lagzgabrielmuller-dot/planta-secadora-guano/informe/figuras/P10_C_crespo.jpg

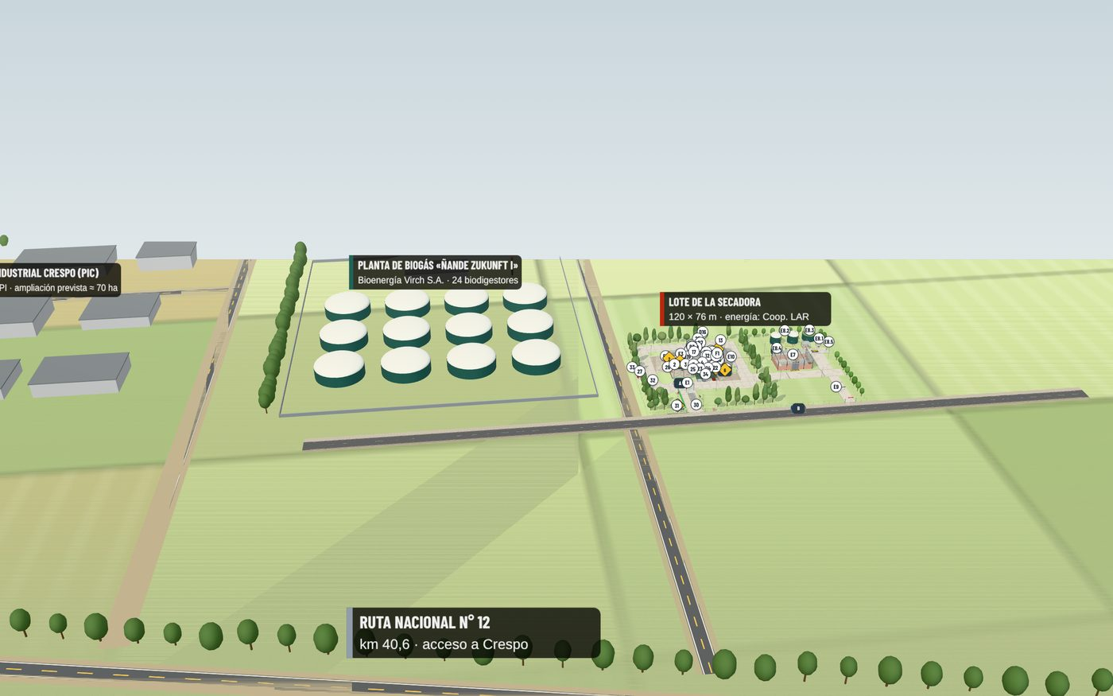
informe/figuras/P10_C_crespo.jpg
