lagzgabrielmuller-dot/planta-secadora-guano/informe/figuras/montaje_paso_09.jpg

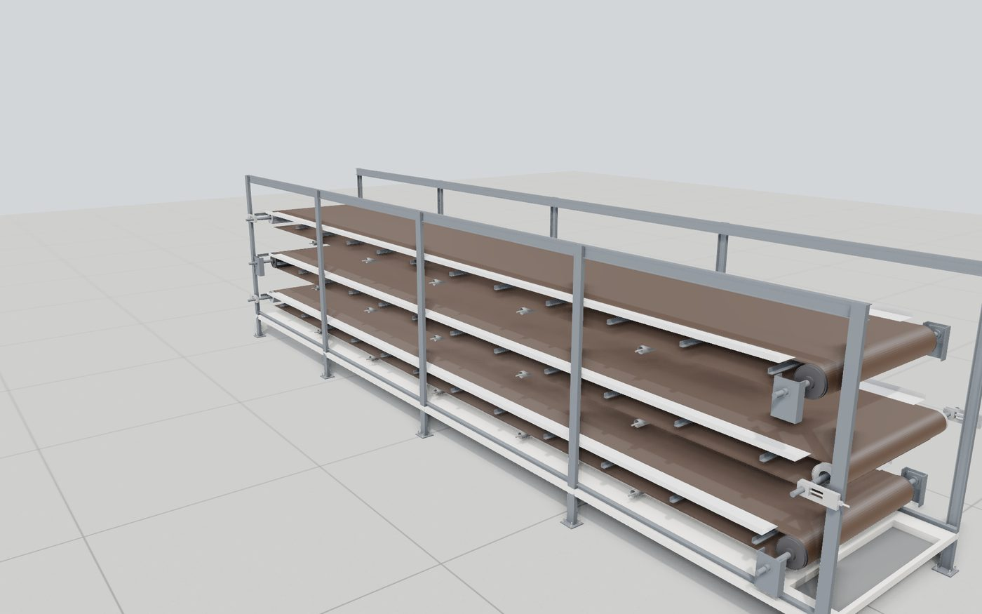
informe/figuras/montaje_paso_09.jpg
