lagzgabrielmuller-dot/planta-secadora-guano/fuente/video/README.md

# Video de presentación de la secadora de guano

Video de 3:51 sincronizado con la música: vuelo sobre el mapa satelital desde Paraná hasta el lote en Crespo,
la planta que se arma sola (piso, estructura, el secador que se arma en el aire y baja a su lugar, equipos,
paredes, techo, ampliaciones y vehículos), despiece del secador SC-4, recorrido del proceso en 8 pasos,
seguridad, ampliación del Sector Este, cifras de ingeniería, atardecer, noche y créditos.

Todo se genera con estos programas; la escena es una página three.js que se dibuja cuadro por cuadro en
Chrome sin ventana (el tiempo no corre solo: cada cuadro llama a `window.__cuadro(t)`).

## Pasos (desde `revD_final/fuente/`)

```
# 1. Datos (una vez; se guardan en video/datos/, que no se sube al repositorio)
node capturar_geometria.js ../visor.html video/_tmp/geo.json      # piezas del visor con sus colores
python video/preparar_planta.py video/_tmp/geo.json               # -> datos/planta.bin, planta_col.bin, planta.json
python video/mapa.py                                              # imágenes satelitales en 5 niveles + OpenStreetMap
python video/ritmo.py video/_musica.mp3                           # pulsos y compases -> datos/ritmo.json
node video/trafico.js                                             # recorridos de camiones y pala del visor -> datos/trafico.json

# 2. Escena
node video/escena/build.mjs                                       # -> video/escena.html (copia también el GLB del secador)
node video/muestras.js /tmp/muestras 30 60 100 150                # capturas sueltas para revisar encuadres

# 3. Cuadros y video
node video/capturar.js ../video/_cuadros/previa 0 "" 10 960 540 82        # vista previa (≈ 20 min)
python video/montar.py ../video/_cuadros/previa 10 ../video/previa.mp4 --crf 26
# final 1080p60: dos procesos intercalados (cuadros k, k+4, k+8...), primero los pares y después los impares
node video/capturar.js ../video/_cuadros/final 0 "" 60 1920 1080 92 4 & node video/capturar.js ../video/_cuadros/final 0.033 "" 60 1920 1080 92 4
node video/capturar.js ../video/_cuadros/final 0.016 "" 60 1920 1080 92 4 & node video/capturar.js ../video/_cuadros/final 0.0499 "" 60 1920 1080 92 4
# GitHub acepta archivos de hasta 100 MB: 1080p60 a 3000 kbit/s en dos pasadas (≈ 93 MB)
python video/montar.py ../video/_cuadros/final 60 ../video/Secadora_guano_presentacion_1080p60.mp4 --kbps 3000 --pasadas 2
python video/montar.py ../video/_cuadros/final 60 ../video/Secadora_guano_presentacion_720p.mp4 --cada 2 --ancho 1280 --kbps 1600
# versión liviana para la portada (archivos de hasta 15 MB)
python video/montar.py ../video/_cuadros/final 60 ../video/Secadora_guano_presentacion_web.mp4 --cada 2 --ancho 960 --kbps 380 --pasadas 2 --sin-audio
# las versiones del repositorio público van con --sin-audio: la música no es libre de derechos
```

`capturar.js` numera los cuadros por su tiempo y saltea los que ya existen: se puede cortar y retomar, o
correr varias tandas en paralelo con distintos tramos (`desde` y `hasta` en segundos) o intercaladas con `cada_n`.
Sin placa de video (SwiftShader, 4 núcleos) el 1080p60 lleva unas 5 a 6 horas: la parte del mapa sale a ≈ 0,5 s por
cuadro y la planta a ≈ 2,5 s. `montar.py --cada 2` arma una versión a 30 fps con los mismos cuadros.

**Con la placa de video de la PC** (RTX): `set VIDEO_GPU=1` antes de `node capturar.js` usa ANGLE con Direct3D
en lugar de SwiftShader (dibujo por procesador) y el render final baja de horas a minutos.

## Rehacer solo algunos tramos (corrección de un texto)

Si cambia un texto del guion (por ejemplo, los créditos o una cifra), no hace falta volver a dibujar los 13.880
cuadros. Se toma el video original de máxima calidad y se extraen sus cuadros (`ffmpeg -i alta.mp4 -q:v 2
f_%06d.jpg`). Después se dibujan de nuevo solo los cuadros de los tramos cambiados, con `capturar.js <carpeta>
<desde> <hasta> 60 1920 1080 92`, usando el mismo visor, el mismo GLB del secador, el mismo mapa y el mismo ritmo que
el original. Cada tramo tiene que cubrir todo el intervalo `[t0, t1]` del texto en `guion.js`: `ventana()` hace el
fundido de salida antes de `t1`, así que el texto se ve hasta `t1` (los créditos van de `B(76)` a `B(80, 2)`, cuadros
12.586 a 13.328; el cuadro `n` es el instante `n/60` y se guarda como `f_{n+1}.jpg`). Por último se reemplazan esos
cuadros y se monta con `montar.py`. Antes de reemplazar, conviene comparar
un cuadro nuevo con el original en el mismo instante: el 11/11/2026 dieron 36,8 dB de PSNR, que es solo la diferencia
de compresión. Así se corrigieron, el 11/11/2026, el apellido Hofstetter en los créditos, la masa del secador
(9.538 kg), la potencia instalada (117,0 kW) y la nave (33 × 18 m).

## Archivos

| Archivo | Qué hace |
|---|---|
| `escena/motor.js` | Renderizador, cielo y luces (día, atardecer, noche), mapa en niveles, planta por bloques, secador detallado, carteles con línea guía (sin superponerse), trazos del mapa, cámara por claves |
| `escena/guion.js` | El guion: tiempos por compás `B(n, pulso)`, cámara, armado de la obra, armado y despiece del secador, vehículos, textos y cifras |
| `trafico.js` | Graba del visor los recorridos de los camiones y la pala (posición y giro cada 0,1 s): el video los reproduce tal cual, así el camión entra de culata por el portón P1 y la pala va de la pila a la tolva sin atravesar equipos |
| `escena/plantilla.html` | Capa de textos (títulos, placas, carteles, cifras, créditos) en 1920 × 1080 |
| `mapa.py` | Teselas de Esri World Imagery y datos de OpenStreetMap (RN 12, Parque Industrial, calles) |
| `preparar_planta.py` | Divide la planta en bloques por pieza y color (y la nave en piso, estructura, paredes y techo) |
| `ritmo.py` | Pulsos (87,4 por minuto), compases y energía por compás de la música |

## Datos y cuidados

- **Ubicación del lote: orientativa** (plano 14): campo al Noreste de la RN 12, frente al Parque Industrial,
  junto a la continuación de la calle Democracia. La planta de biogás vecina está proyectada y su lugar no está
  definido. El video lo aclara en pantalla.
- Distancias calculadas desde el centro del lote: 204 m a la RN 12, 2,6 km al centro de Crespo y 36,6 km en línea
  recta a Paraná.
- Cifras en pantalla tomadas de los cálculos (`calculos/resultados.json`) y del portal: 8 t/día al 72 % → 2,6 t/día
  al 15 %, generador de 880 kW (314 kg/h de cáscara), potencia instalada 66,9 + 50,1 kW, eje motriz n = 1,59,
  40 anclajes M16. No se muestran datos pendientes de confirmar (inversión, potencia a contratar).
- Créditos de imágenes en pantalla: Esri, Maxar, Earthstar Geographics y colaboradores de OpenStreetMap.
- **Música:** «Addiction» (LONOWN y Asenssia, versión slowed), la eligió el grupo. No es libre de derechos: sirve
  para proyectarlo en la escuela; si se sube a YouTube u otra red puede quedar silenciado o reclamado. No se guarda
  en el repositorio.
