lagzgabrielmuller-dot/planta-secadora-guano/docs/ARQUITECTURA.md

# Arquitectura del proyecto

El repositorio no es una aplicación con servidor. Es una **entrega técnica generada por programas**: todo lo que se ve
(planos, informe, memoria, presupuesto, modelos 3D, visores, portada y video) sale de programas en `fuente/`. Los
datos se escriben **una sola vez**, en los cálculos.

## Flujo de datos

```mermaid
flowchart LR
    subgraph Calculos["fuente/calculos"]
        CM["calculos_memoria.py<br/>TG2, iluminación, ventilación,<br/>biogás, fuego"] --> RJ[("resultados.json")]
        FA["fatiga.py<br/>Shigley-Budynas"] --> RJ
        PR["presupuesto.py"] --> PJ[("presupuesto.json")]
        RJ --> PR
    end
    subgraph Modelo["fuente/secadora"]
        MS["modelo_secador.py<br/>CadQuery"] --> GLB[("STEP · GLB · piezas.json")]
    end
    GLB --> FA
    SIM["simulacion_termica/<br/>modelo físico del secado"] -. "Rev. F: punto de trabajo,<br/>capacidad, cáscara" .-> CM
    SIM -.-> PR
    RJ --> PL["planos/P01…P24.py"] --> PLA[("DXF · PDF · PNG")]
    GLB --> SC["planos_sc.py"] --> SCA[("SC-01…SC-06")]
    RJ --> MEM["memoria_docx.py"] --> MEMA[("Memoria .docx/.pdf")]
    RJ --> INF["informe_final.py<br/>+ texto_revC.md"] --> INFA[("Informe y manual<br/>.docx/.pdf")]
    PJ --> INF
    GLB --> VS["secadora/visor"] --> VSA[("Visor_Secador_SC4.html")]
    BV["visor/build_visor.py<br/>base_revC.html + revD_modulo.js"] --> VP[("visor.html")]
    RJ --> POR["portal/portada.py"] --> IDX[("index.html")]
    PJ --> POR
    GLB --> POR
```

## Componentes

| Componente | Tecnología | Entrada | Salida |
|---|---|---|---|
| Cálculos | Python, solo la biblioteca estándar | constantes con su fuente, dentro del código | `resultados.json`, `presupuesto.json`, planilla Excel (openpyxl) |
| Láminas P01-P24 | ezdxf → DXF; render a PDF A3 y PNG con PyMuPDF | `resultados.json`, `datos/layout_planta.json` | `planos/dxf`, `planos/pdf`, `planos/*.png` |
| Secador SC-4 | CadQuery (OpenCASCADE, sólidos exactos) | medidas como parámetros con nombre | STEP, GLB, `piezas.json` (68 piezas con masa y despiece) |
| Láminas SC-01 a SC-06 | ezdxf, con proyecciones con líneas ocultas (OCP) | modelo CadQuery | DXF, PDF, PNG |
| Informe, memoria y manual | python-docx; el PDF se imprime con Chrome desde un HTML equivalente | `texto_revC.md` y los JSON | `.docx` y `.pdf` |
| Visor de la planta | three.js r163 compilado (Rev. C) + módulo `revD_modulo.js` inyectado | geometría paramétrica | `visor.html`, un solo archivo que anda sin internet |
| Visor del secador | three.js r170 (ESM) empaquetado con esbuild | GLB y `pasos_montaje.json` | `secadora/Visor_Secador_SC4.html` |
| Estudio térmico | Python + numba (núcleo compilado), matplotlib; simulador en JavaScript | datos del informe y ensayos publicados | `resultados/*.json`, `figuras/*.png`, `simulador.html` |
| Portada | Python, plantilla HTML con claves `{{…}}` | los JSON, los tamaños de los archivos, los PNG de las láminas | `index.html`, `entrega.html` (redirección), miniaturas y ZIP de los DXF |
| Video | three.js cuadro por cuadro con Chrome sin ventana, ffmpeg | geometría del visor, mapa satelital, guion | MP4 (la versión pública va sin música) |

## Decisiones de diseño

- **Una sola fuente de verdad por dato.** Un número se cambia en el programa de cálculo y se regenera
  (`fuente/regenerar.py`). Las pruebas (`tests/`) fallan si algún documento quedó con un valor viejo.
- **Archivos autónomos.** Los visores y el simulador son un solo HTML que anda sin internet: es una entrega escolar
  que se tiene que poder abrir con doble clic en la compu de la escuela.
- **Sitio estático.** La publicación no necesita servidor ni base de datos ni variables de entorno: GitHub Pages
  sirve los mismos archivos del repositorio por HTTPS.
- **Rev. C intacta dentro del visor.** `base_revC.html` es el visor entregado en la Rev. C (código compilado). Los
  cambios posteriores se inyectan con `build_visor.py`, por reemplazos que fallan si el original cambia.

## Límites conocidos

- `base_revC.html` está compilado (minificado) y no hay fuente legible. Para cambiarlo se agregan reemplazos
  controlados en `build_visor.py`, o geometría nueva en `revD_modulo.js`.
- Los PDF de las láminas no tienen capa de texto: ezdxf dibuja el texto como trazos. El texto buscable está en los DXF.
- El render del video necesita datos que no se guardan en el repositorio: el mapa satelital (unos 100 MB de
  teselas) y la música, que no es libre de derechos. Los rehacen `fuente/video/mapa.py` y `ritmo.py`.
