lagzgabrielmuller-dot/planta-secadora-guano/fuente/informe/img_revC/revC_01.png

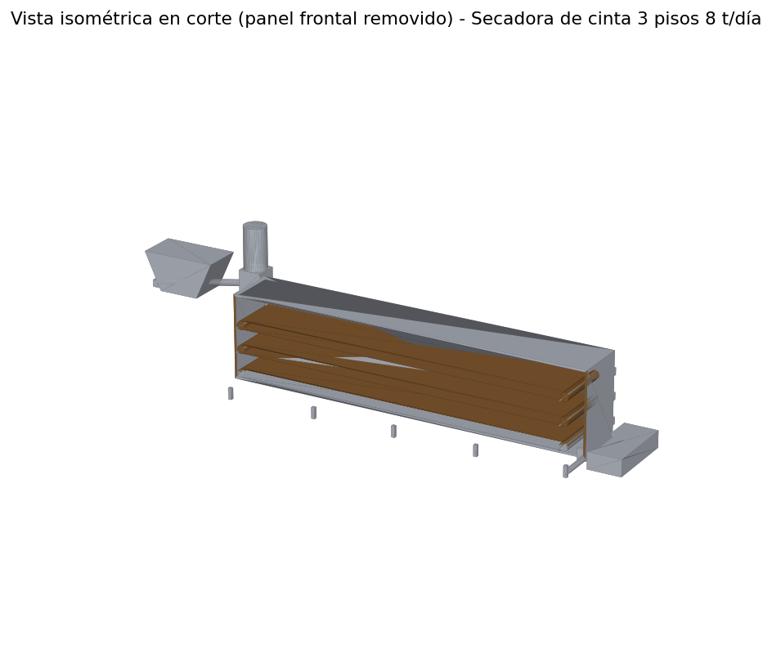
fuente/informe/img_revC/revC_01.png
