lagzgabrielmuller-dot/planta-secadora-guano/fuente/informe/img_revC/revC_05.png

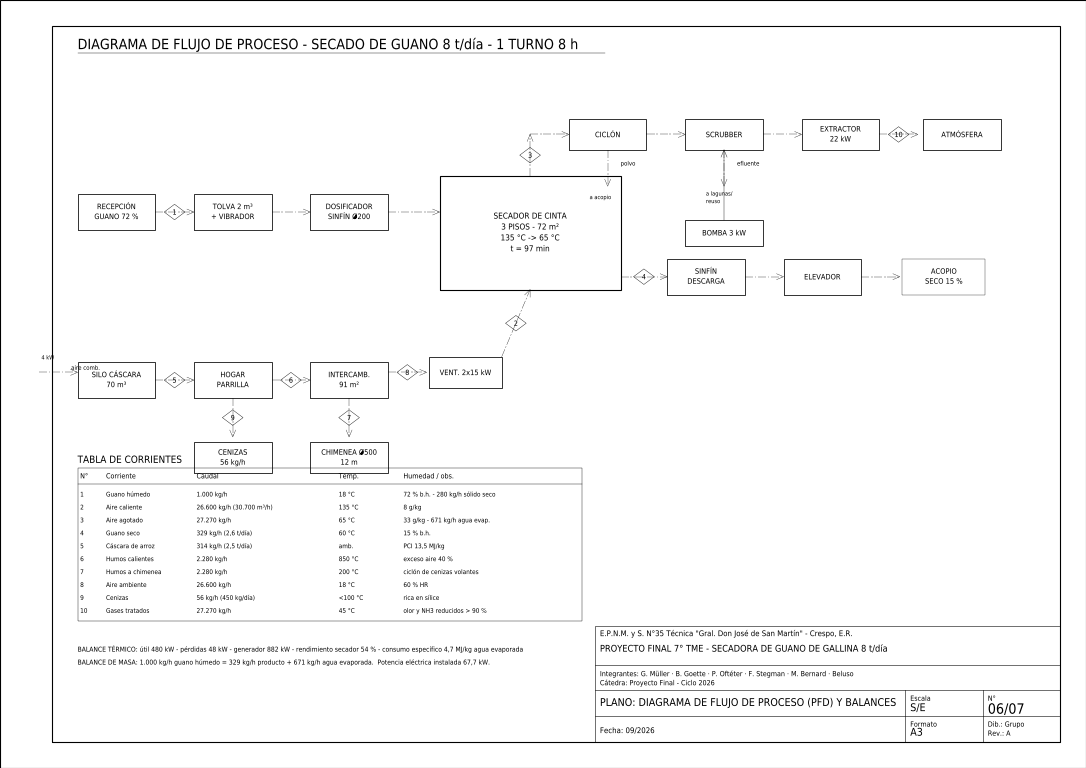
fuente/informe/img_revC/revC_05.png
