lagzgabrielmuller-dot/planta-secadora-guano/fuente/informe/img_revC/revC_06.png

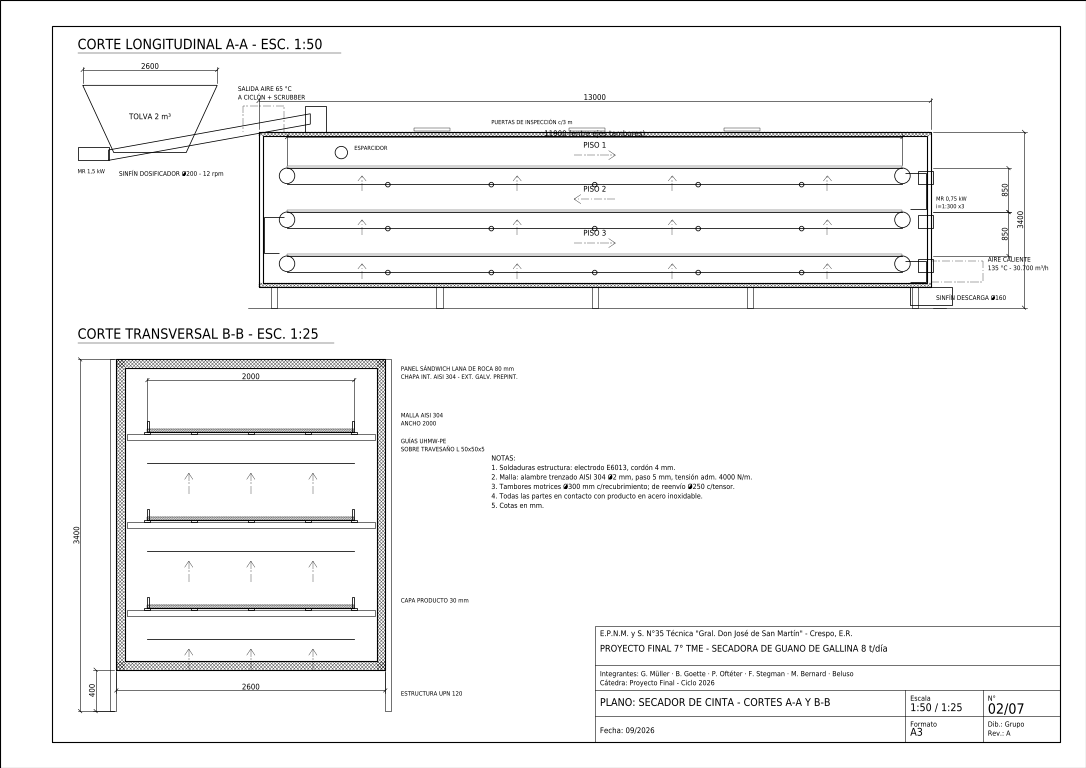
fuente/informe/img_revC/revC_06.png
