lagzgabrielmuller-dot/planta-secadora-guano/fuente/informe/img_revC/revC_08.png

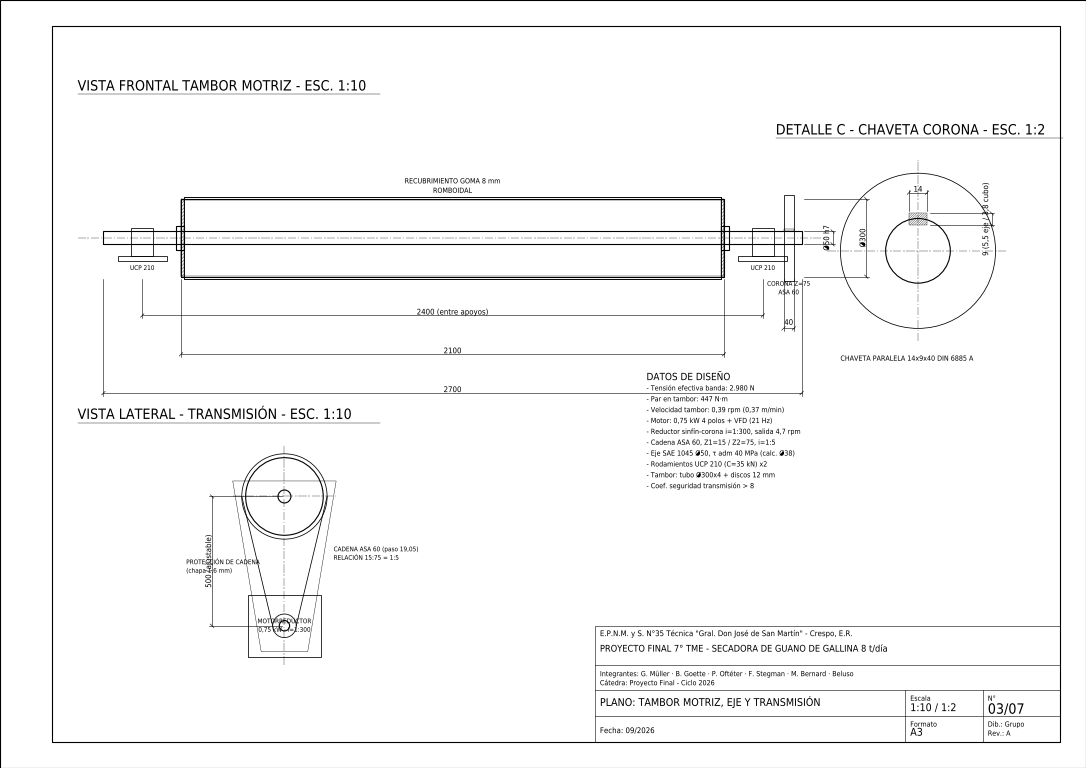
fuente/informe/img_revC/revC_08.png
