lagzgabrielmuller-dot/planta-secadora-guano/fuente/informe/img_revC/revC_10.png

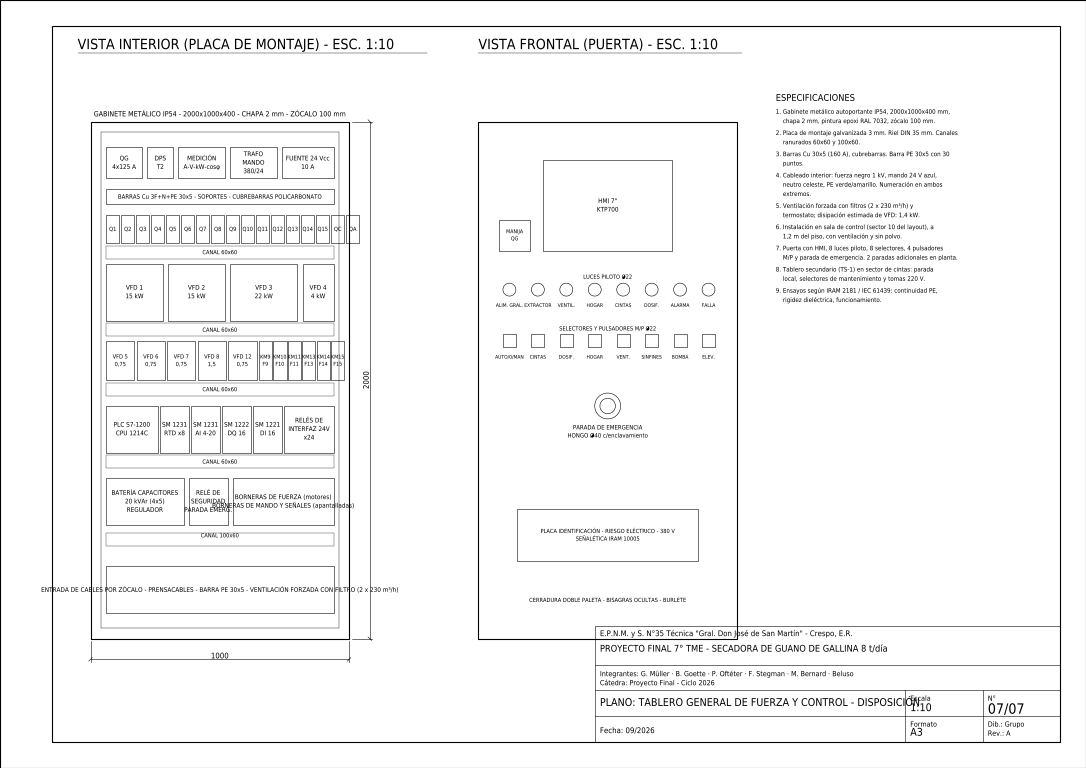
fuente/informe/img_revC/revC_10.png
