lagzgabrielmuller-dot/planta-secadora-guano/fuente/informe/img_revC/revC_11.png

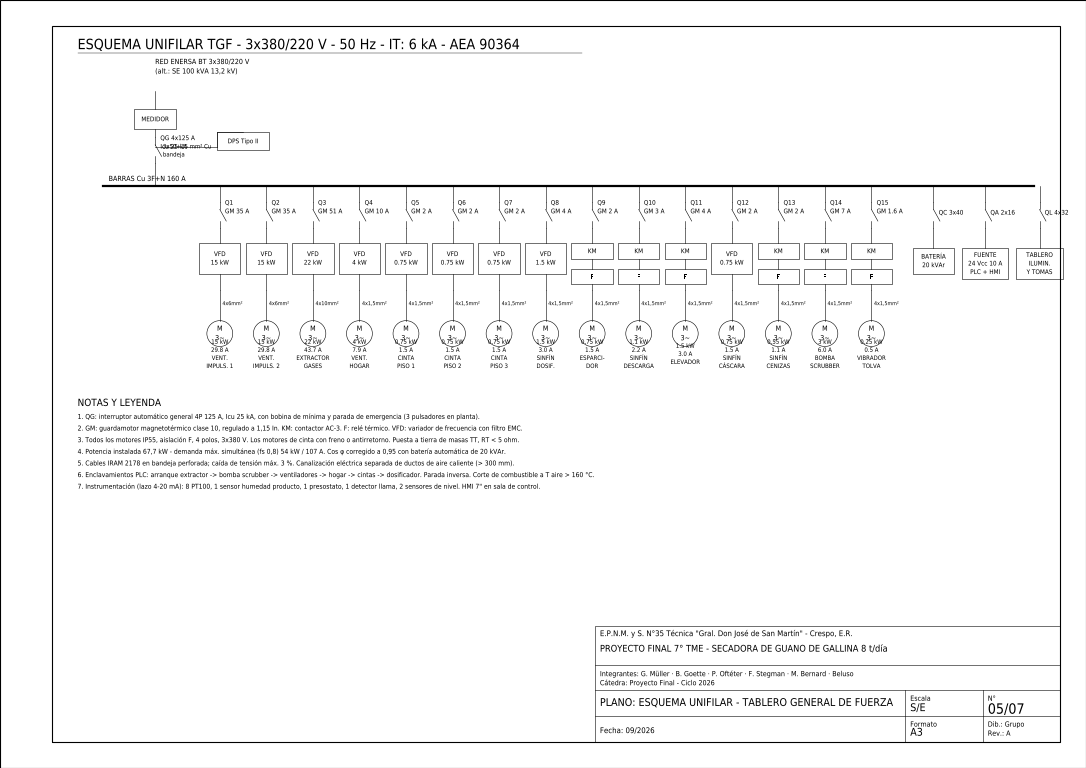
fuente/informe/img_revC/revC_11.png
