lagzgabrielmuller-dot/planta-secadora-guano/fuente/informe/img_revC/revC_12.png

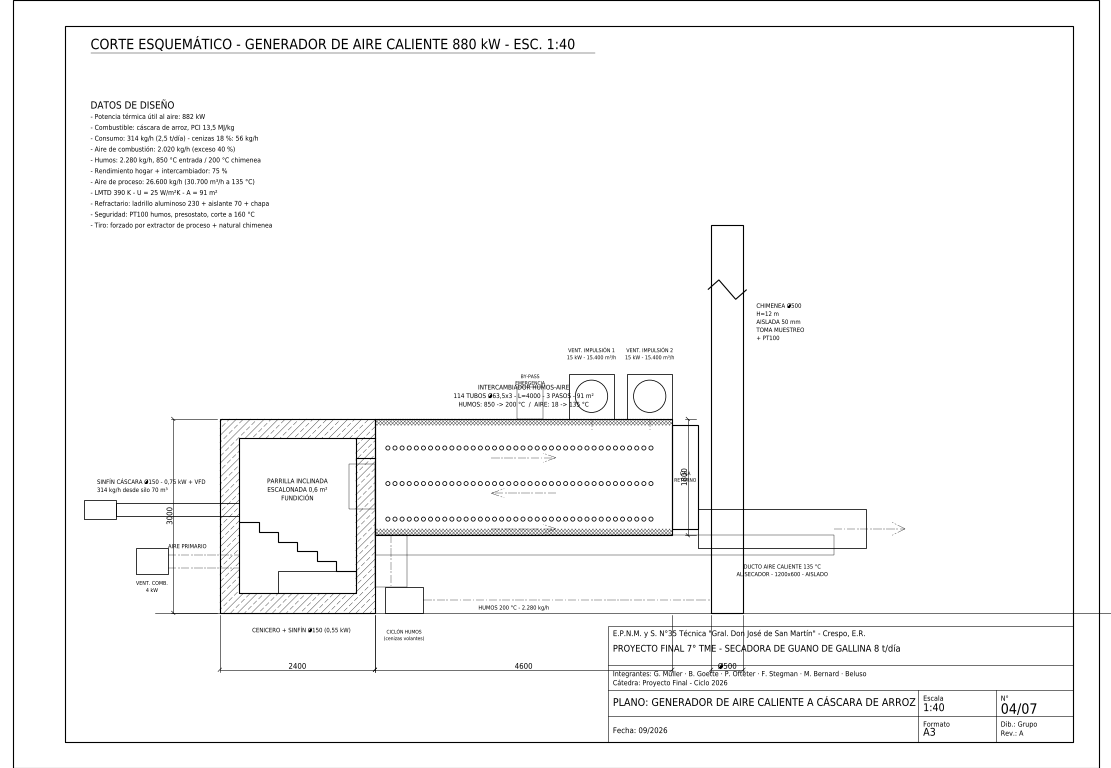
fuente/informe/img_revC/revC_12.png
