lagzgabrielmuller-dot/planta-secadora-guano/fuente/informe/img_revC/revC_13.png

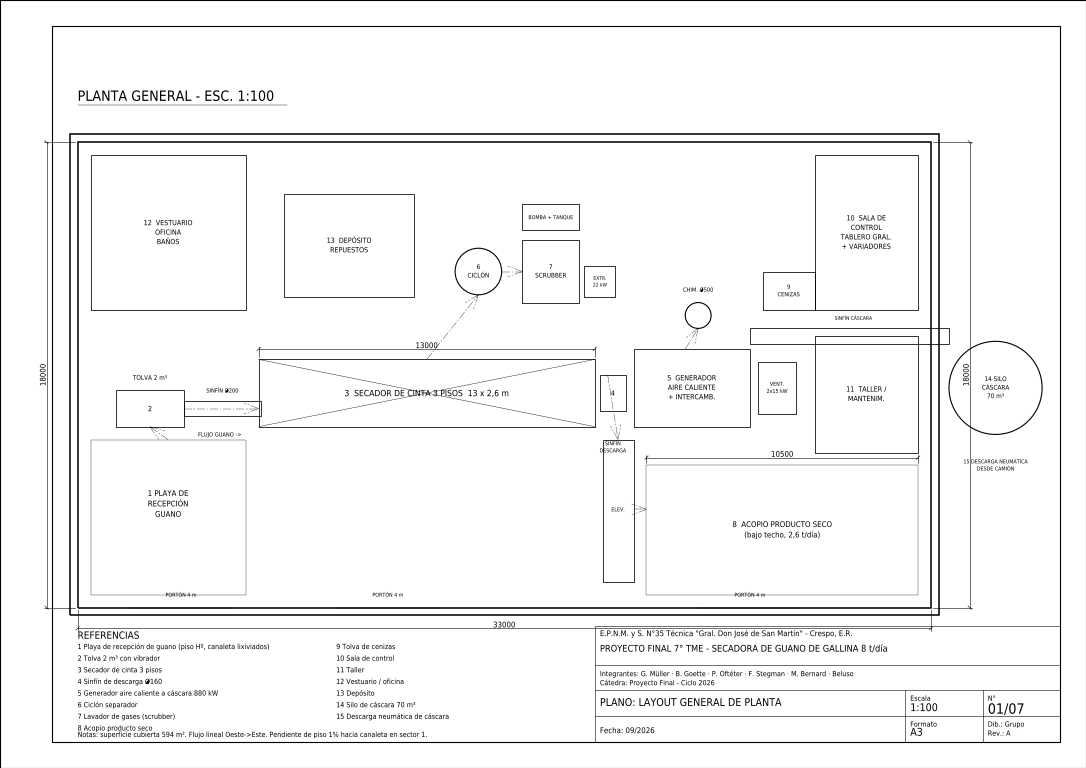
fuente/informe/img_revC/revC_13.png
