lagzgabrielmuller-dot/planta-secadora-guano/fuente/informe/img_revC/revC_14.png

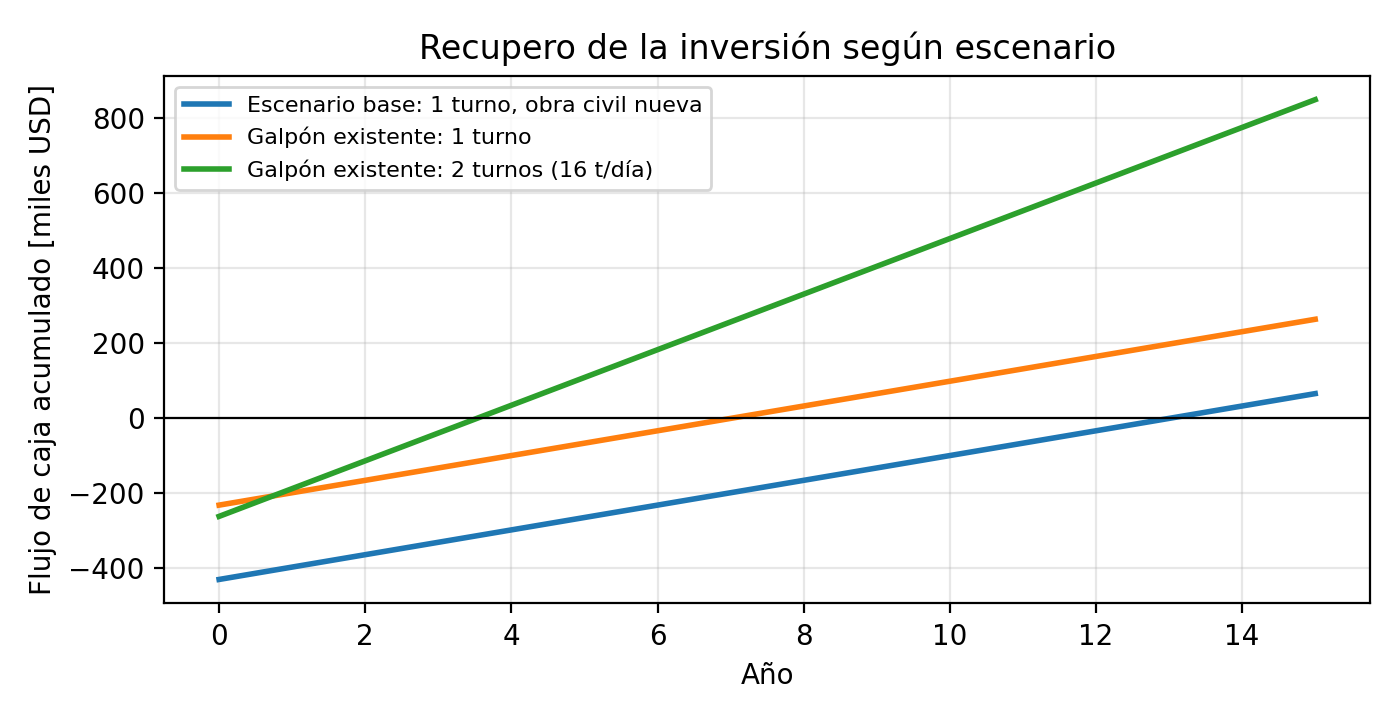
fuente/informe/img_revC/revC_14.png
