lagzgabrielmuller-dot/planta-secadora-guano/fuente/informe/img_revC/revC_15.png

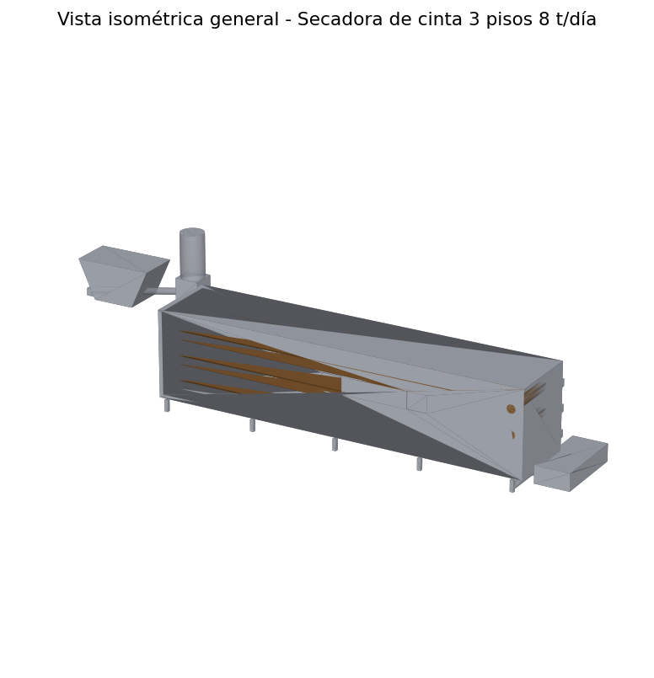
fuente/informe/img_revC/revC_15.png
