lagzgabrielmuller-dot/planta-secadora-guano/fuente/planos/img/P10_A_general_RevD.png

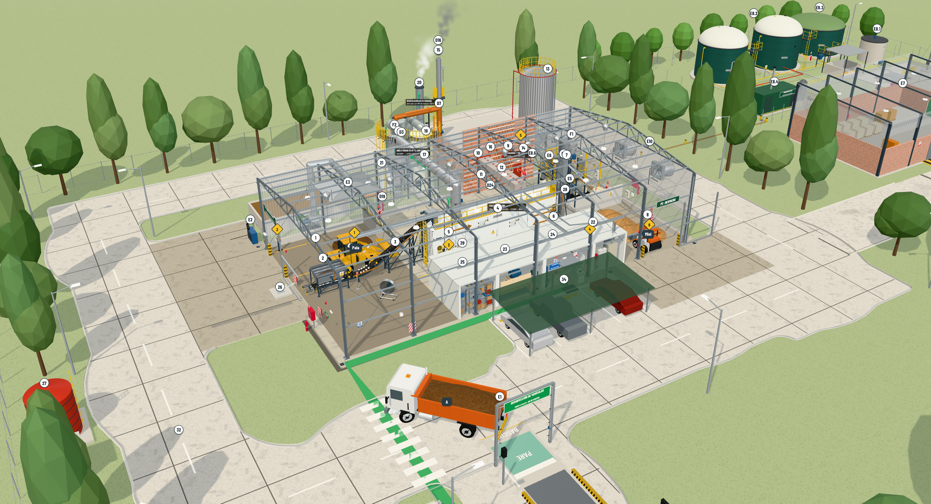
fuente/planos/img/P10_A_general_RevD.png
