lagzgabrielmuller-dot/planta-secadora-guano/fuente/planos/img/P10_B_despiece_RevD.png

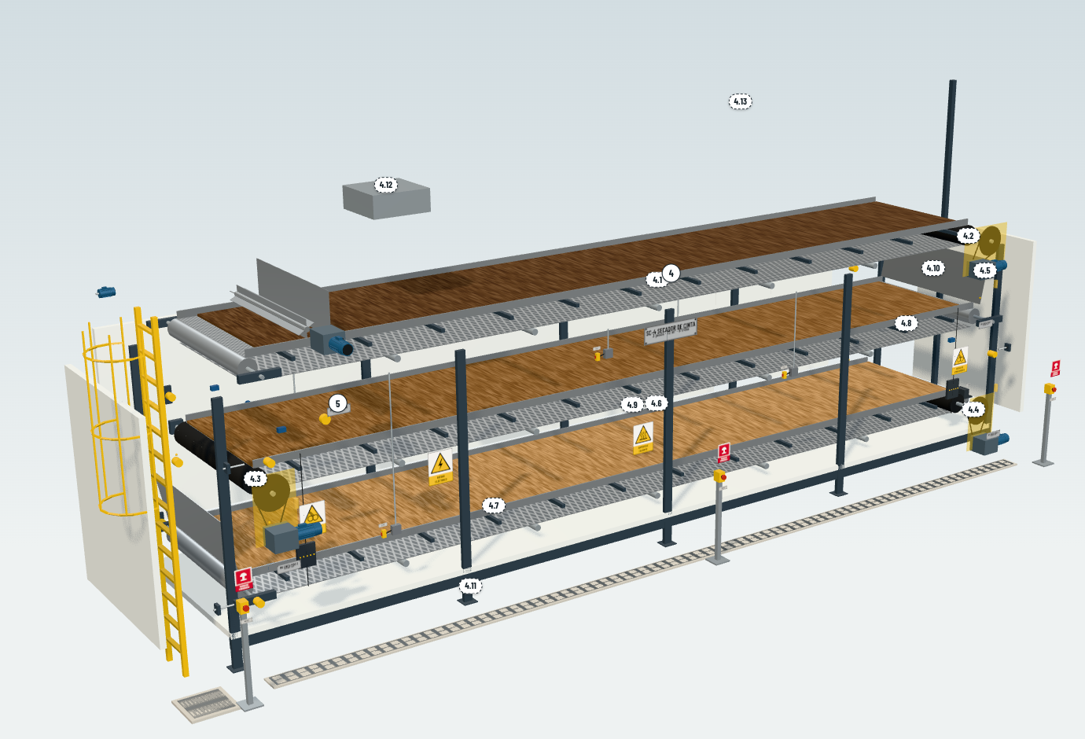
fuente/planos/img/P10_B_despiece_RevD.png
