lagzgabrielmuller-dot/planta-secadora-guano/modelo_3d/renders/P10_A_general.png

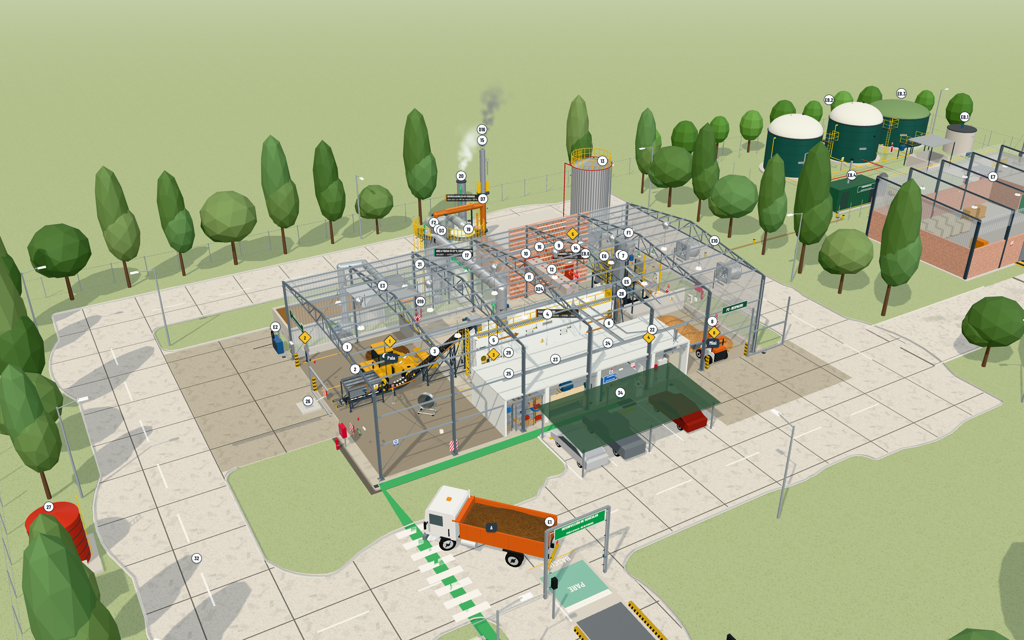
modelo_3d/renders/P10_A_general.png
