lagzgabrielmuller-dot/planta-secadora-guano/modelo_3d/renders/P10_B_despiece.png

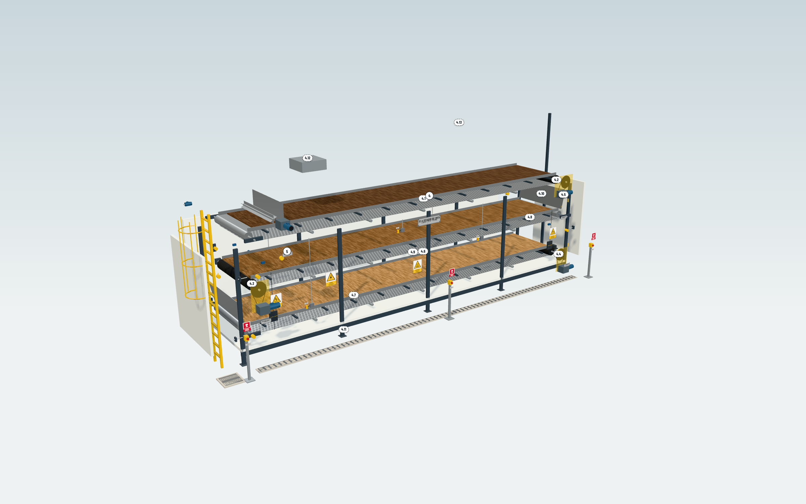
modelo_3d/renders/P10_B_despiece.png
