lagzgabrielmuller-dot/planta-secadora-guano/portal/img/planos/SC-05.jpg

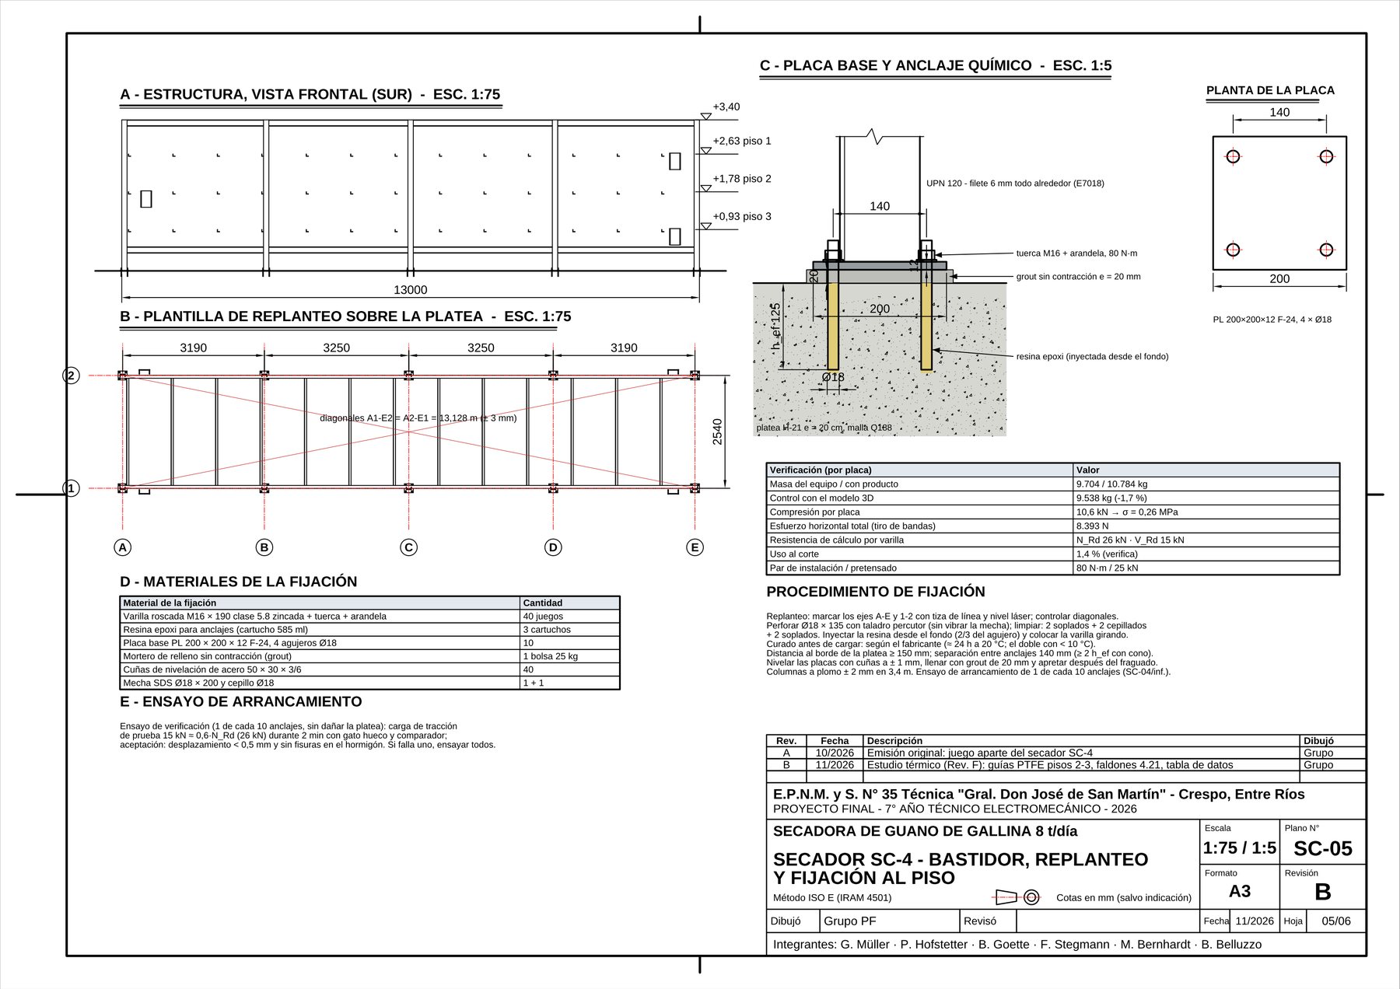
portal/img/planos/SC-05.jpg
