lagzgabrielmuller-dot/planta-secadora-guano/portal/img/planos/SC-06.jpg

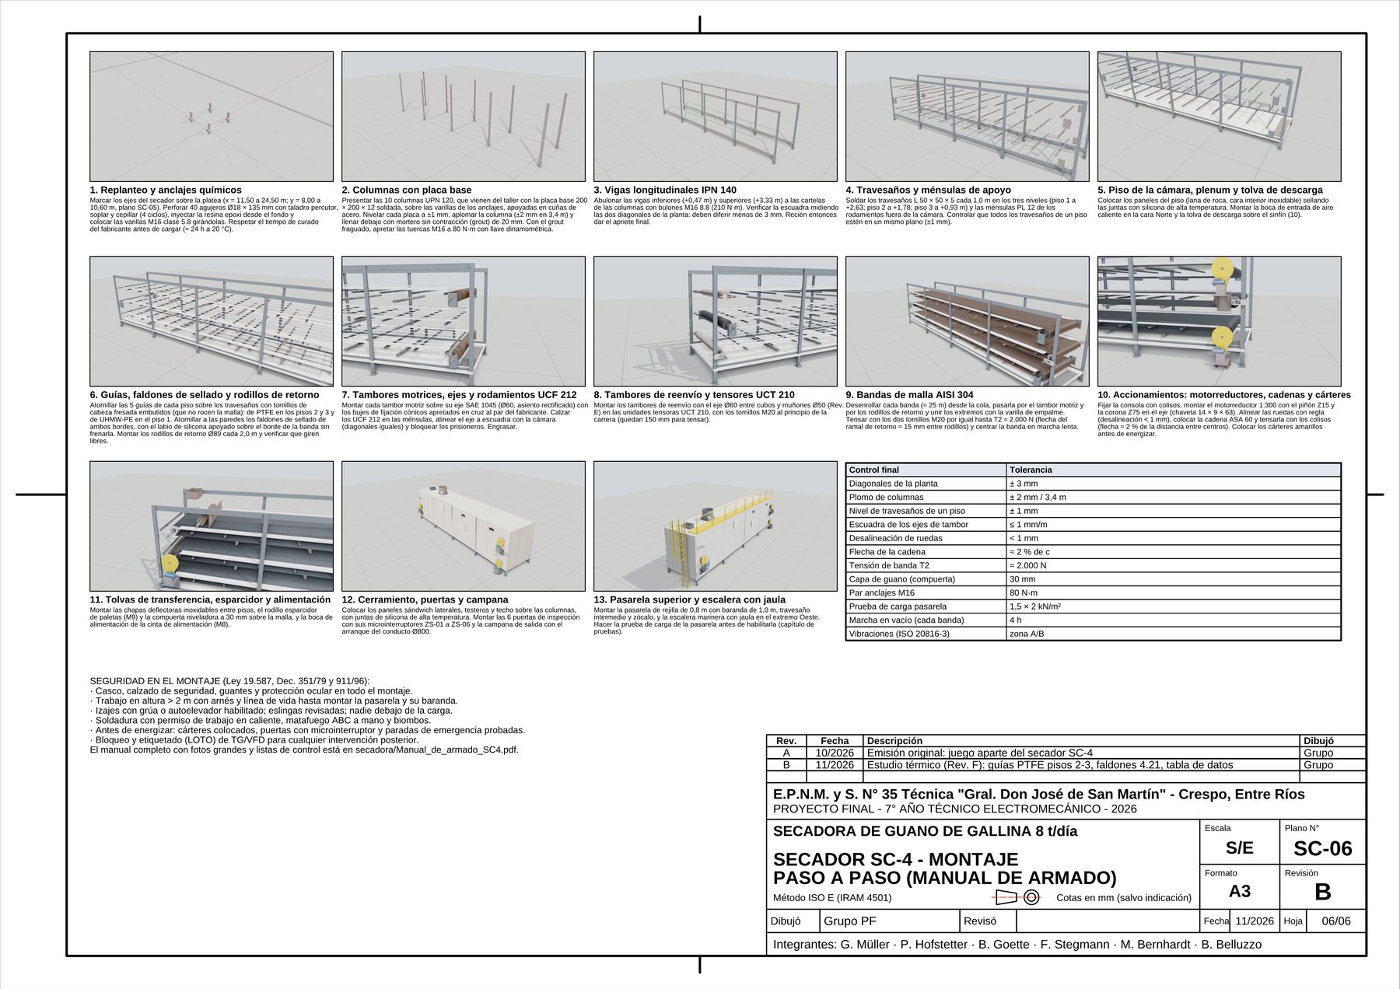
portal/img/planos/SC-06.jpg
