lagzgabrielmuller-dot/planta-secadora-guano/portal/img/portada_planta.jpg

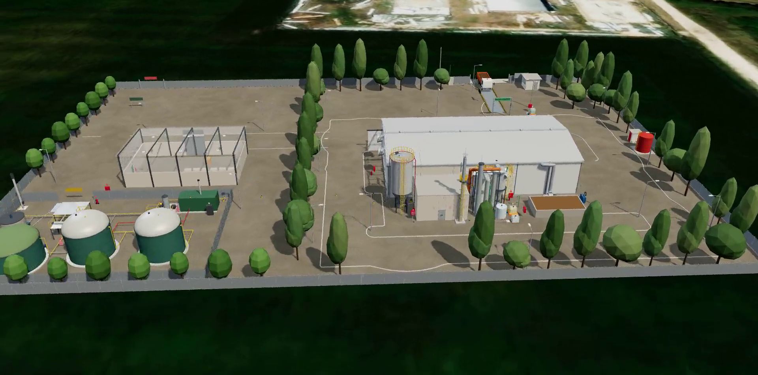
portal/img/portada_planta.jpg
