lagzgabrielmuller-dot/planta-secadora-guano/portal/img/portada_secador.jpg

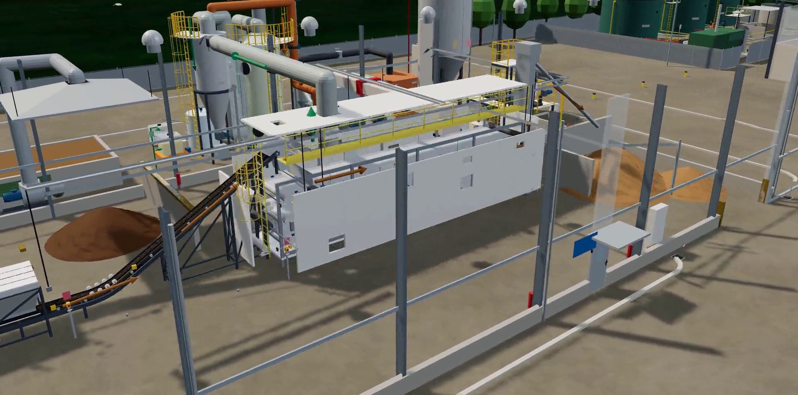
portal/img/portada_secador.jpg
