lagzgabrielmuller-dot/planta-secadora-guano/portal/img/video_aire.jpg

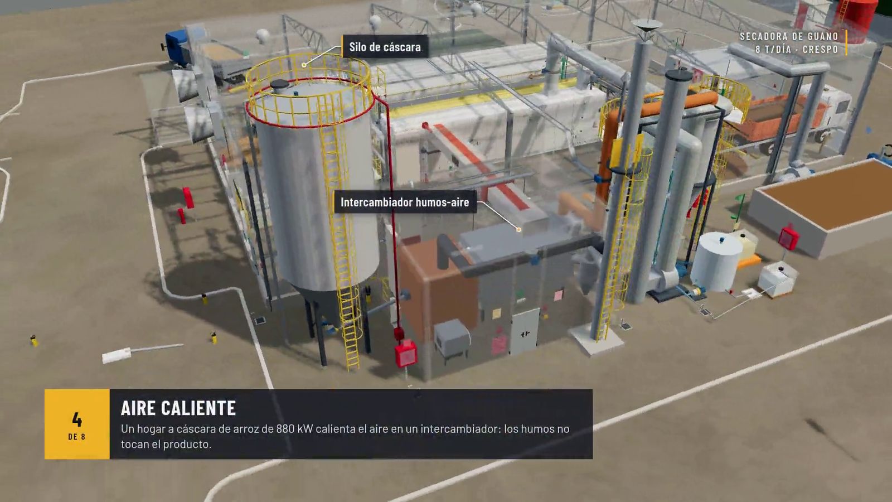
portal/img/video_aire.jpg
