lagzgabrielmuller-dot/planta-secadora-guano/portal/img/video_alimentacion.jpg

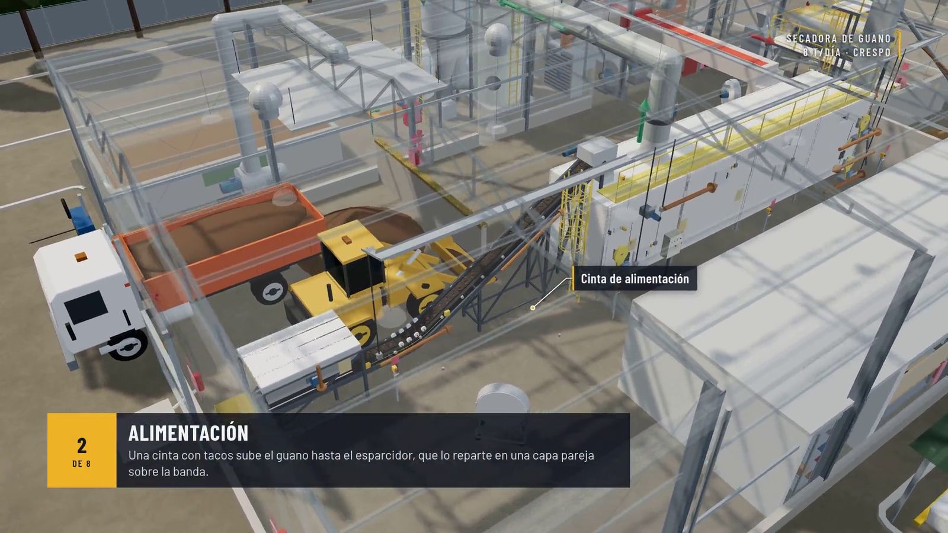
portal/img/video_alimentacion.jpg
