lagzgabrielmuller-dot/planta-secadora-guano/portal/img/video_control.jpg

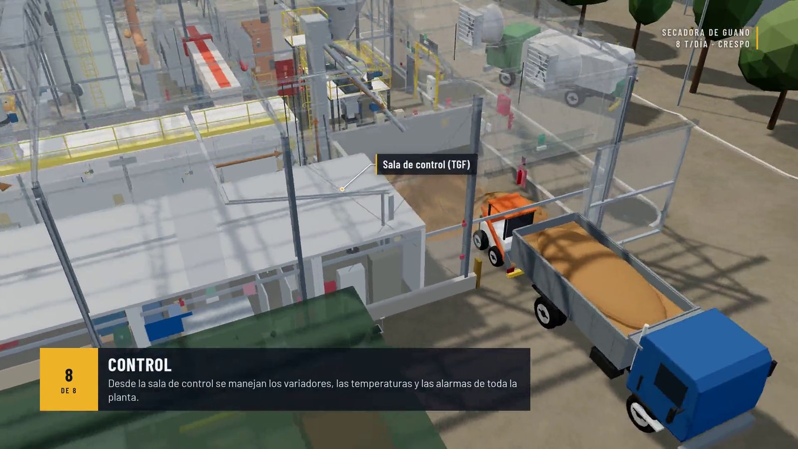
portal/img/video_control.jpg
