lagzgabrielmuller-dot/planta-secadora-guano/portal/img/video_descarga.jpg

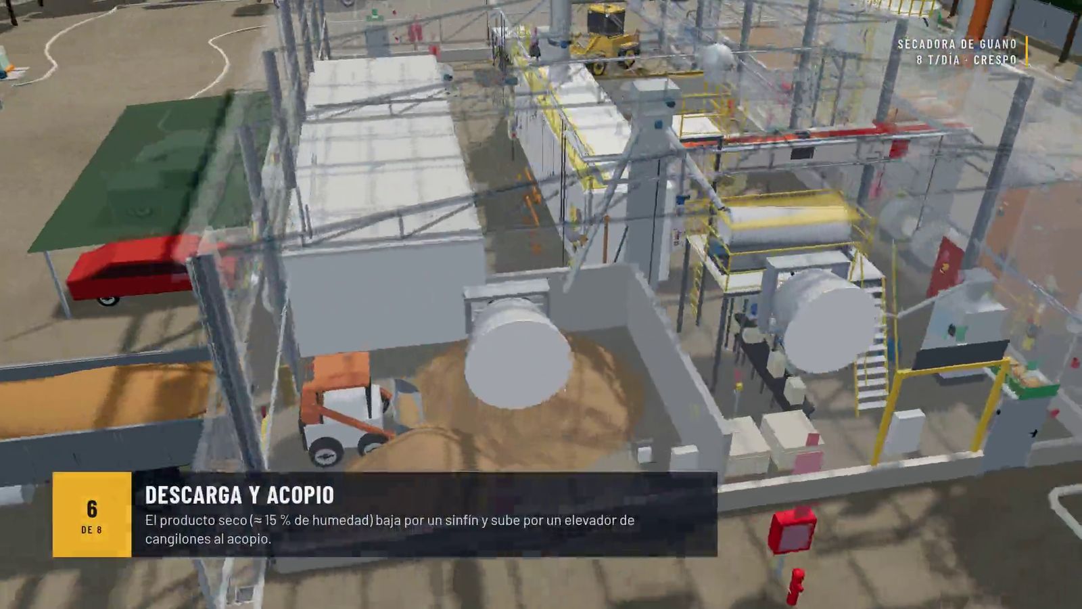
portal/img/video_descarga.jpg
