lagzgabrielmuller-dot/planta-secadora-guano/portal/img/video_embolsado.jpg

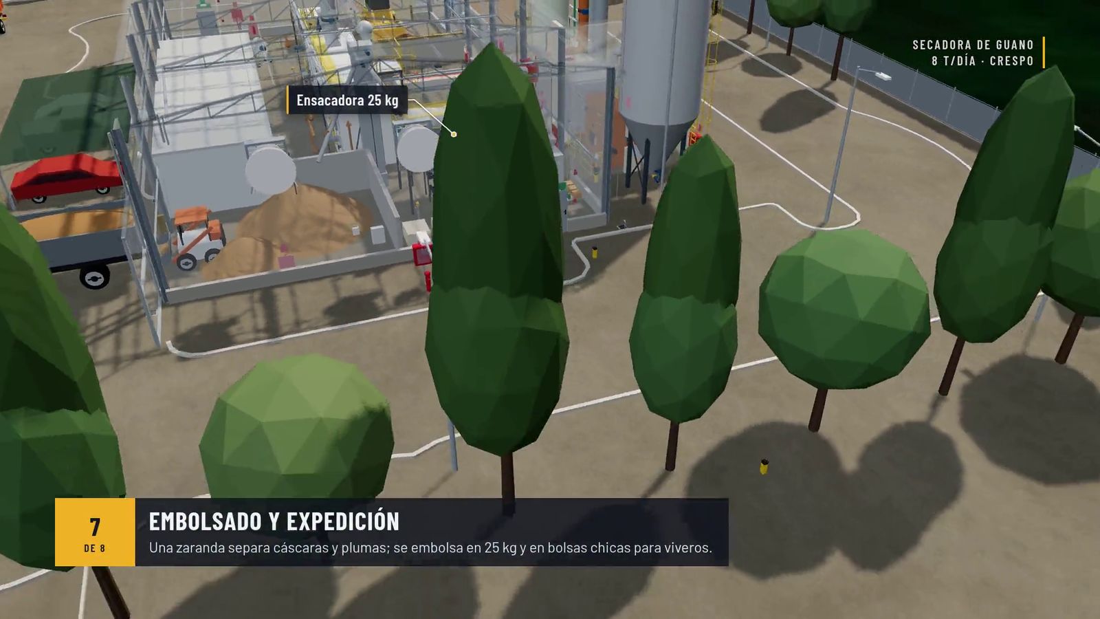
portal/img/video_embolsado.jpg
