lagzgabrielmuller-dot/planta-secadora-guano/portal/img/video_gases.jpg

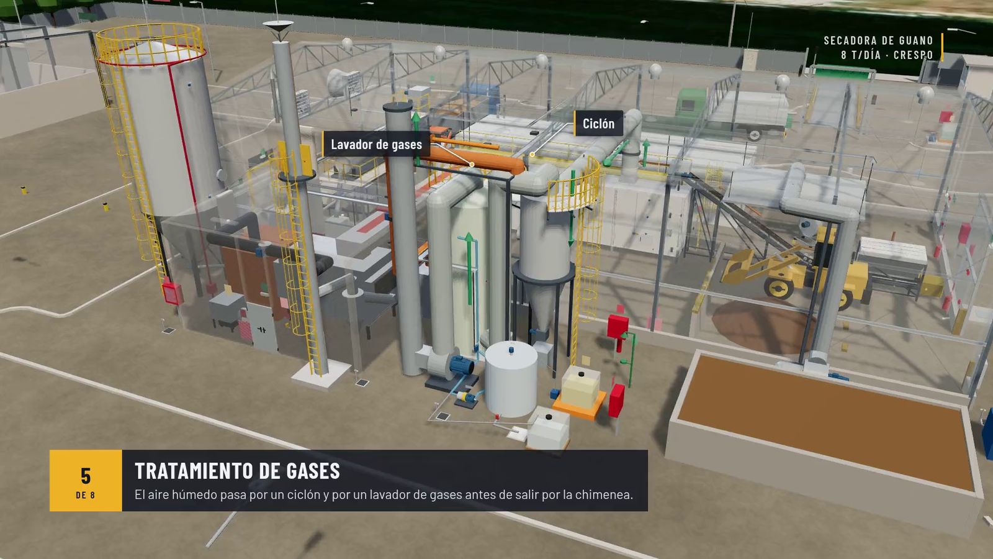
portal/img/video_gases.jpg
