lagzgabrielmuller-dot/planta-secadora-guano/portal/img/video_portada.jpg

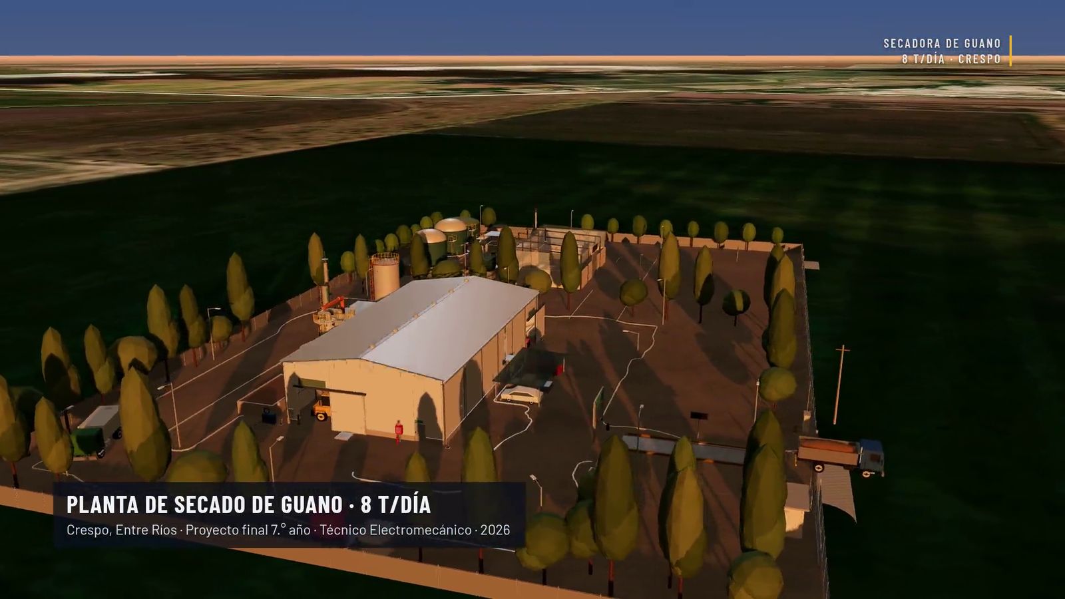
portal/img/video_portada.jpg
