lagzgabrielmuller-dot/planta-secadora-guano/portal/img/video_recepcion.jpg

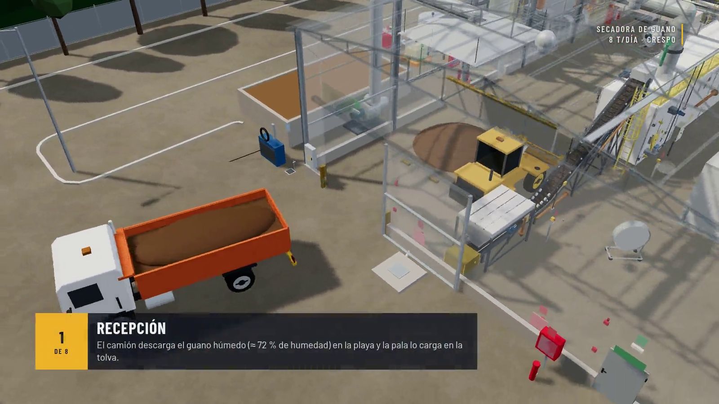
portal/img/video_recepcion.jpg
