lagzgabrielmuller-dot/planta-secadora-guano/portal/img/video_sector_este.jpg

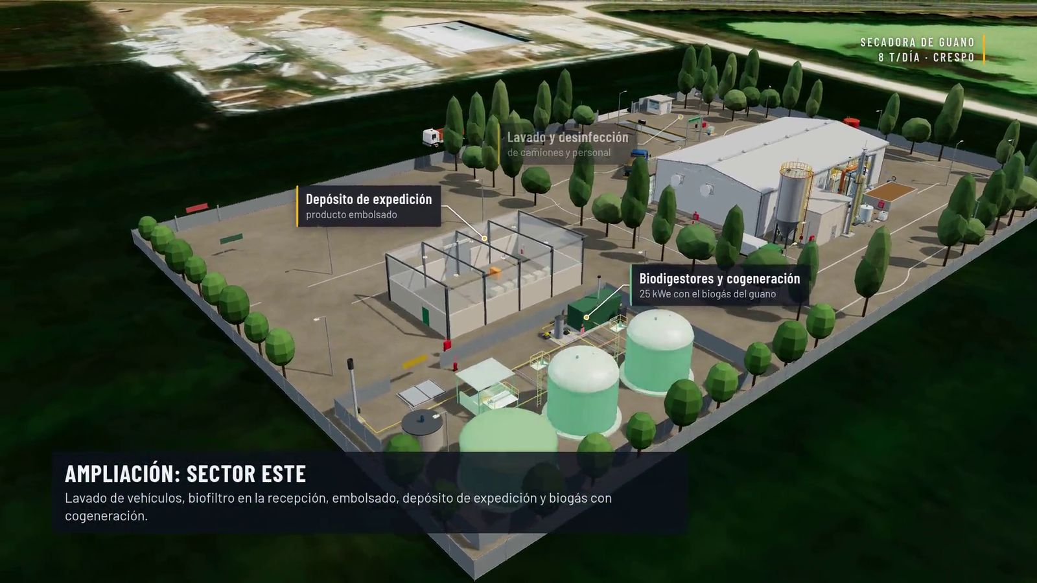
portal/img/video_sector_este.jpg
