lagzgabrielmuller-dot/planta-secadora-guano/portal/img/video_seguridad.jpg

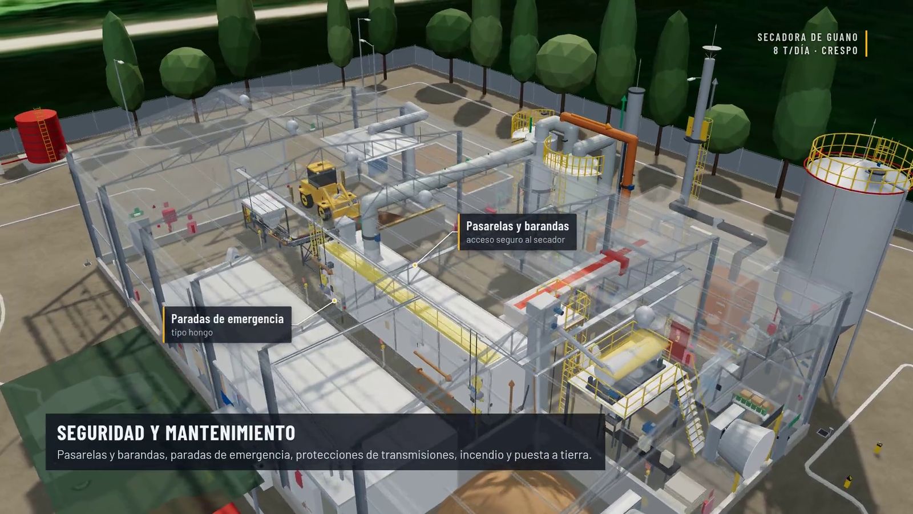
portal/img/video_seguridad.jpg
