lagzgabrielmuller-dot/planta-secadora-guano/portal/img/vista_aire.jpg

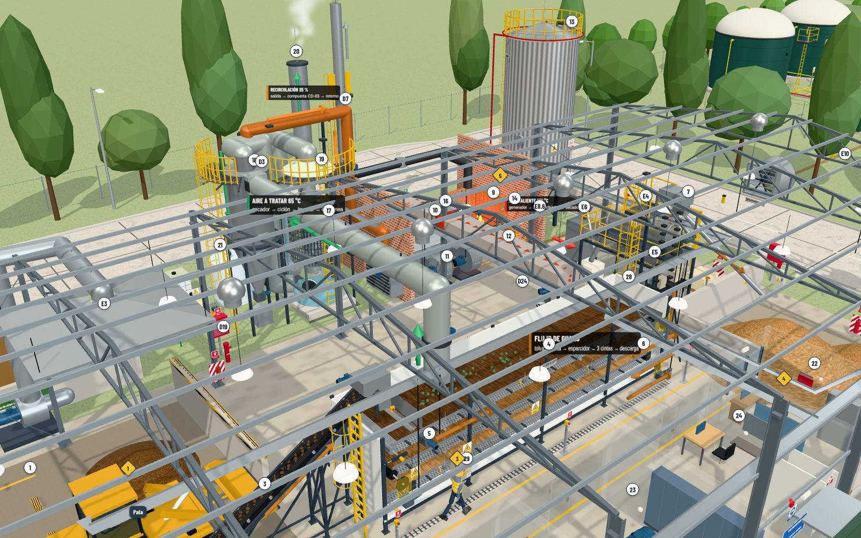
portal/img/vista_aire.jpg
