lagzgabrielmuller-dot/planta-secadora-guano/portal/img/vista_alimentacion.jpg

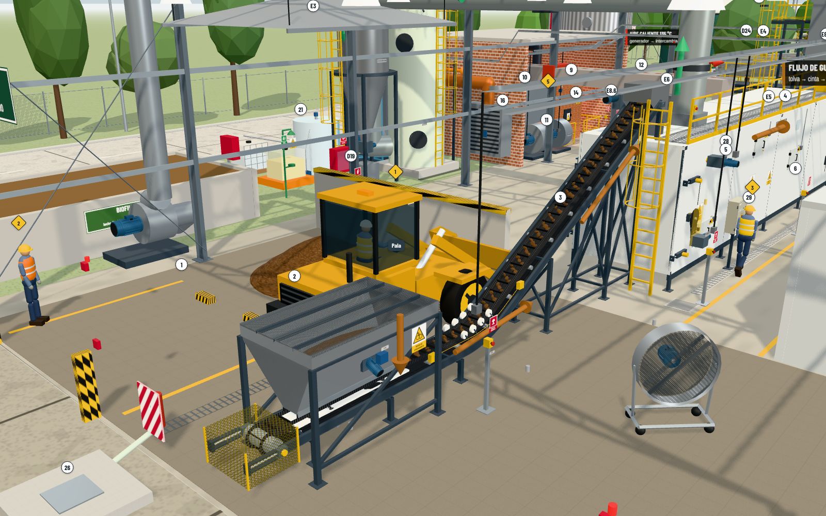
portal/img/vista_alimentacion.jpg
