lagzgabrielmuller-dot/planta-secadora-guano/portal/img/vista_biogas.jpg

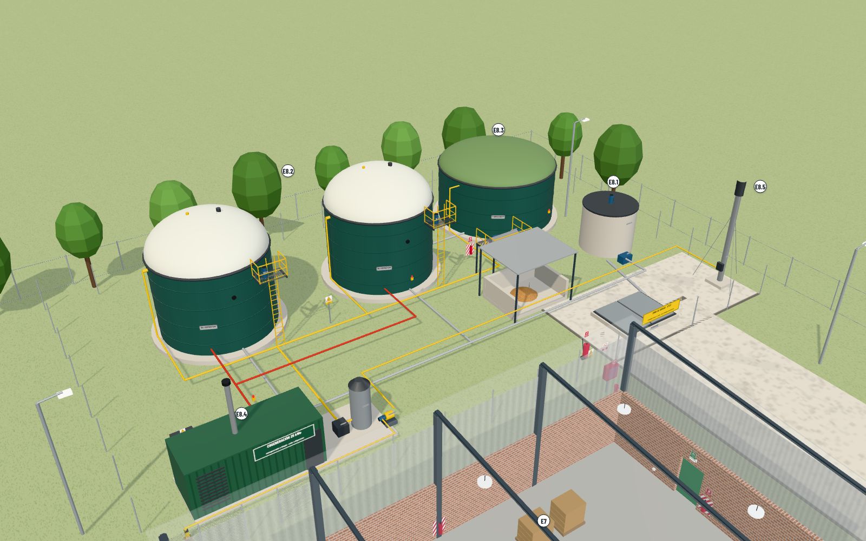
portal/img/vista_biogas.jpg
