lagzgabrielmuller-dot/planta-secadora-guano/portal/img/vista_envasado.jpg

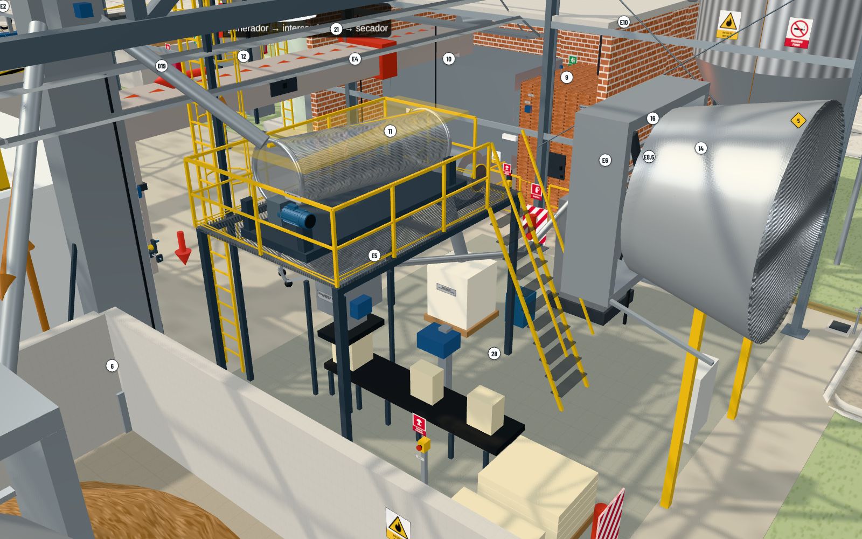
portal/img/vista_envasado.jpg
