lagzgabrielmuller-dot/planta-secadora-guano/portal/img/vista_incendio.jpg

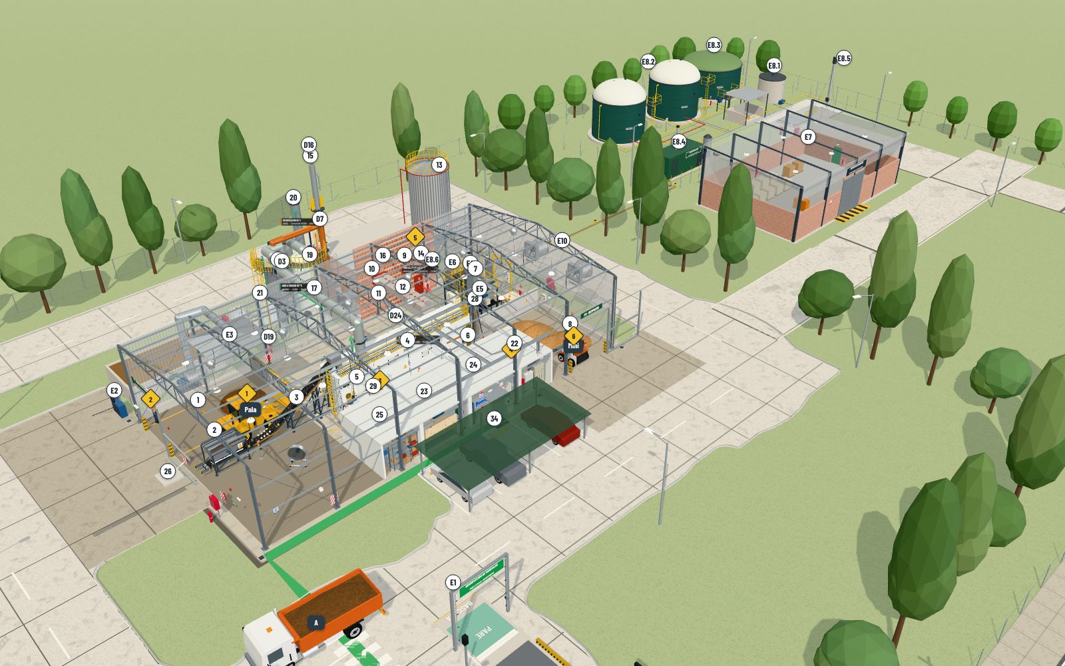
portal/img/vista_incendio.jpg
