lagzgabrielmuller-dot/planta-secadora-guano/portal/img/vista_interior.jpg

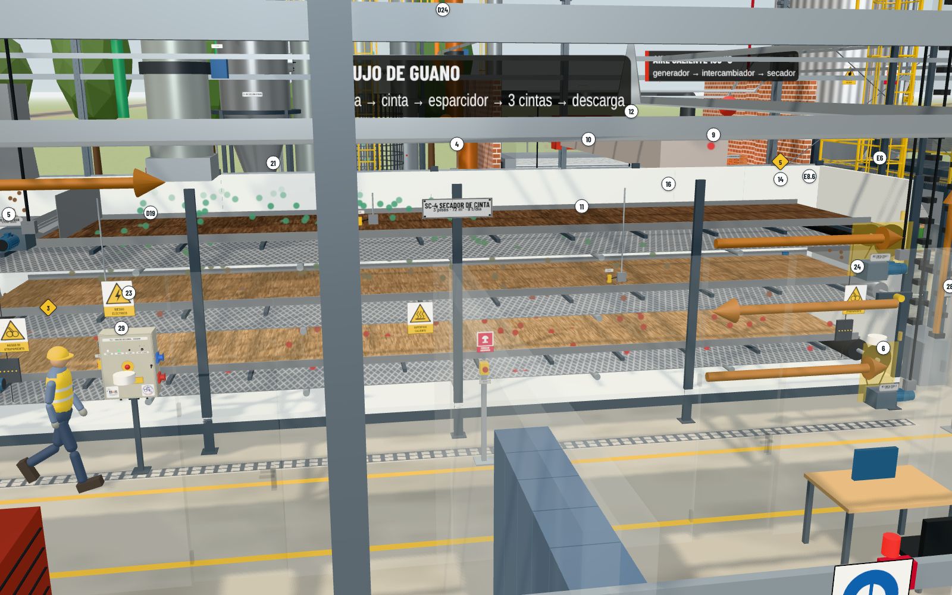
portal/img/vista_interior.jpg
