lagzgabrielmuller-dot/planta-secadora-guano/portal/img/vista_mantenimiento.jpg

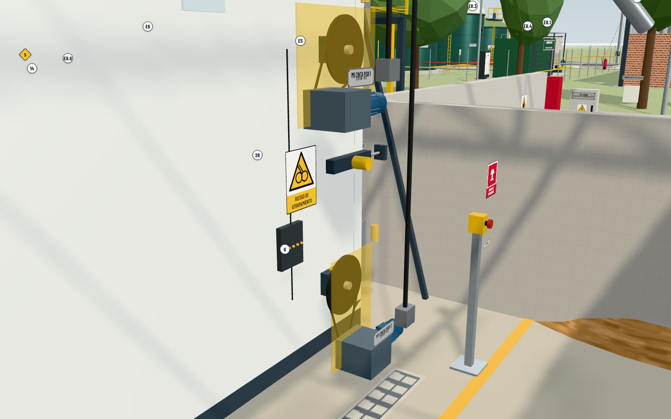
portal/img/vista_mantenimiento.jpg
