lagzgabrielmuller-dot/planta-secadora-guano/portal/img/vista_ubicacion.jpg

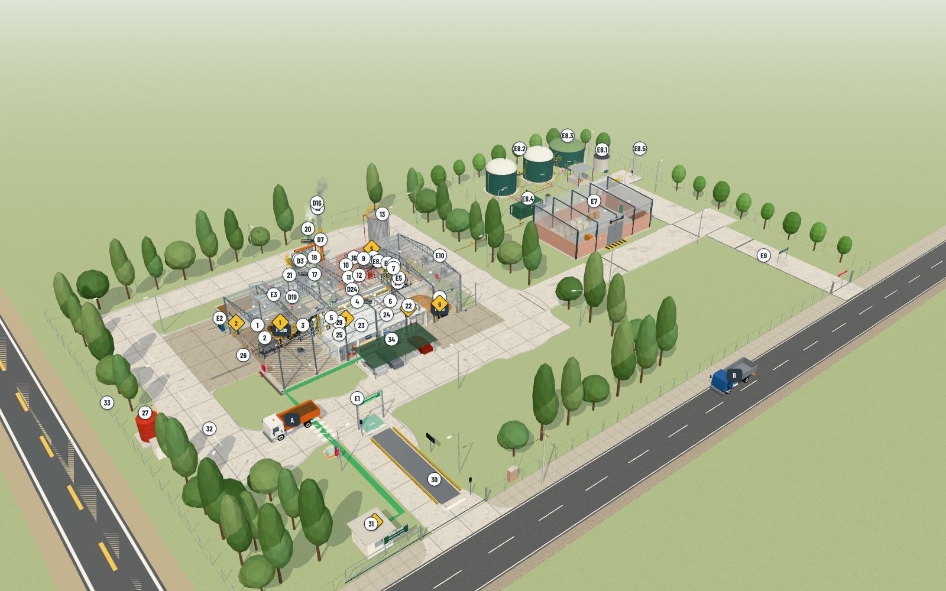
portal/img/vista_ubicacion.jpg
