lagzgabrielmuller-dot/planta-secadora-guano/secadora/planos/dxf/img/paso_01.png

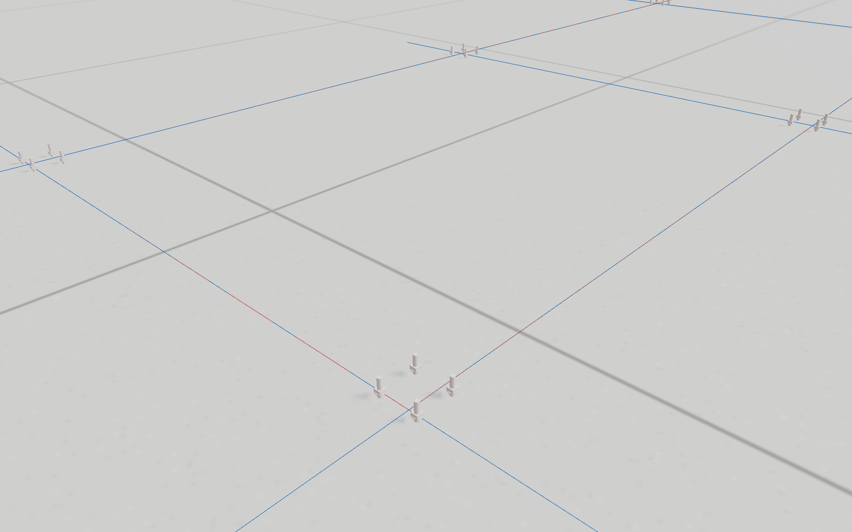
secadora/planos/dxf/img/paso_01.png
