lagzgabrielmuller-dot/planta-secadora-guano/secadora/planos/dxf/img/paso_02.png

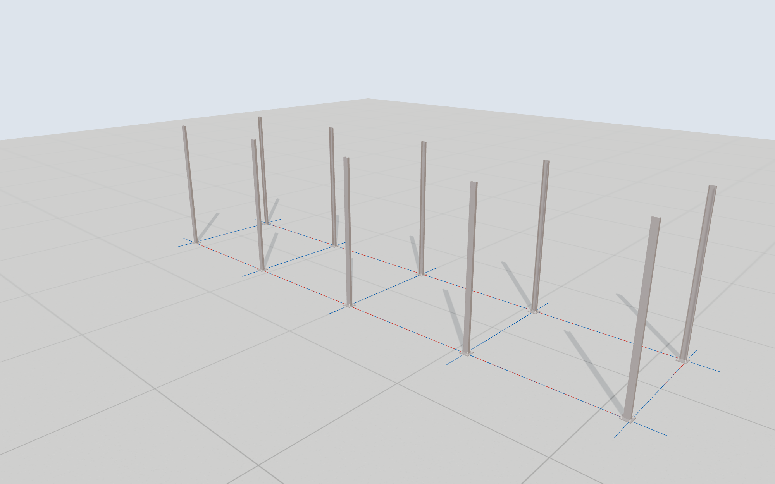
secadora/planos/dxf/img/paso_02.png
