lagzgabrielmuller-dot/planta-secadora-guano/secadora/planos/dxf/img/paso_05.png

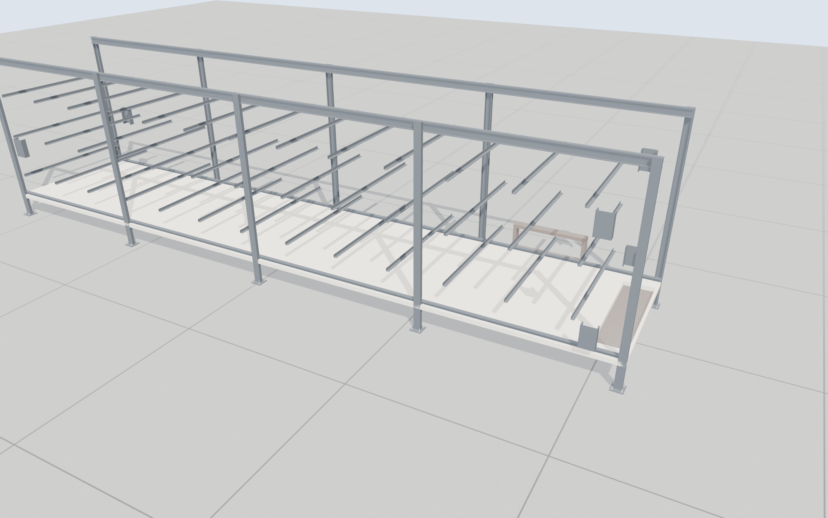
secadora/planos/dxf/img/paso_05.png
