lagzgabrielmuller-dot/planta-secadora-guano/secadora/planos/dxf/img/paso_06.png

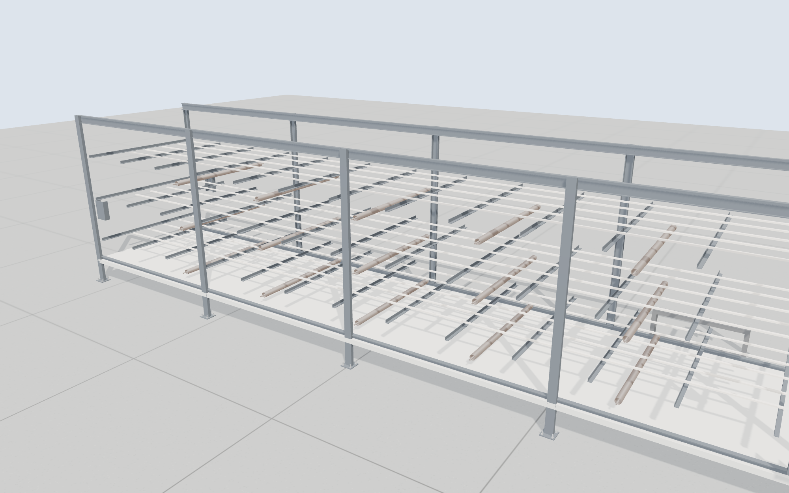
secadora/planos/dxf/img/paso_06.png
