lagzgabrielmuller-dot/planta-secadora-guano/secadora/planos/dxf/img/paso_10.png

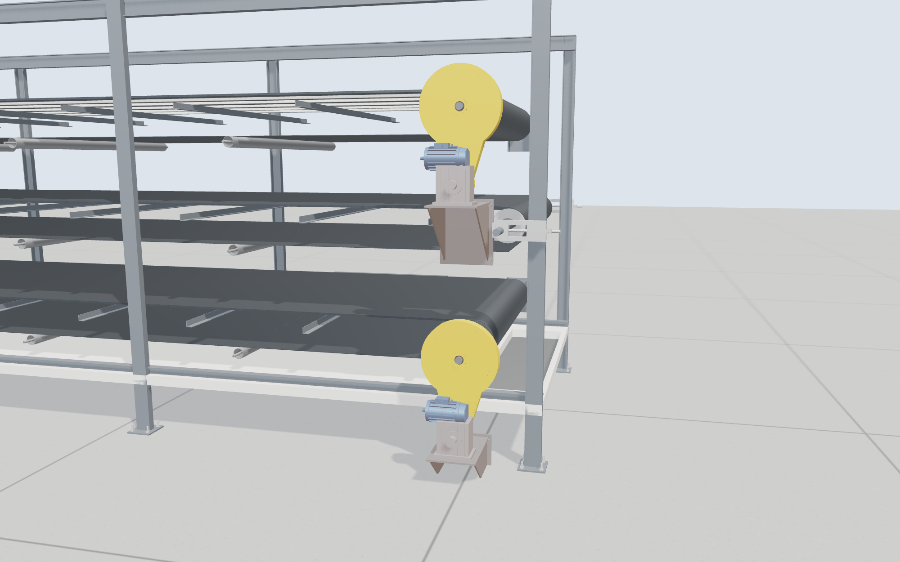
secadora/planos/dxf/img/paso_10.png
