lagzgabrielmuller-dot/planta-secadora-guano/secadora/planos/dxf/img/paso_11.png

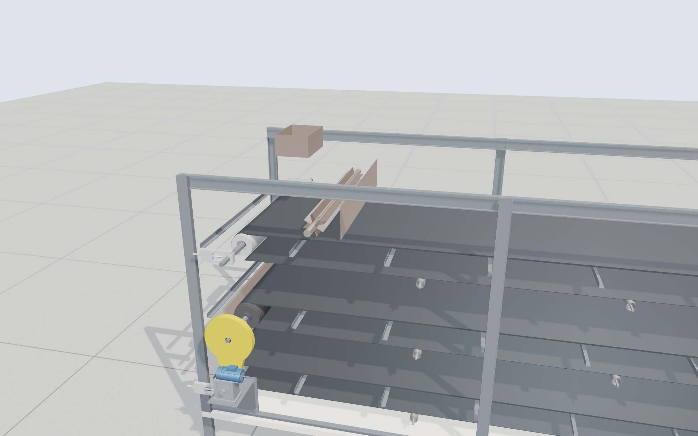
secadora/planos/dxf/img/paso_11.png
