lagzgabrielmuller-dot/planta-secadora-guano/secadora/planos/dxf/img/SC06_paso_07.png

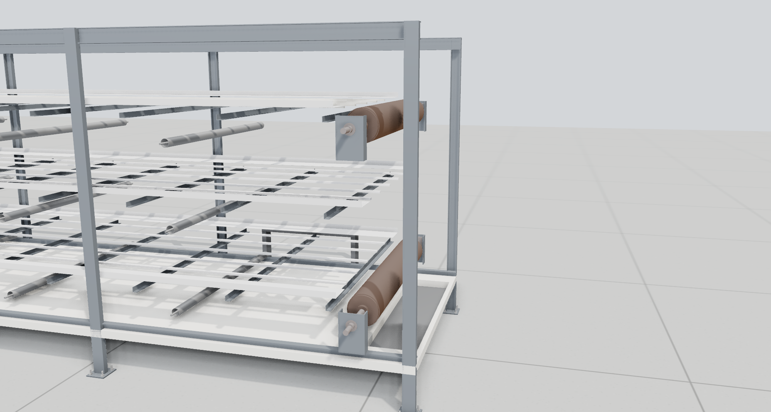
secadora/planos/dxf/img/SC06_paso_07.png
