lagzgabrielmuller-dot/planta-secadora-guano/secadora/planos/dxf/img/SC06_paso_08.png

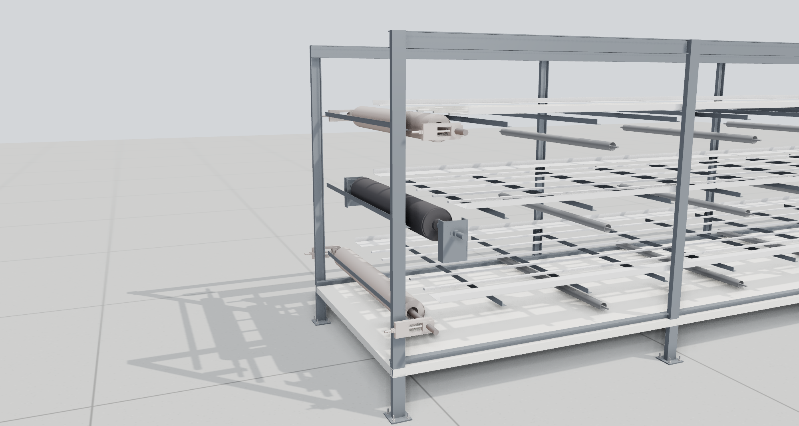
secadora/planos/dxf/img/SC06_paso_08.png
