lagzgabrielmuller-dot/planta-secadora-guano/secadora/planos/dxf/img/SC06_paso_11.png

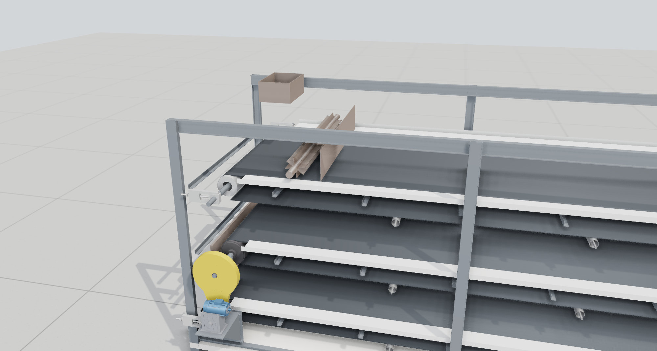
secadora/planos/dxf/img/SC06_paso_11.png
