lagzgabrielmuller-dot/planta-secadora-guano/secadora/planos/SC-05.png

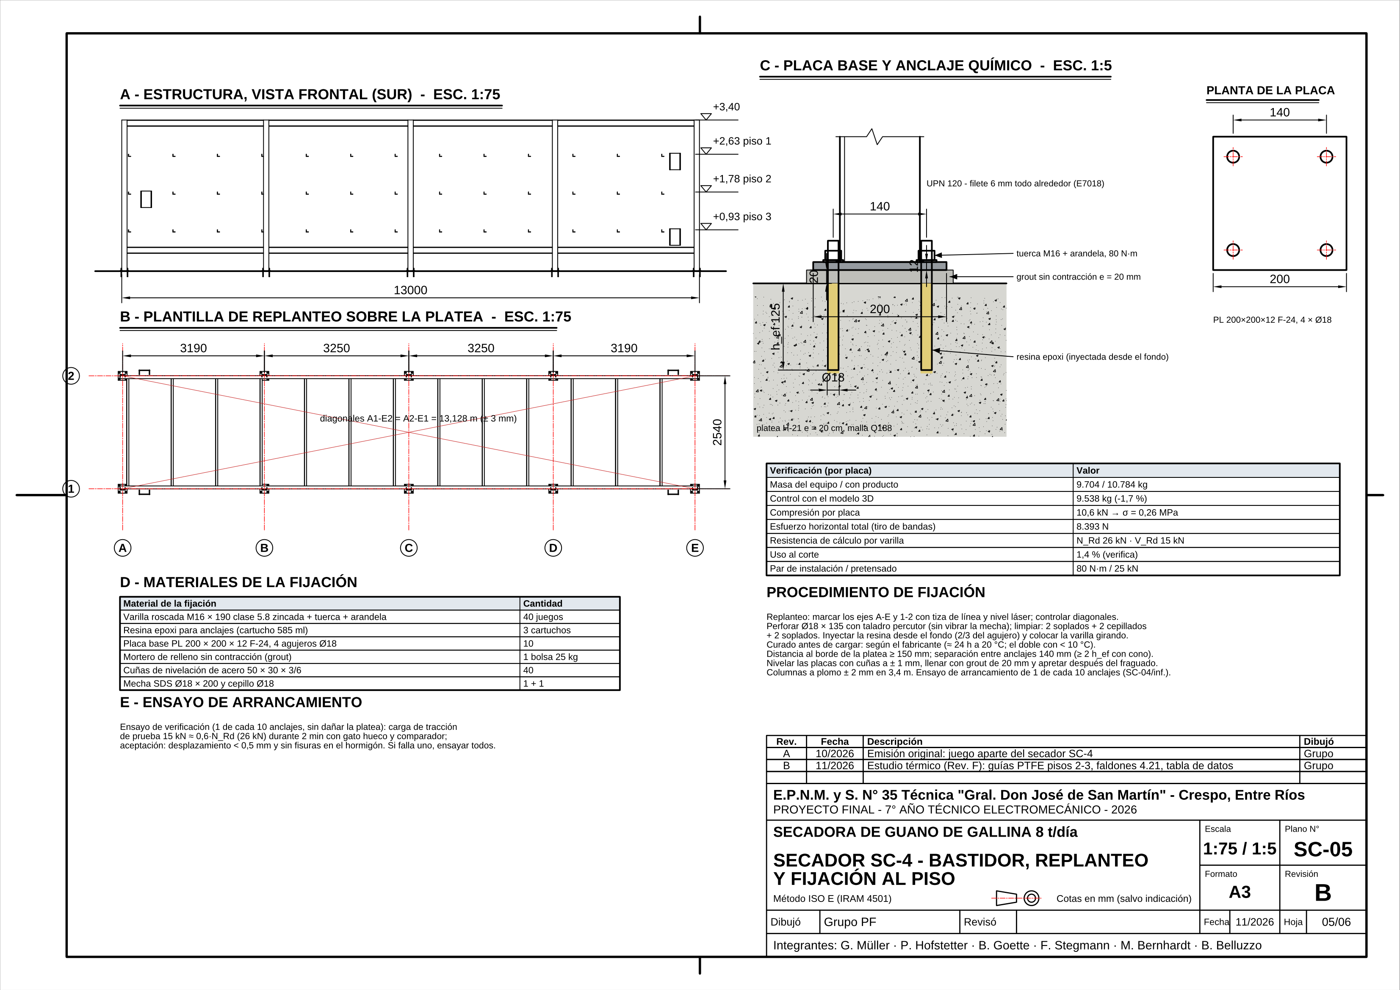
secadora/planos/SC-05.png
