lagzgabrielmuller-dot/planta-secadora-guano/secadora/renders/SC_oeste.png

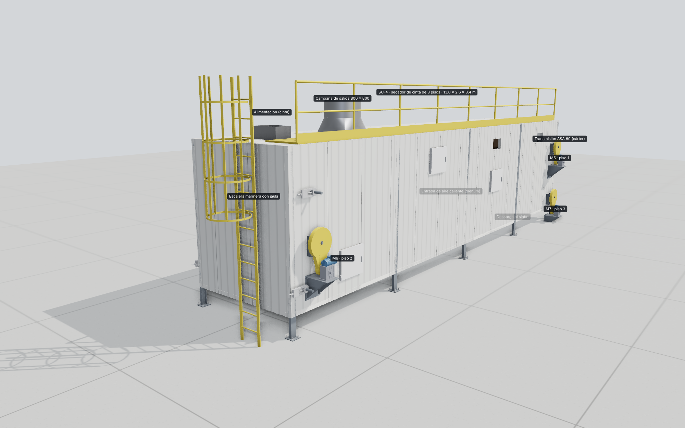
secadora/renders/SC_oeste.png
