lagzgabrielmuller-dot/planta-secadora-guano/simulacion_termica/figuras/02_capas_del_lecho.png

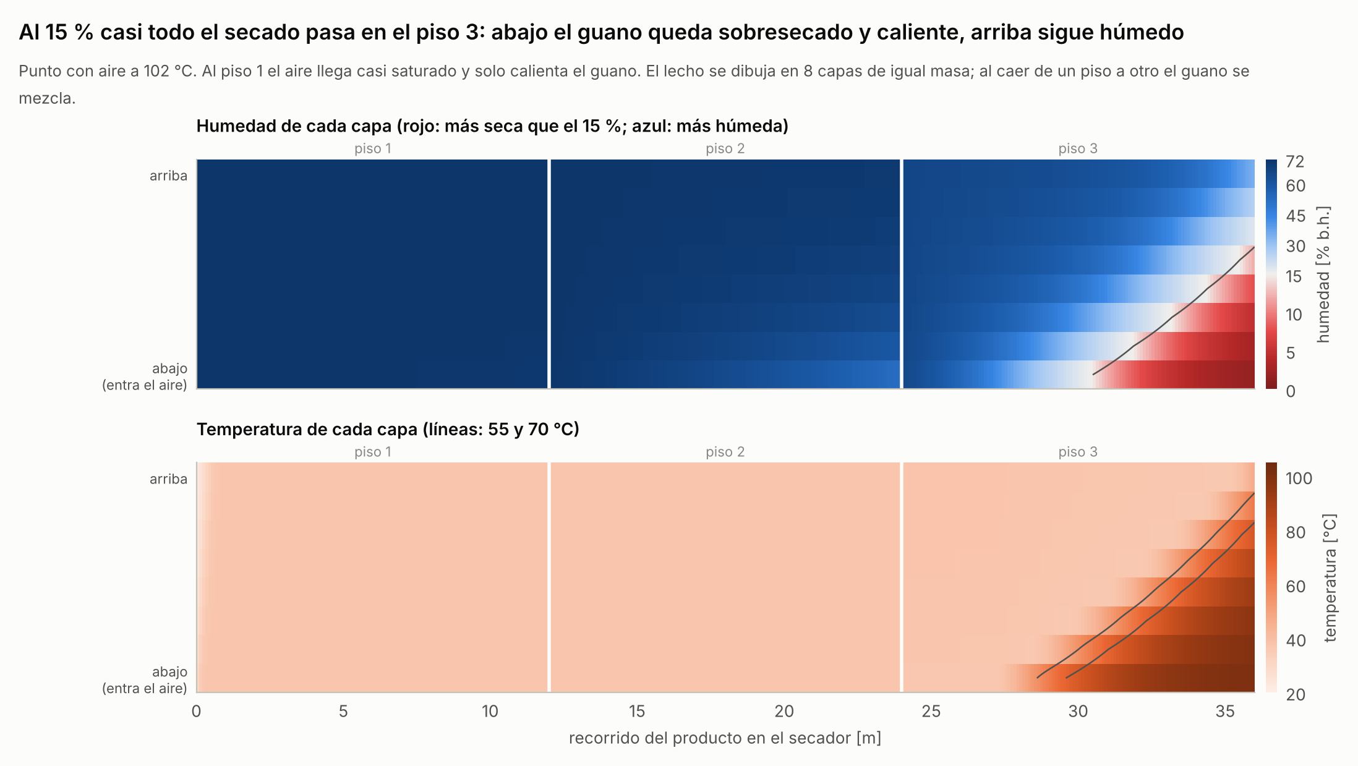
simulacion_termica/figuras/02_capas_del_lecho.png
