lagzgabrielmuller-dot/planta-secadora-guano/simulacion_termica/figuras/03_ventana_de_operacion.png

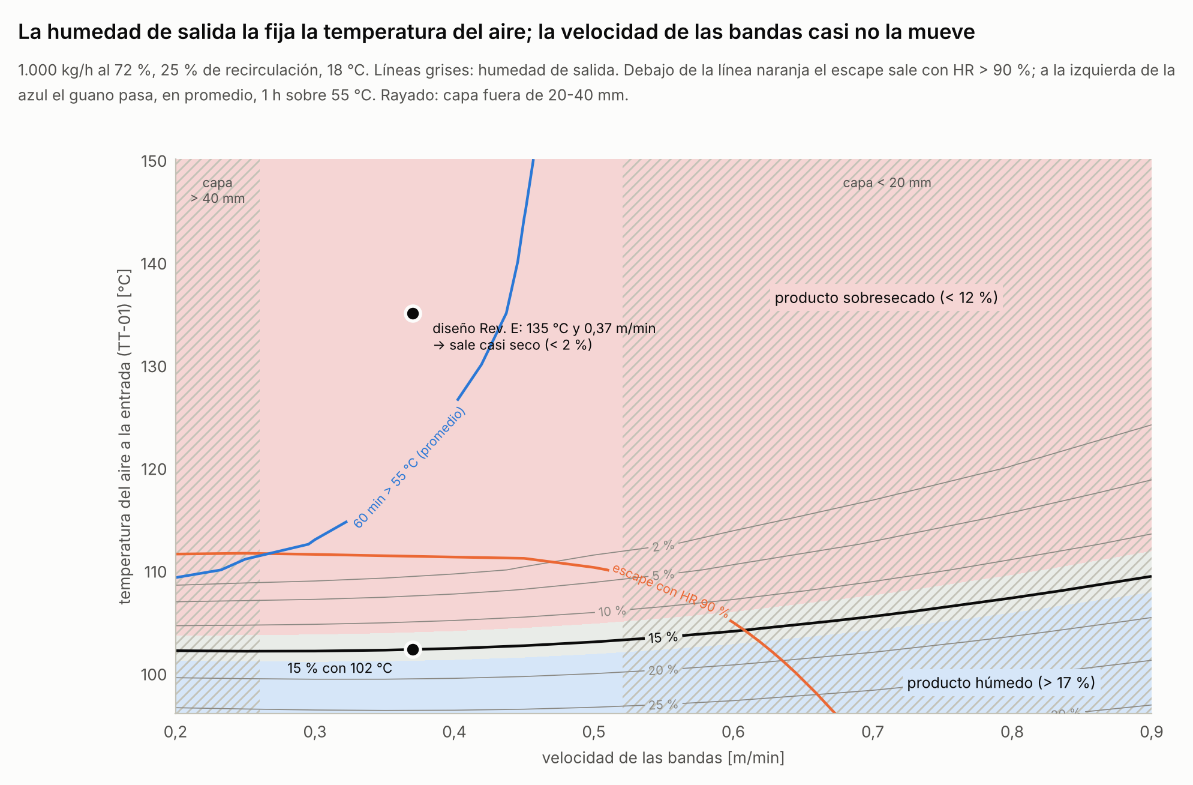
simulacion_termica/figuras/03_ventana_de_operacion.png
