lagzgabrielmuller-dot/planta-secadora-guano/simulacion_termica/figuras/04_que_controla_la_humedad.png

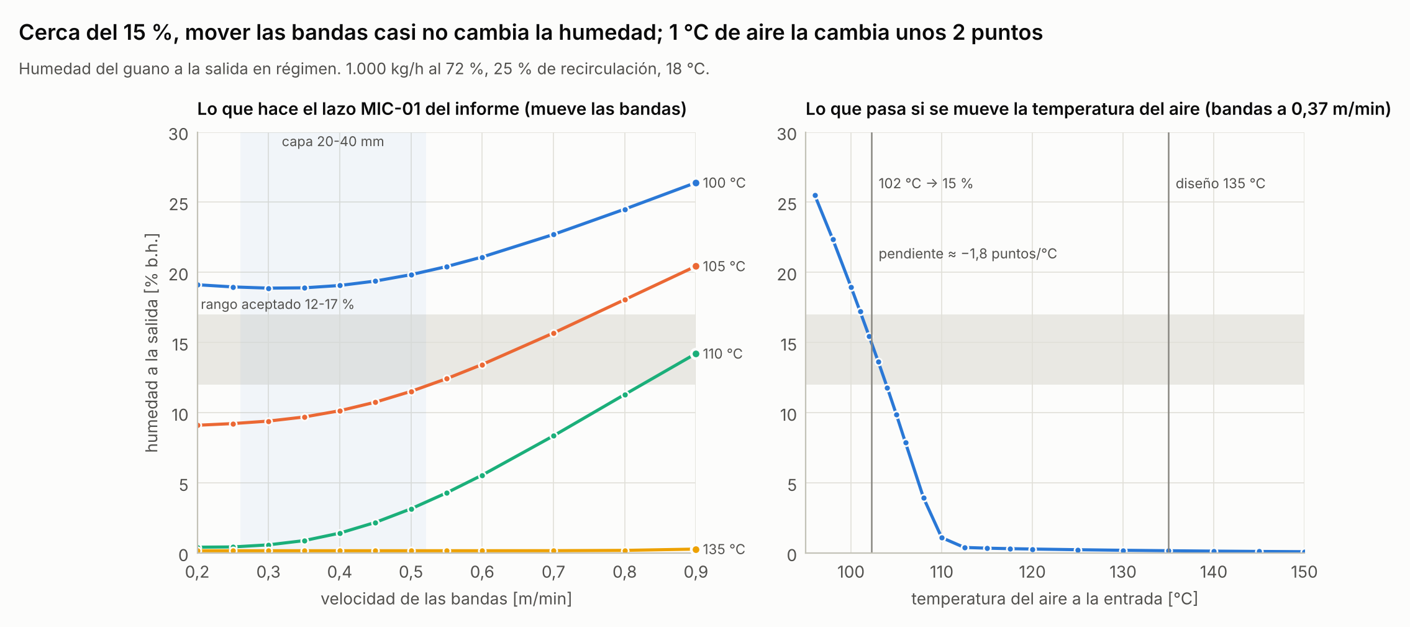
simulacion_termica/figuras/04_que_controla_la_humedad.png
