lagzgabrielmuller-dot/planta-secadora-guano/simulacion_termica/figuras/05_temperatura_necesaria.png

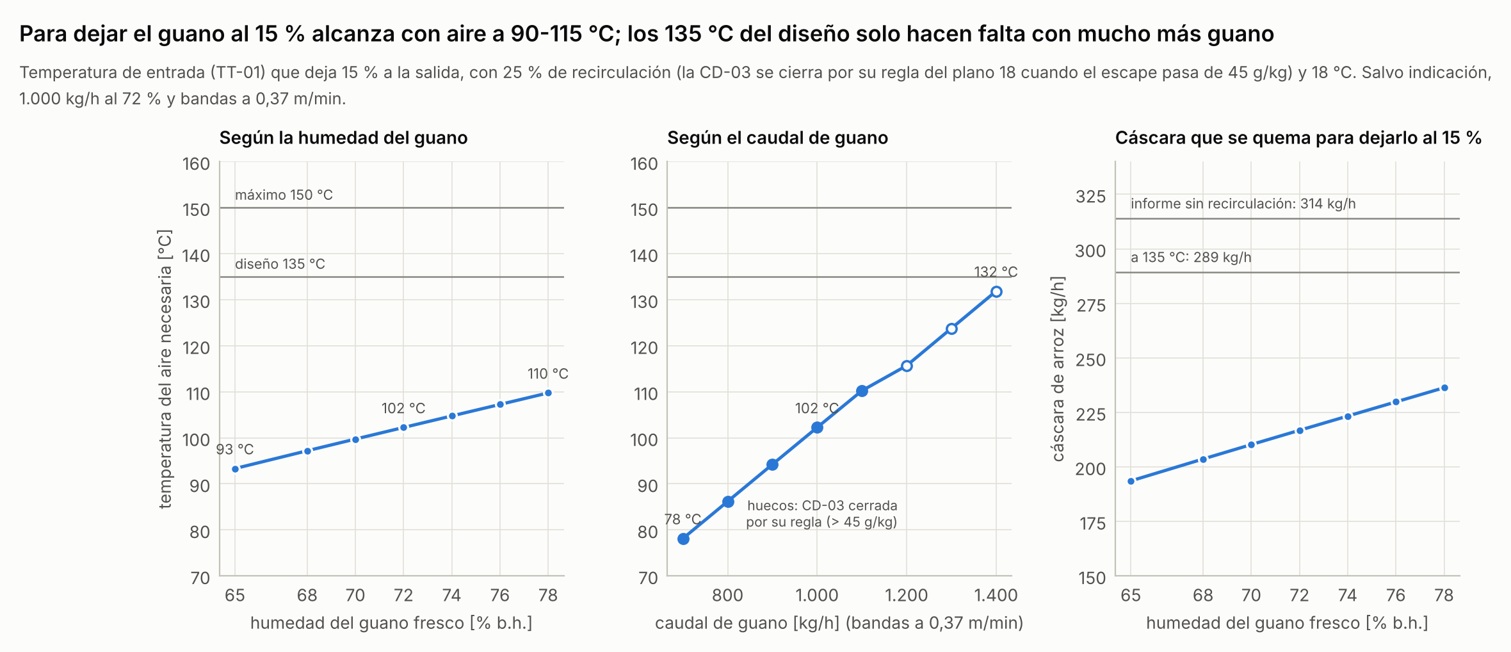
simulacion_termica/figuras/05_temperatura_necesaria.png
