lagzgabrielmuller-dot/planta-secadora-guano/simulacion_termica/figuras/06_capacidad.png

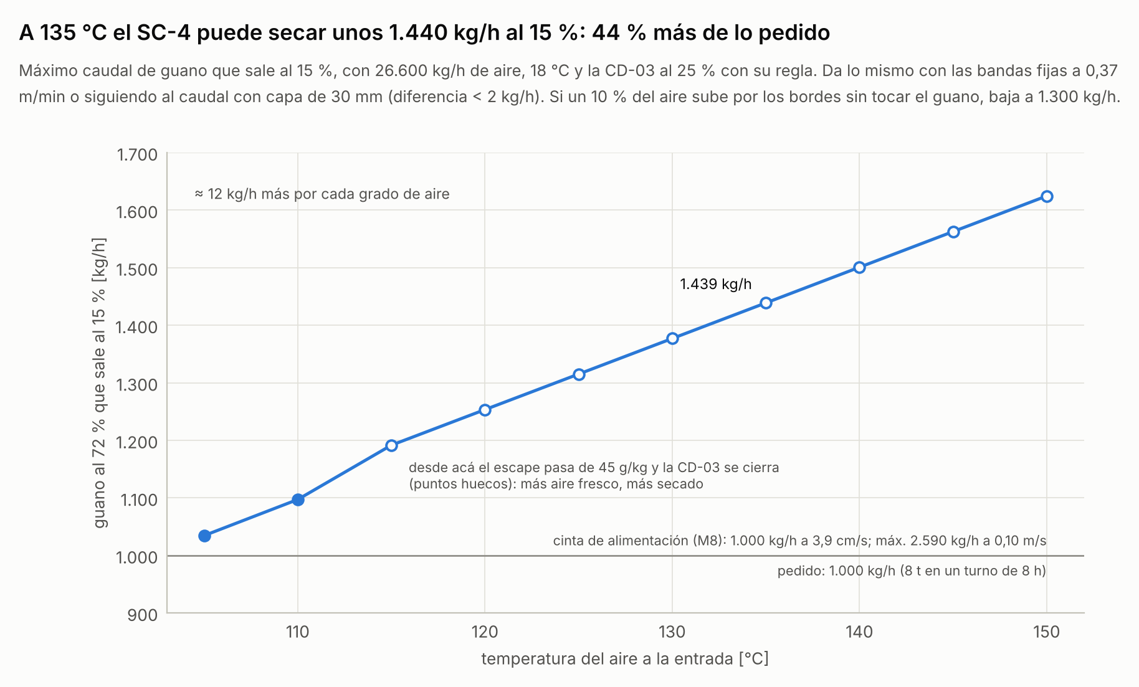
simulacion_termica/figuras/06_capacidad.png
