lagzgabrielmuller-dot/planta-secadora-guano/simulacion_termica/figuras/07_recirculacion.png

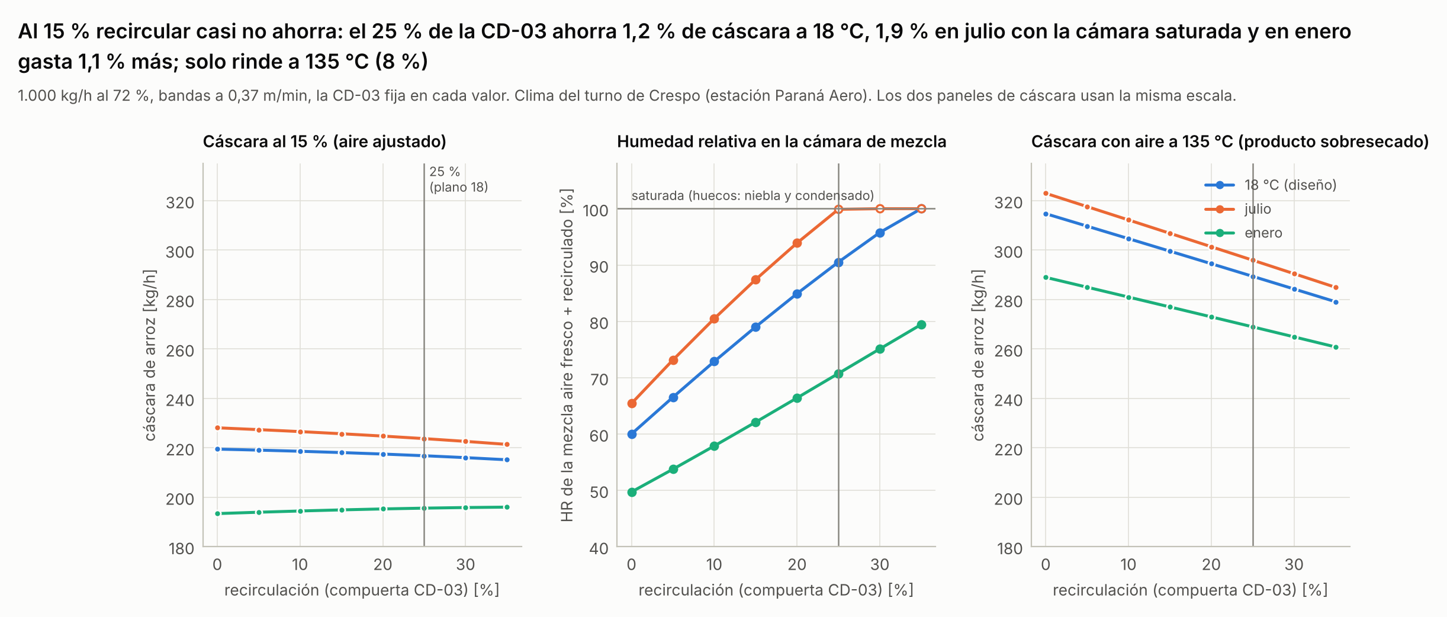
simulacion_termica/figuras/07_recirculacion.png
