lagzgabrielmuller-dot/planta-secadora-guano/simulacion_termica/figuras/08_sensibilidad.png

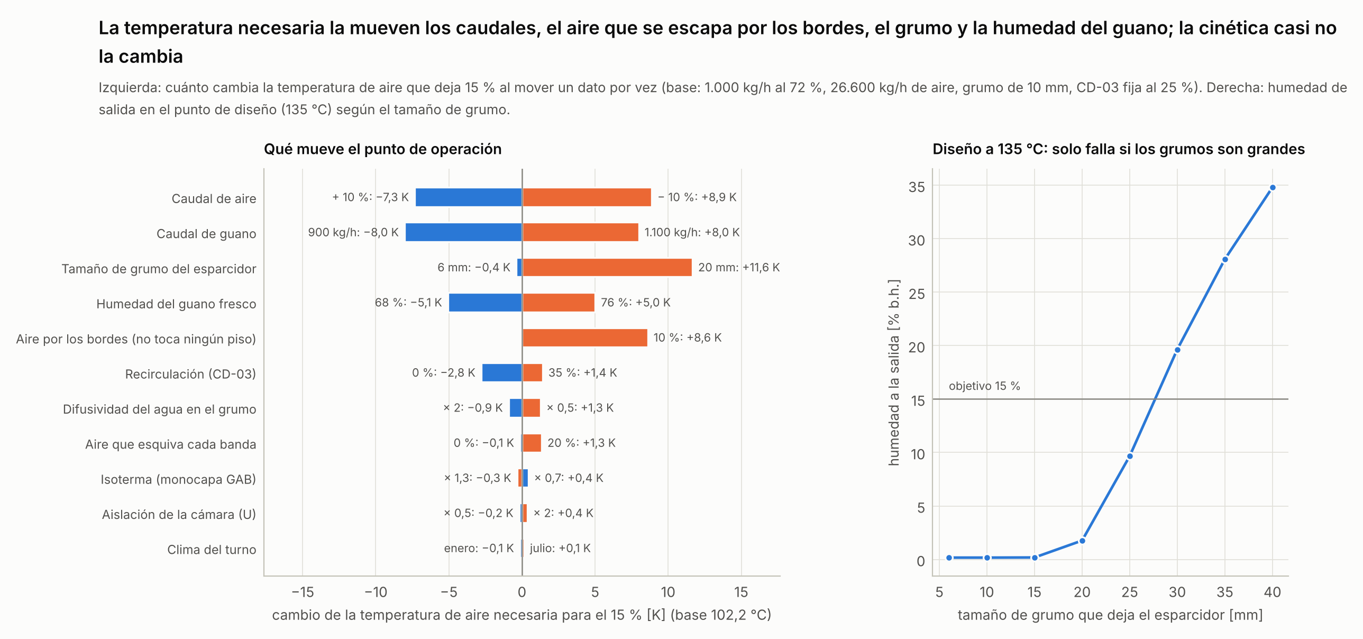
simulacion_termica/figuras/08_sensibilidad.png
