lagzgabrielmuller-dot/planta-secadora-guano/simulacion_termica/figuras/09_clima_anual.png

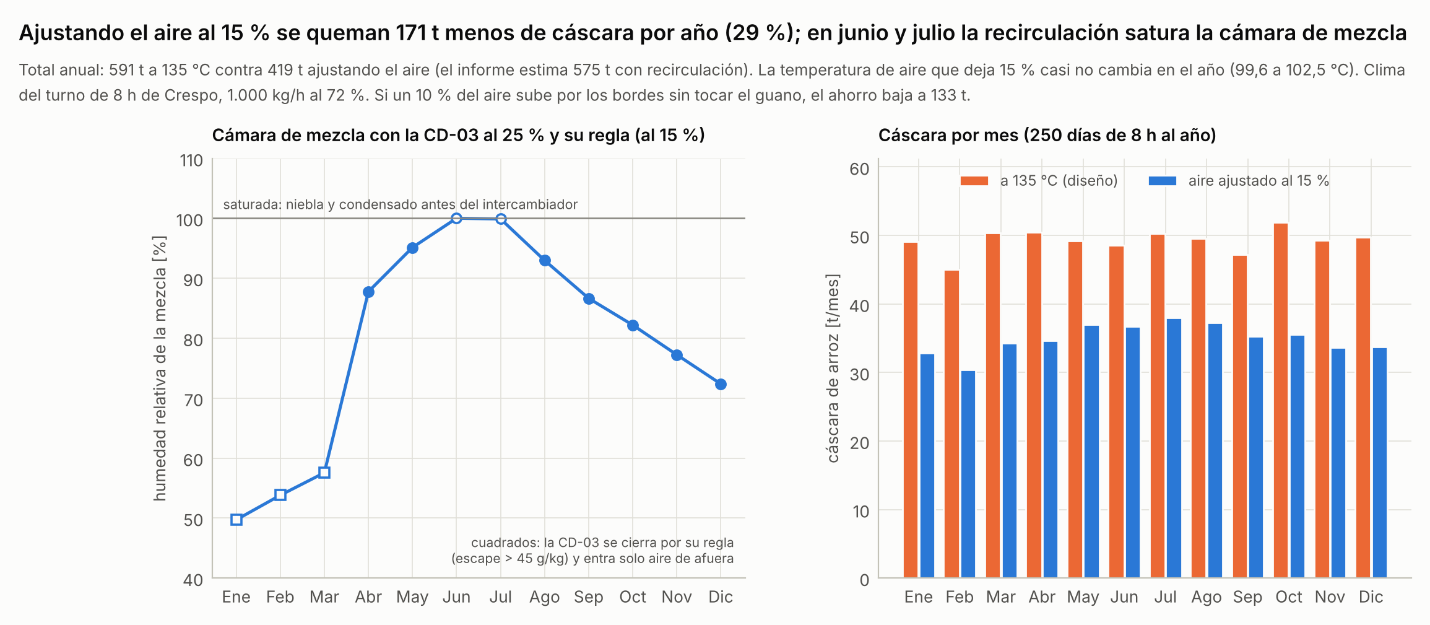
simulacion_termica/figuras/09_clima_anual.png
