lagzgabrielmuller-dot/planta-secadora-guano/simulacion_termica/figuras/10_guias_uhmw.png

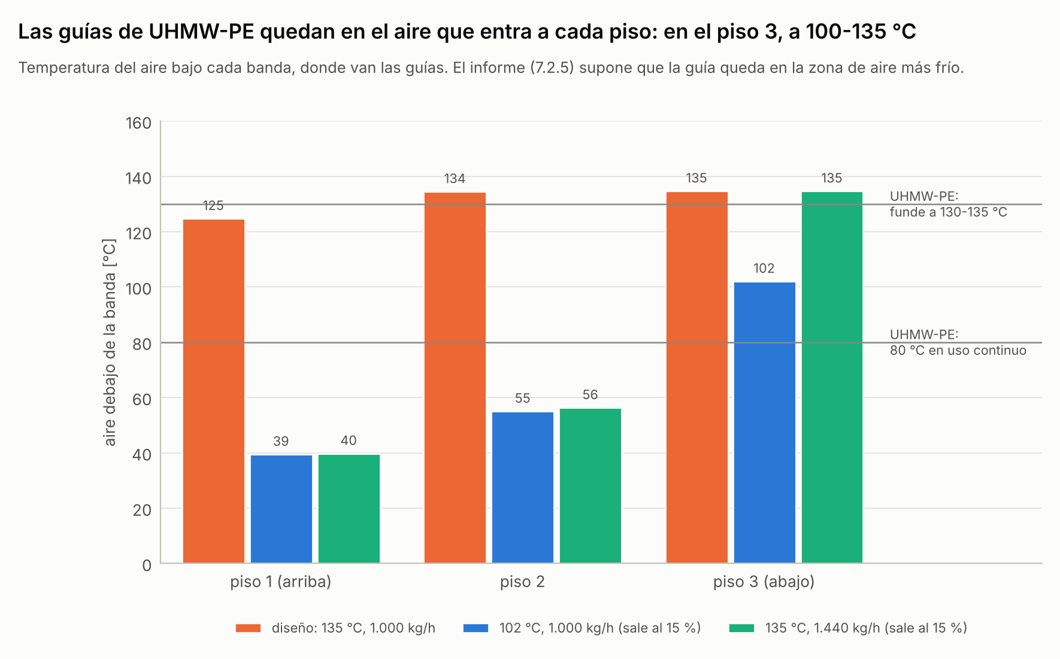
simulacion_termica/figuras/10_guias_uhmw.png
