lagzgabrielmuller-dot/planta-secadora-guano/simulacion_termica/figuras/11_higiene.png

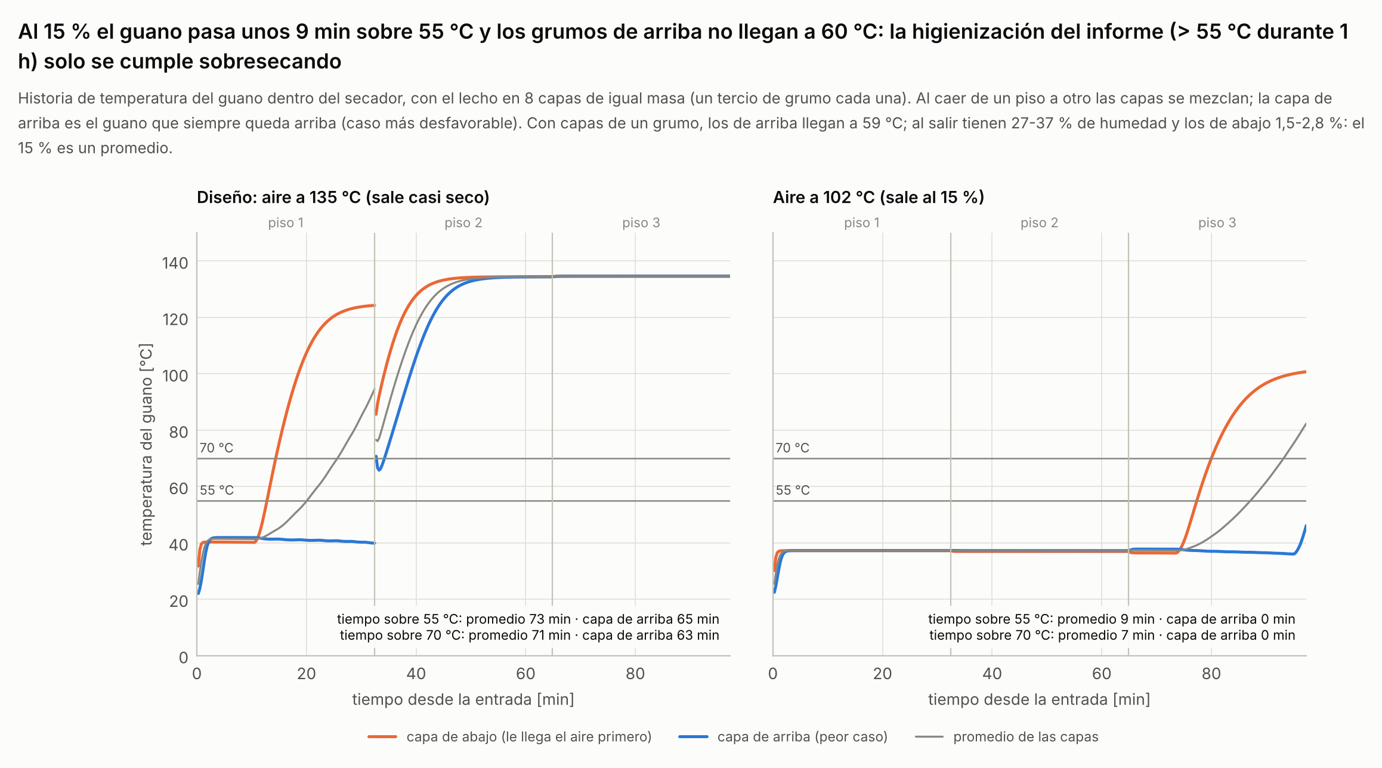
simulacion_termica/figuras/11_higiene.png
