lagzgabrielmuller-dot/planta-secadora-guano/simulacion_termica/figuras/13_validacion_cinetica.png

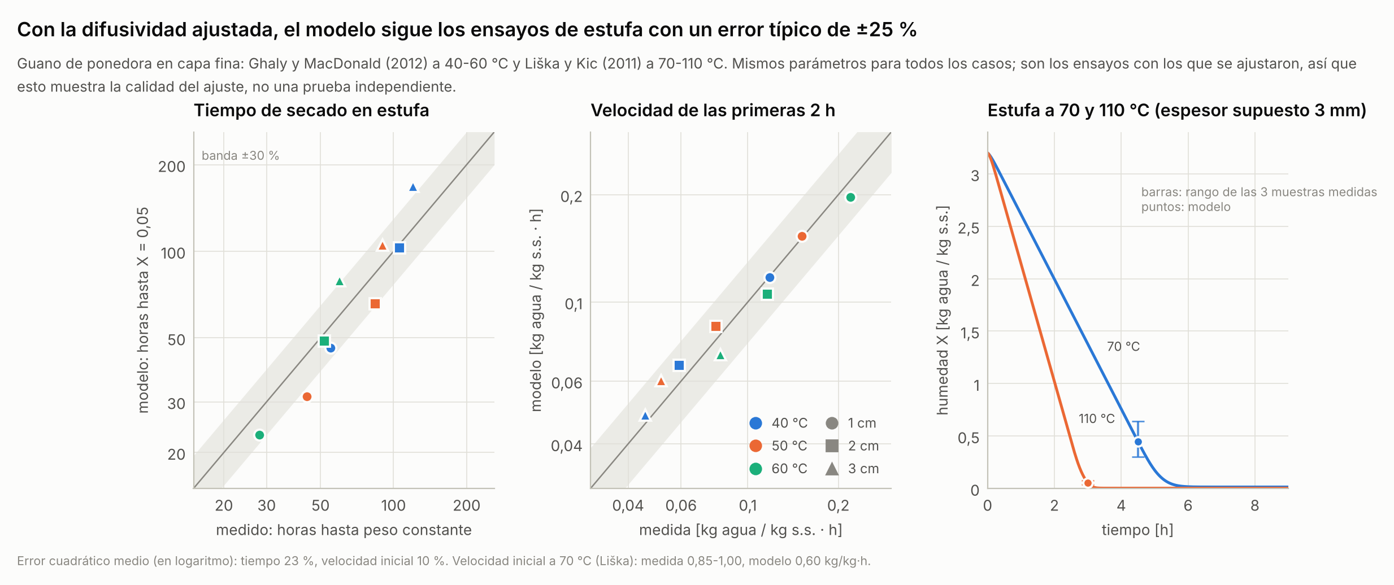
simulacion_termica/figuras/13_validacion_cinetica.png
