lagzgabrielmuller-dot/planta-secadora-guano/planos/dxf/P11.dxf

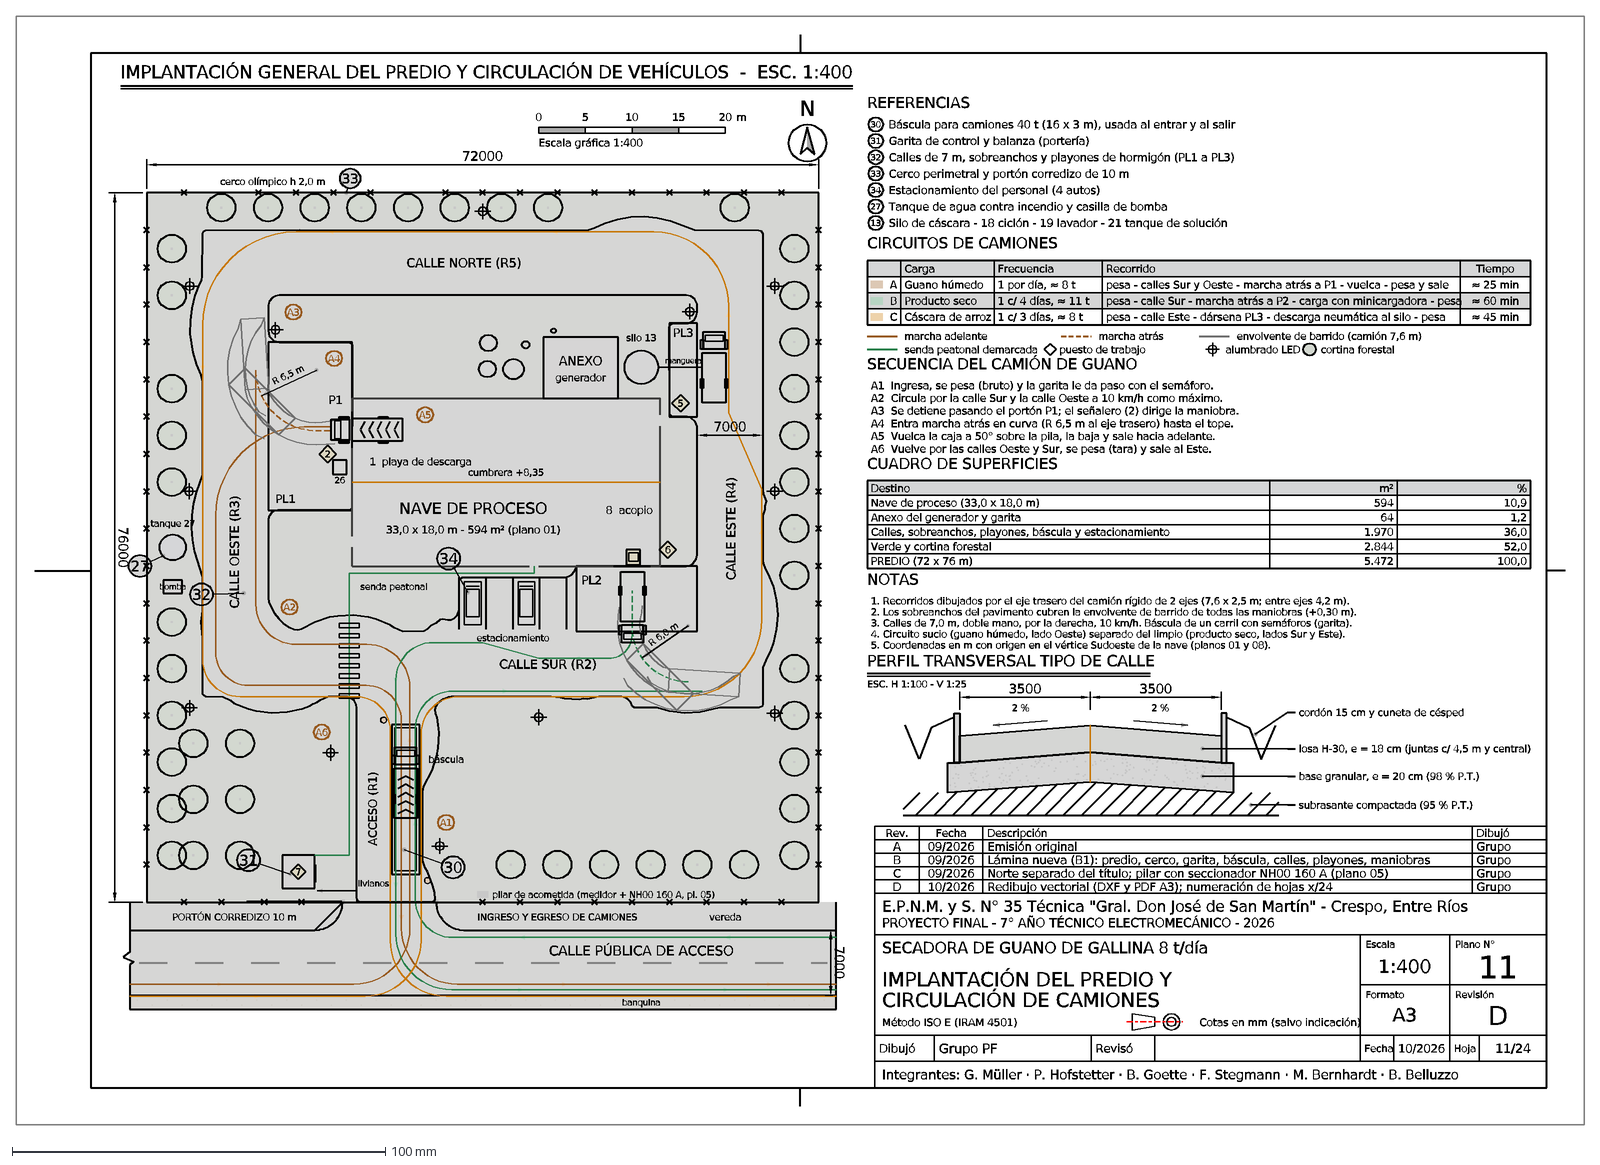
[picture p132: CAD file, 2026-11-11]
planos/dxf/P11.dxf
Integrantes: G. Müller · P. Hofstetter · B. Goette · F. Stegmann · M. Bernhardt · B. Belluzzo
Dibujó
Grupo PF
Revisó
Fecha
10/2026
Hoja
11/24
SECADORA DE GUANO DE GALLINA 8 t/día
IMPLANTACIÓN DEL PREDIO Y
CIRCULACIÓN DE CAMIONES
Método ISO E (IRAM 4501)
Cotas en mm (salvo indicación)
Escala
1:400
Formato
A3
Plano N°
11
Revisión
D
E.P.N.M. y S. N° 35 Técnica "Gral. Don José de San Martín" - Crespo, Entre Ríos
PROYECTO FINAL - 7° AÑO TÉCNICO ELECTROMECÁNICO - 2026
Redibujo vectorial (DXF y PDF A3); numeración de hojas x/24
Grupo
C
09/2026
Norte separado del título; pilar con seccionador NH00 160 A (plano 05)
B
Lámina nueva (B1): predio, cerco, garita, báscula, calles, playones, maniobras
A
Emisión original
Rev.
Descripción
IMPLANTACIÓN GENERAL DEL PREDIO Y CIRCULACIÓN DE VEHÍCULOS - ESC. 1:400
cumbrera +8,35
NAVE DE PROCESO
33,0 x 18,0 m - 594 m² (plano 01)
1 playa de descarga
8 acopio
ANEXO
generador
silo 13
manguera
PL1
P1
PL2
PL3
26
tanque 27
bomba
pilar de acometida (medidor + NH00 160 A, pl. 05)
senda peatonal
estacionamiento
livianos
R 6,5 m
R 6,0 m
cerco olímpico h 2,0 m
CALLE NORTE (R5)
CALLE SUR (R2)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
