lagzgabrielmuller-dot/planta-secadora-guano/secadora/modelo_3d/Secador_SC4.step

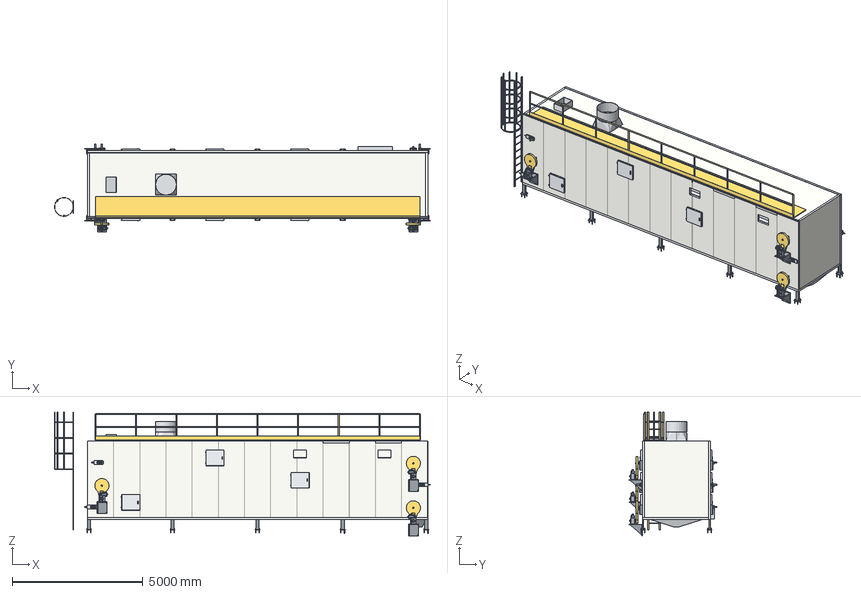
[picture p133: CAD file, 2026-11-11]
secadora/modelo_3d/Secador_SC4.step
14365.0 x 3355.0 x 4728.0 mm
P000
P001
P002
P003
P004
P005
P006
P007
P008
P009
P010
P011
P012
P013
P014
P015
P016
P017
P018
P019
P020
P021
P022
P023
P024
P025
P026
P027
P028
P029
P030
P031
P032
P033
P034
P035
P036
P037
P038
P039
P040
P041
P042
P043
P044
P045
P046
P047
P048
P049
P050
P051
P052
P053
P054
P055
P056
P057
P058
P059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
