lagzgabrielmuller-dot/planta-secadora-guano/planos/dxf/P08.dxf

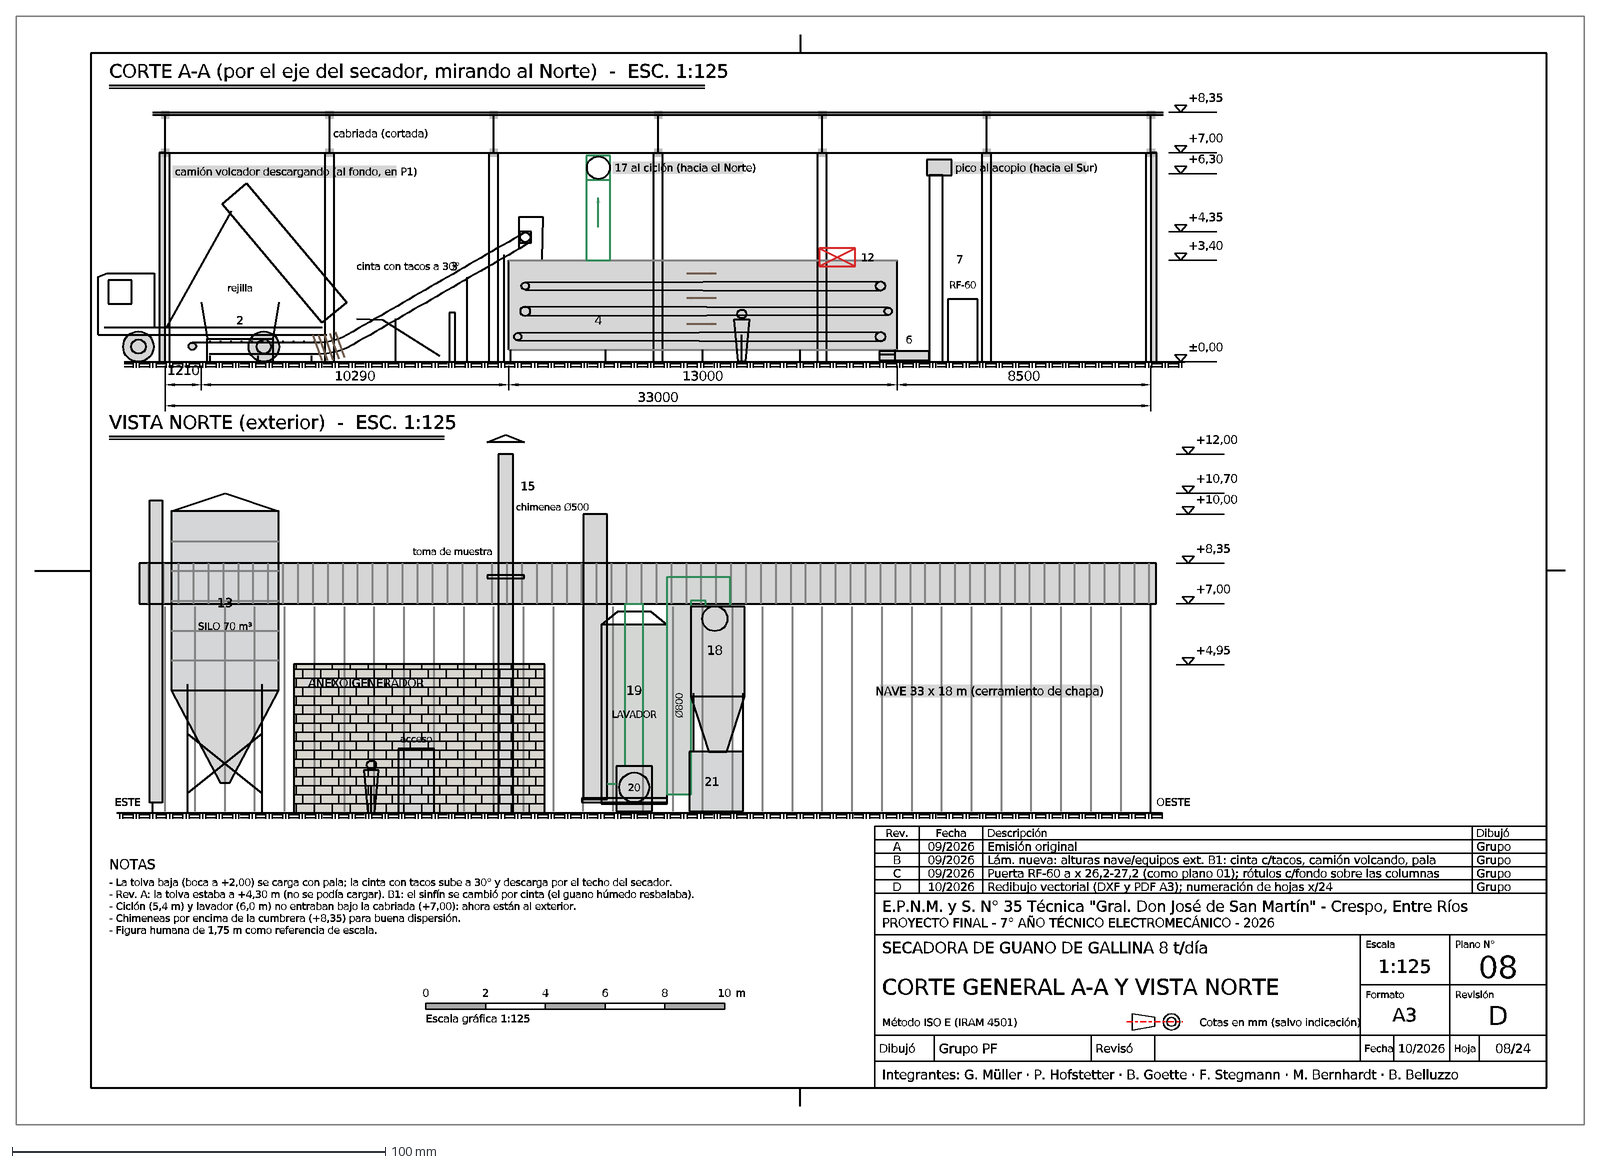
[picture p134: CAD file, 2026-11-11]
planos/dxf/P08.dxf
Integrantes: G. Müller · P. Hofstetter · B. Goette · F. Stegmann · M. Bernhardt · B. Belluzzo
Dibujó
Grupo PF
Revisó
Fecha
10/2026
Hoja
08/24
SECADORA DE GUANO DE GALLINA 8 t/día
CORTE GENERAL A-A Y VISTA NORTE
Método ISO E (IRAM 4501)
Cotas en mm (salvo indicación)
Escala
1:125
Formato
A3
Plano N°
08
Revisión
D
E.P.N.M. y S. N° 35 Técnica "Gral. Don José de San Martín" - Crespo, Entre Ríos
PROYECTO FINAL - 7° AÑO TÉCNICO ELECTROMECÁNICO - 2026
Redibujo vectorial (DXF y PDF A3); numeración de hojas x/24
Grupo
C
09/2026
Puerta RF-60 a x 26,2-27,2 (como plano 01); rótulos c/fondo sobre las columnas
B
Lám. nueva: alturas nave/equipos ext. B1: cinta c/tacos, camión volcando, pala
A
Emisión original
Rev.
Descripción
CORTE A-A (por el eje del secador, mirando al Norte) - ESC. 1:125
cabriada (cortada)
camión volcador descargando (al fondo, en P1)
rejilla
2
cinta con tacos a 30°
3
4
6
pico al acopio (hacia el Sur)
7
RF-60
17 al ciclón (hacia el Norte)
12
+8,35
+7,00
+6,30
+4,35
+3,40
±0,00
1210
10290
13000
8500
33000
VISTA NORTE (exterior) - ESC. 1:125
NAVE 33 x 18 m (cerramiento de chapa)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
