lagzgabrielmuller-dot/planta-secadora-guano/secadora/planos/dxf/SC-03.dxf

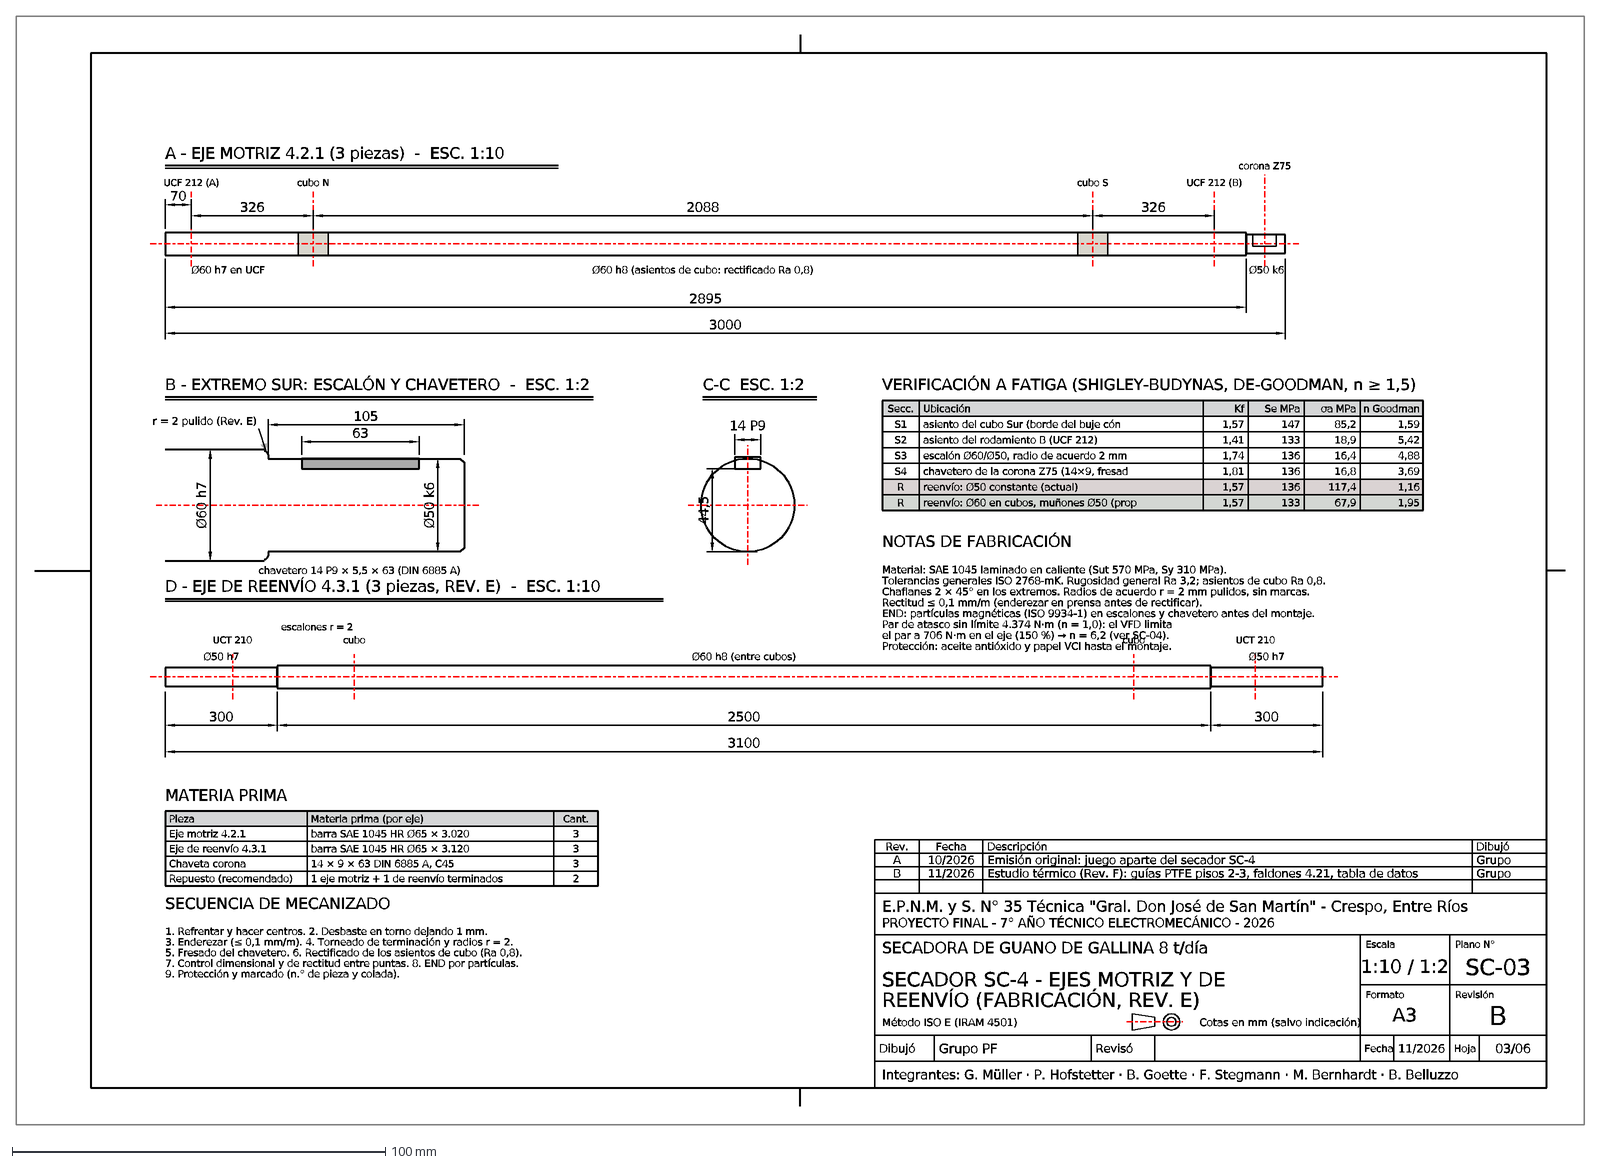
[picture p135: CAD file, 2026-11-11]
secadora/planos/dxf/SC-03.dxf
Integrantes: G. Müller · P. Hofstetter · B. Goette · F. Stegmann · M. Bernhardt · B. Belluzzo
Dibujó
Grupo PF
Revisó
Fecha
11/2026
Hoja
03/06
SECADORA DE GUANO DE GALLINA 8 t/día
SECADOR SC-4 - EJES MOTRIZ Y DE
REENVÍO (FABRICACIÓN, REV. E)
Método ISO E (IRAM 4501)
Cotas en mm (salvo indicación)
Escala
1:10 / 1:2
Formato
A3
Plano N°
SC-03
Revisión
B
E.P.N.M. y S. N° 35 Técnica "Gral. Don José de San Martín" - Crespo, Entre Ríos
PROYECTO FINAL - 7° AÑO TÉCNICO ELECTROMECÁNICO - 2026
Estudio térmico (Rev. F): guías PTFE pisos 2-3, faldones 4.21, tabla de datos
Grupo
A
10/2026
Emisión original: juego aparte del secador SC-4
Rev.
Descripción
A - EJE MOTRIZ 4.2.1 (3 piezas) - ESC. 1:10
UCF 212 (A)
cubo N
cubo S
UCF 212 (B)
corona Z75
3000
2895
70
326
2088
Ø60 h8 (asientos de cubo: rectificado Ra 0,8)
Ø60 h7 en UCF
Ø50 k6
B - EXTREMO SUR: ESCALÓN Y CHAVETERO - ESC. 1:2
105
63
Ø60 h7
r = 2 pulido (Rev. E)
chavetero 14 P9 × 5,5 × 63 (DIN 6885 A)
C-C ESC. 1:2
14 P9
44,5
D - EJE DE REENVÍO 4.3.1 (3 piezas, REV. E) - ESC. 1:10
UCT 210
cubo
3100
300
2500
Ø50 h7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
