lagzgabrielmuller-dot/planta-secadora-guano/planos/dxf/P16.dxf

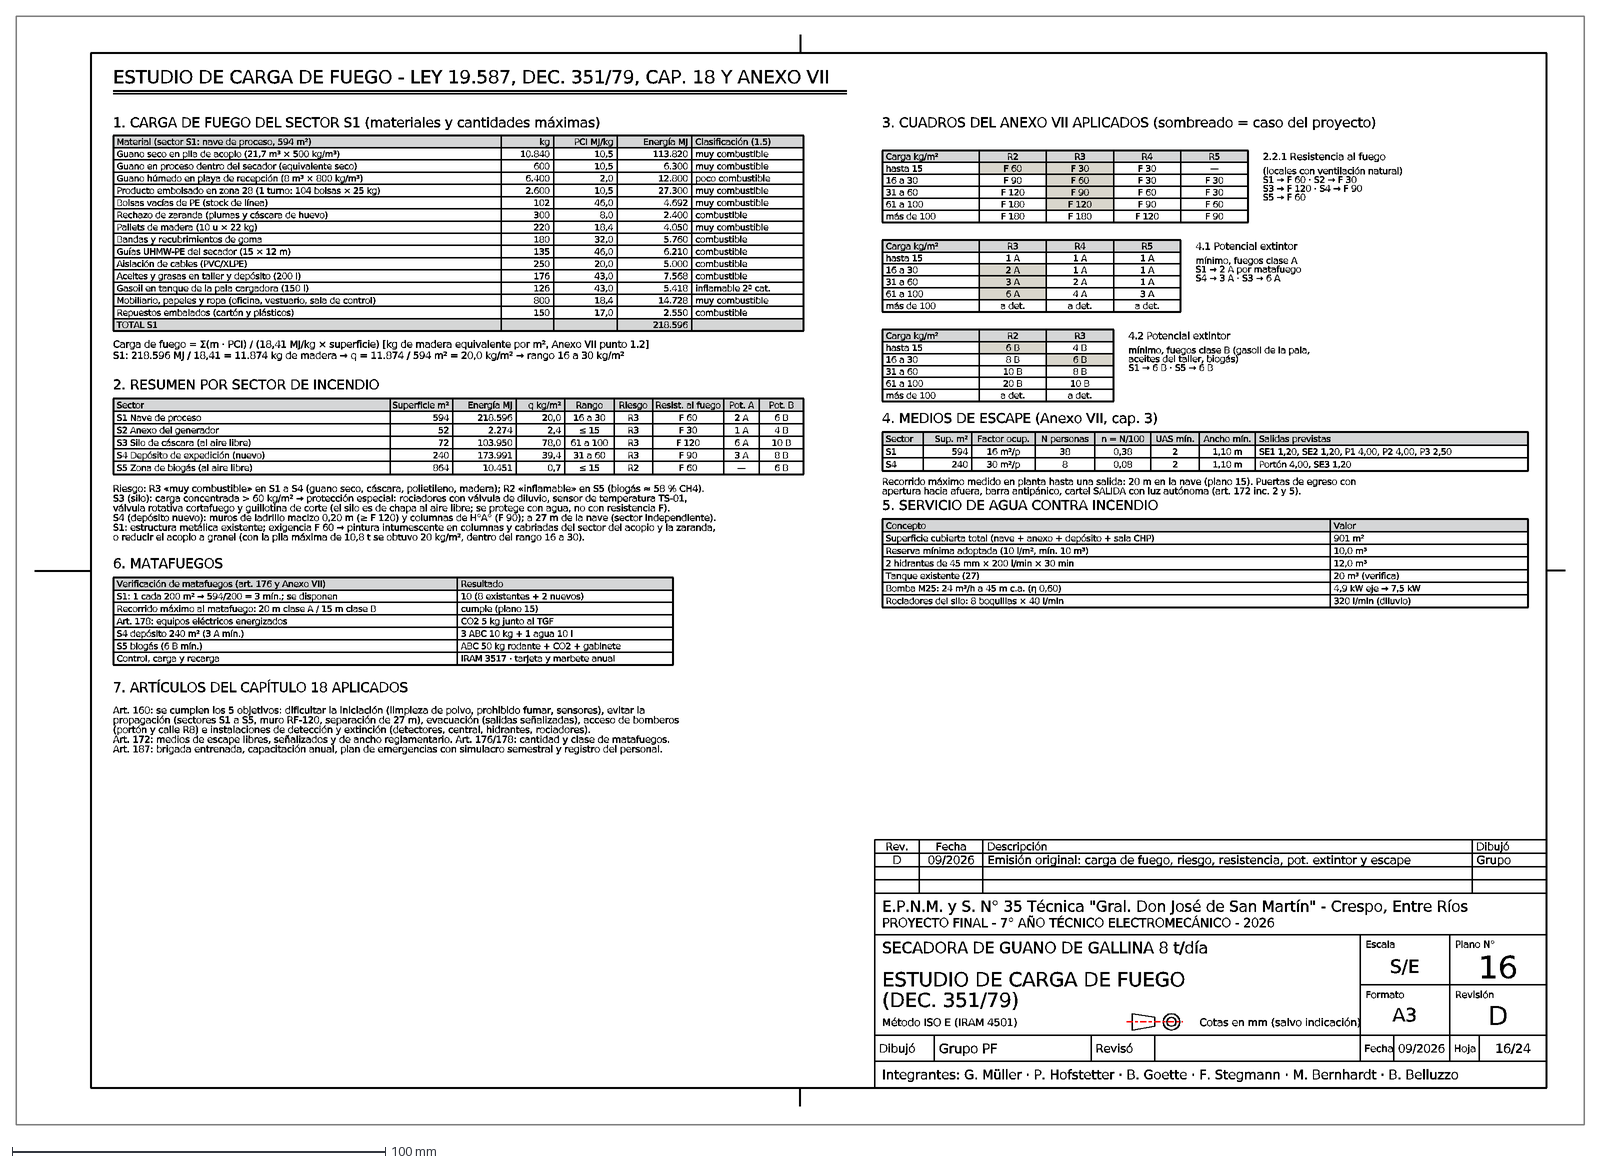
[picture p136: CAD file, 2026-11-11]
planos/dxf/P16.dxf
Integrantes: G. Müller · P. Hofstetter · B. Goette · F. Stegmann · M. Bernhardt · B. Belluzzo
Dibujó
Grupo PF
Revisó
Fecha
09/2026
Hoja
16/24
SECADORA DE GUANO DE GALLINA 8 t/día
ESTUDIO DE CARGA DE FUEGO
(DEC. 351/79)
Método ISO E (IRAM 4501)
Cotas en mm (salvo indicación)
Escala
S/E
Formato
A3
Plano N°
16
Revisión
D
E.P.N.M. y S. N° 35 Técnica "Gral. Don José de San Martín" - Crespo, Entre Ríos
PROYECTO FINAL - 7° AÑO TÉCNICO ELECTROMECÁNICO - 2026
Emisión original: carga de fuego, riesgo, resistencia, pot. extintor y escape
Grupo
Rev.
Descripción
ESTUDIO DE CARGA DE FUEGO - LEY 19.587, DEC. 351/79, CAP. 18 Y ANEXO VII
1. CARGA DE FUEGO DEL SECTOR S1 (materiales y cantidades máximas)
Material (sector S1: nave de proceso, 594 m²)
kg
PCI MJ/kg
Energía MJ
Clasificación (1.5)
Guano seco en pila de acopio (21,7 m³ × 500 kg/m³)
10.840
10,5
113.820
muy combustible
Guano en proceso dentro del secador (equivalente seco)
600
6.300
Guano húmedo en playa de recepción (8 m³ × 800 kg/m³)
6.400
2,0
12.800
poco combustible
Producto embolsado en zona 28 (1 turno: 104 bolsas × 25 kg)
2.600
27.300
Bolsas vacías de PE (stock de línea)
102
46,0
4.692
Rechazo de zaranda (plumas y cáscara de huevo)
300
8,0
2.400
combustible
Pallets de madera (10 u × 22 kg)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
