lagzgabrielmuller-dot/planta-secadora-guano/secadora/planos/dxf/SC-05.dxf

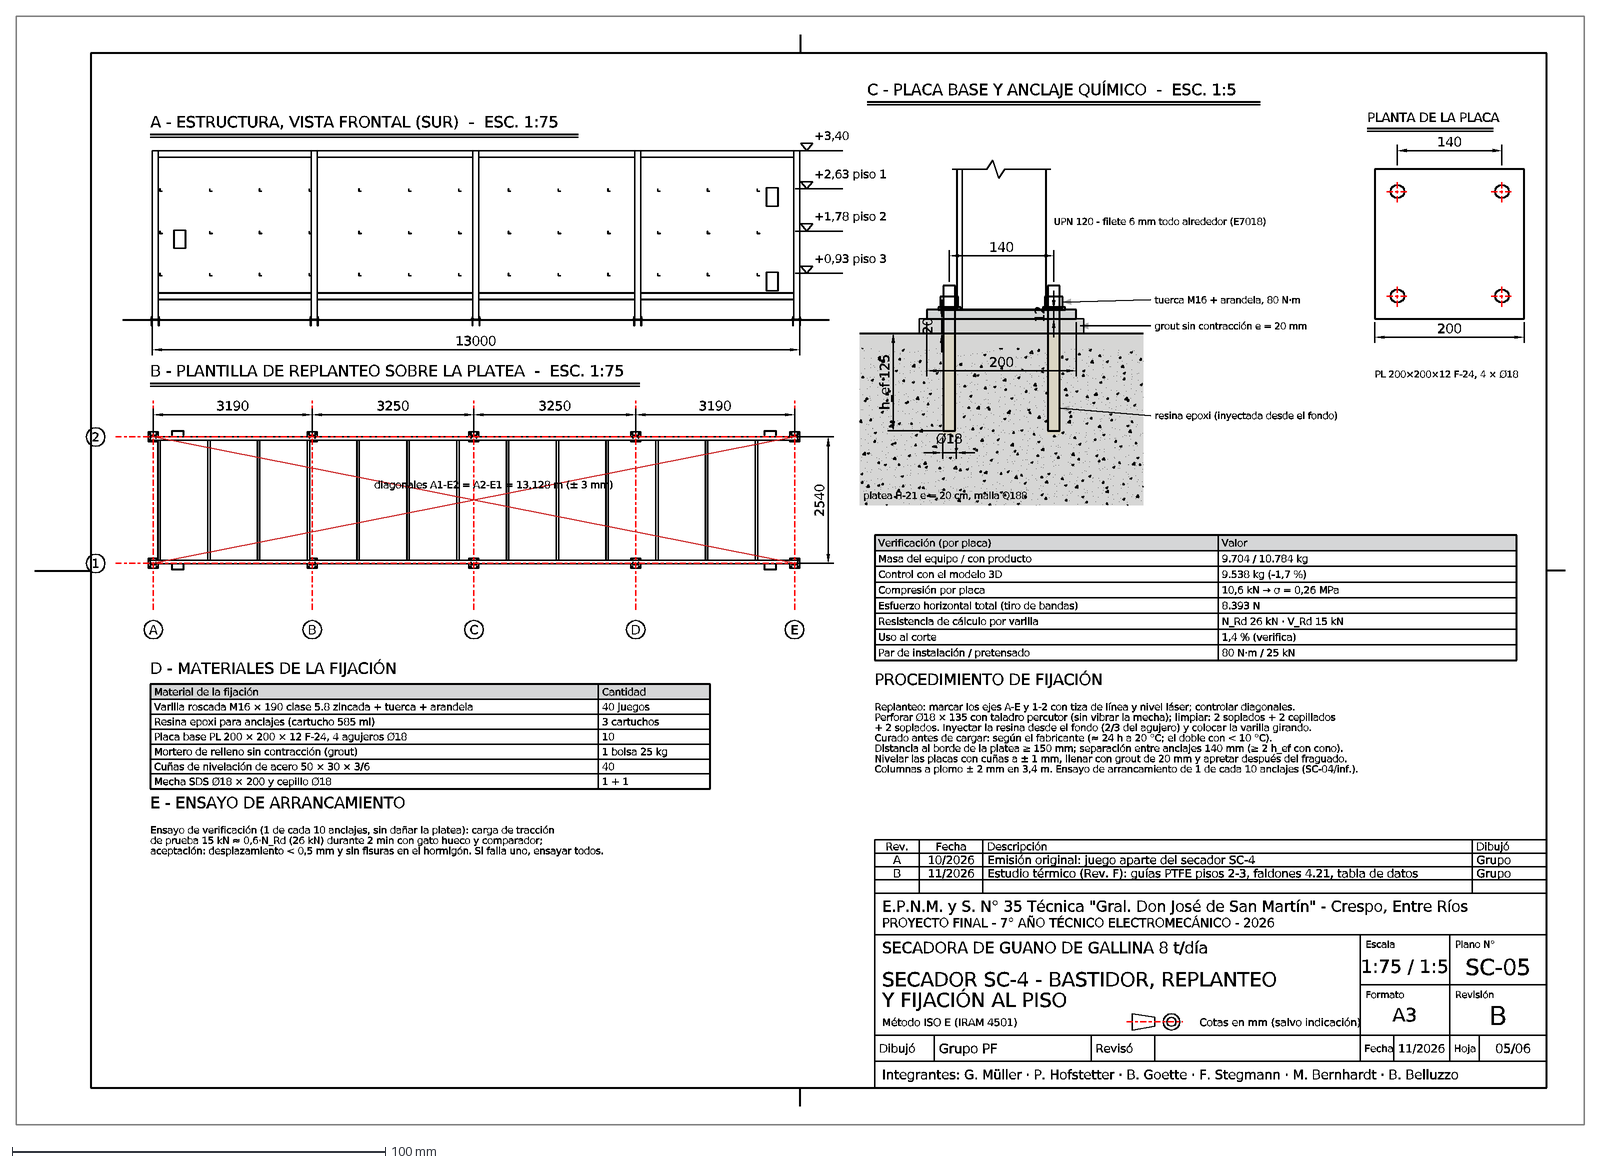
[picture p137: CAD file, 2026-11-11]
secadora/planos/dxf/SC-05.dxf
Integrantes: G. Müller · P. Hofstetter · B. Goette · F. Stegmann · M. Bernhardt · B. Belluzzo
Dibujó
Grupo PF
Revisó
Fecha
11/2026
Hoja
05/06
SECADORA DE GUANO DE GALLINA 8 t/día
SECADOR SC-4 - BASTIDOR, REPLANTEO
Y FIJACIÓN AL PISO
Método ISO E (IRAM 4501)
Cotas en mm (salvo indicación)
Escala
1:75 / 1:5
Formato
A3
Plano N°
SC-05
Revisión
B
E.P.N.M. y S. N° 35 Técnica "Gral. Don José de San Martín" - Crespo, Entre Ríos
PROYECTO FINAL - 7° AÑO TÉCNICO ELECTROMECÁNICO - 2026
Estudio térmico (Rev. F): guías PTFE pisos 2-3, faldones 4.21, tabla de datos
Grupo
A
10/2026
Emisión original: juego aparte del secador SC-4
Rev.
Descripción
A - ESTRUCTURA, VISTA FRONTAL (SUR) - ESC. 1:75
+2,63 piso 1
+1,78 piso 2
+0,93 piso 3
+3,40
13000
B - PLANTILLA DE REPLANTEO SOBRE LA PLATEA - ESC. 1:75
C
D
E
1
2
diagonales A1-E2 = A2-E1 = 13,128 m (± 3 mm)
3190
3250
2540
C - PLACA BASE Y ANCLAJE QUÍMICO - ESC. 1:5
platea H-21 e = 20 cm, malla Q188
UPN 120 - filete 6 mm todo alrededor (E7018)
h_ef 125
Ø18
140
200
20
12
resina epoxi (inyectada desde el fondo)
grout sin contracción e = 20 mm
tuerca M16 + arandela, 80 N·m
PLANTA DE LA PLACA
PL 200×200×12 F-24, 4 × Ø18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
