lagzgabrielmuller-dot/planta-secadora-guano/planos/dxf/P09.dxf

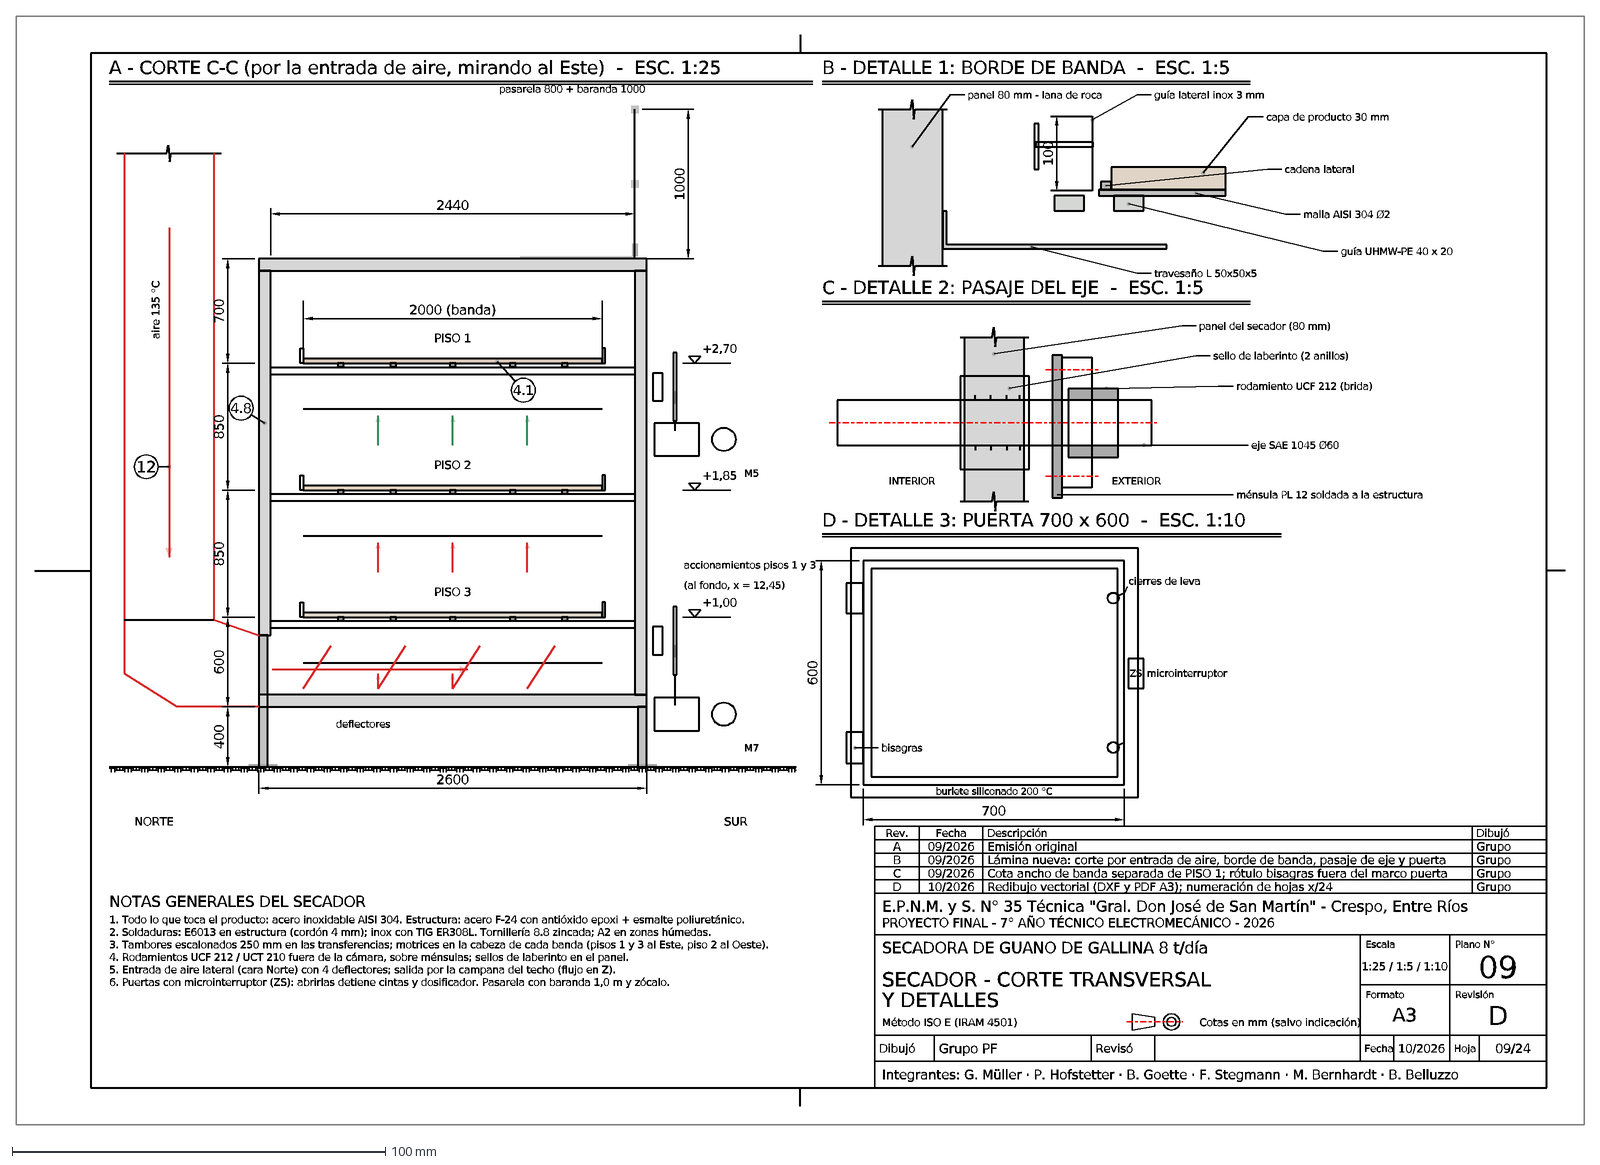
[picture p138: CAD file, 2026-11-11]
planos/dxf/P09.dxf
Integrantes: G. Müller · P. Hofstetter · B. Goette · F. Stegmann · M. Bernhardt · B. Belluzzo
Dibujó
Grupo PF
Revisó
Fecha
10/2026
Hoja
09/24
SECADORA DE GUANO DE GALLINA 8 t/día
SECADOR - CORTE TRANSVERSAL
Y DETALLES
Método ISO E (IRAM 4501)
Cotas en mm (salvo indicación)
Escala
1:25 / 1:5 / 1:10
Formato
A3
Plano N°
09
Revisión
D
E.P.N.M. y S. N° 35 Técnica "Gral. Don José de San Martín" - Crespo, Entre Ríos
PROYECTO FINAL - 7° AÑO TÉCNICO ELECTROMECÁNICO - 2026
Redibujo vectorial (DXF y PDF A3); numeración de hojas x/24
Grupo
C
09/2026
Cota ancho de banda separada de PISO 1; rótulo bisagras fuera del marco puerta
B
Lámina nueva: corte por entrada de aire, borde de banda, pasaje de eje y puerta
A
Emisión original
Rev.
Descripción
A - CORTE C-C (por la entrada de aire, mirando al Este) - ESC. 1:25
PISO 1
PISO 2
PISO 3
2000 (banda)
aire 135 °C
12
deflectores
1000
pasarela 800 + baranda 1000
M5
M7
+2,70
+1,85
+1,00
accionamientos pisos 1 y 3
(al fondo, x = 12,45)
2440
400
600
850
700
2600
4.8
4.1
NORTE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
