lagzgabrielmuller-dot/planta-secadora-guano/secadora/planos/dxf/SC-04.dxf

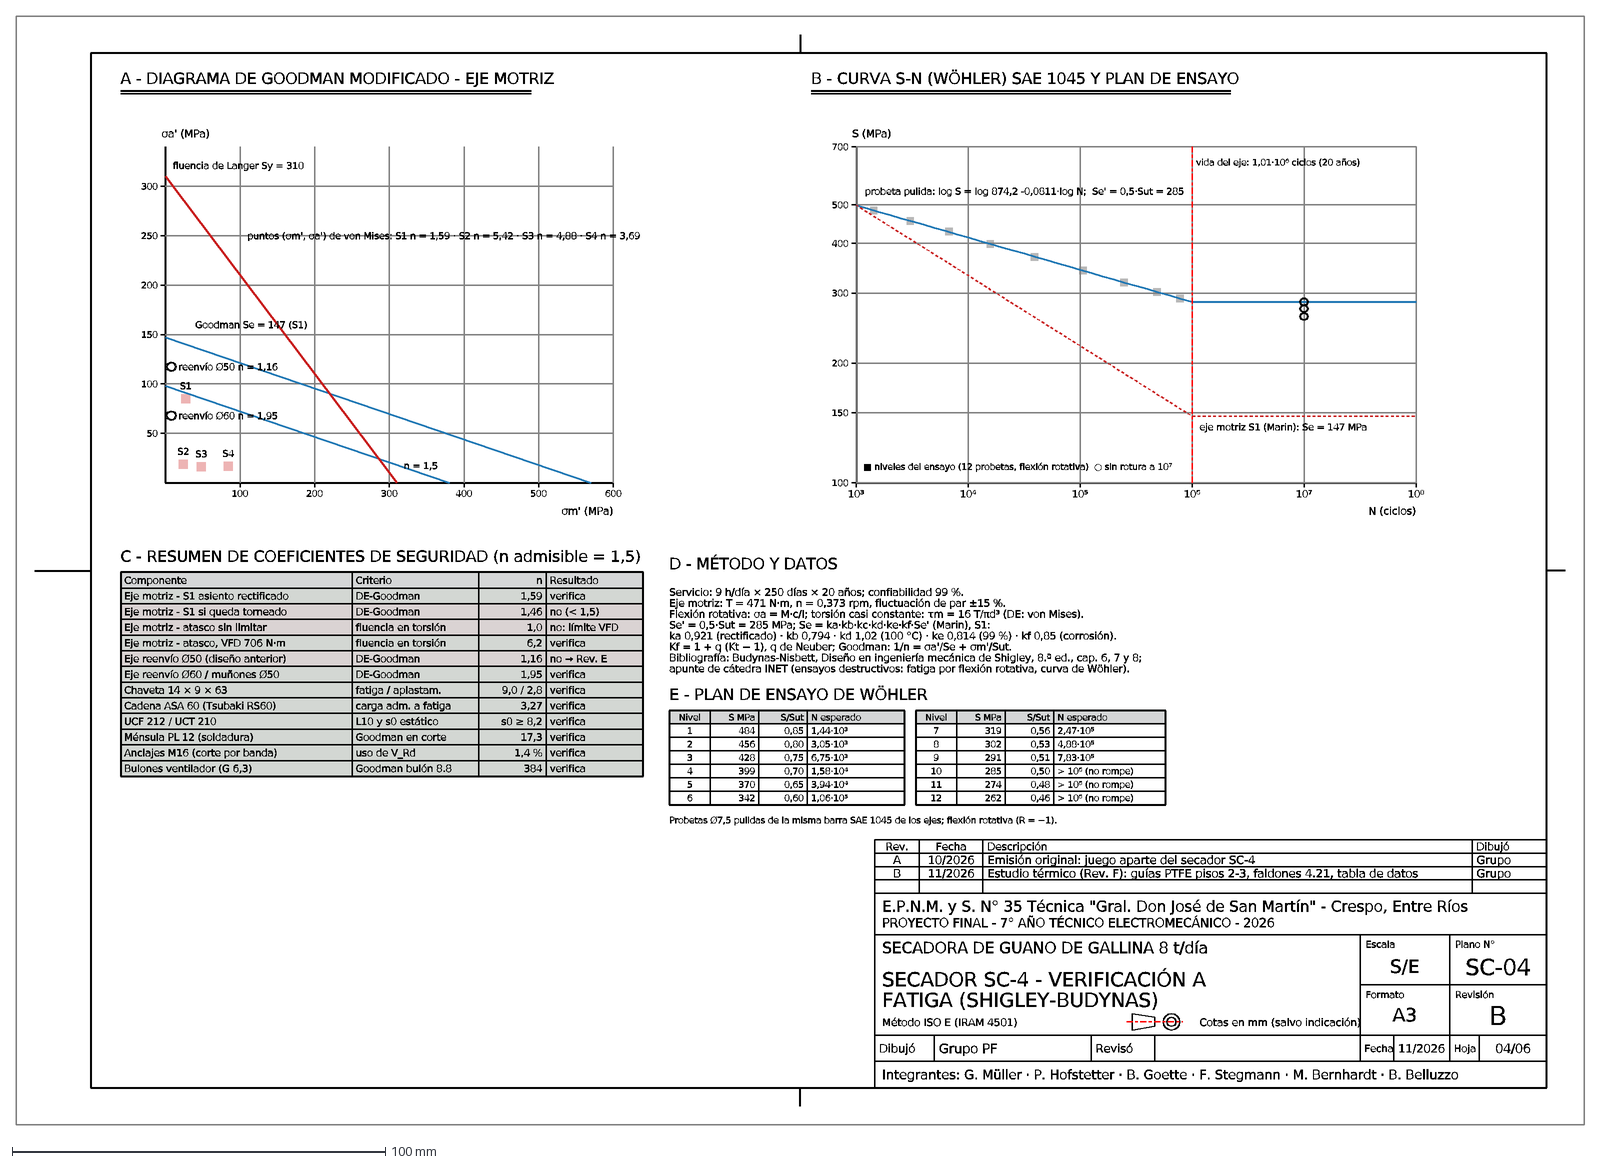
[picture p139: CAD file, 2026-11-11]
secadora/planos/dxf/SC-04.dxf
Integrantes: G. Müller · P. Hofstetter · B. Goette · F. Stegmann · M. Bernhardt · B. Belluzzo
Dibujó
Grupo PF
Revisó
Fecha
11/2026
Hoja
04/06
SECADORA DE GUANO DE GALLINA 8 t/día
SECADOR SC-4 - VERIFICACIÓN A
FATIGA (SHIGLEY-BUDYNAS)
Método ISO E (IRAM 4501)
Cotas en mm (salvo indicación)
Escala
S/E
Formato
A3
Plano N°
SC-04
Revisión
B
E.P.N.M. y S. N° 35 Técnica "Gral. Don José de San Martín" - Crespo, Entre Ríos
PROYECTO FINAL - 7° AÑO TÉCNICO ELECTROMECÁNICO - 2026
Estudio térmico (Rev. F): guías PTFE pisos 2-3, faldones 4.21, tabla de datos
Grupo
A
10/2026
Emisión original: juego aparte del secador SC-4
Rev.
Descripción
A - DIAGRAMA DE GOODMAN MODIFICADO - EJE MOTRIZ
σm' (MPa)
σa' (MPa)
100
200
300
400
500
600
50
150
250
Goodman Se = 147 (S1)
n = 1,5
fluencia de Langer Sy = 310
S1
S2
S3
S4
puntos (σm', σa') de von Mises: S1 n = 1,59 · S2 n = 5,42 · S3 n = 4,88 · S4 n = 3,69
reenvío Ø50 n = 1,16
reenvío Ø60 n = 1,95
B - CURVA S-N (WÖHLER) SAE 1045 Y PLAN DE ENSAYO
N (ciclos)
S (MPa)
10³
10⁴
10⁵
10⁶
10⁷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
