lagzgabrielmuller-dot/planta-secadora-guano/planos/dxf/P01.dxf

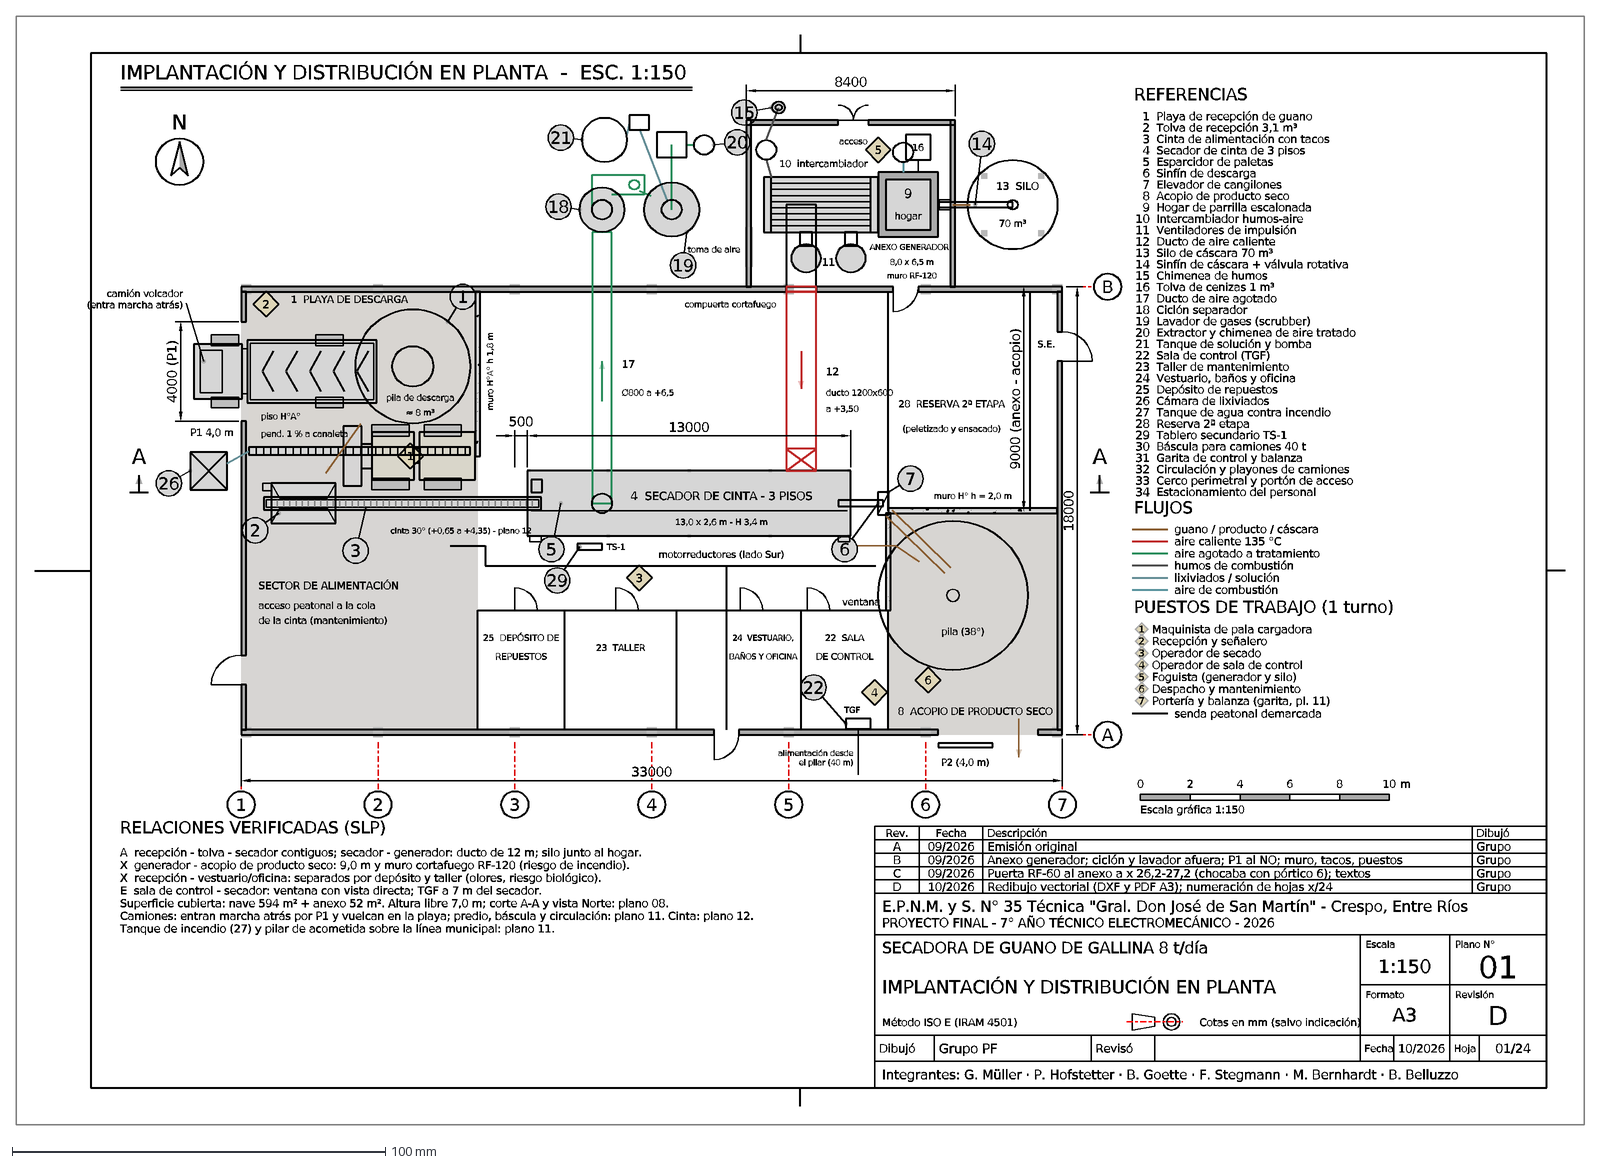
[picture p140: CAD file, 2026-11-11]
planos/dxf/P01.dxf
Integrantes: G. Müller · P. Hofstetter · B. Goette · F. Stegmann · M. Bernhardt · B. Belluzzo
Dibujó
Grupo PF
Revisó
Fecha
10/2026
Hoja
01/24
SECADORA DE GUANO DE GALLINA 8 t/día
IMPLANTACIÓN Y DISTRIBUCIÓN EN PLANTA
Método ISO E (IRAM 4501)
Cotas en mm (salvo indicación)
Escala
1:150
Formato
A3
Plano N°
01
Revisión
D
E.P.N.M. y S. N° 35 Técnica "Gral. Don José de San Martín" - Crespo, Entre Ríos
PROYECTO FINAL - 7° AÑO TÉCNICO ELECTROMECÁNICO - 2026
Redibujo vectorial (DXF y PDF A3); numeración de hojas x/24
Grupo
C
09/2026
Puerta RF-60 al anexo a x 26,2-27,2 (chocaba con pórtico 6); textos
B
Anexo generador; ciclón y lavador afuera; P1 al NO; muro, tacos, puestos
A
Emisión original
Rev.
Descripción
IMPLANTACIÓN Y DISTRIBUCIÓN EN PLANTA - ESC. 1:150
N
1
2
3
4
5
6
7
P2 (4,0 m)
ventana
25 DEPÓSITO DE
REPUESTOS
23 TALLER
24 VESTUARIO,
BAÑOS Y OFICINA
22 SALA
DE CONTROL
S.E.
muro H° h = 2,0 m
28 RESERVA 2ª ETAPA
(peletizado y ensacado)
pila (38°)
8 ACOPIO DE PRODUCTO SECO
muro H°A° h 1,8 m
pila de descarga
≈ 8 m³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
