lagzgabrielmuller-dot/planta-secadora-guano/secadora/planos/dxf/SC-02.dxf

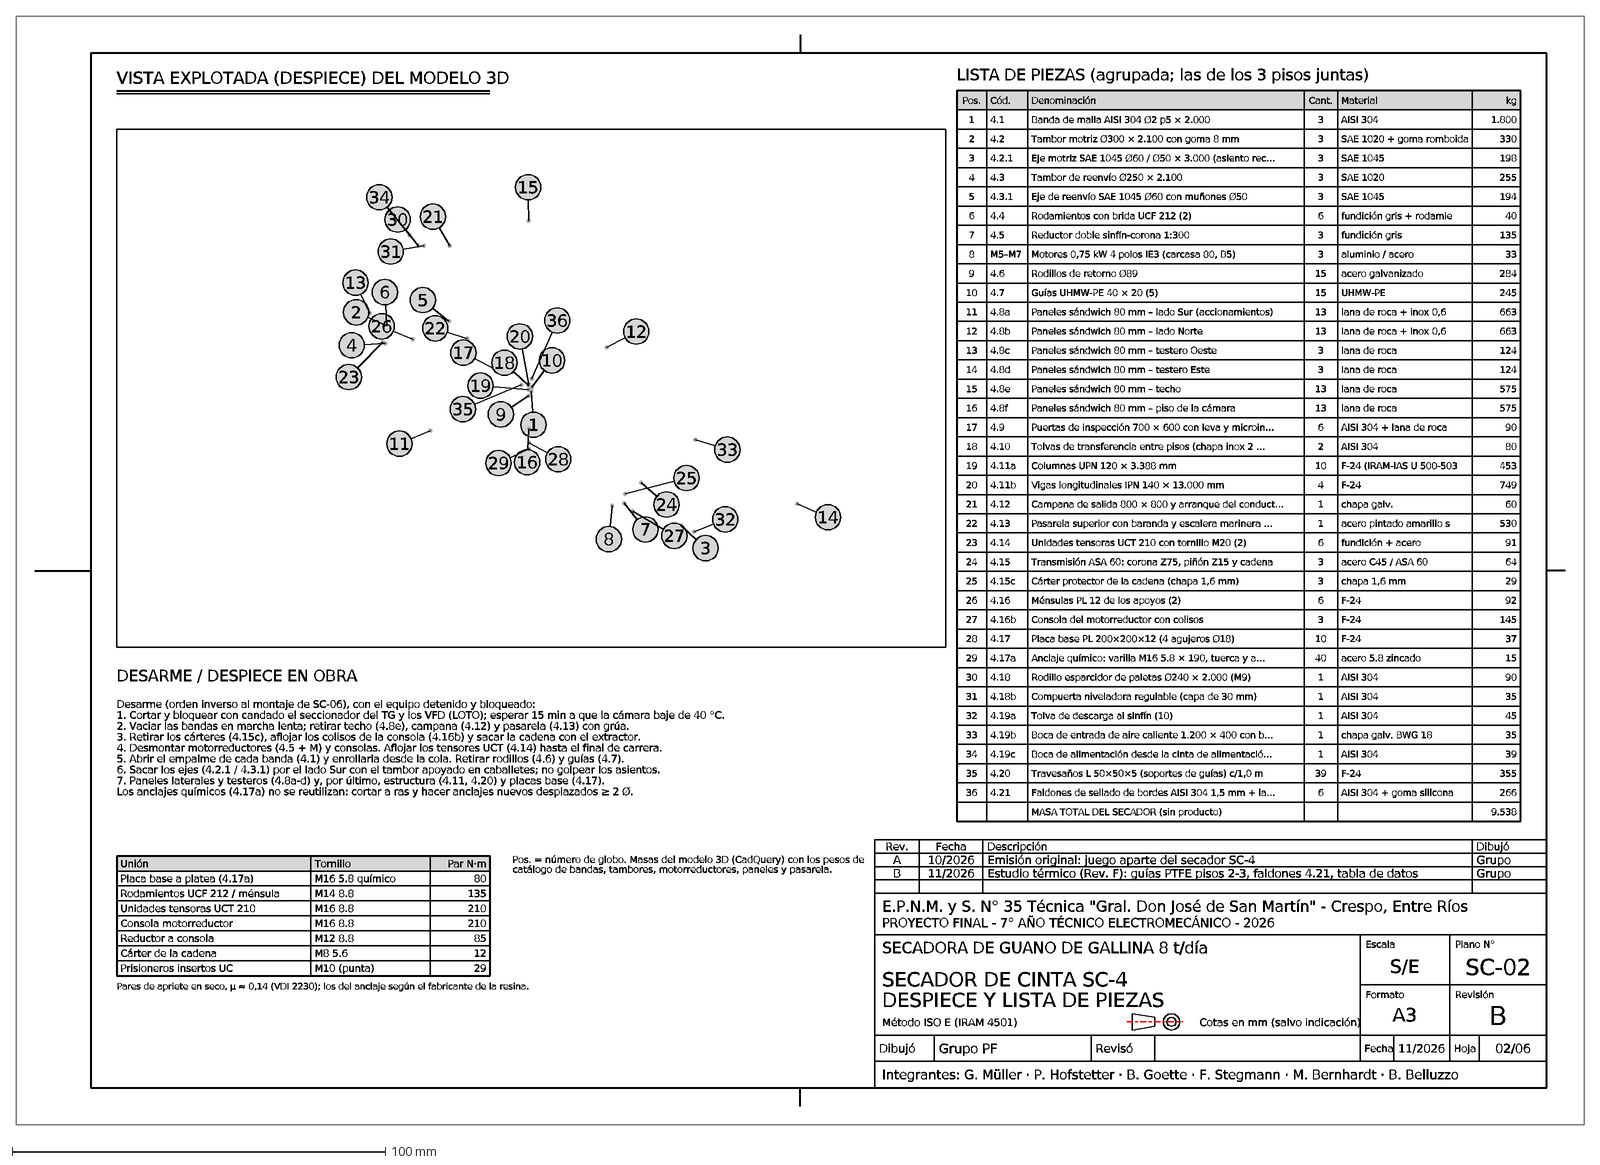
[picture p141: CAD file, 2026-11-11]
secadora/planos/dxf/SC-02.dxf
Integrantes: G. Müller · P. Hofstetter · B. Goette · F. Stegmann · M. Bernhardt · B. Belluzzo
Dibujó
Grupo PF
Revisó
Fecha
11/2026
Hoja
02/06
SECADORA DE GUANO DE GALLINA 8 t/día
SECADOR DE CINTA SC-4
DESPIECE Y LISTA DE PIEZAS
Método ISO E (IRAM 4501)
Cotas en mm (salvo indicación)
Escala
S/E
Formato
A3
Plano N°
SC-02
Revisión
B
E.P.N.M. y S. N° 35 Técnica "Gral. Don José de San Martín" - Crespo, Entre Ríos
PROYECTO FINAL - 7° AÑO TÉCNICO ELECTROMECÁNICO - 2026
Estudio térmico (Rev. F): guías PTFE pisos 2-3, faldones 4.21, tabla de datos
Grupo
A
10/2026
Emisión original: juego aparte del secador SC-4
Rev.
Descripción
VISTA EXPLOTADA (DESPIECE) DEL MODELO 3D
1
2
3
4
5
6
7
8
9
10
11
12
13
14
15
16
17
18
19
20
21
22
23
24
25
26
27
28
29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
