lagzgabrielmuller-dot/planta-secadora-guano/planos/dxf/P02.dxf

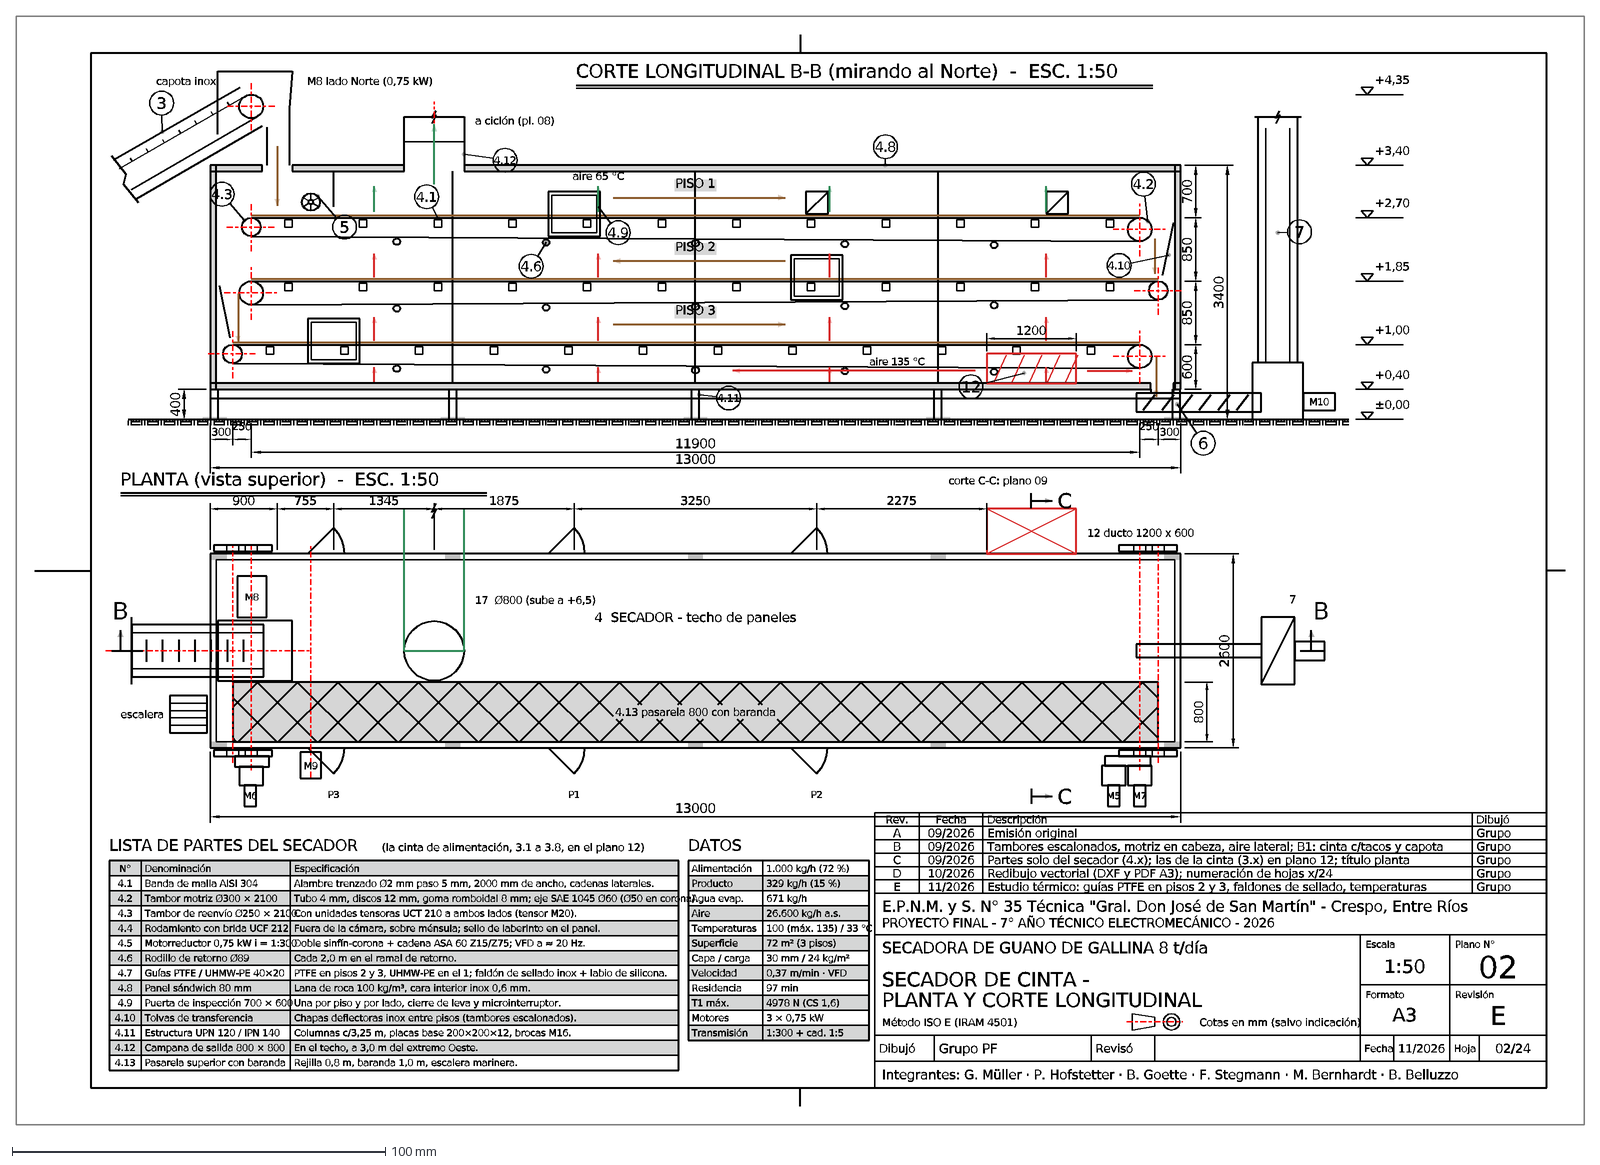
[picture p142: CAD file, 2026-11-11]
planos/dxf/P02.dxf
Integrantes: G. Müller · P. Hofstetter · B. Goette · F. Stegmann · M. Bernhardt · B. Belluzzo
Dibujó
Grupo PF
Revisó
Fecha
11/2026
Hoja
02/24
SECADORA DE GUANO DE GALLINA 8 t/día
SECADOR DE CINTA -
PLANTA Y CORTE LONGITUDINAL
Método ISO E (IRAM 4501)
Cotas en mm (salvo indicación)
Escala
1:50
Formato
A3
Plano N°
02
Revisión
E
E.P.N.M. y S. N° 35 Técnica "Gral. Don José de San Martín" - Crespo, Entre Ríos
PROYECTO FINAL - 7° AÑO TÉCNICO ELECTROMECÁNICO - 2026
Estudio térmico: guías PTFE en pisos 2 y 3, faldones de sellado, temperaturas
Grupo
D
10/2026
Redibujo vectorial (DXF y PDF A3); numeración de hojas x/24
C
09/2026
Partes solo del secador (4.x); las de la cinta (3.x) en plano 12; título planta
B
Tambores escalonados, motriz en cabeza, aire lateral; B1: cinta c/tacos y capota
A
Emisión original
Rev.
Descripción
CORTE LONGITUDINAL B-B (mirando al Norte) - ESC. 1:50
a ciclón (pl. 08)
4.12
capota inox
M8 lado Norte (0,75 kW)
3
aire 135 °C
aire 65 °C
1200
PISO 1
PISO 2
PISO 3
M10
600
850
700
3400
400
300
250
11900
13000
+4,35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
