lagzgabrielmuller-dot/planta-secadora-guano/secadora/planos/dxf/SC-01.dxf

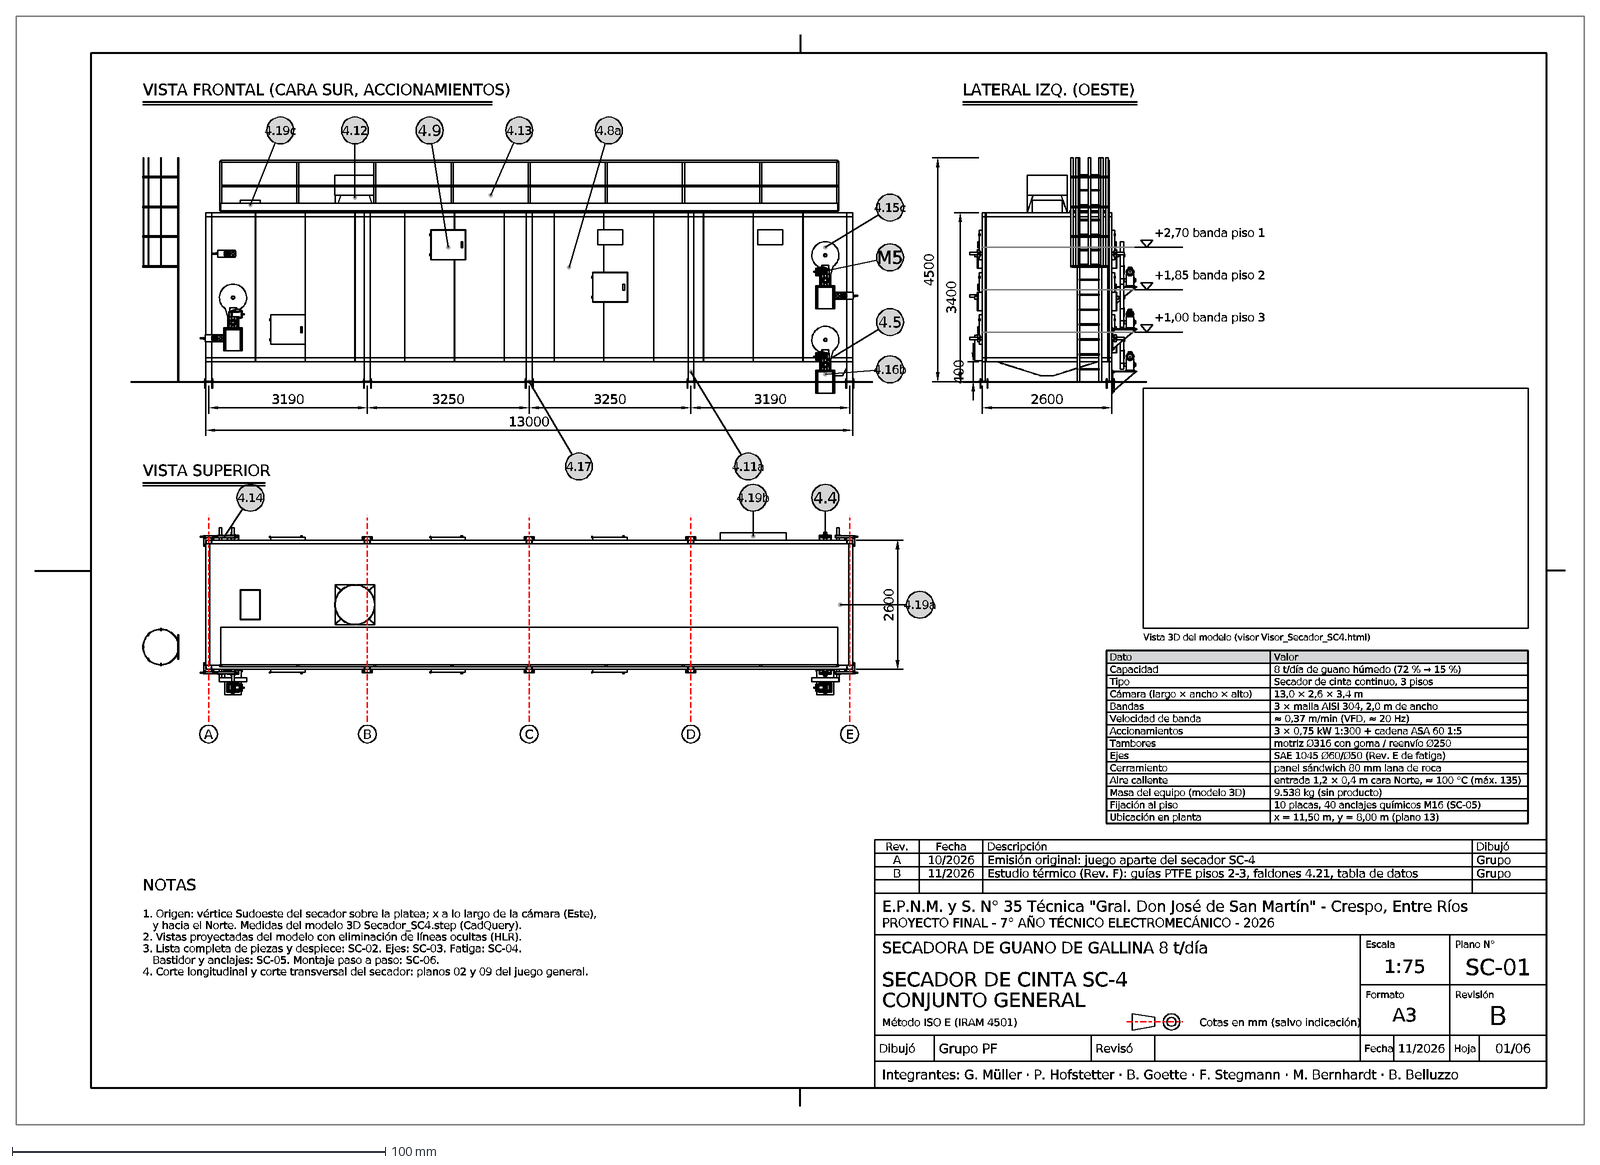
[picture p143: CAD file, 2026-11-11]
secadora/planos/dxf/SC-01.dxf
Integrantes: G. Müller · P. Hofstetter · B. Goette · F. Stegmann · M. Bernhardt · B. Belluzzo
Dibujó
Grupo PF
Revisó
Fecha
11/2026
Hoja
01/06
SECADORA DE GUANO DE GALLINA 8 t/día
SECADOR DE CINTA SC-4
CONJUNTO GENERAL
Método ISO E (IRAM 4501)
Cotas en mm (salvo indicación)
Escala
1:75
Formato
A3
Plano N°
SC-01
Revisión
B
E.P.N.M. y S. N° 35 Técnica "Gral. Don José de San Martín" - Crespo, Entre Ríos
PROYECTO FINAL - 7° AÑO TÉCNICO ELECTROMECÁNICO - 2026
Estudio térmico (Rev. F): guías PTFE pisos 2-3, faldones 4.21, tabla de datos
Grupo
A
10/2026
Emisión original: juego aparte del secador SC-4
Rev.
Descripción
VISTA FRONTAL (CARA SUR, ACCIONAMIENTOS)
VISTA SUPERIOR
LATERAL IZQ. (OESTE)
C
D
E
13000
3190
3250
2600
3400
4500
400
+2,70 banda piso 1
+1,85 banda piso 2
+1,00 banda piso 3
4.13
4.12
4.19c
4.8a
4.9
4.15c
M5
4.5
4.16b
4.11a
4.17
4.19b
4.14
4.4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
