lagzgabrielmuller-dot/planta-secadora-guano/planos/dxf/P03.dxf

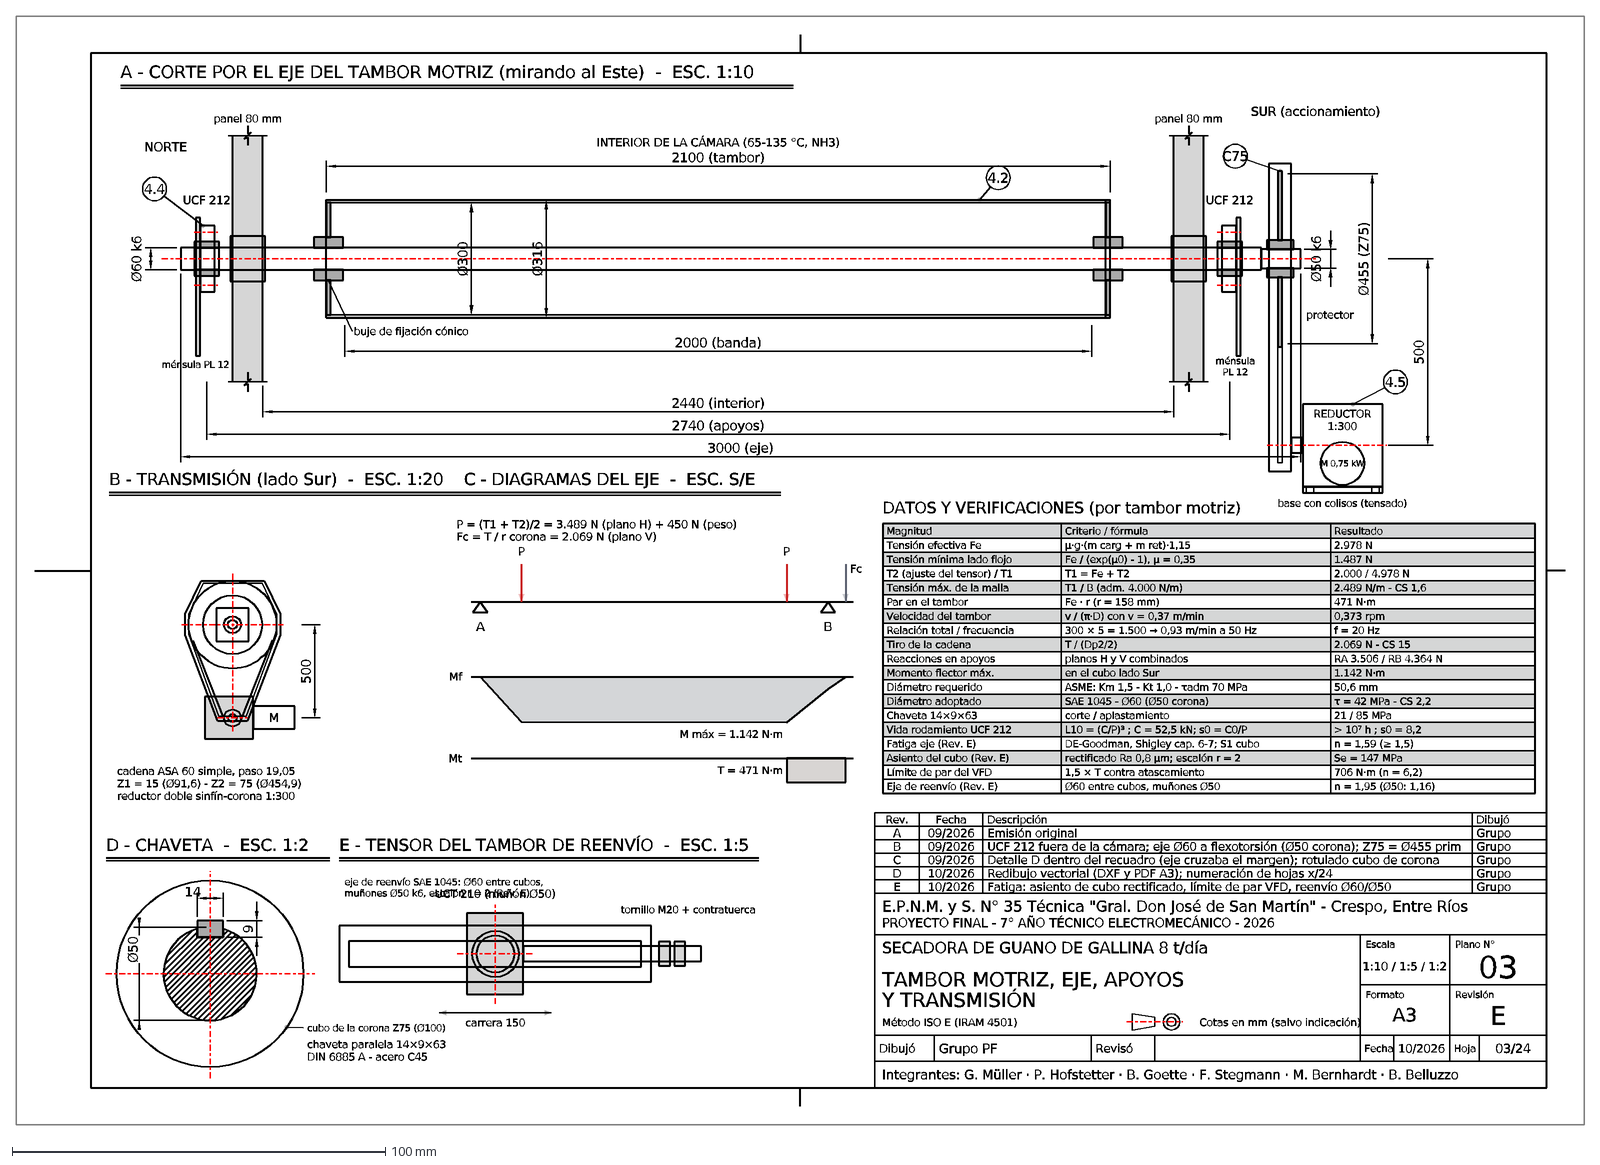
[picture p144: CAD file, 2026-11-11]
planos/dxf/P03.dxf
Integrantes: G. Müller · P. Hofstetter · B. Goette · F. Stegmann · M. Bernhardt · B. Belluzzo
Dibujó
Grupo PF
Revisó
Fecha
10/2026
Hoja
03/24
SECADORA DE GUANO DE GALLINA 8 t/día
TAMBOR MOTRIZ, EJE, APOYOS
Y TRANSMISIÓN
Método ISO E (IRAM 4501)
Cotas en mm (salvo indicación)
Escala
1:10 / 1:5 / 1:2
Formato
A3
Plano N°
03
Revisión
E
E.P.N.M. y S. N° 35 Técnica "Gral. Don José de San Martín" - Crespo, Entre Ríos
PROYECTO FINAL - 7° AÑO TÉCNICO ELECTROMECÁNICO - 2026
Fatiga: asiento de cubo rectificado, límite de par VFD, reenvío Ø60/Ø50
Grupo
D
Redibujo vectorial (DXF y PDF A3); numeración de hojas x/24
C
09/2026
Detalle D dentro del recuadro (eje cruzaba el margen); rotulado cubo de corona
B
UCF 212 fuera de la cámara; eje Ø60 a flexotorsión (Ø50 corona); Z75 = Ø455 prim
A
Emisión original
Rev.
Descripción
A - CORTE POR EL EJE DEL TAMBOR MOTRIZ (mirando al Este) - ESC. 1:10
panel 80 mm
UCF 212
protector
REDUCTOR 1:300
M 0,75 kW
base con colisos (tensado)
NORTE
SUR (accionamiento)
INTERIOR DE LA CÁMARA (65-135 °C, NH3)
ménsula PL 12
buje de fijación cónico
4.4
4.2
C75
4.5
Ø60 k6
Ø50 k6
Ø300
Ø316
Ø455 (Z75)
500
2100 (tambor)
2000 (banda)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
