lagzgabrielmuller-dot/planta-secadora-guano/planos/dxf/P20.dxf

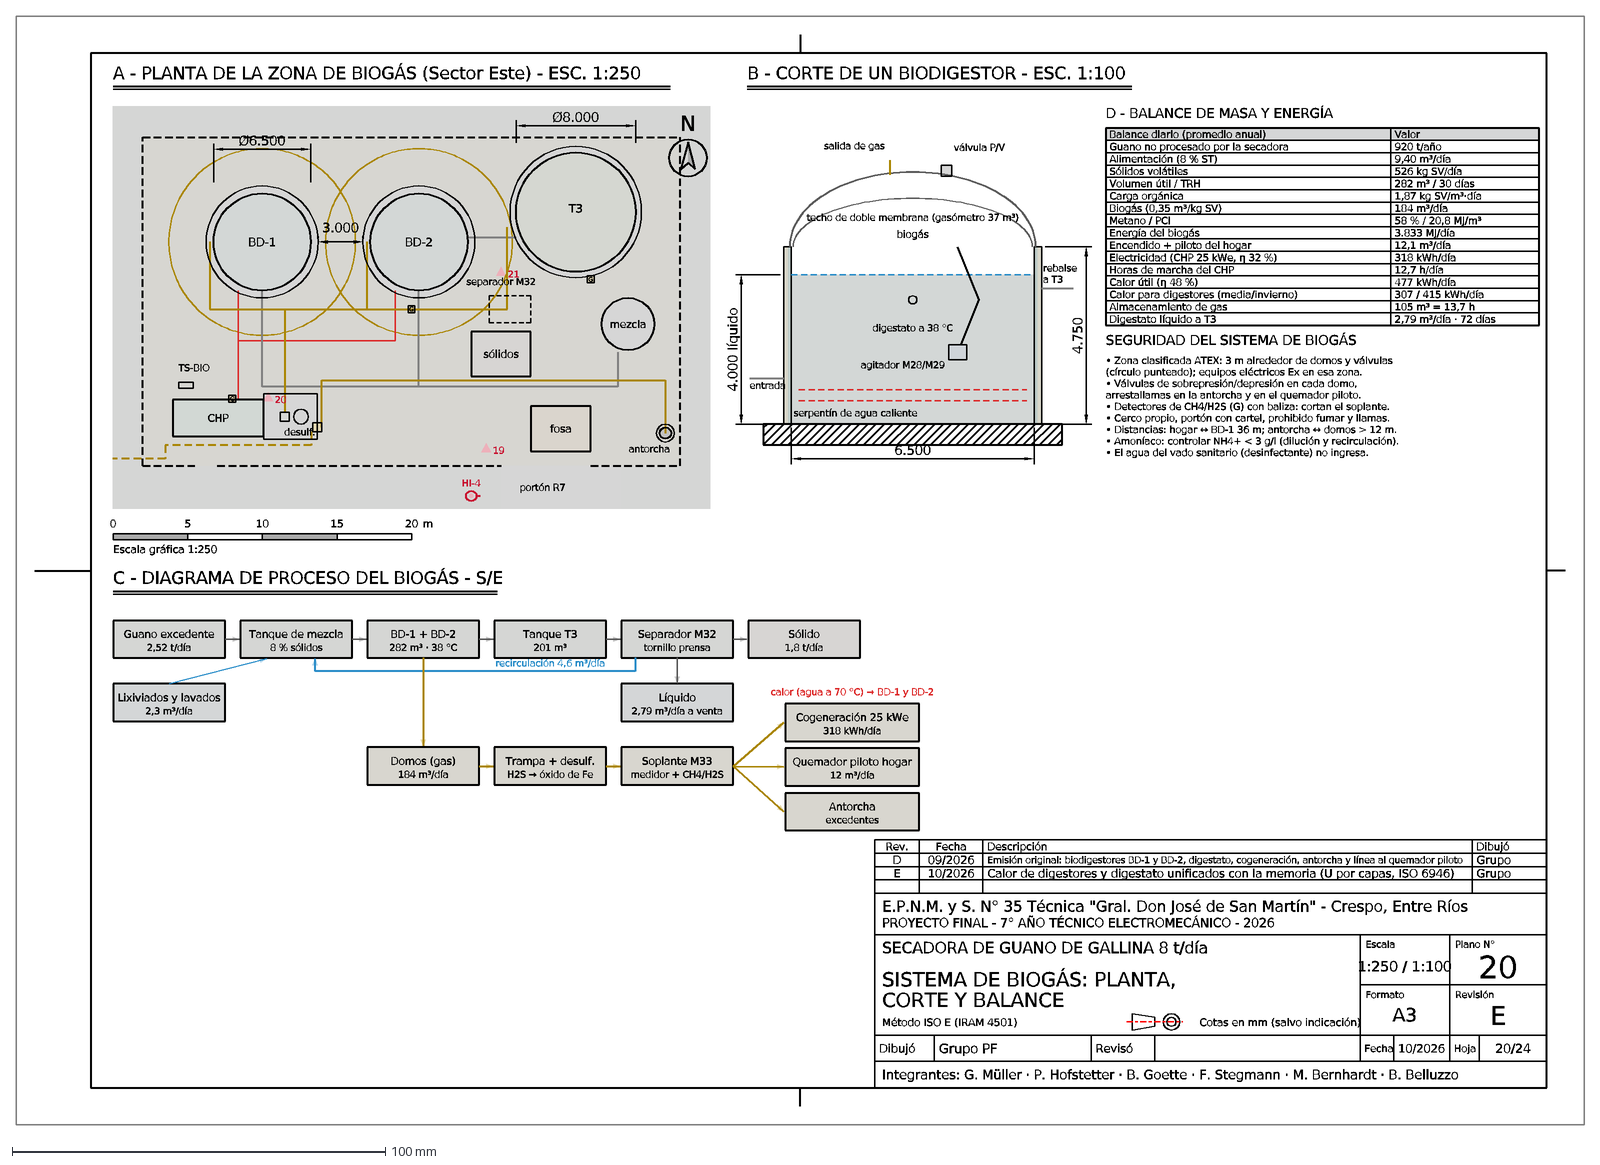
[picture p145: CAD file, 2026-11-11]
planos/dxf/P20.dxf
Integrantes: G. Müller · P. Hofstetter · B. Goette · F. Stegmann · M. Bernhardt · B. Belluzzo
Dibujó
Grupo PF
Revisó
Fecha
10/2026
Hoja
20/24
SECADORA DE GUANO DE GALLINA 8 t/día
SISTEMA DE BIOGÁS: PLANTA,
CORTE Y BALANCE
Método ISO E (IRAM 4501)
Cotas en mm (salvo indicación)
Escala
1:250 / 1:100
Formato
A3
Plano N°
20
Revisión
E
E.P.N.M. y S. N° 35 Técnica "Gral. Don José de San Martín" - Crespo, Entre Ríos
PROYECTO FINAL - 7° AÑO TÉCNICO ELECTROMECÁNICO - 2026
Calor de digestores y digestato unificados con la memoria (U por capas, ISO 6946)
Grupo
D
09/2026
Emisión original: biodigestores BD-1 y BD-2, digestato, cogeneración, antorcha y línea al quemador piloto
Rev.
Descripción
A - PLANTA DE LA ZONA DE BIOGÁS (Sector Este) - ESC. 1:250
portón R7
BD-1
BD-2
T3
mezcla
sólidos
fosa
separador M32
desulf.
CHP
TS-BIO
antorcha
G
19
21
HI-4
Ø6.500
3.000
Ø8.000
N
0
5
10
15
m
Escala gráfica 1:250
B - CORTE DE UN BIODIGESTOR - ESC. 1:100
serpentín de agua caliente
agitador M28/M29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
