lagzgabrielmuller-dot/planta-secadora-guano/planos/dxf/P24.dxf

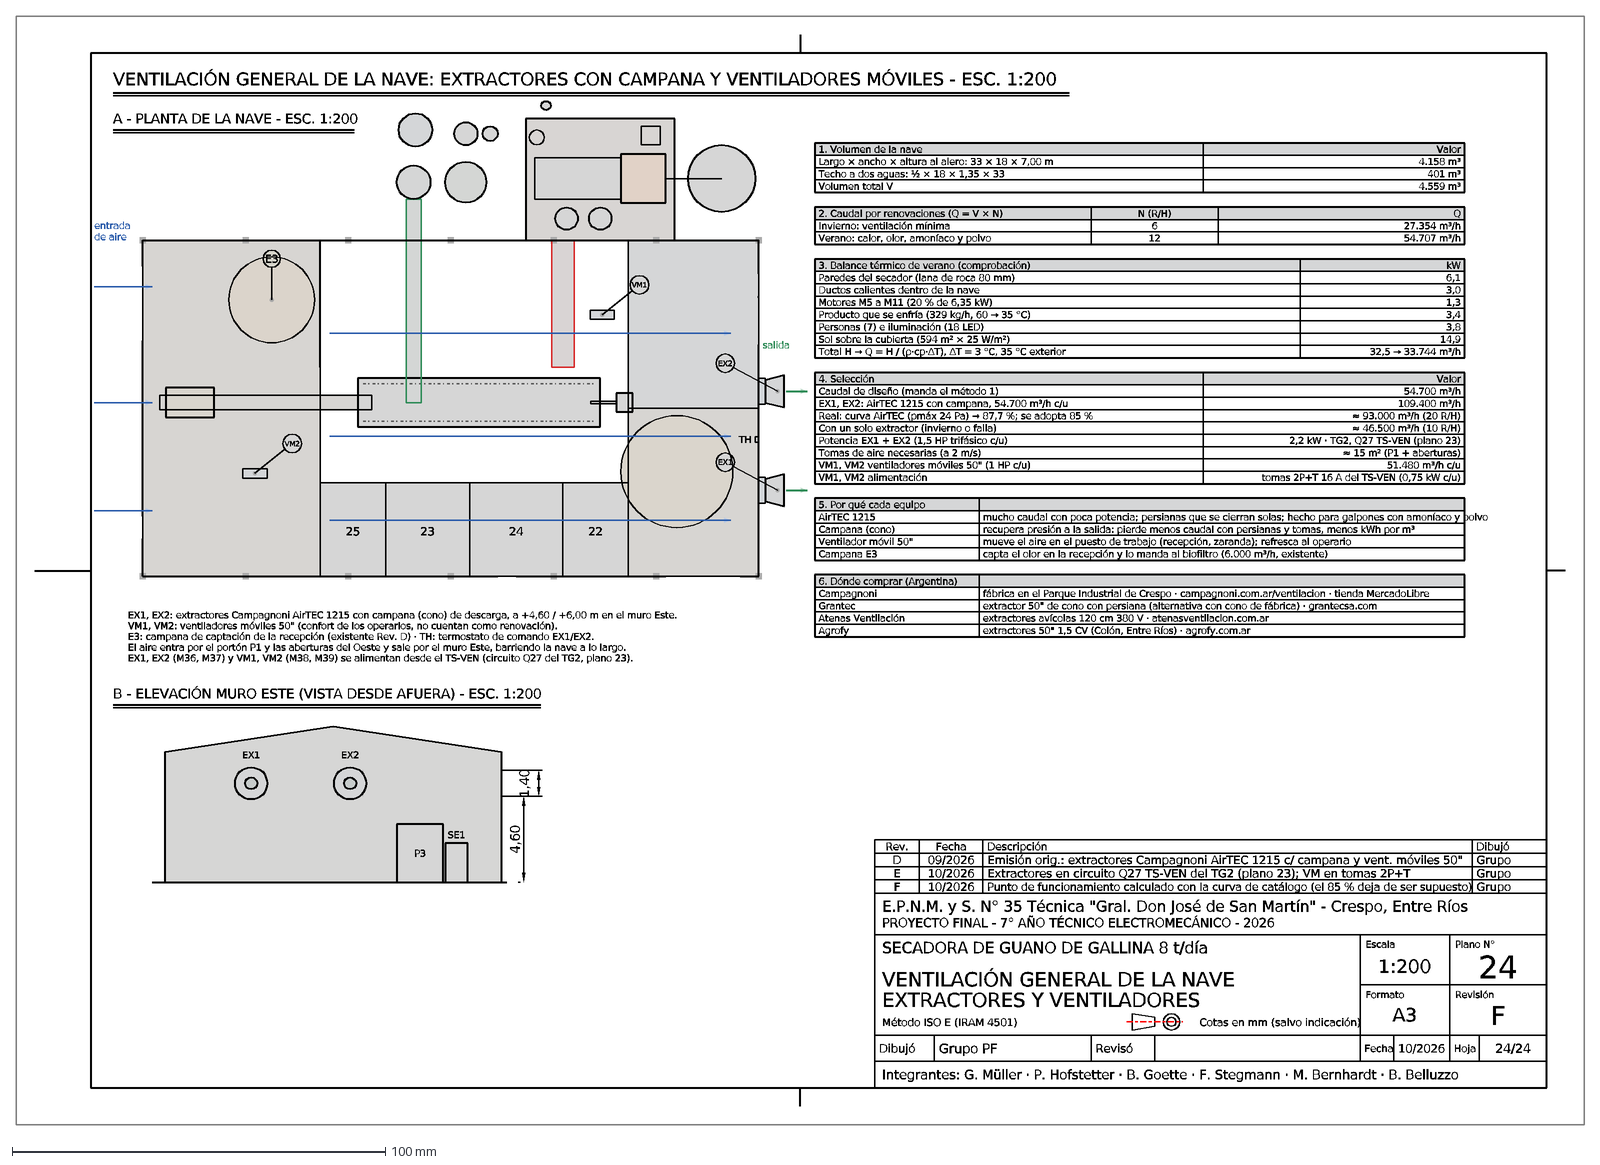
[picture p146: CAD file, 2026-11-11]
planos/dxf/P24.dxf
Integrantes: G. Müller · P. Hofstetter · B. Goette · F. Stegmann · M. Bernhardt · B. Belluzzo
Dibujó
Grupo PF
Revisó
Fecha
10/2026
Hoja
24/24
SECADORA DE GUANO DE GALLINA 8 t/día
VENTILACIÓN GENERAL DE LA NAVE
EXTRACTORES Y VENTILADORES
Método ISO E (IRAM 4501)
Cotas en mm (salvo indicación)
Escala
1:200
Formato
A3
Plano N°
24
Revisión
F
E.P.N.M. y S. N° 35 Técnica "Gral. Don José de San Martín" - Crespo, Entre Ríos
PROYECTO FINAL - 7° AÑO TÉCNICO ELECTROMECÁNICO - 2026
Punto de funcionamiento calculado con la curva de catálogo (el 85 % deja de ser supuesto)
Grupo
E
Extractores en circuito Q27 TS-VEN del TG2 (plano 23); VM en tomas 2P+T
D
09/2026
Emisión orig.: extractores Campagnoni AirTEC 1215 c/ campana y vent. móviles 50"
Rev.
Descripción
VENTILACIÓN GENERAL DE LA NAVE: EXTRACTORES CON CAMPANA Y VENTILADORES MÓVILES - ESC. 1:200
A - PLANTA DE LA NAVE - ESC. 1:200
25
23
22
TH
EX1
EX2
salida
VM1
VM2
E3
entrada de aire
EX1, EX2: extractores Campagnoni AirTEC 1215 con campana (cono) de descarga, a +4,60 / +6,00 m en el muro Este.
VM1, VM2: ventiladores móviles 50" (confort de los operarios, no cuentan como renovación).
E3: campana de captación de la recepción (existente Rev. D) · TH: termostato de comando EX1/EX2.
El aire entra por el portón P1 y las aberturas del Oeste y sale por el muro Este, barriendo la nave a lo largo.
EX1, EX2 (M36, M37) y VM1, VM2 (M38, M39) se alimentan desde el TS-VEN (circuito Q27 del TG2, plano 23).
B - ELEVACIÓN MURO ESTE (VISTA DESDE AFUERA) - ESC. 1:200
P3
SE1
4,60
1,40
1. Volumen de la nave
Valor
Largo × ancho × altura al alero: 33 × 18 × 7,00 m
4.158 m³
Techo a dos aguas: ½ × 18 × 1,35 × 33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
