lagzgabrielmuller-dot/planta-secadora-guano/planos/dxf/P14.dxf

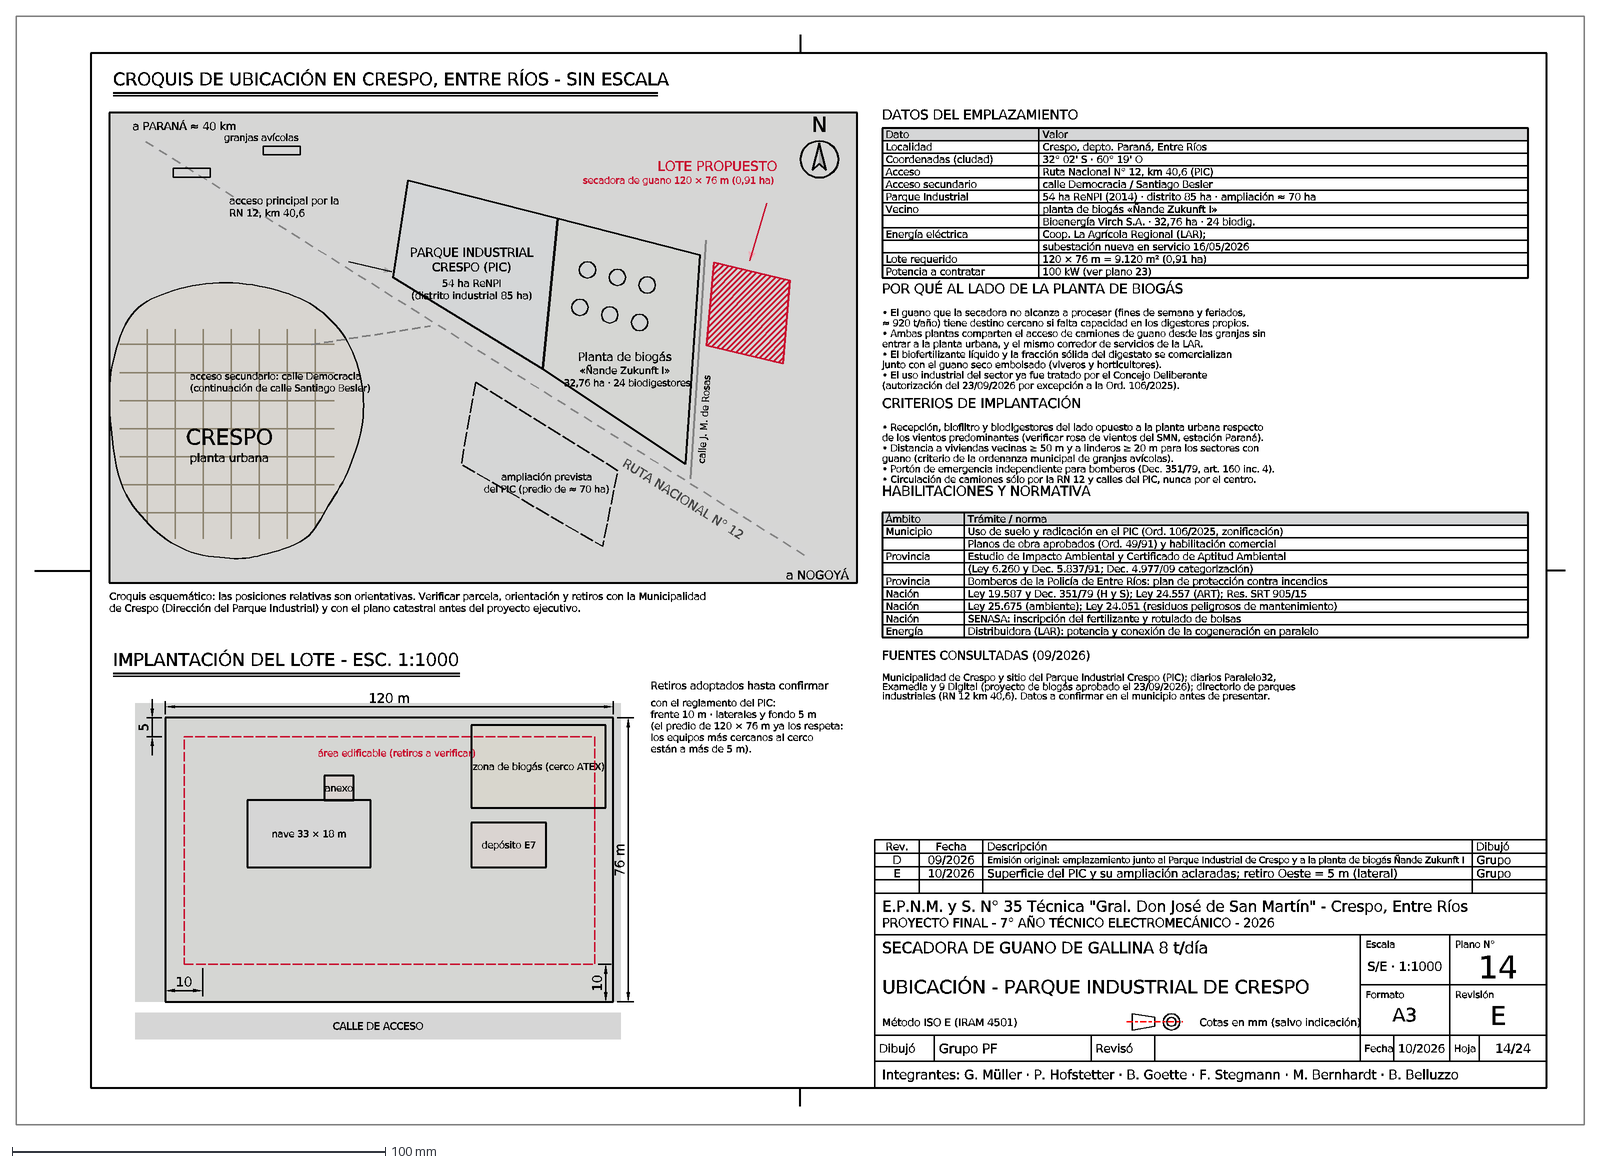
[picture p147: CAD file, 2026-11-11]
planos/dxf/P14.dxf
Integrantes: G. Müller · P. Hofstetter · B. Goette · F. Stegmann · M. Bernhardt · B. Belluzzo
Dibujó
Grupo PF
Revisó
Fecha
10/2026
Hoja
14/24
SECADORA DE GUANO DE GALLINA 8 t/día
UBICACIÓN - PARQUE INDUSTRIAL DE CRESPO
Método ISO E (IRAM 4501)
Cotas en mm (salvo indicación)
Escala
S/E · 1:1000
Formato
A3
Plano N°
14
Revisión
E
E.P.N.M. y S. N° 35 Técnica "Gral. Don José de San Martín" - Crespo, Entre Ríos
PROYECTO FINAL - 7° AÑO TÉCNICO ELECTROMECÁNICO - 2026
Superficie del PIC y su ampliación aclaradas; retiro Oeste = 5 m (lateral)
Grupo
D
09/2026
Emisión original: emplazamiento junto al Parque Industrial de Crespo y a la planta de biogás Ñande Zukunft I
Rev.
Descripción
CROQUIS DE UBICACIÓN EN CRESPO, ENTRE RÍOS - SIN ESCALA
CRESPO
planta urbana
ampliación prevista
del PIC (predio de ≈ 70 ha)
PARQUE INDUSTRIAL
CRESPO (PIC)
54 ha ReNPI
(distrito industrial 85 ha)
Planta de biogás
«Ñande Zukunft I»
32,76 ha · 24 biodigestores
RUTA NACIONAL N° 12
a PARANÁ ≈ 40 km
a NOGOYÁ
granjas avícolas
acceso principal por la
RN 12, km 40,6
acceso secundario: calle Democracia
(continuación de calle Santiago Besler)
calle J. M. de Rosas
LOTE PROPUESTO
secadora de guano 120 × 76 m (0,91 ha)
N
Croquis esquemático: las posiciones relativas son orientativas. Verificar parcela, orientación y retiros con la Municipalidad de Crespo (Dirección del Parque In
IMPLANTACIÓN DEL LOTE - ESC. 1:1000
CALLE DE ACCESO
área edificable (retiros a verificar)
nave 33 × 18 m
anexo
depósito E7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
