lagzgabrielmuller-dot/planta-secadora-guano/planos/dxf/P04.dxf

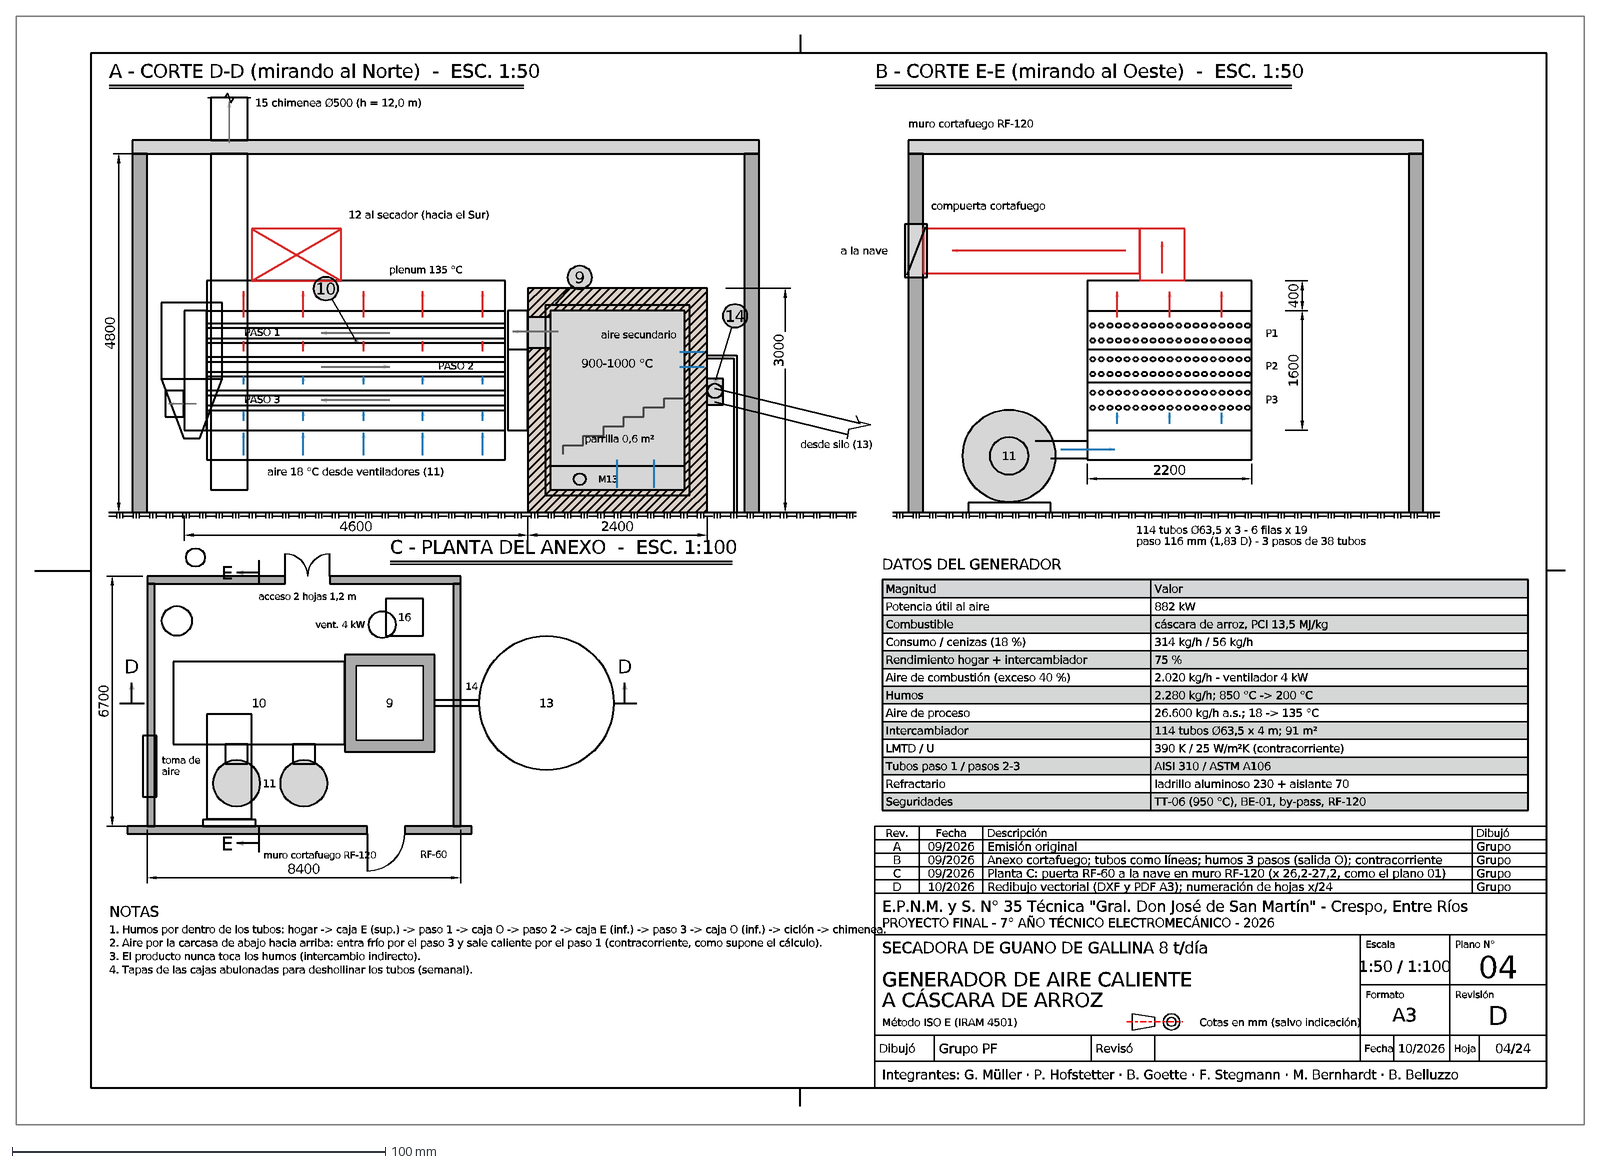
[picture p148: CAD file, 2026-11-11]
planos/dxf/P04.dxf
Integrantes: G. Müller · P. Hofstetter · B. Goette · F. Stegmann · M. Bernhardt · B. Belluzzo
Dibujó
Grupo PF
Revisó
Fecha
10/2026
Hoja
04/24
SECADORA DE GUANO DE GALLINA 8 t/día
GENERADOR DE AIRE CALIENTE
A CÁSCARA DE ARROZ
Método ISO E (IRAM 4501)
Cotas en mm (salvo indicación)
Escala
1:50 / 1:100
Formato
A3
Plano N°
04
Revisión
D
E.P.N.M. y S. N° 35 Técnica "Gral. Don José de San Martín" - Crespo, Entre Ríos
PROYECTO FINAL - 7° AÑO TÉCNICO ELECTROMECÁNICO - 2026
Redibujo vectorial (DXF y PDF A3); numeración de hojas x/24
Grupo
C
09/2026
Planta C: puerta RF-60 a la nave en muro RF-120 (x 26,2-27,2, como el plano 01)
B
Anexo cortafuego; tubos como líneas; humos 3 pasos (salida O); contracorriente
A
Emisión original
Rev.
Descripción
A - CORTE D-D (mirando al Norte) - ESC. 1:50
15 chimenea Ø500 (h = 12,0 m)
PASO 1
PASO 2
PASO 3
aire 18 °C desde ventiladores (11)
plenum 135 °C
12 al secador (hacia el Sur)
10
M13
parrilla 0,6 m²
900-1000 °C
aire secundario
9
desde silo (13)
14
4800
4600
2400
3000
B - CORTE E-E (mirando al Oeste) - ESC. 1:50
muro cortafuego RF-120
P1
P2
P3
400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
