lagzgabrielmuller-dot/planta-secadora-guano/planos/dxf/P12.dxf

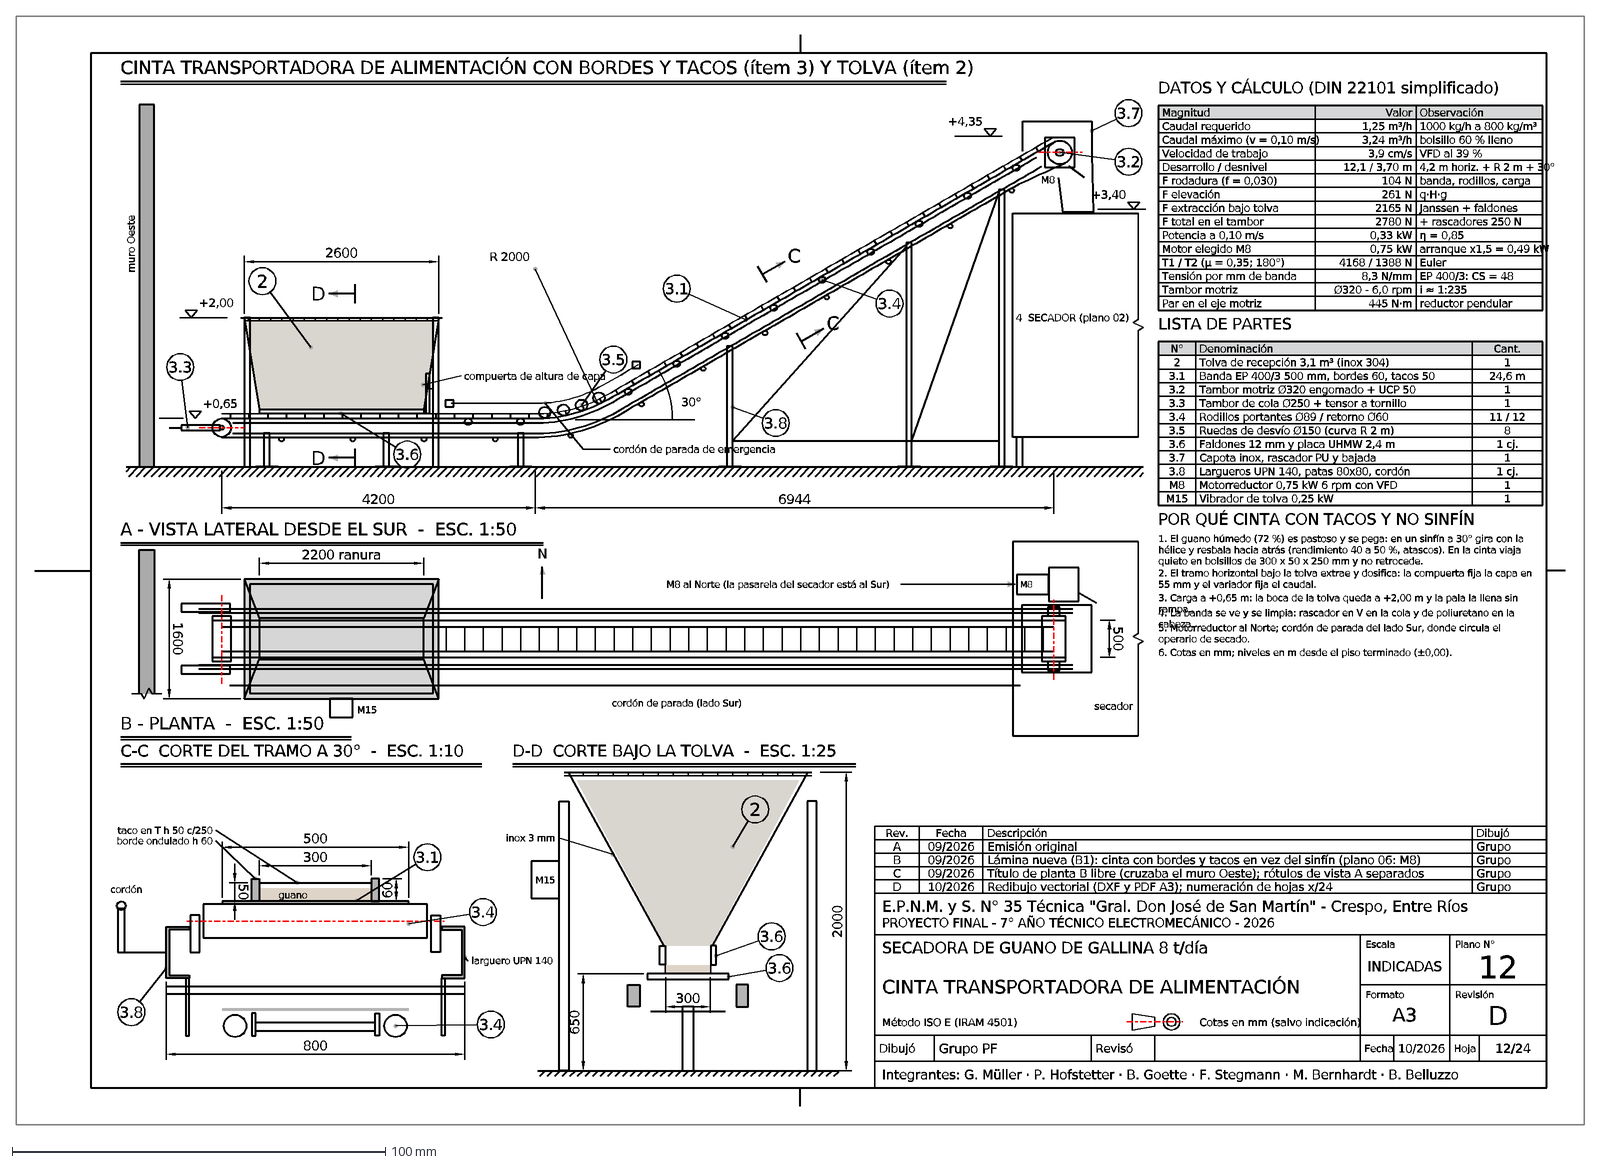
[picture p149: CAD file, 2026-11-11]
planos/dxf/P12.dxf
Integrantes: G. Müller · P. Hofstetter · B. Goette · F. Stegmann · M. Bernhardt · B. Belluzzo
Dibujó
Grupo PF
Revisó
Fecha
10/2026
Hoja
12/24
SECADORA DE GUANO DE GALLINA 8 t/día
CINTA TRANSPORTADORA DE ALIMENTACIÓN
Método ISO E (IRAM 4501)
Cotas en mm (salvo indicación)
Escala
INDICADAS
Formato
A3
Plano N°
12
Revisión
D
E.P.N.M. y S. N° 35 Técnica "Gral. Don José de San Martín" - Crespo, Entre Ríos
PROYECTO FINAL - 7° AÑO TÉCNICO ELECTROMECÁNICO - 2026
Redibujo vectorial (DXF y PDF A3); numeración de hojas x/24
Grupo
C
09/2026
Título de planta B libre (cruzaba el muro Oeste); rótulos de vista A separados
B
Lámina nueva (B1): cinta con bordes y tacos en vez del sinfín (plano 06: M8)
A
Emisión original
Rev.
Descripción
CINTA TRANSPORTADORA DE ALIMENTACIÓN CON BORDES Y TACOS (ítem 3) Y TOLVA (ítem 2)
muro Oeste
M8
4 SECADOR (plano 02)
+0,65
+2,00
+4,35
+3,40
R 2000
30°
4200
6944
2600
compuerta de altura de capa
cordón de parada de emergencia
2
3.3
3.5
3.6
3.1
3.4
3.8
3.7
3.2
A - VISTA LATERAL DESDE EL SUR - ESC. 1:50
M8 al Norte (la pasarela del secador está al Sur)
M15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
