lagzgabrielmuller-dot/planta-secadora-guano/planos/dxf/P22.dxf

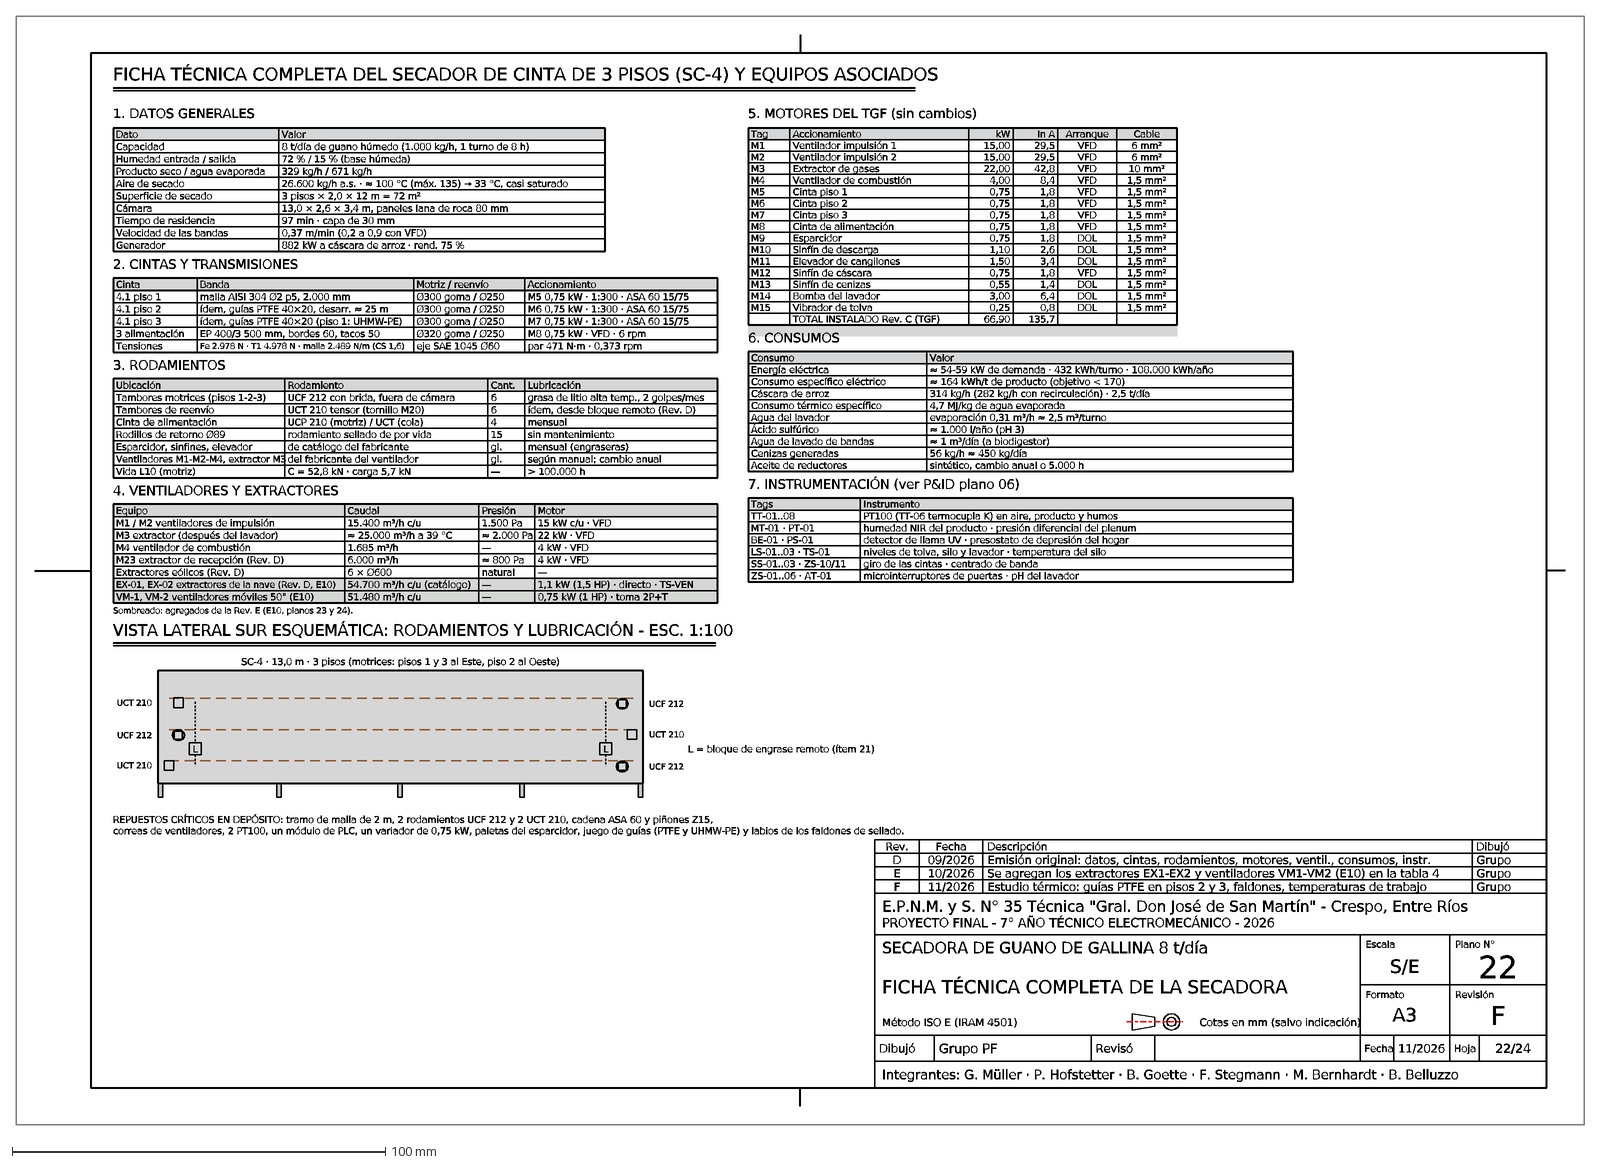
[picture p150: CAD file, 2026-11-11]
planos/dxf/P22.dxf
Integrantes: G. Müller · P. Hofstetter · B. Goette · F. Stegmann · M. Bernhardt · B. Belluzzo
Dibujó
Grupo PF
Revisó
Fecha
11/2026
Hoja
22/24
SECADORA DE GUANO DE GALLINA 8 t/día
FICHA TÉCNICA COMPLETA DE LA SECADORA
Método ISO E (IRAM 4501)
Cotas en mm (salvo indicación)
Escala
S/E
Formato
A3
Plano N°
22
Revisión
F
E.P.N.M. y S. N° 35 Técnica "Gral. Don José de San Martín" - Crespo, Entre Ríos
PROYECTO FINAL - 7° AÑO TÉCNICO ELECTROMECÁNICO - 2026
Estudio térmico: guías PTFE en pisos 2 y 3, faldones, temperaturas de trabajo
Grupo
E
10/2026
Se agregan los extractores EX1-EX2 y ventiladores VM1-VM2 (E10) en la tabla 4
D
09/2026
Emisión original: datos, cintas, rodamientos, motores, ventil., consumos, instr.
Rev.
Descripción
FICHA TÉCNICA COMPLETA DEL SECADOR DE CINTA DE 3 PISOS (SC-4) Y EQUIPOS ASOCIADOS
1. DATOS GENERALES
Dato
Valor
Capacidad
8 t/día de guano húmedo (1.000 kg/h, 1 turno de 8 h)
Humedad entrada / salida
72 % / 15 % (base húmeda)
Producto seco / agua evaporada
329 kg/h / 671 kg/h
Aire de secado
26.600 kg/h a.s. · ≈ 100 °C (máx. 135) → 33 °C, casi saturado
Superficie de secado
3 pisos × 2,0 × 12 m = 72 m²
Cámara
13,0 × 2,6 × 3,4 m, paneles lana de roca 80 mm
Tiempo de residencia
97 min · capa de 30 mm
Velocidad de las bandas
0,37 m/min (0,2 a 0,9 con VFD)
Generador
882 kW a cáscara de arroz · rend. 75 %
2. CINTAS Y TRANSMISIONES
Cinta
Banda
Motriz / reenvío
Accionamiento
4.1 piso 1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
