lagzgabrielmuller-dot/planta-secadora-guano/planos/dxf/P13.dxf

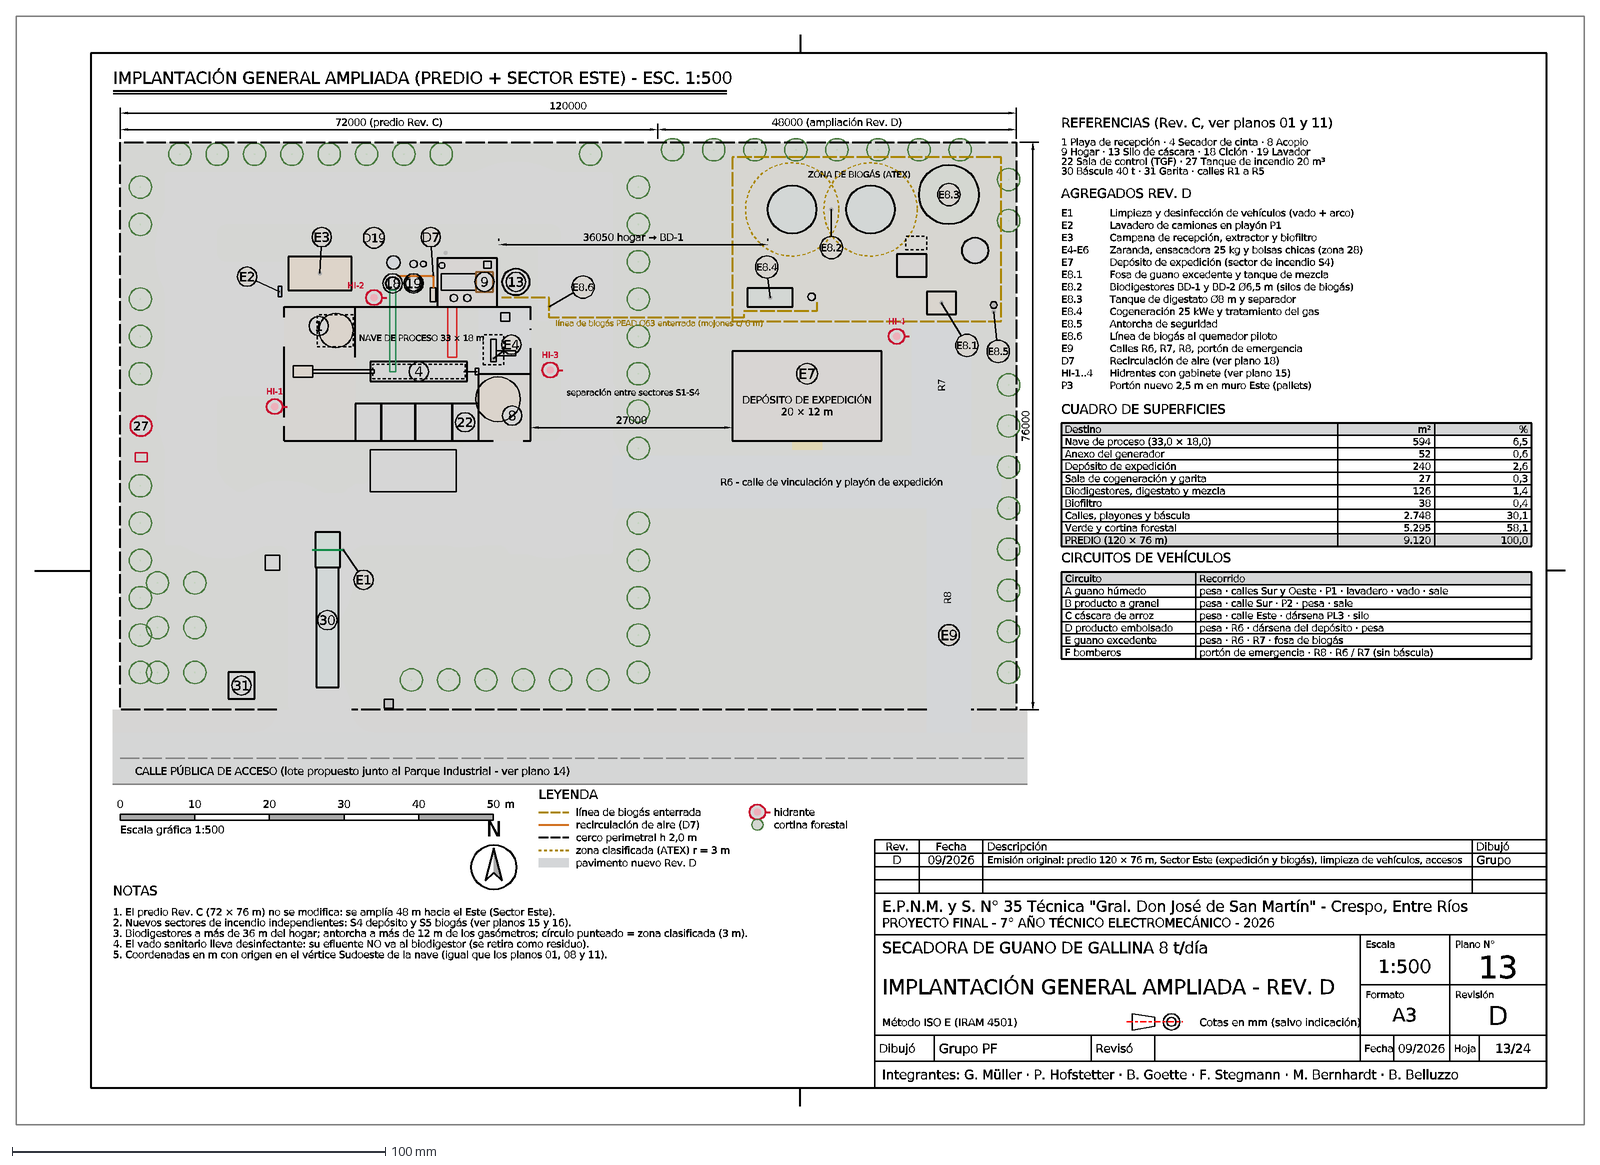
[picture p151: CAD file, 2026-11-11]
planos/dxf/P13.dxf
Integrantes: G. Müller · P. Hofstetter · B. Goette · F. Stegmann · M. Bernhardt · B. Belluzzo
Dibujó
Grupo PF
Revisó
Fecha
09/2026
Hoja
13/24
SECADORA DE GUANO DE GALLINA 8 t/día
IMPLANTACIÓN GENERAL AMPLIADA - REV. D
Método ISO E (IRAM 4501)
Cotas en mm (salvo indicación)
Escala
1:500
Formato
A3
Plano N°
13
Revisión
D
E.P.N.M. y S. N° 35 Técnica "Gral. Don José de San Martín" - Crespo, Entre Ríos
PROYECTO FINAL - 7° AÑO TÉCNICO ELECTROMECÁNICO - 2026
Emisión original: predio 120 × 76 m, Sector Este (expedición y biogás), limpieza de vehículos, accesos
Grupo
Rev.
Descripción
IMPLANTACIÓN GENERAL AMPLIADA (PREDIO + SECTOR ESTE) - ESC. 1:500
CALLE PÚBLICA DE ACCESO (lote propuesto junto al Parque Industrial - ver plano 14)
ZONA DE BIOGÁS (ATEX)
línea de biogás PEAD Ø63 enterrada (mojones c/ 6 m)
DEPÓSITO DE EXPEDICIÓN 20 × 12 m
NAVE DE PROCESO 33 × 18 m
R6 - calle de vinculación y playón de expedición
R7
R8
separación entre sectores S1-S4
HI-1
HI-2
HI-3
HI-4
1
4
8
9
18
19
22
27
30
31
E1
E2
E3
E4
D19
D7
E7
E8.1
E8.2
E8.3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
