lagzgabrielmuller-dot/planta-secadora-guano/planos/dxf/P10.dxf

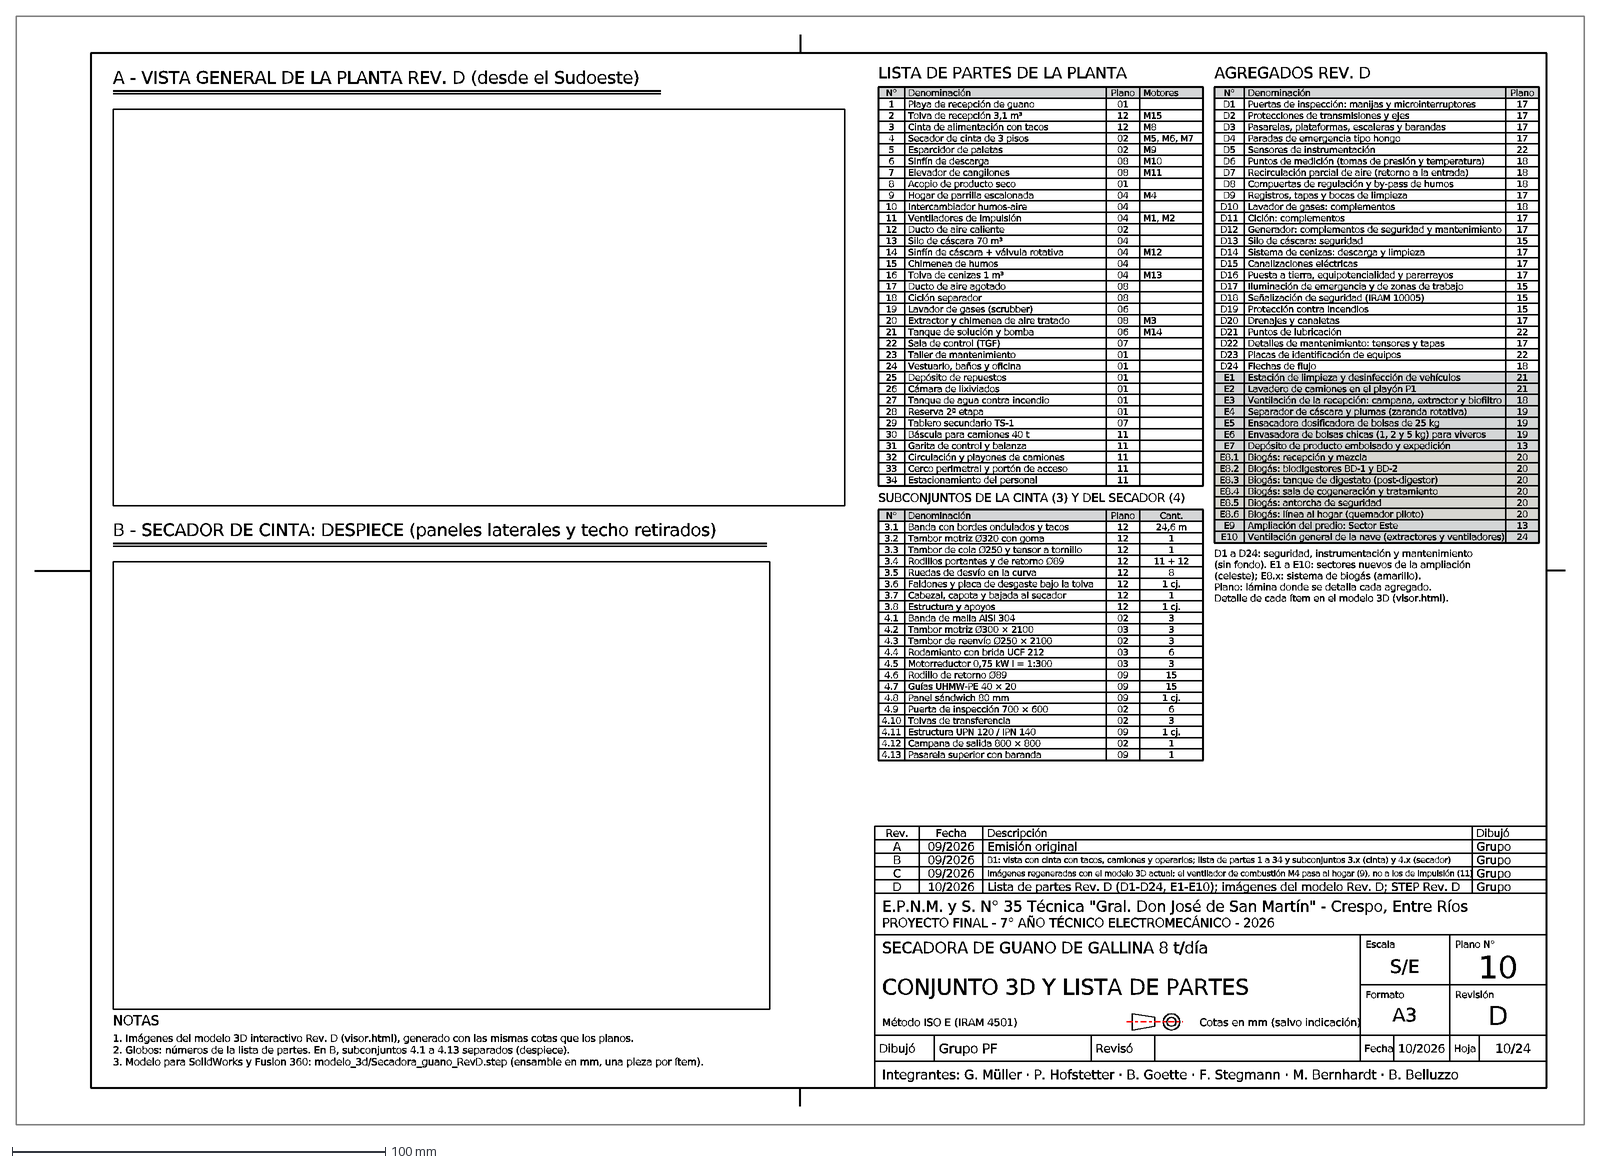
[picture p152: CAD file, 2026-11-11]
planos/dxf/P10.dxf
Integrantes: G. Müller · P. Hofstetter · B. Goette · F. Stegmann · M. Bernhardt · B. Belluzzo
Dibujó
Grupo PF
Revisó
Fecha
10/2026
Hoja
10/24
SECADORA DE GUANO DE GALLINA 8 t/día
CONJUNTO 3D Y LISTA DE PARTES
Método ISO E (IRAM 4501)
Cotas en mm (salvo indicación)
Escala
S/E
Formato
A3
Plano N°
10
Revisión
D
E.P.N.M. y S. N° 35 Técnica "Gral. Don José de San Martín" - Crespo, Entre Ríos
PROYECTO FINAL - 7° AÑO TÉCNICO ELECTROMECÁNICO - 2026
Lista de partes Rev. D (D1-D24, E1-E10); imágenes del modelo Rev. D; STEP Rev. D
Grupo
C
09/2026
Imágenes regeneradas con el modelo 3D actual; el ventilador de combustión M4 pasa al hogar (9), no a los de impulsión (11)
B
B1: vista con cinta con tacos, camiones y operarios; lista de partes 1 a 34 y subconjuntos 3.x (cinta) y 4.x (secador)
A
Emisión original
Rev.
Descripción
A - VISTA GENERAL DE LA PLANTA REV. D (desde el Sudoeste)
B - SECADOR DE CINTA: DESPIECE (paneles laterales y techo retirados)
NOTAS
1. Imágenes del modelo 3D interactivo Rev. D (visor.html), generado con las mismas cotas que los planos. 2. Globos: números de la lista de partes. En B, subconj
LISTA DE PARTES DE LA PLANTA
N°
Denominación
Plano
Motores
1
Playa de recepción de guano
01
2
Tolva de recepción 3,1 m³
12
M15
3
Cinta de alimentación con tacos
M8
4
Secador de cinta de 3 pisos
02
M5, M6, M7
5
Esparcidor de paletas
M9
6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
