lagzgabrielmuller-dot/planta-secadora-guano/planos/dxf/P18.dxf

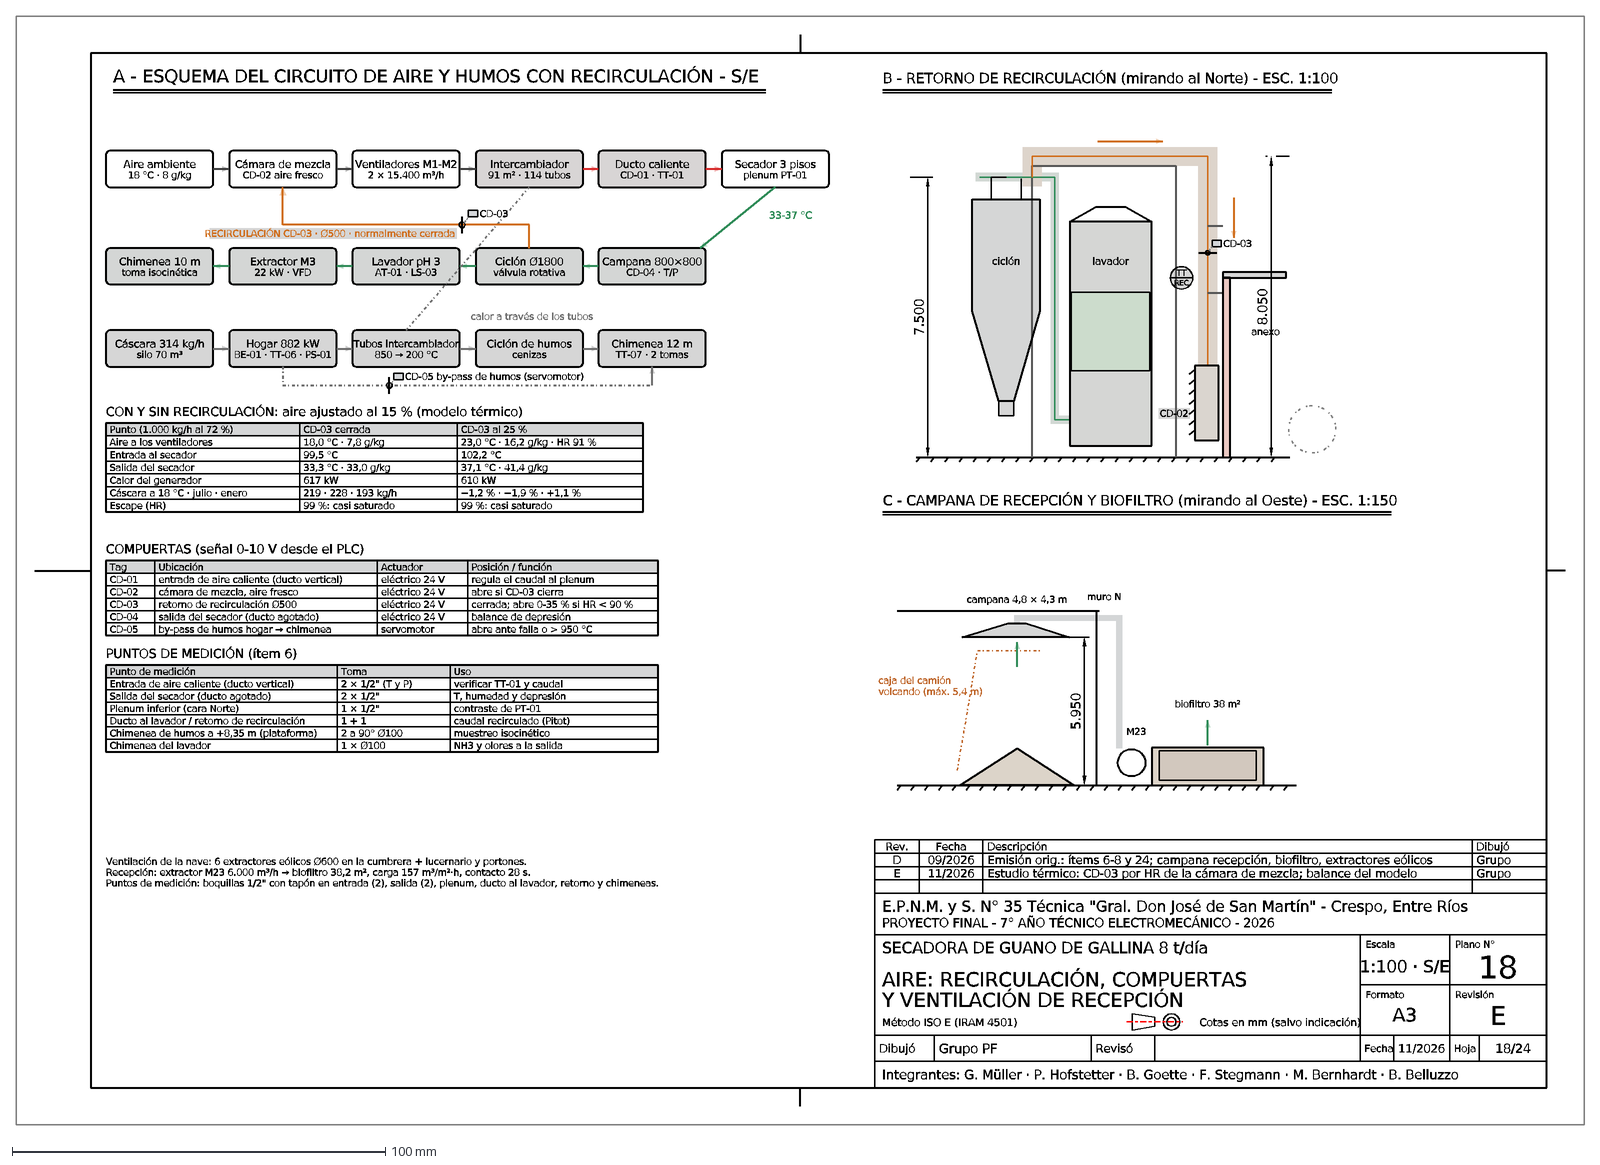
[picture p153: CAD file, 2026-11-11]
planos/dxf/P18.dxf
Integrantes: G. Müller · P. Hofstetter · B. Goette · F. Stegmann · M. Bernhardt · B. Belluzzo
Dibujó
Grupo PF
Revisó
Fecha
11/2026
Hoja
18/24
SECADORA DE GUANO DE GALLINA 8 t/día
AIRE: RECIRCULACIÓN, COMPUERTAS
Y VENTILACIÓN DE RECEPCIÓN
Método ISO E (IRAM 4501)
Cotas en mm (salvo indicación)
Escala
1:100 · S/E
Formato
A3
Plano N°
18
Revisión
E
E.P.N.M. y S. N° 35 Técnica "Gral. Don José de San Martín" - Crespo, Entre Ríos
PROYECTO FINAL - 7° AÑO TÉCNICO ELECTROMECÁNICO - 2026
Estudio térmico: CD-03 por HR de la cámara de mezcla; balance del modelo
Grupo
D
09/2026
Emisión orig.: ítems 6-8 y 24; campana recepción, biofiltro, extractores eólicos
Rev.
Descripción
A - ESQUEMA DEL CIRCUITO DE AIRE Y HUMOS CON RECIRCULACIÓN - S/E
Aire ambiente
18 °C · 8 g/kg
Cámara de mezcla
CD-02 aire fresco
Ventiladores M1-M2
2 × 15.400 m³/h
Intercambiador
91 m² · 114 tubos
Ducto caliente
CD-01 · TT-01
Secador 3 pisos
plenum PT-01
Chimenea 10 m
toma isocinética
Extractor M3
22 kW · VFD
Lavador pH 3
AT-01 · LS-03
Ciclón Ø1800
válvula rotativa
Campana 800×800
CD-04 · T/P
Cáscara 314 kg/h
silo 70 m³
Hogar 882 kW
BE-01 · TT-06 · PS-01
Tubos intercambiador
850 → 200 °C
Ciclón de humos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
