lagzgabrielmuller-dot/planta-secadora-guano/planos/dxf/P06.dxf

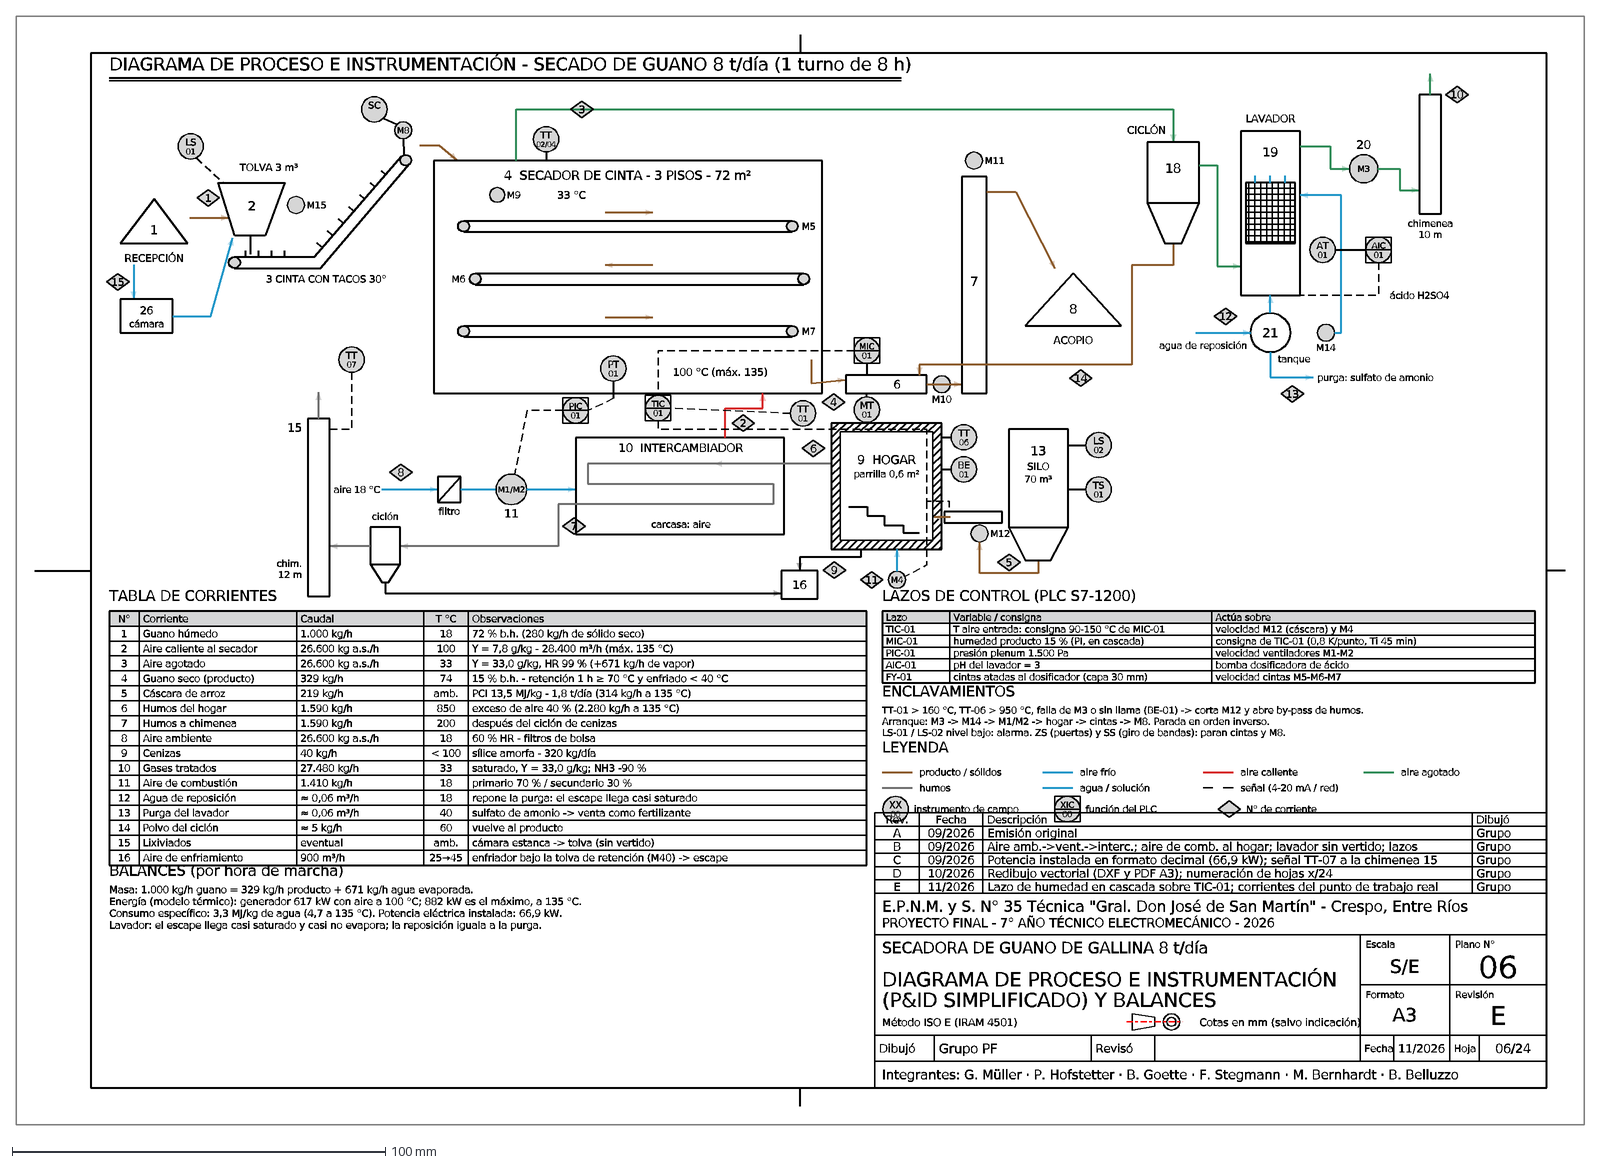
[picture p154: CAD file, 2026-11-11]
planos/dxf/P06.dxf
Integrantes: G. Müller · P. Hofstetter · B. Goette · F. Stegmann · M. Bernhardt · B. Belluzzo
Dibujó
Grupo PF
Revisó
Fecha
11/2026
Hoja
06/24
SECADORA DE GUANO DE GALLINA 8 t/día
DIAGRAMA DE PROCESO E INSTRUMENTACIÓN
(P&ID SIMPLIFICADO) Y BALANCES
Método ISO E (IRAM 4501)
Cotas en mm (salvo indicación)
Escala
S/E
Formato
A3
Plano N°
06
Revisión
E
E.P.N.M. y S. N° 35 Técnica "Gral. Don José de San Martín" - Crespo, Entre Ríos
PROYECTO FINAL - 7° AÑO TÉCNICO ELECTROMECÁNICO - 2026
Lazo de humedad en cascada sobre TIC-01; corrientes del punto de trabajo real
Grupo
D
10/2026
Redibujo vectorial (DXF y PDF A3); numeración de hojas x/24
C
09/2026
Potencia instalada en formato decimal (66,9 kW); señal TT-07 a la chimenea 15
B
Aire amb.->vent.->interc.; aire de comb. al hogar; lavador sin vertido; lazos
A
Emisión original
Rev.
Descripción
DIAGRAMA DE PROCESO E INSTRUMENTACIÓN - SECADO DE GUANO 8 t/día (1 turno de 8 h)
1
RECEPCIÓN
15
26
cámara
2
TOLVA 3 m³
LS
01
M15
3 CINTA CON TACOS 30°
M8
SC
4 SECADOR DE CINTA - 3 PISOS - 72 m²
M9
33 °C
M5
M6
M7
100 °C (máx. 135)
TT
02/04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
