lagzgabrielmuller-dot/planta-secadora-guano/planos/dxf/P21.dxf

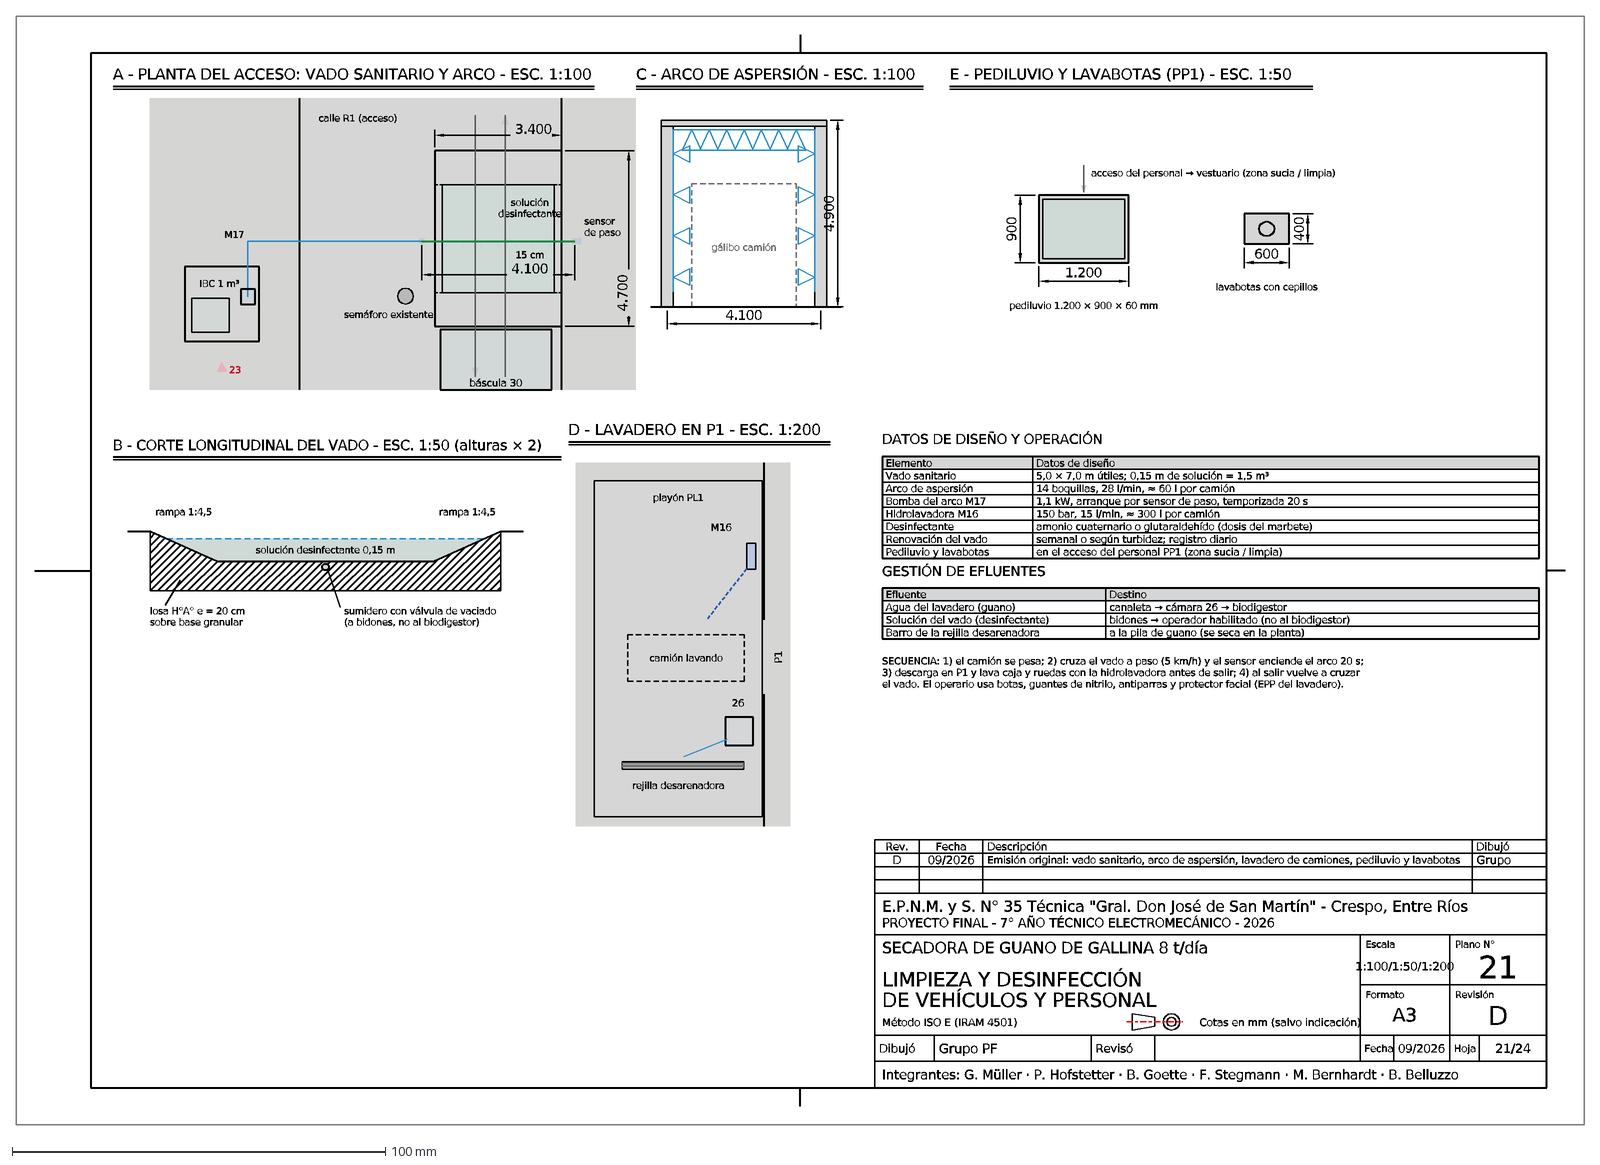
[picture p155: CAD file, 2026-11-11]
planos/dxf/P21.dxf
Integrantes: G. Müller · P. Hofstetter · B. Goette · F. Stegmann · M. Bernhardt · B. Belluzzo
Dibujó
Grupo PF
Revisó
Fecha
09/2026
Hoja
21/24
SECADORA DE GUANO DE GALLINA 8 t/día
LIMPIEZA Y DESINFECCIÓN
DE VEHÍCULOS Y PERSONAL
Método ISO E (IRAM 4501)
Cotas en mm (salvo indicación)
Escala
1:100/1:50/1:200
Formato
A3
Plano N°
21
Revisión
D
E.P.N.M. y S. N° 35 Técnica "Gral. Don José de San Martín" - Crespo, Entre Ríos
PROYECTO FINAL - 7° AÑO TÉCNICO ELECTROMECÁNICO - 2026
Emisión original: vado sanitario, arco de aspersión, lavadero de camiones, pediluvio y lavabotas
Grupo
Rev.
Descripción
A - PLANTA DEL ACCESO: VADO SANITARIO Y ARCO - ESC. 1:100
calle R1 (acceso)
báscula 30
solución desinfectante
IBC 1 m³
M17
sensor de paso
15 cm
semáforo existente
23
3.400
4.700
4.100
B - CORTE LONGITUDINAL DEL VADO - ESC. 1:50 (alturas × 2)
solución desinfectante 0,15 m
rampa 1:4,5
sumidero con válvula de vaciado (a bidones, no al biodigestor)
losa H°A° e = 20 cm sobre base granular
C - ARCO DE ASPERSIÓN - ESC. 1:100
gálibo camión
4.900
D - LAVADERO EN P1 - ESC. 1:200
playón PL1
P1
M16
camión lavando
26
rejilla desarenadora
E - PEDILUVIO Y LAVABOTAS (PP1) - ESC. 1:50
acceso del personal → vestuario (zona sucia / limpia)
1.200
900
pediluvio 1.200 × 900 × 60 mm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
