lagzgabrielmuller-dot/planta-secadora-guano/planos/dxf/P19.dxf

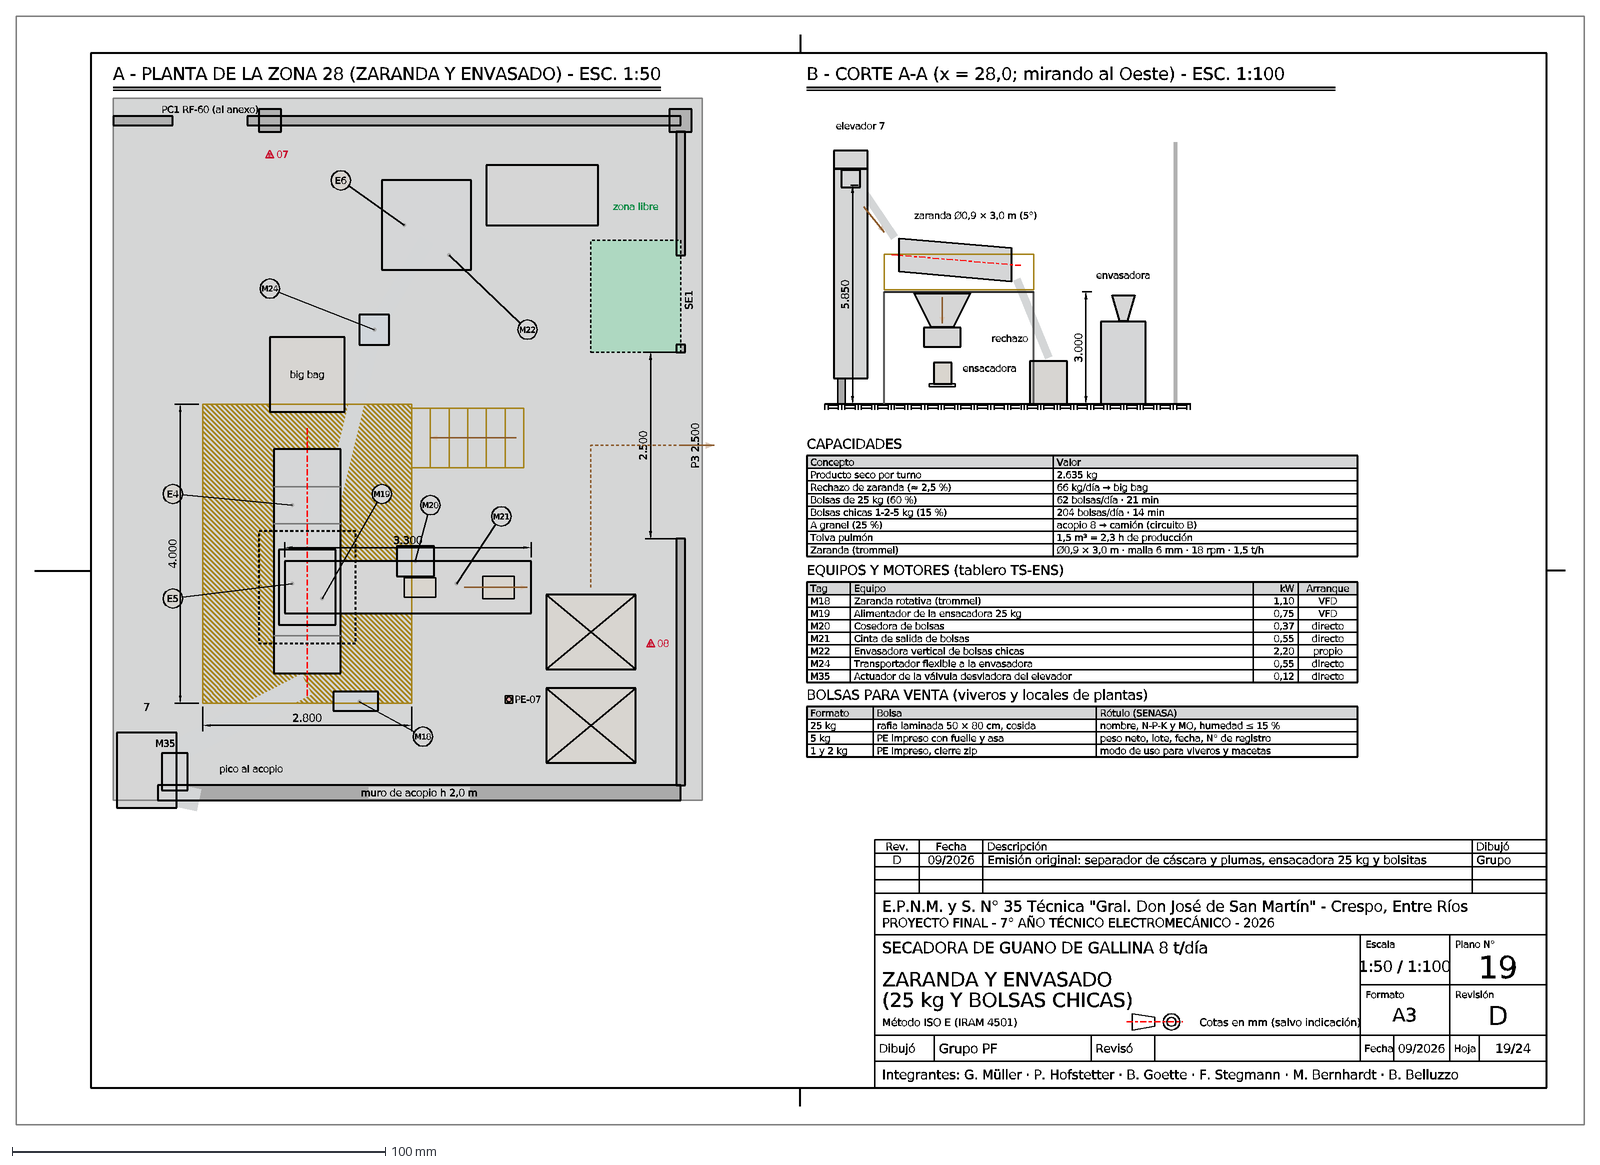
[picture p156: CAD file, 2026-11-11]
planos/dxf/P19.dxf
Integrantes: G. Müller · P. Hofstetter · B. Goette · F. Stegmann · M. Bernhardt · B. Belluzzo
Dibujó
Grupo PF
Revisó
Fecha
09/2026
Hoja
19/24
SECADORA DE GUANO DE GALLINA 8 t/día
ZARANDA Y ENVASADO
(25 kg Y BOLSAS CHICAS)
Método ISO E (IRAM 4501)
Cotas en mm (salvo indicación)
Escala
1:50 / 1:100
Formato
A3
Plano N°
19
Revisión
D
E.P.N.M. y S. N° 35 Técnica "Gral. Don José de San Martín" - Crespo, Entre Ríos
PROYECTO FINAL - 7° AÑO TÉCNICO ELECTROMECÁNICO - 2026
Emisión original: separador de cáscara y plumas, ensacadora 25 kg y bolsitas
Grupo
Rev.
Descripción
A - PLANTA DE LA ZONA 28 (ZARANDA Y ENVASADO) - ESC. 1:50
muro de acopio h 2,0 m
PC1 RF-60 (al anexo)
SE1
zona libre
2.500
P3 2.500
4.000
2.800
big bag
3.300
7
M35
pico al acopio
E
07
08
PE-07
E6
M22
M24
E4
E5
M19
M20
M21
M18
B - CORTE A-A (x = 28,0; mirando al Oeste) - ESC. 1:100
elevador 7
5.850
zaranda Ø0,9 × 3,0 m (5°)
ensacadora
rechazo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
