lagzgabrielmuller-dot/planta-secadora-guano/planos/dxf/P17.dxf

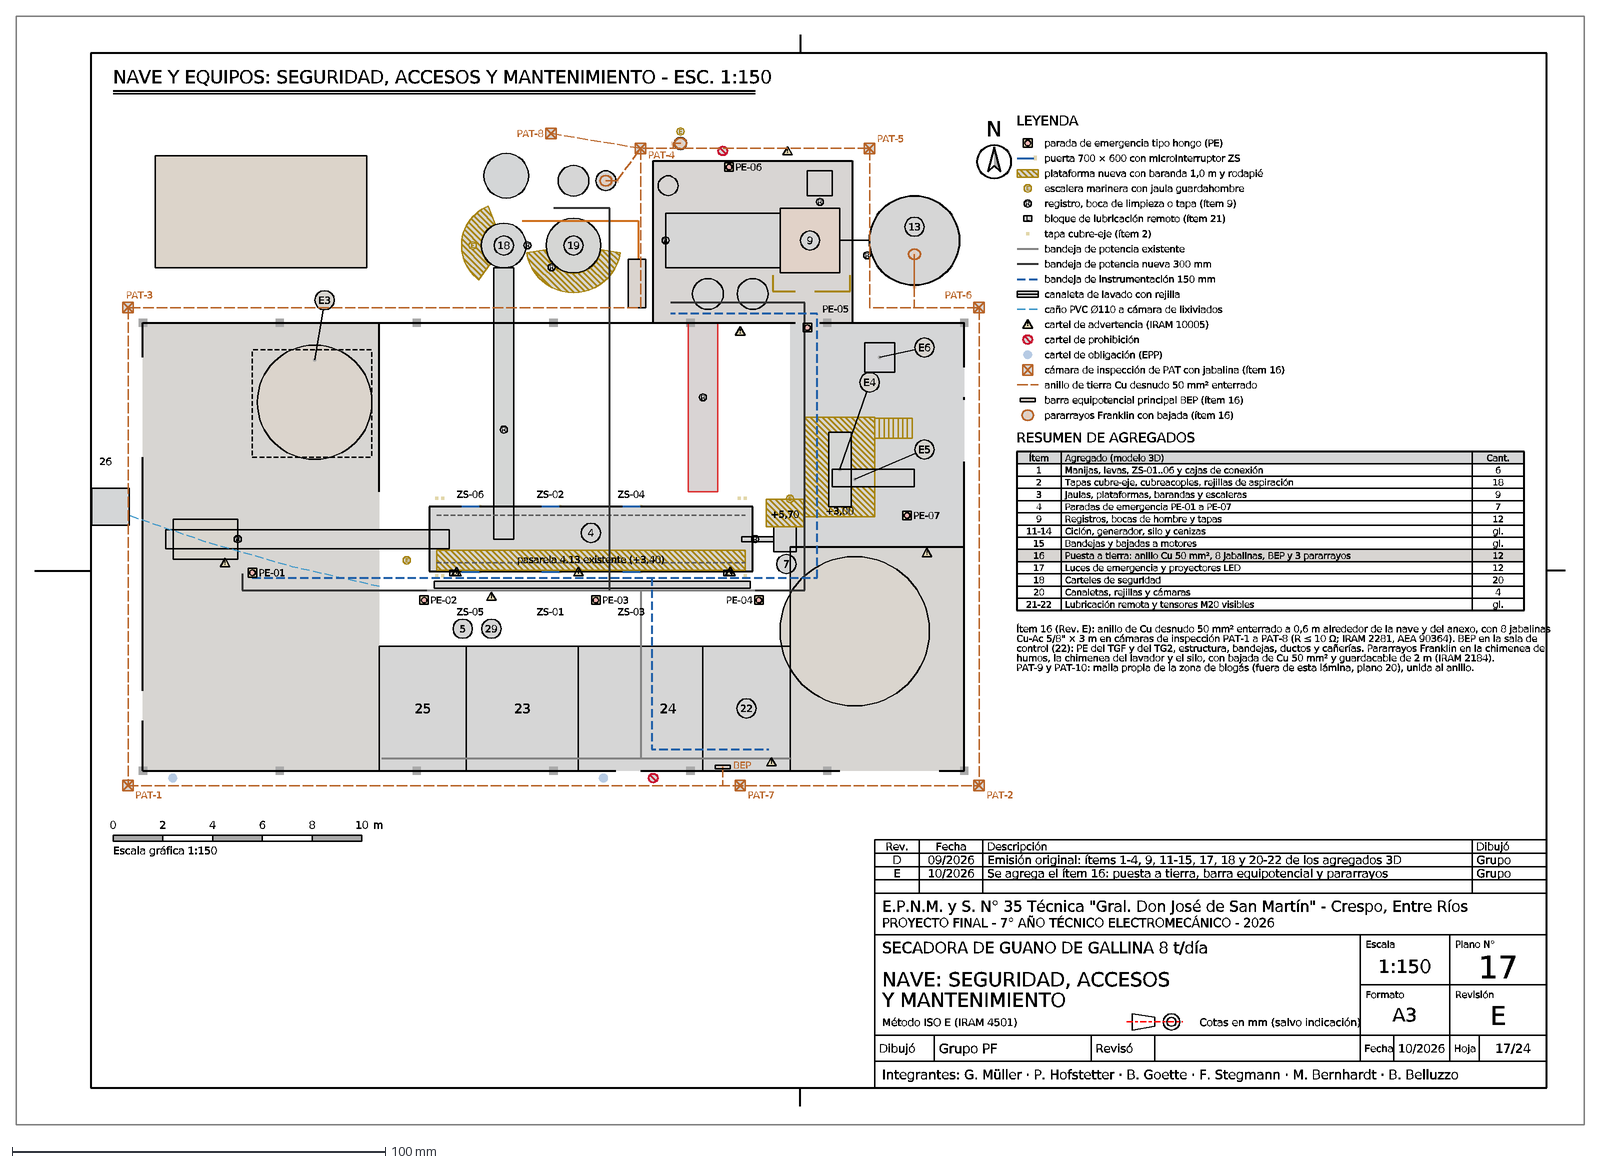
[picture p157: CAD file, 2026-11-11]
planos/dxf/P17.dxf
Integrantes: G. Müller · P. Hofstetter · B. Goette · F. Stegmann · M. Bernhardt · B. Belluzzo
Dibujó
Grupo PF
Revisó
Fecha
10/2026
Hoja
17/24
SECADORA DE GUANO DE GALLINA 8 t/día
NAVE: SEGURIDAD, ACCESOS
Y MANTENIMIENTO
Método ISO E (IRAM 4501)
Cotas en mm (salvo indicación)
Escala
1:150
Formato
A3
Plano N°
17
Revisión
E
E.P.N.M. y S. N° 35 Técnica "Gral. Don José de San Martín" - Crespo, Entre Ríos
PROYECTO FINAL - 7° AÑO TÉCNICO ELECTROMECÁNICO - 2026
Se agrega el ítem 16: puesta a tierra, barra equipotencial y pararrayos
Grupo
D
09/2026
Emisión original: ítems 1-4, 9, 11-15, 17, 18 y 20-22 de los agregados 3D
Rev.
Descripción
NAVE Y EQUIPOS: SEGURIDAD, ACCESOS Y MANTENIMIENTO - ESC. 1:150
26
ZS-01
ZS-02
ZS-03
ZS-04
ZS-05
ZS-06
L
+5,70
+3,00
pasarela 4.13 existente (+3,40)
R
PE-01
PE-02
PE-03
PE-07
PE-06
PE-04
PE-05
!
4
5
29
7
22
9
13
18
19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
