lagzgabrielmuller-dot/planta-secadora-guano/planos/dxf/P05.dxf

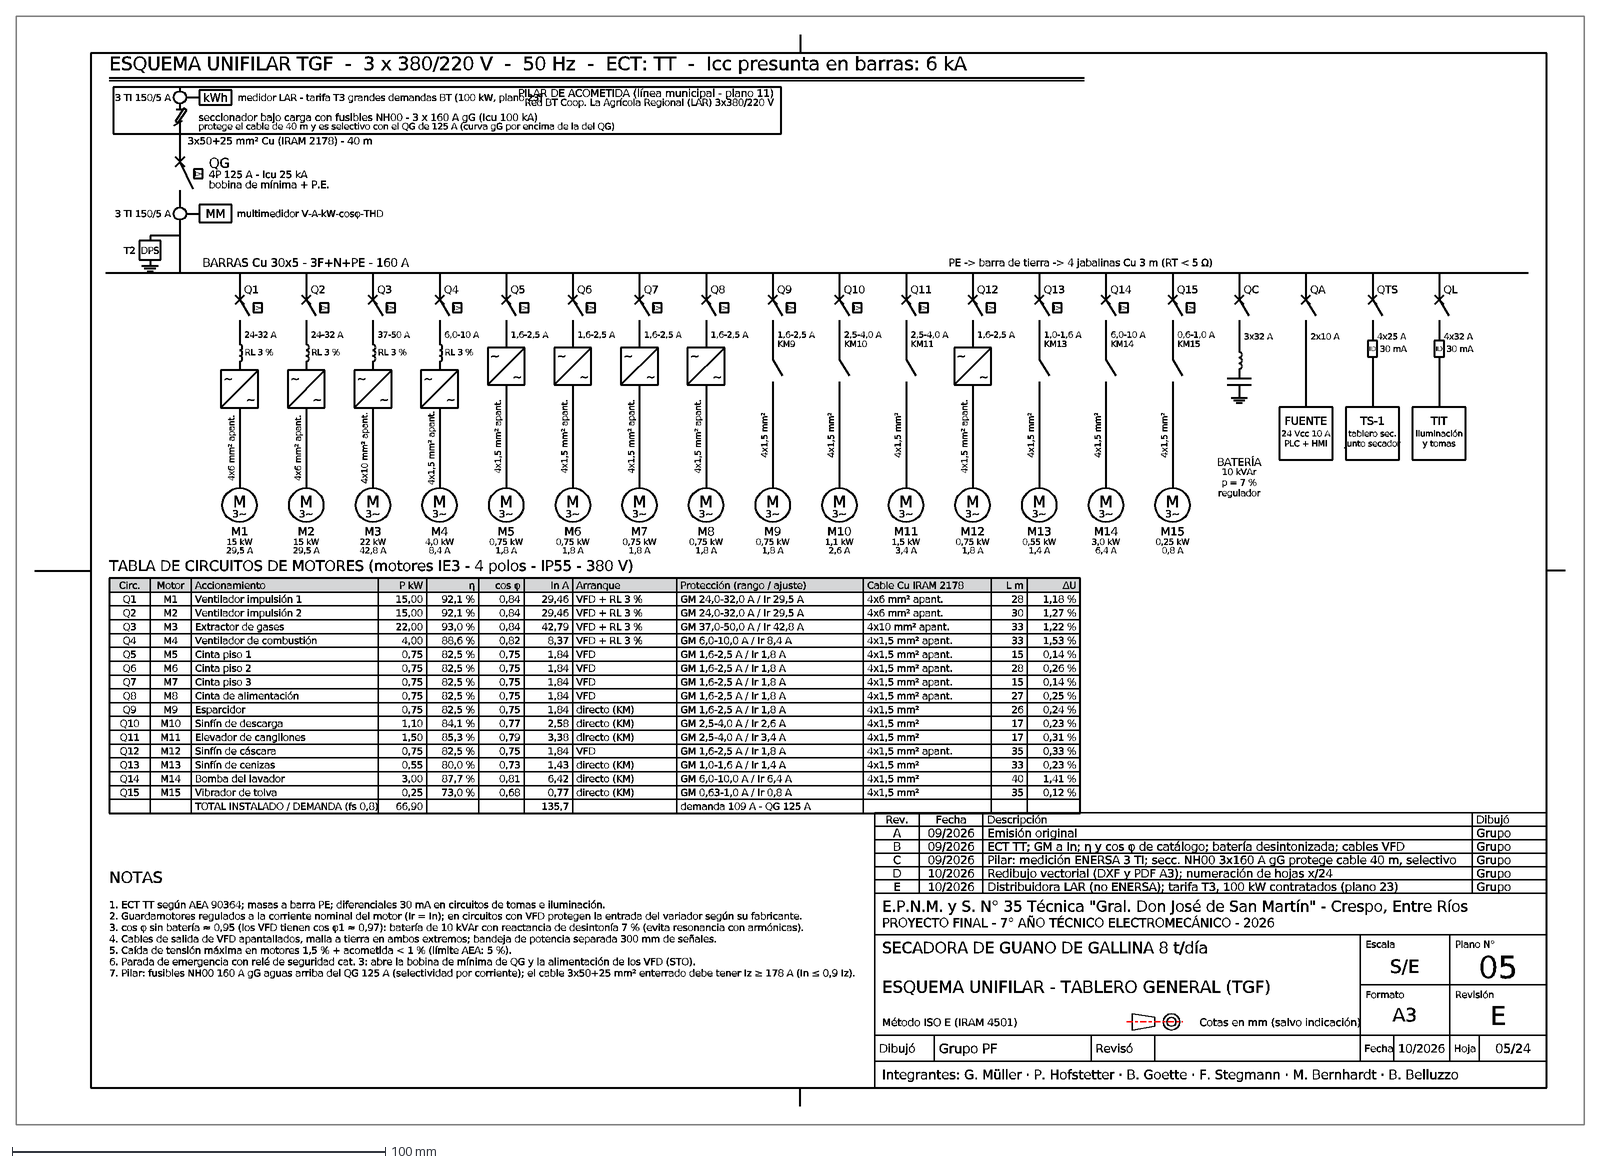
[picture p158: CAD file, 2026-11-11]
planos/dxf/P05.dxf
Integrantes: G. Müller · P. Hofstetter · B. Goette · F. Stegmann · M. Bernhardt · B. Belluzzo
Dibujó
Grupo PF
Revisó
Fecha
10/2026
Hoja
05/24
SECADORA DE GUANO DE GALLINA 8 t/día
ESQUEMA UNIFILAR - TABLERO GENERAL (TGF)
Método ISO E (IRAM 4501)
Cotas en mm (salvo indicación)
Escala
S/E
Formato
A3
Plano N°
05
Revisión
E
E.P.N.M. y S. N° 35 Técnica "Gral. Don José de San Martín" - Crespo, Entre Ríos
PROYECTO FINAL - 7° AÑO TÉCNICO ELECTROMECÁNICO - 2026
Distribuidora LAR (no ENERSA); tarifa T3, 100 kW contratados (plano 23)
Grupo
D
Redibujo vectorial (DXF y PDF A3); numeración de hojas x/24
C
09/2026
Pilar: medición ENERSA 3 TI; secc. NH00 3x160 A gG protege cable 40 m, selectivo
B
ECT TT; GM a In; η y cos φ de catálogo; batería desintonizada; cables VFD
A
Emisión original
Rev.
Descripción
ESQUEMA UNIFILAR TGF - 3 x 380/220 V - 50 Hz - ECT: TT - Icc presunta en barras: 6 kA
PILAR DE ACOMETIDA (línea municipal - plano 11)
Red BT Coop. La Agrícola Regional (LAR) 3x380/220 V
3 TI 150/5 A
kWh
medidor LAR - tarifa T3 grandes demandas BT (100 kW, plano 23)
seccionador bajo carga con fusibles NH00 - 3 x 160 A gG (Icu 100 kA)
protege el cable de 40 m y es selectivo con el QG de 125 A (curva gG por encima de la del QG)
3x50+25 mm² Cu (IRAM 2178) - 40 m
I>
QG
4P 125 A - Icu 25 kA
bobina de mínima + P.E.
MM
multimedidor V-A-kW-cosφ-THD
DPS
T2
BARRAS Cu 30x5 - 3F+N+PE - 160 A
PE -> barra de tierra -> 4 jabalinas Cu 3 m (RT < 5 Ω)
Q1
24-32 A
RL 3 %
~
4x6 mm² apant.
M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
