lagzgabrielmuller-dot/planta-secadora-guano/planos/dxf/P23.dxf

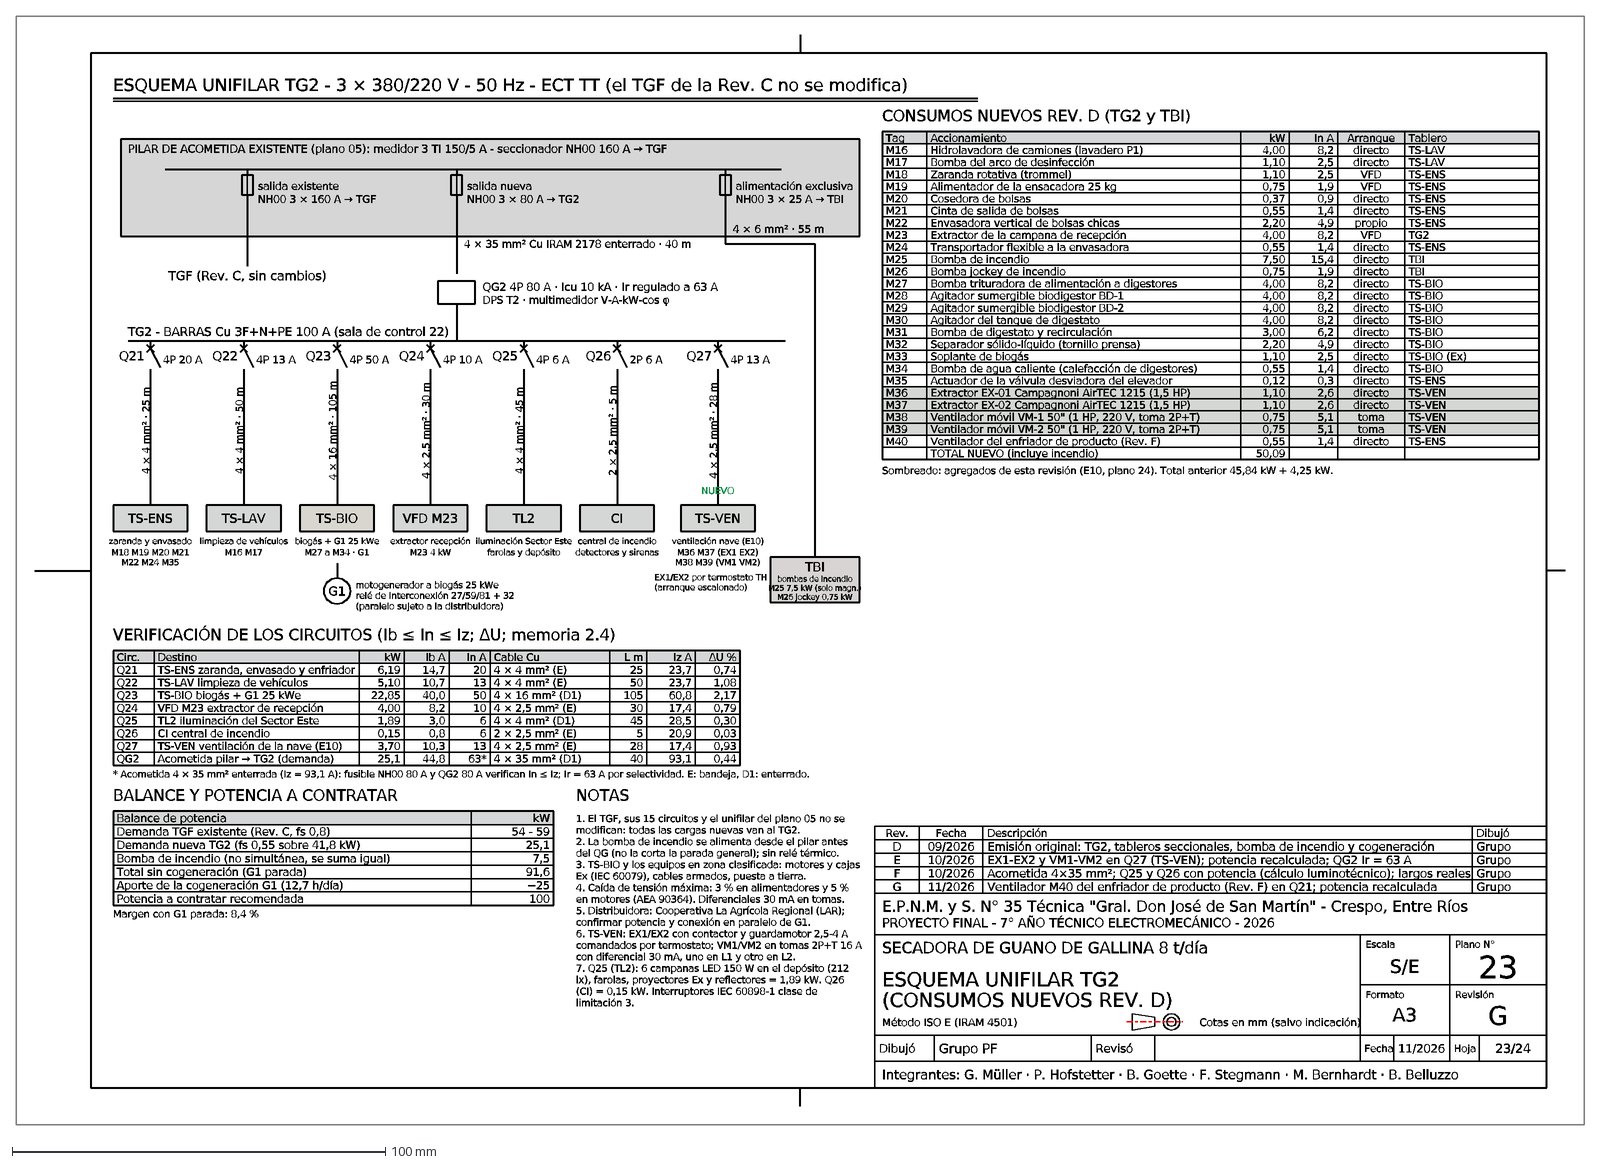
[picture p159: CAD file, 2026-11-11]
planos/dxf/P23.dxf
Integrantes: G. Müller · P. Hofstetter · B. Goette · F. Stegmann · M. Bernhardt · B. Belluzzo
Dibujó
Grupo PF
Revisó
Fecha
11/2026
Hoja
23/24
SECADORA DE GUANO DE GALLINA 8 t/día
ESQUEMA UNIFILAR TG2
(CONSUMOS NUEVOS REV. D)
Método ISO E (IRAM 4501)
Cotas en mm (salvo indicación)
Escala
S/E
Formato
A3
Plano N°
23
Revisión
G
E.P.N.M. y S. N° 35 Técnica "Gral. Don José de San Martín" - Crespo, Entre Ríos
PROYECTO FINAL - 7° AÑO TÉCNICO ELECTROMECÁNICO - 2026
Ventilador M40 del enfriador de producto (Rev. F) en Q21; potencia recalculada
Grupo
F
10/2026
Acometida 4×35 mm²; Q25 y Q26 con potencia (cálculo luminotécnico); largos reales
E
EX1-EX2 y VM1-VM2 en Q27 (TS-VEN); potencia recalculada; QG2 Ir = 63 A
D
09/2026
Emisión original: TG2, tableros seccionales, bomba de incendio y cogeneración
Rev.
Descripción
ESQUEMA UNIFILAR TG2 - 3 × 380/220 V - 50 Hz - ECT TT (el TGF de la Rev. C no se modifica)
PILAR DE ACOMETIDA EXISTENTE (plano 05): medidor 3 TI 150/5 A - seccionador NH00 160 A → TGF
salida existente
NH00 3 × 160 A → TGF
salida nueva
NH00 3 × 80 A → TG2
alimentación exclusiva
NH00 3 × 25 A → TBI
TGF (Rev. C, sin cambios)
4 × 35 mm² Cu IRAM 2178 enterrado · 40 m
QG2 4P 80 A · Icu 10 kA · Ir regulado a 63 A
DPS T2 · multimedidor V-A-kW-cos φ
4 × 6 mm² · 55 m
TG2 - BARRAS Cu 3F+N+PE 100 A (sala de control 22)
Q21
4P 20 A
4 × 4 mm² · 25 m
TS-ENS
zaranda y envasado
M18 M19 M20 M21 M22 M24 M35
Q22
4P 13 A
4 × 4 mm² · 50 m
TS-LAV
limpieza de vehículos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
