lagzgabrielmuller-dot/planta-secadora-guano/(list of files, cad)

Other CAD files:
secadora/planos/dxf/SC-06.dxf
planos/dxf/P07.dxf
planos/dxf/P15.dxf
