lagzgabrielmuller-dot/planta-secadora-guano/planos/pdf/P01.pdf

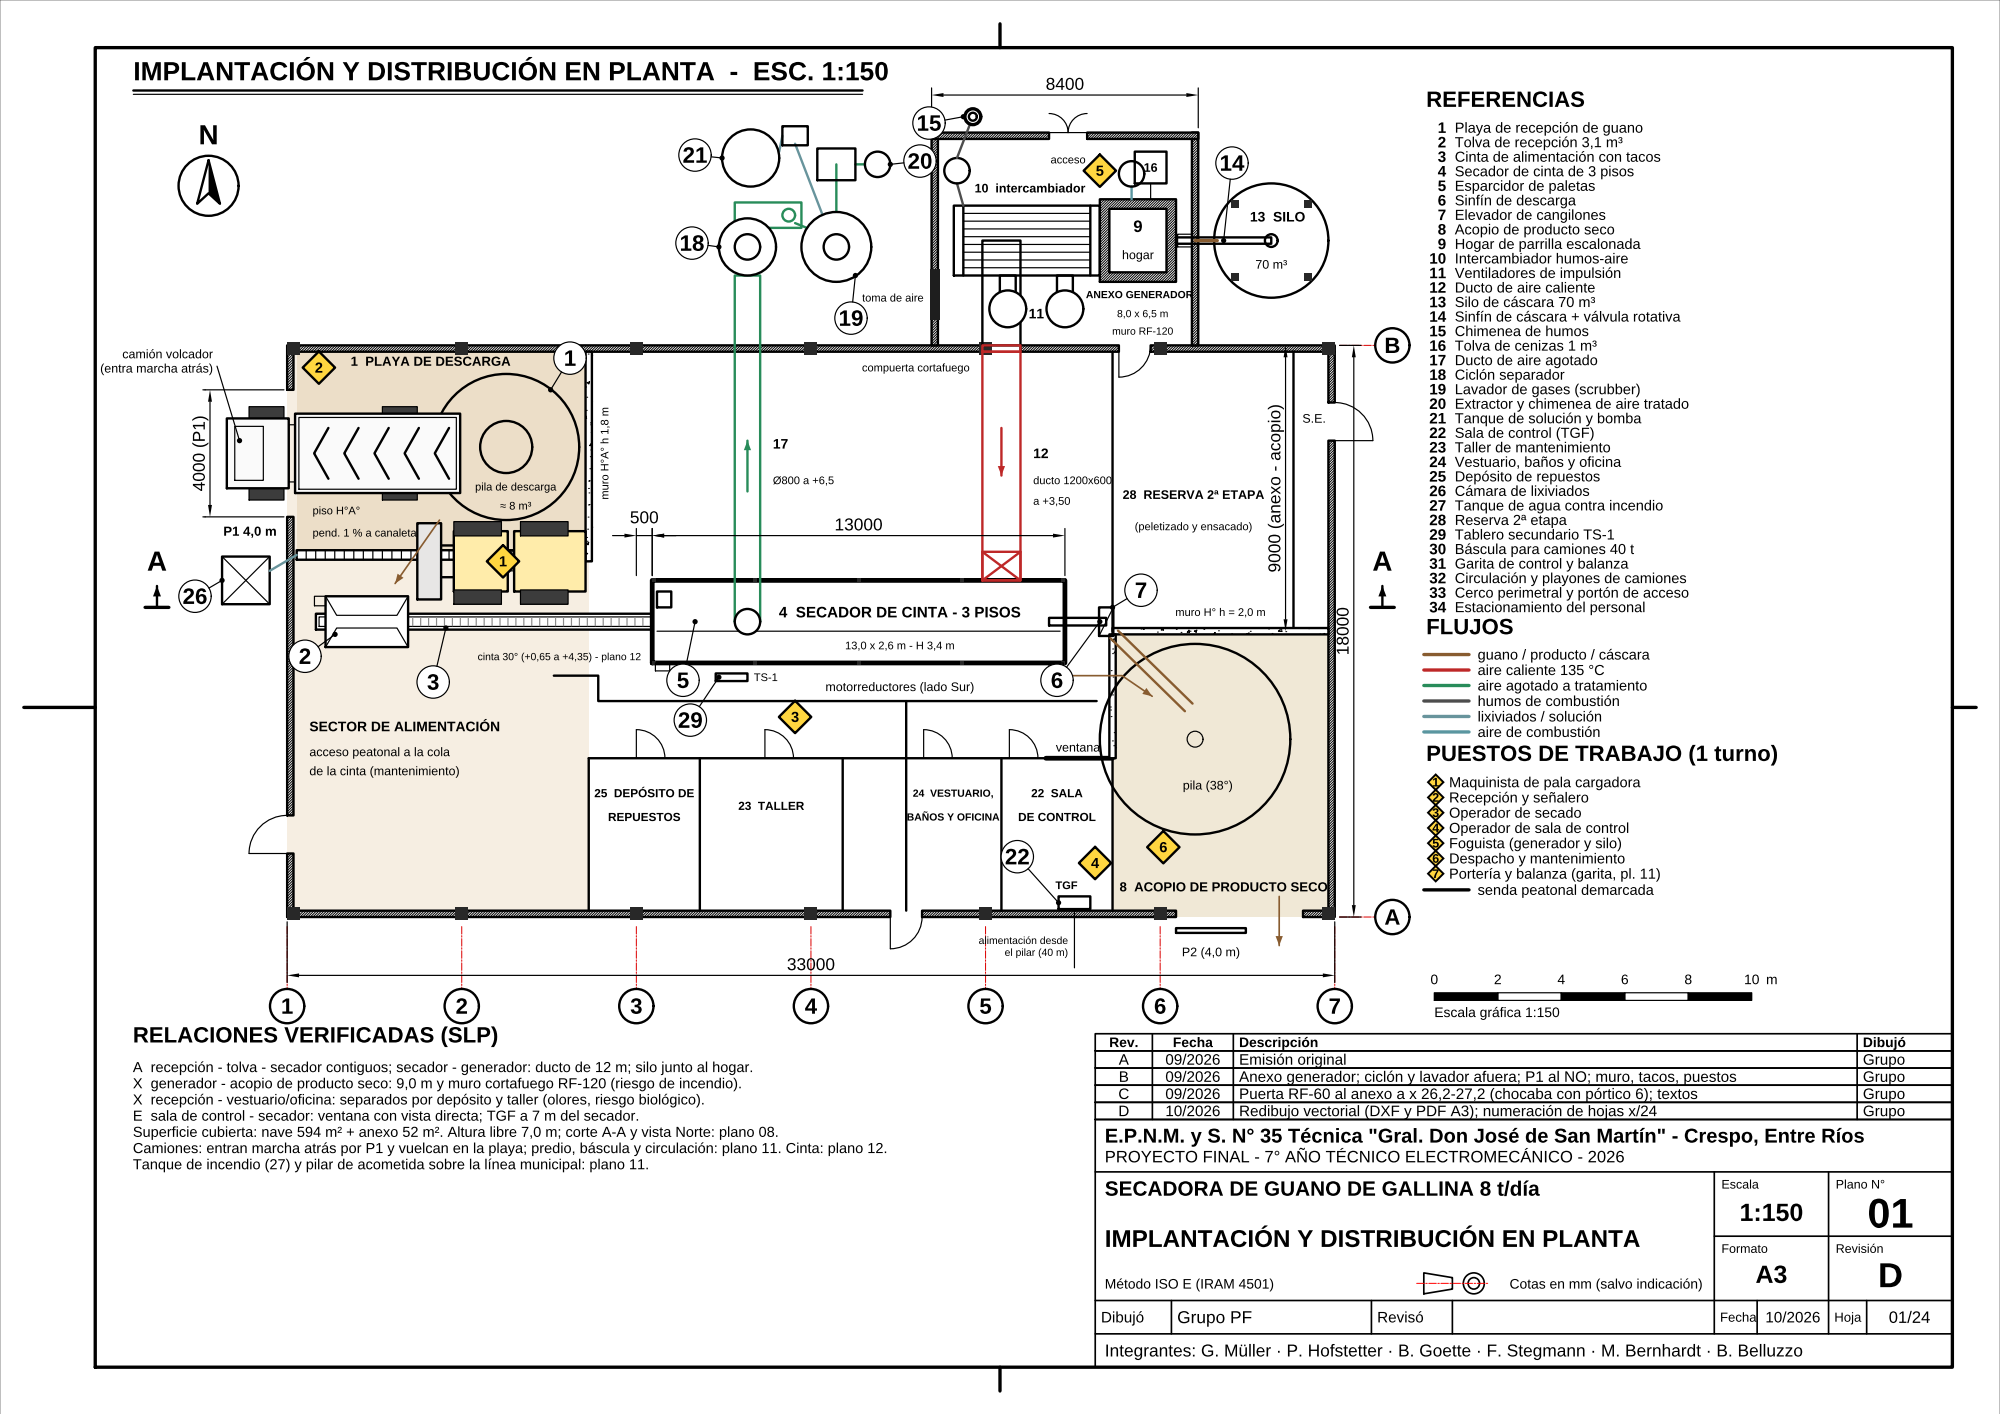
[picture p160: page 1]
