lagzgabrielmuller-dot/planta-secadora-guano/planos/pdf/P02.pdf

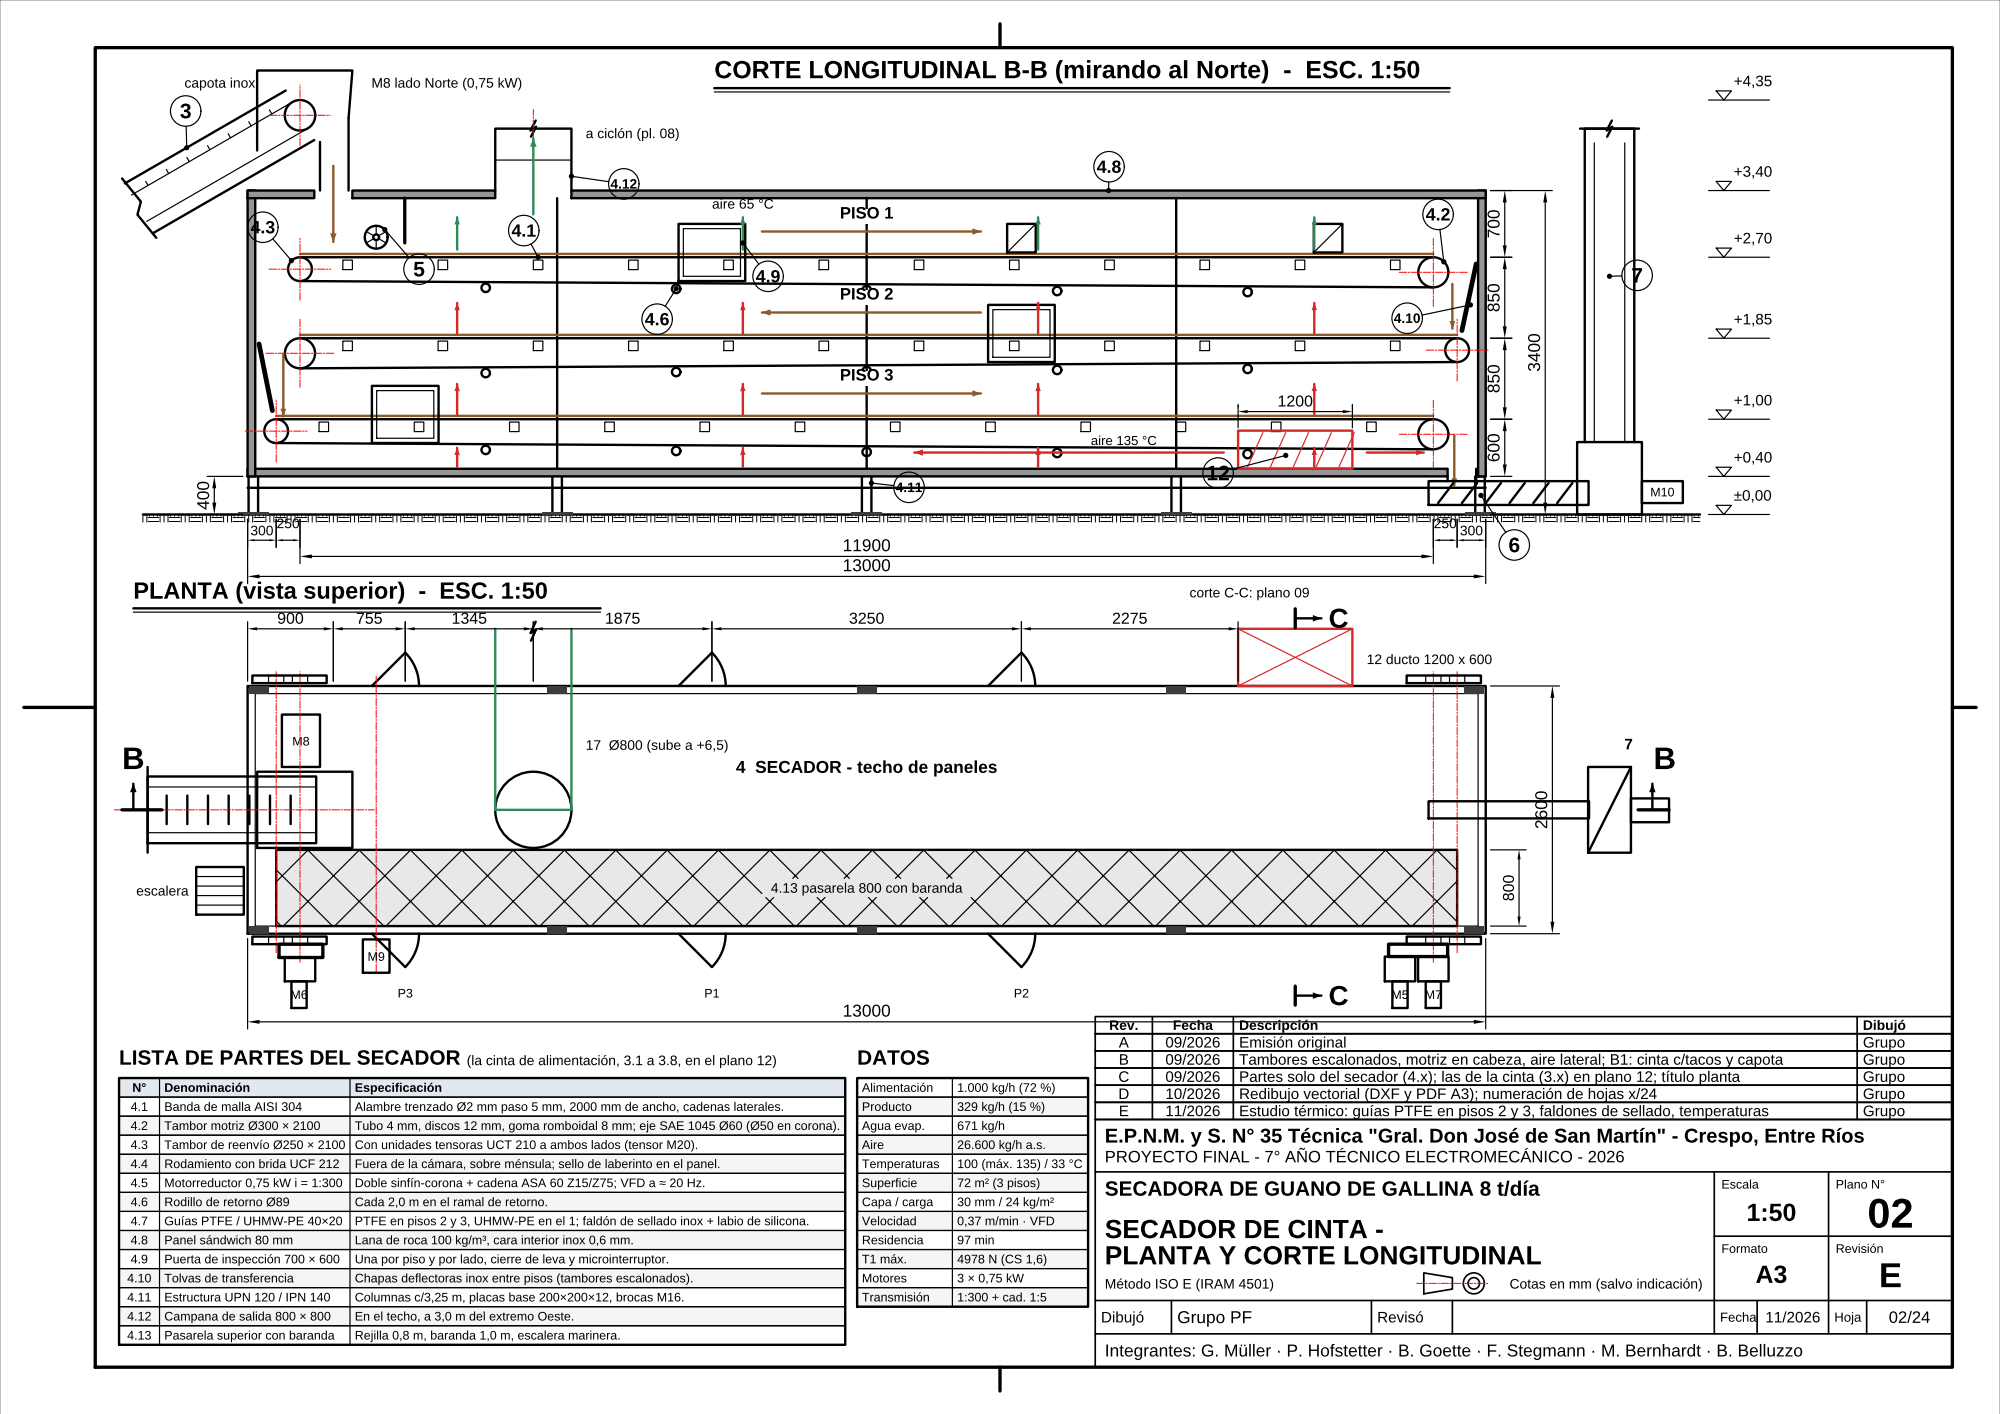
[picture p161: page 1]
