lagzgabrielmuller-dot/planta-secadora-guano/planos/pdf/P03.pdf

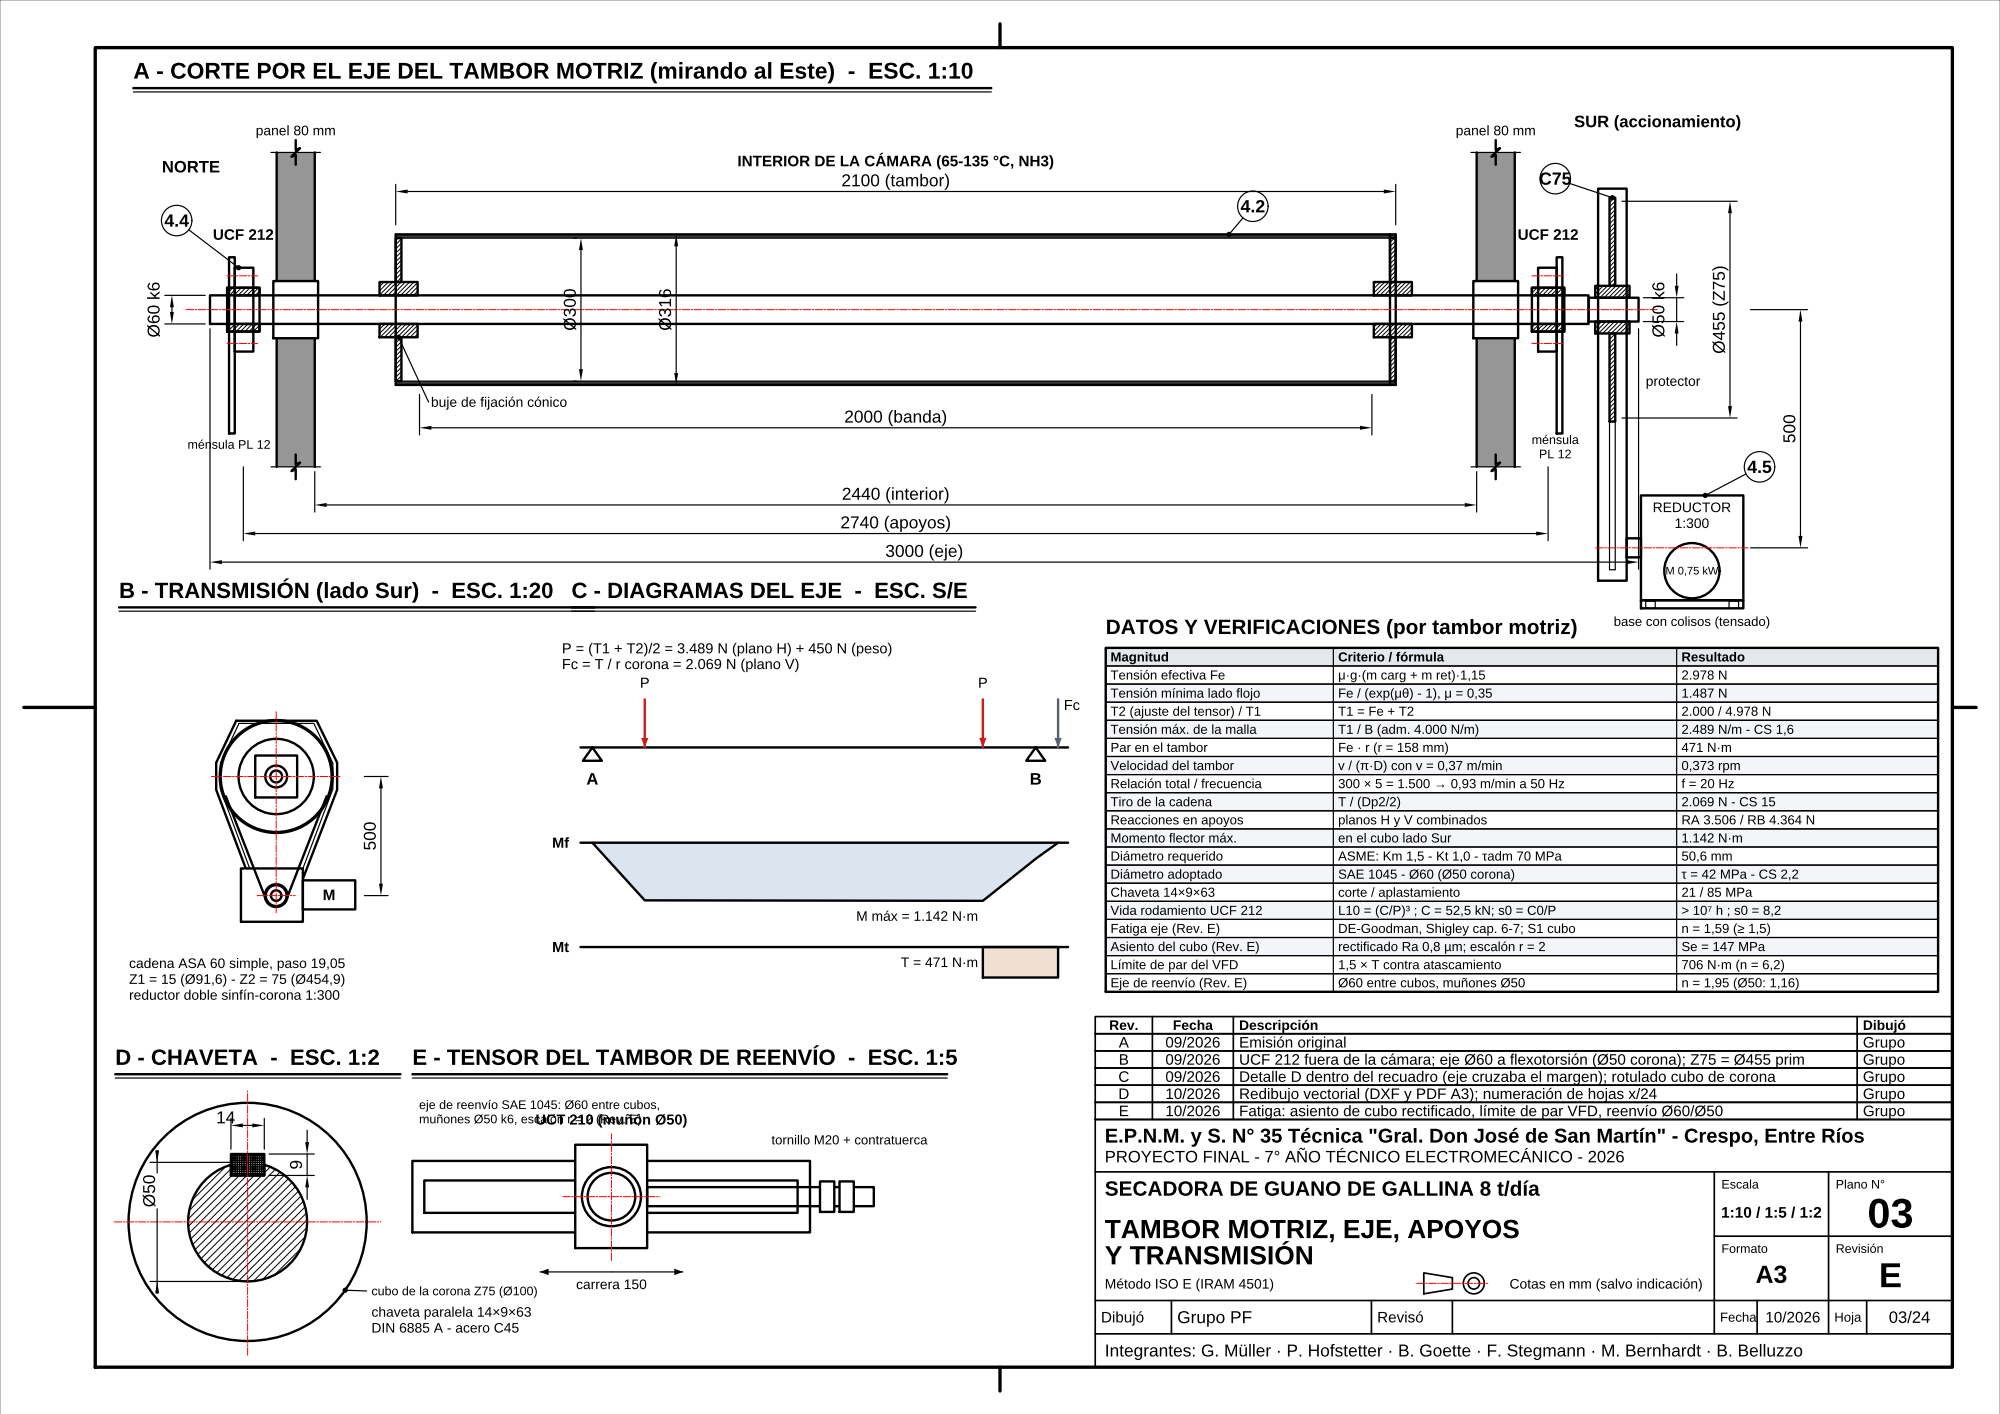
[picture p162: page 1]
