lagzgabrielmuller-dot/planta-secadora-guano/planos/pdf/P04.pdf

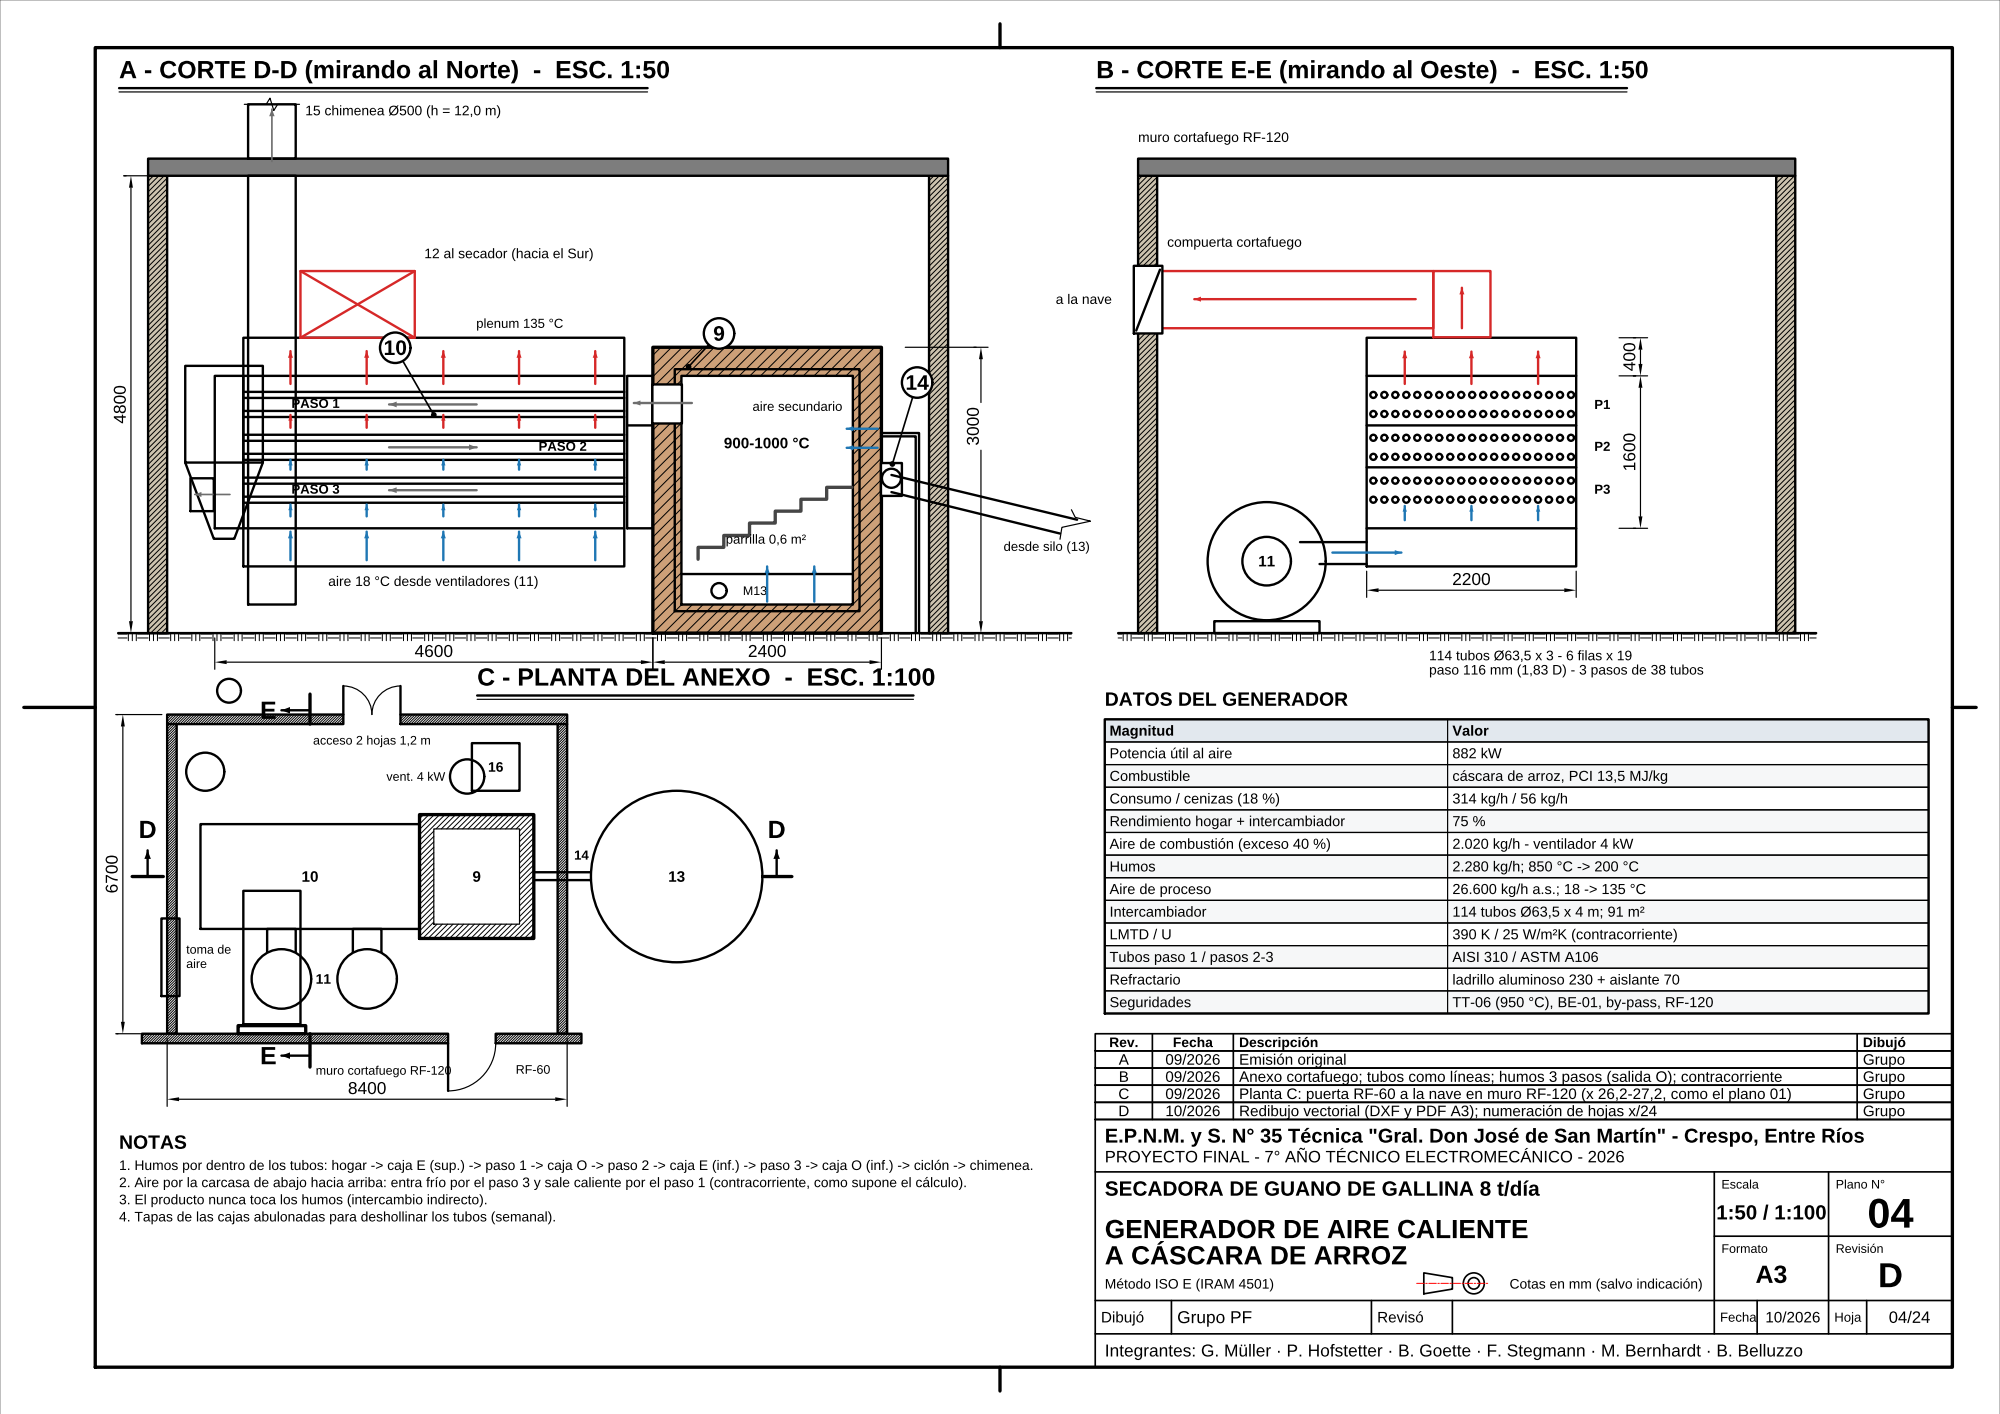
[picture p163: page 1]
