lagzgabrielmuller-dot/planta-secadora-guano/planos/pdf/P05.pdf

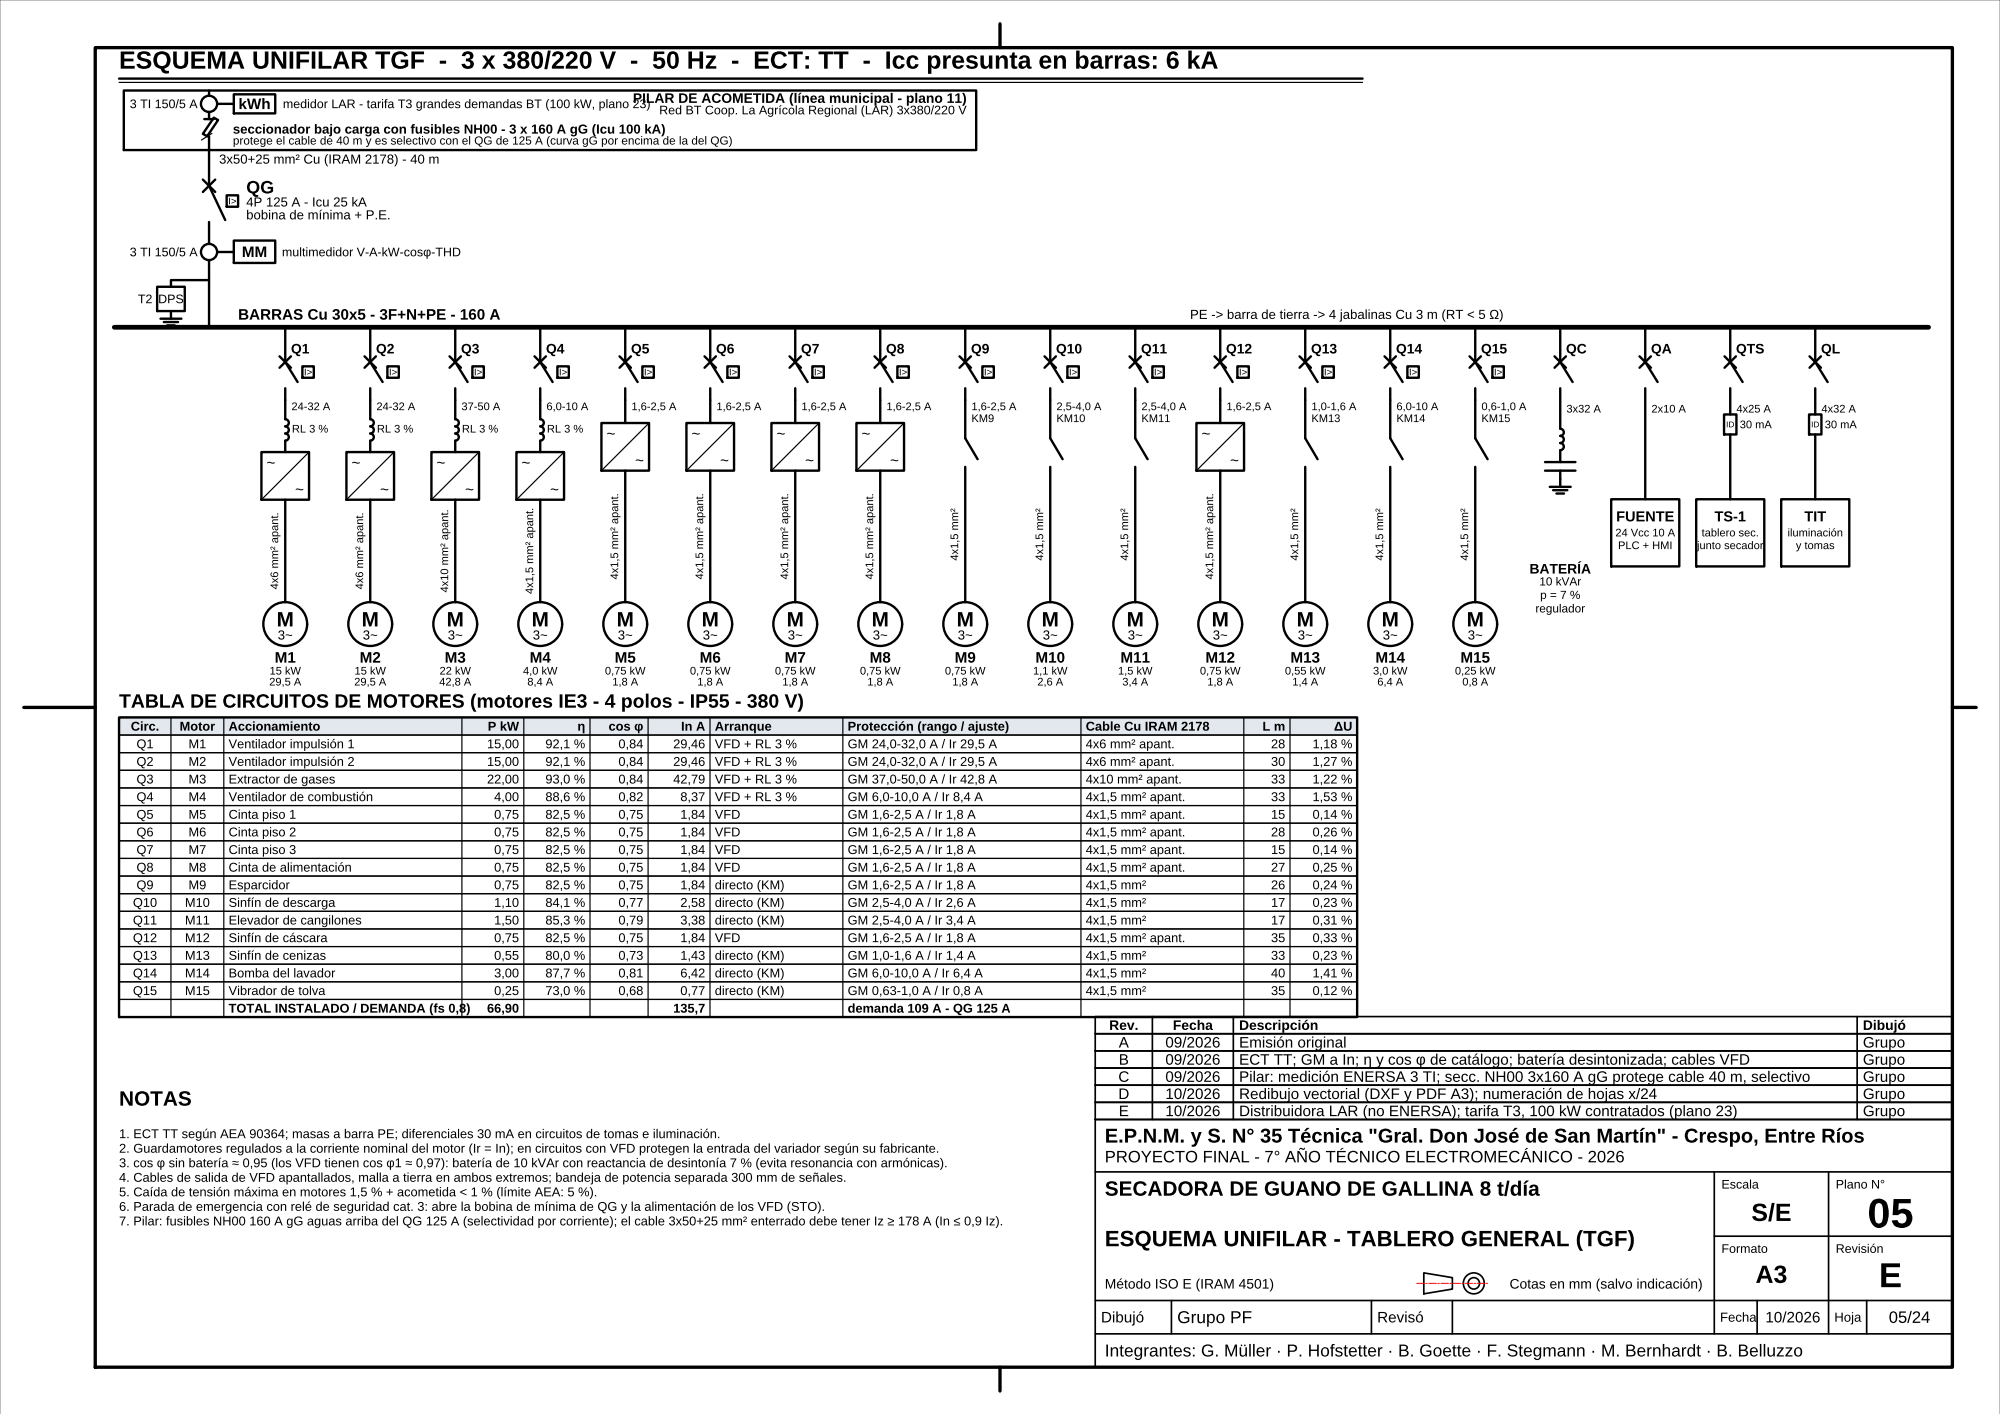
[picture p164: page 1]
