lagzgabrielmuller-dot/planta-secadora-guano/planos/pdf/P06.pdf

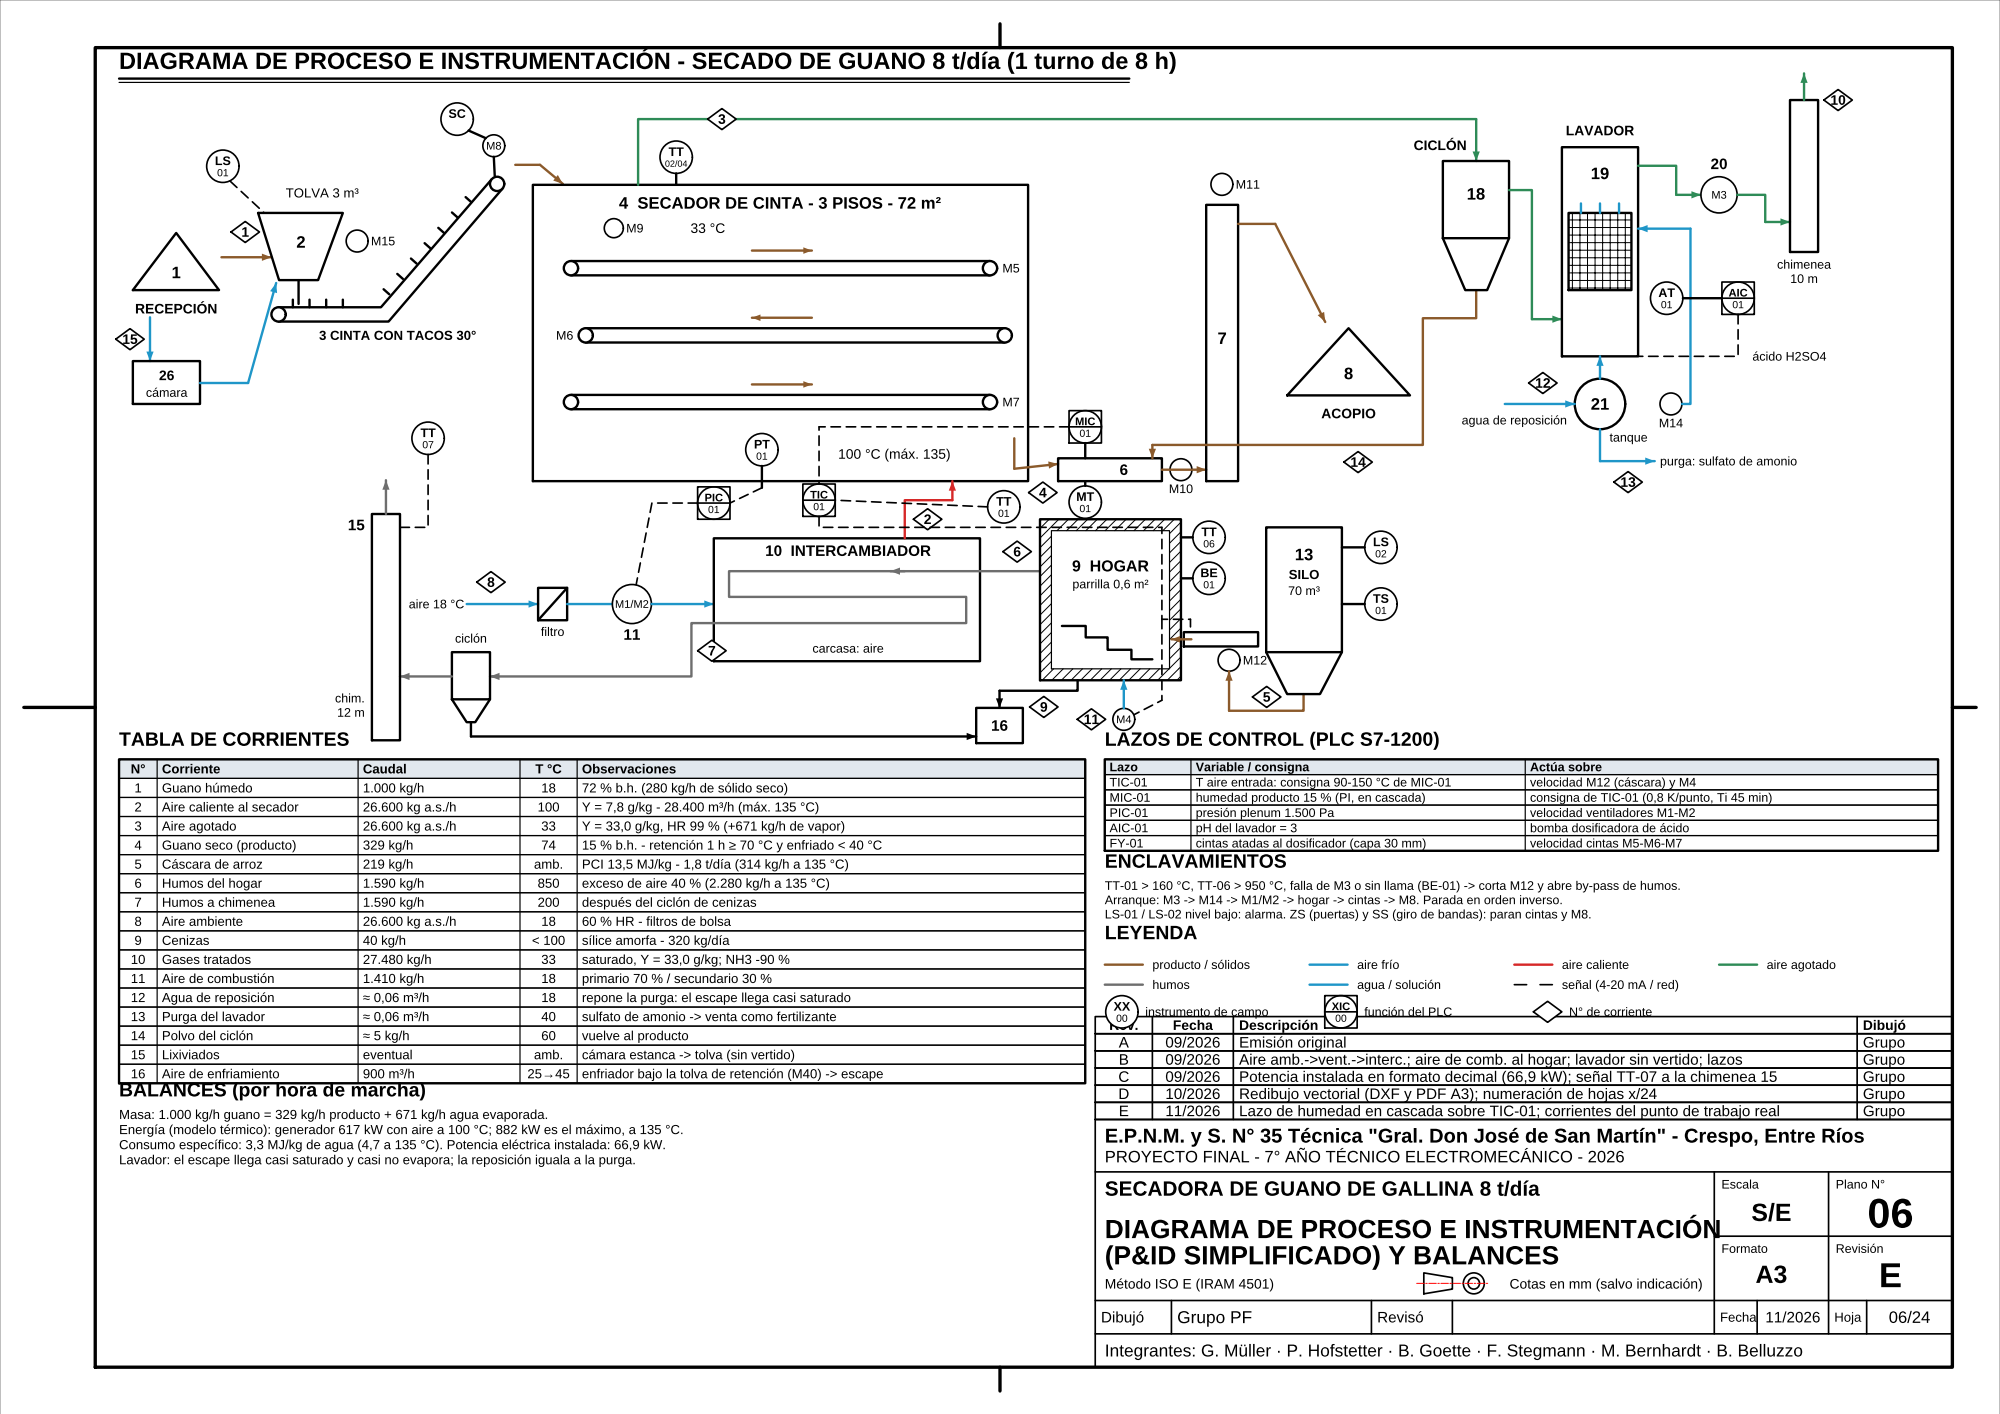
[picture p165: page 1]
