lagzgabrielmuller-dot/planta-secadora-guano/planos/pdf/P07.pdf

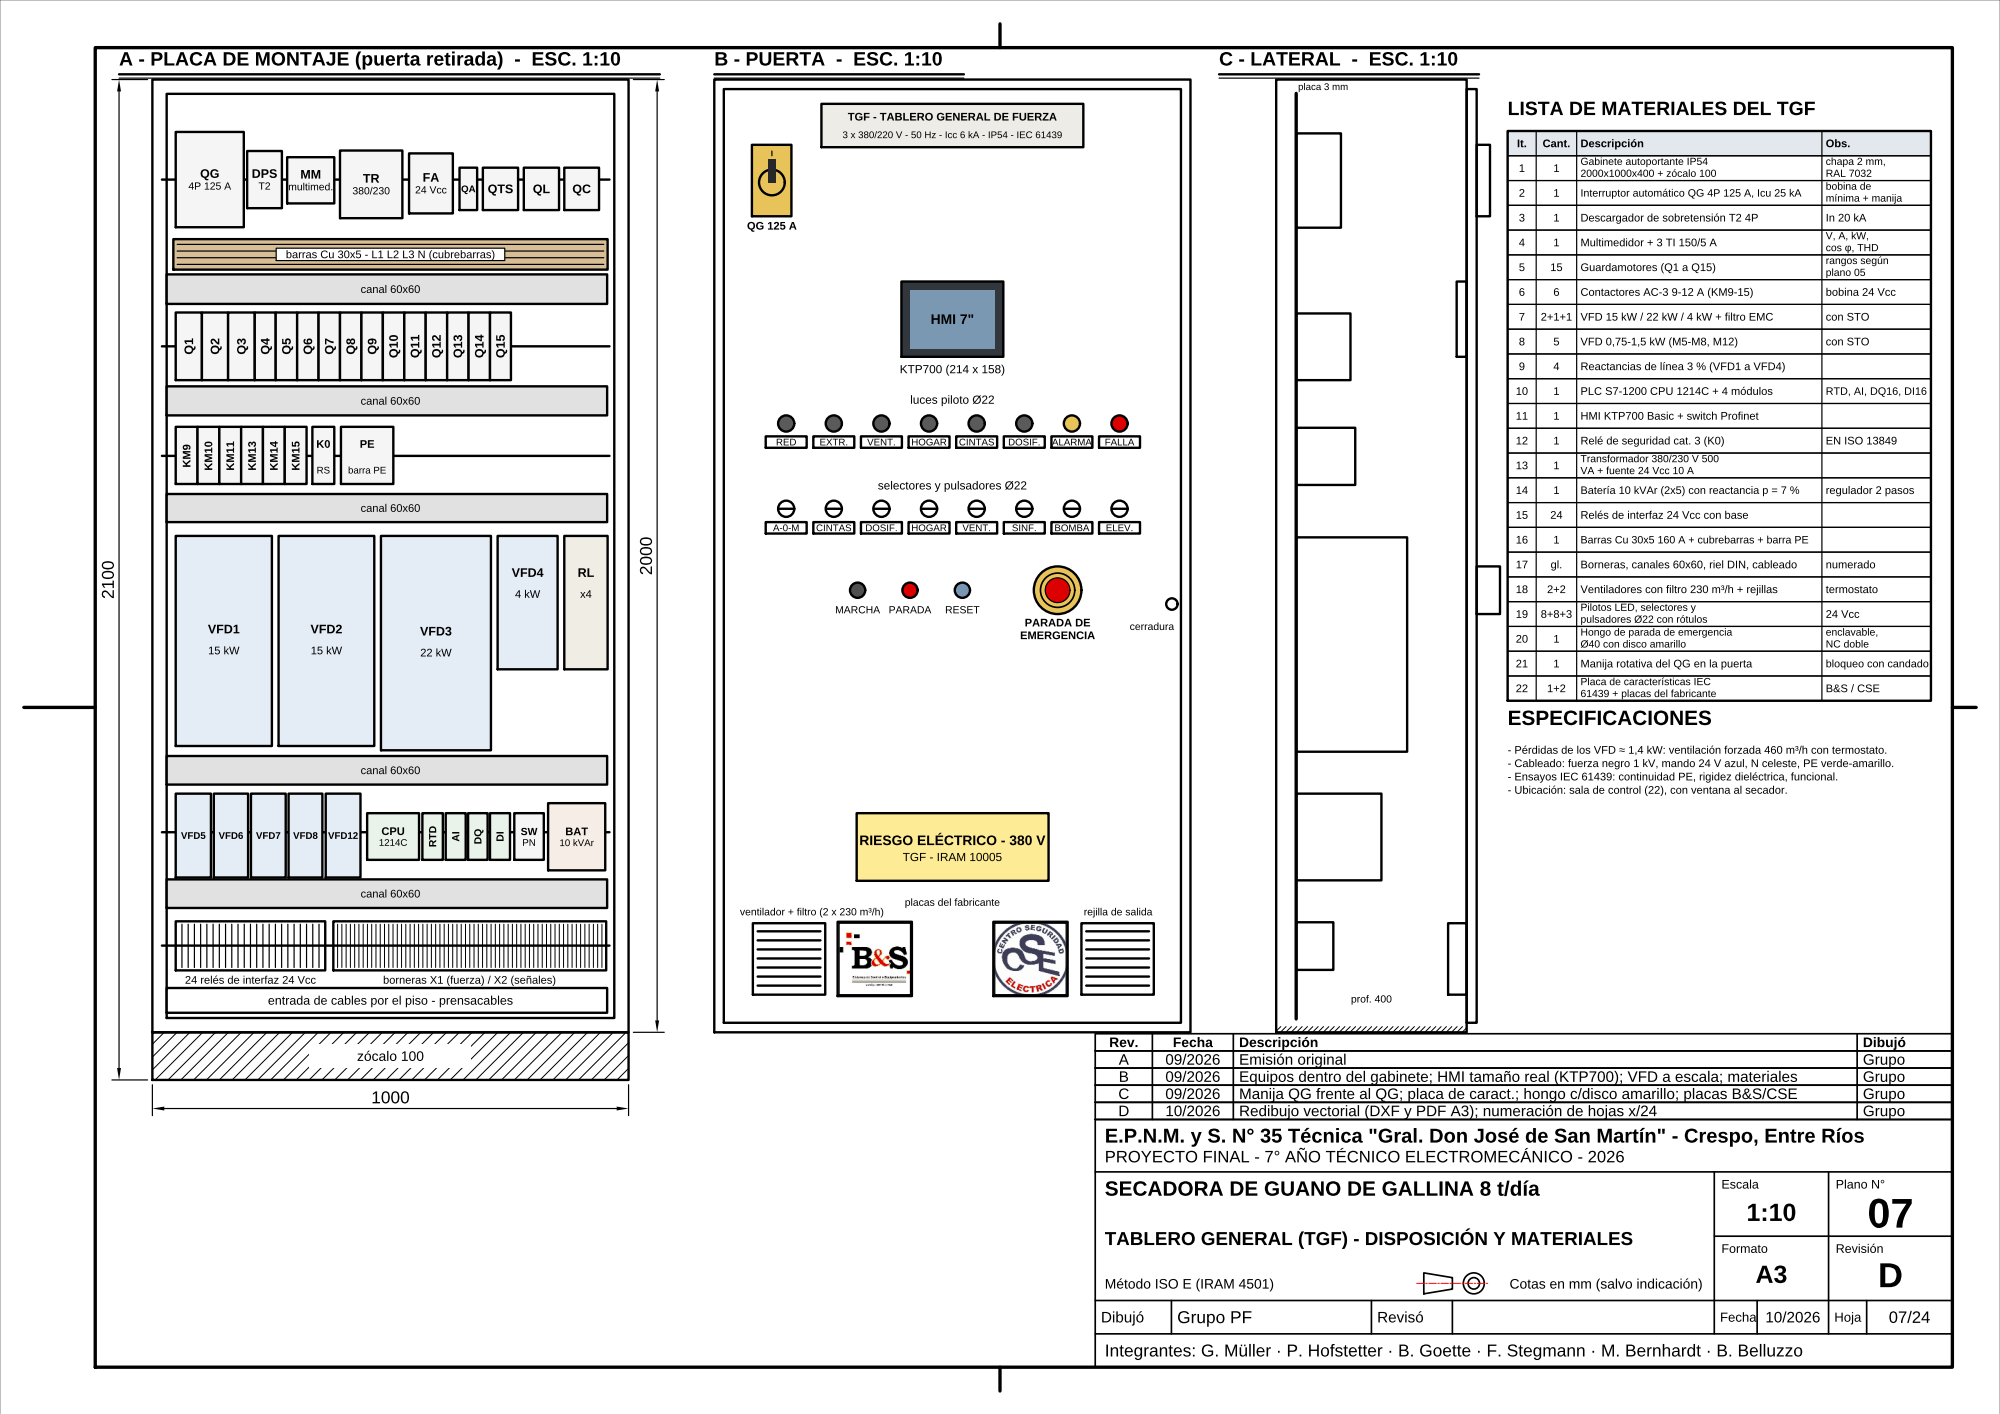
[picture p166: page 1]
