lagzgabrielmuller-dot/planta-secadora-guano/planos/pdf/P08.pdf

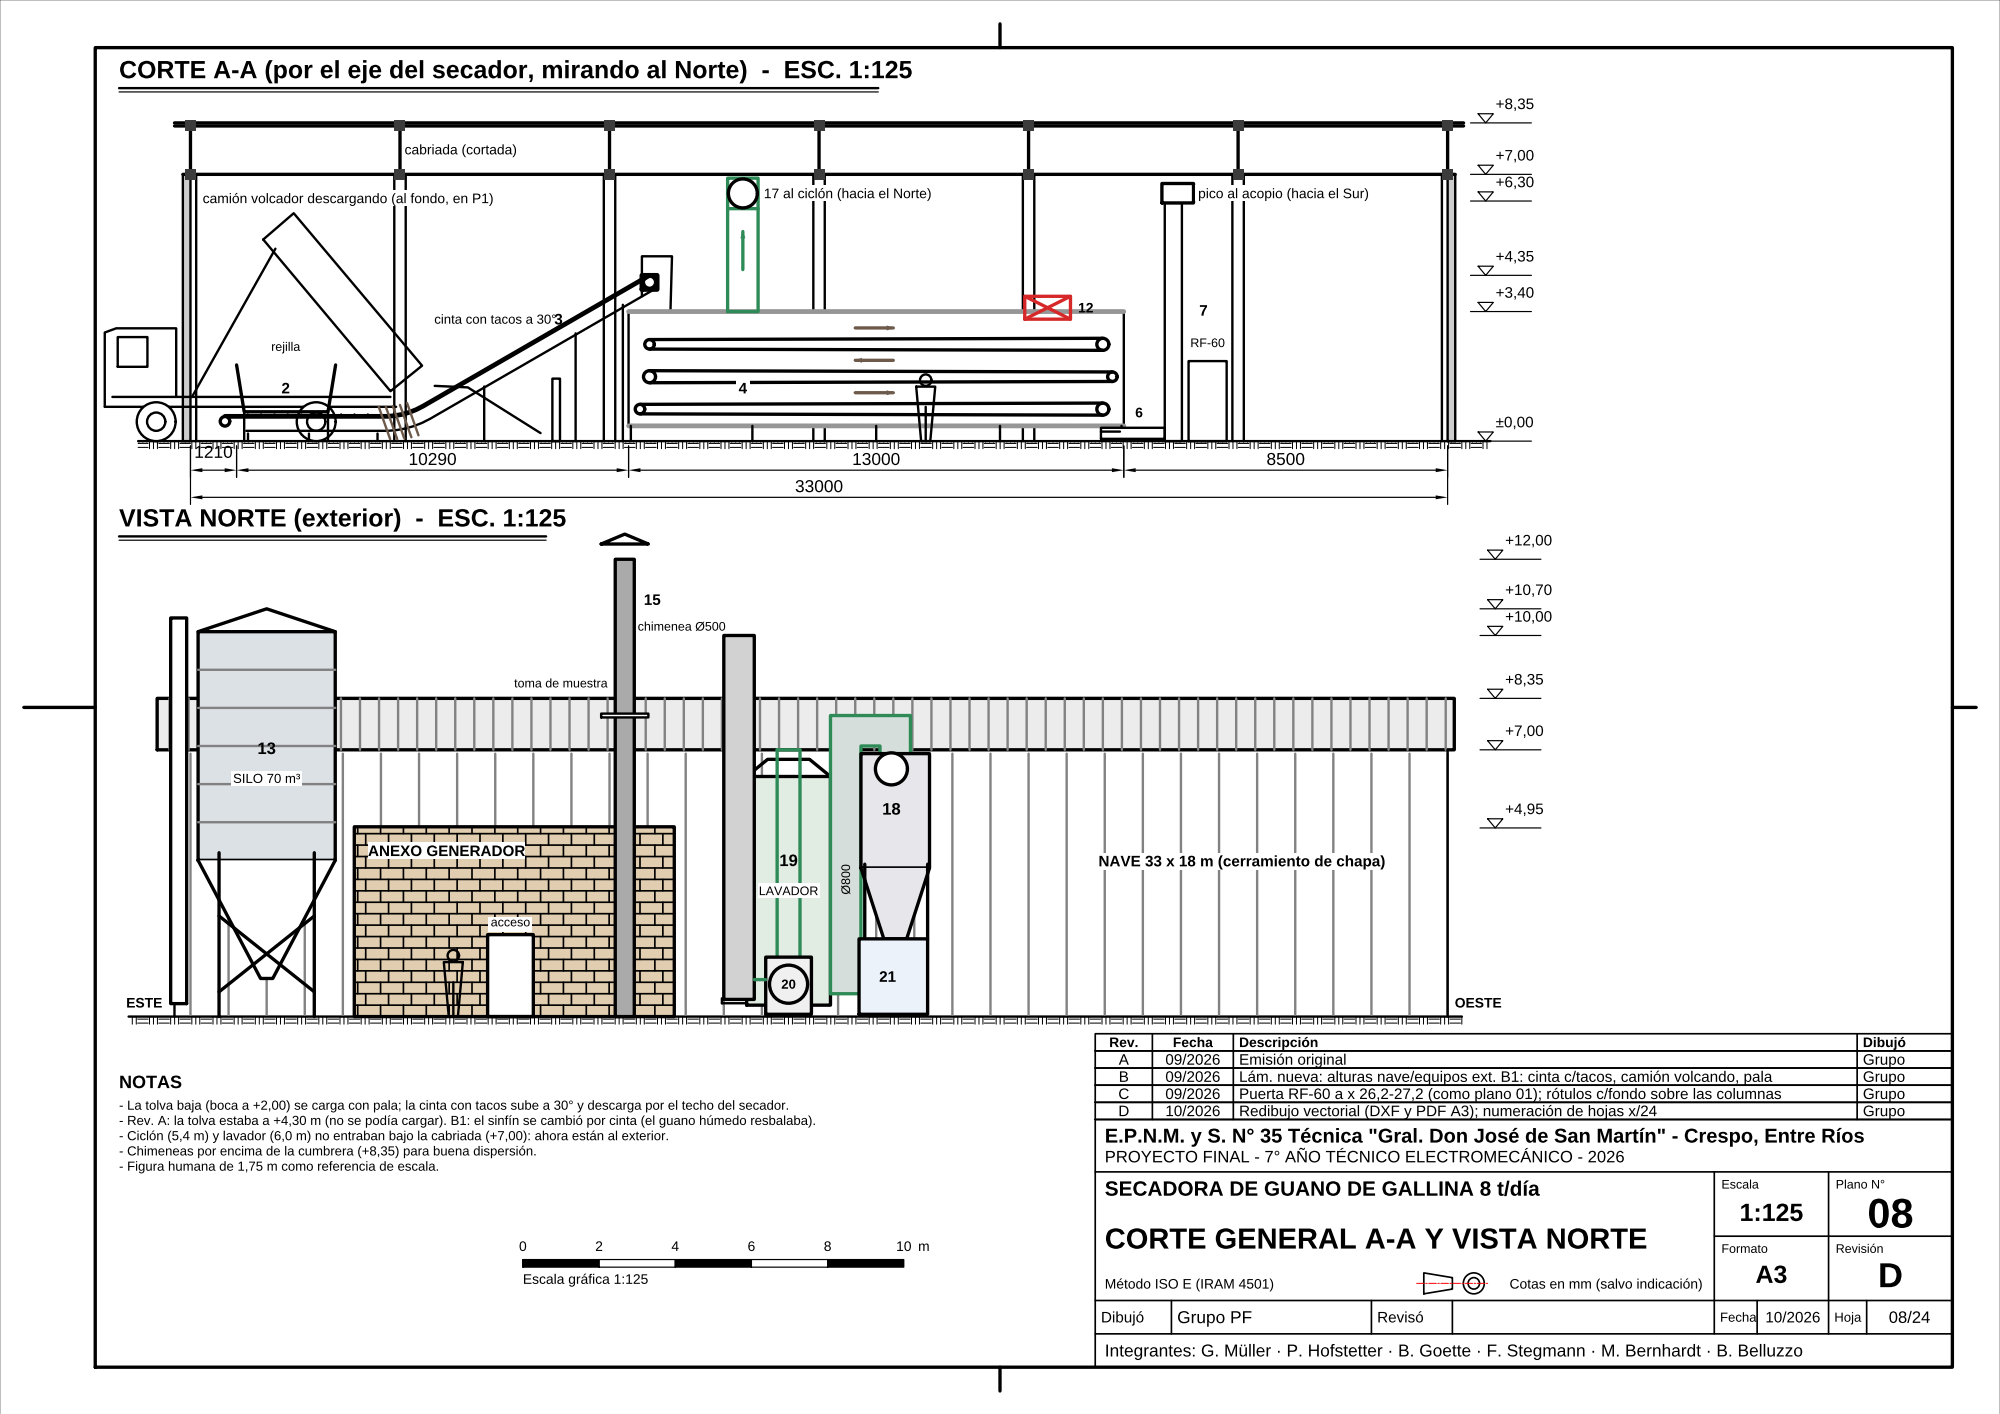
[picture p167: page 1]
