lagzgabrielmuller-dot/planta-secadora-guano/planos/pdf/P09.pdf

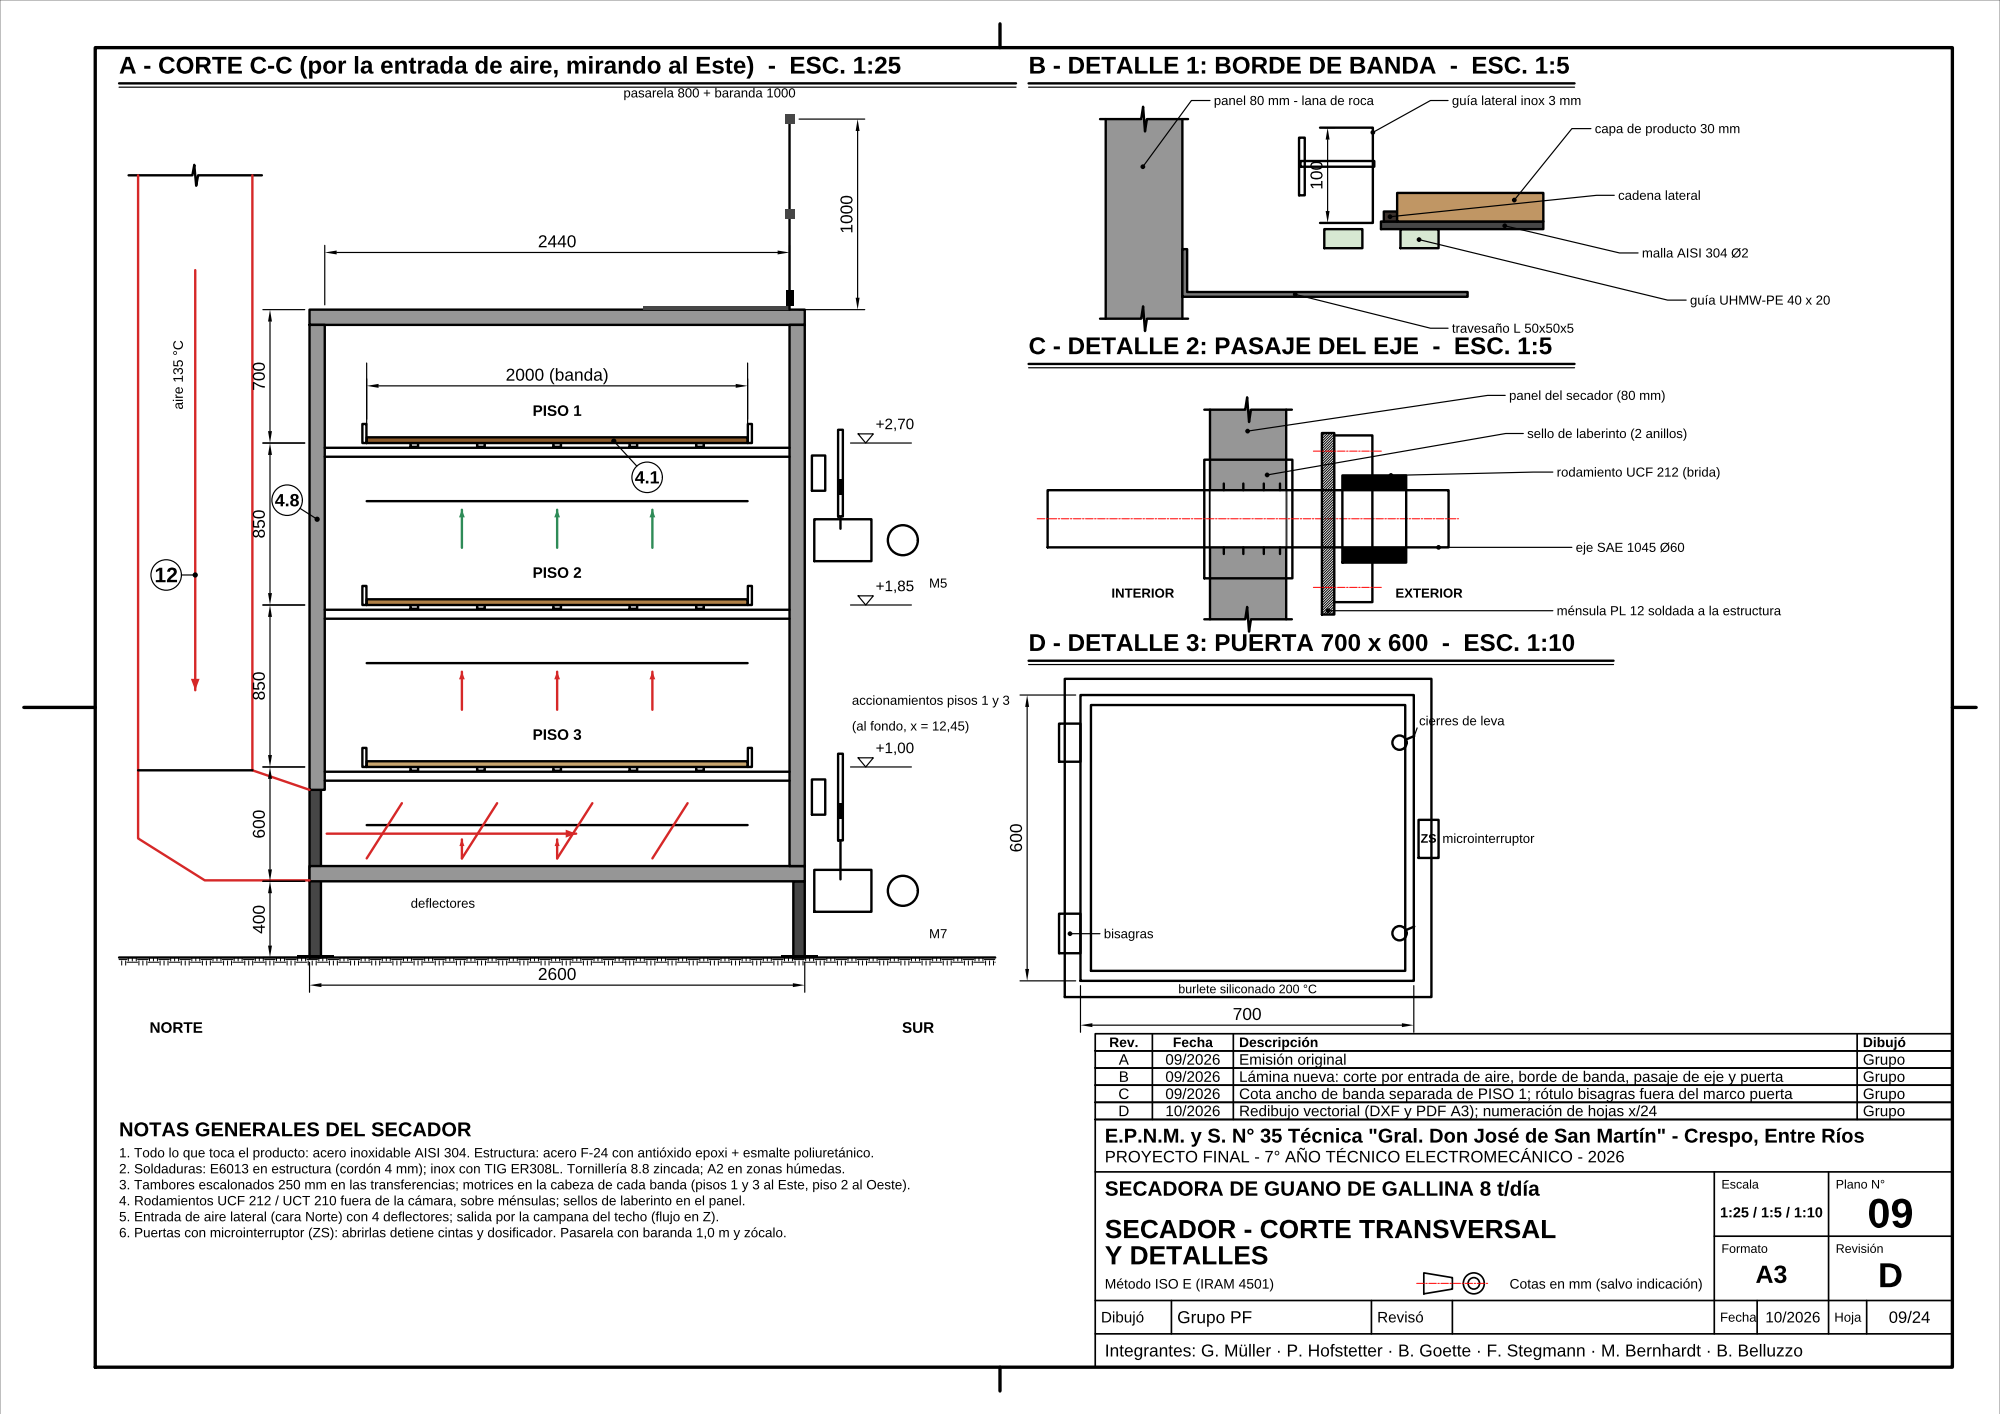
[picture p168: page 1]
