lagzgabrielmuller-dot/planta-secadora-guano/planos/pdf/P10.pdf

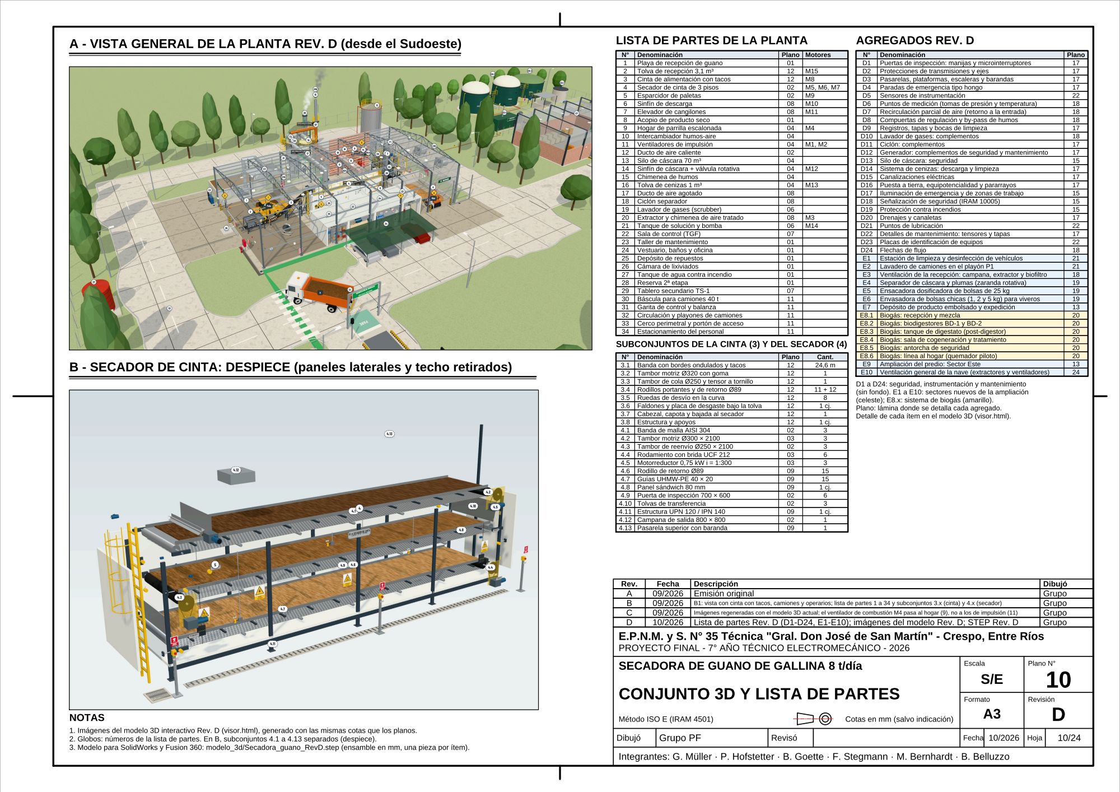
[picture p169: page 1]
