lagzgabrielmuller-dot/planta-secadora-guano/planos/pdf/P11.pdf

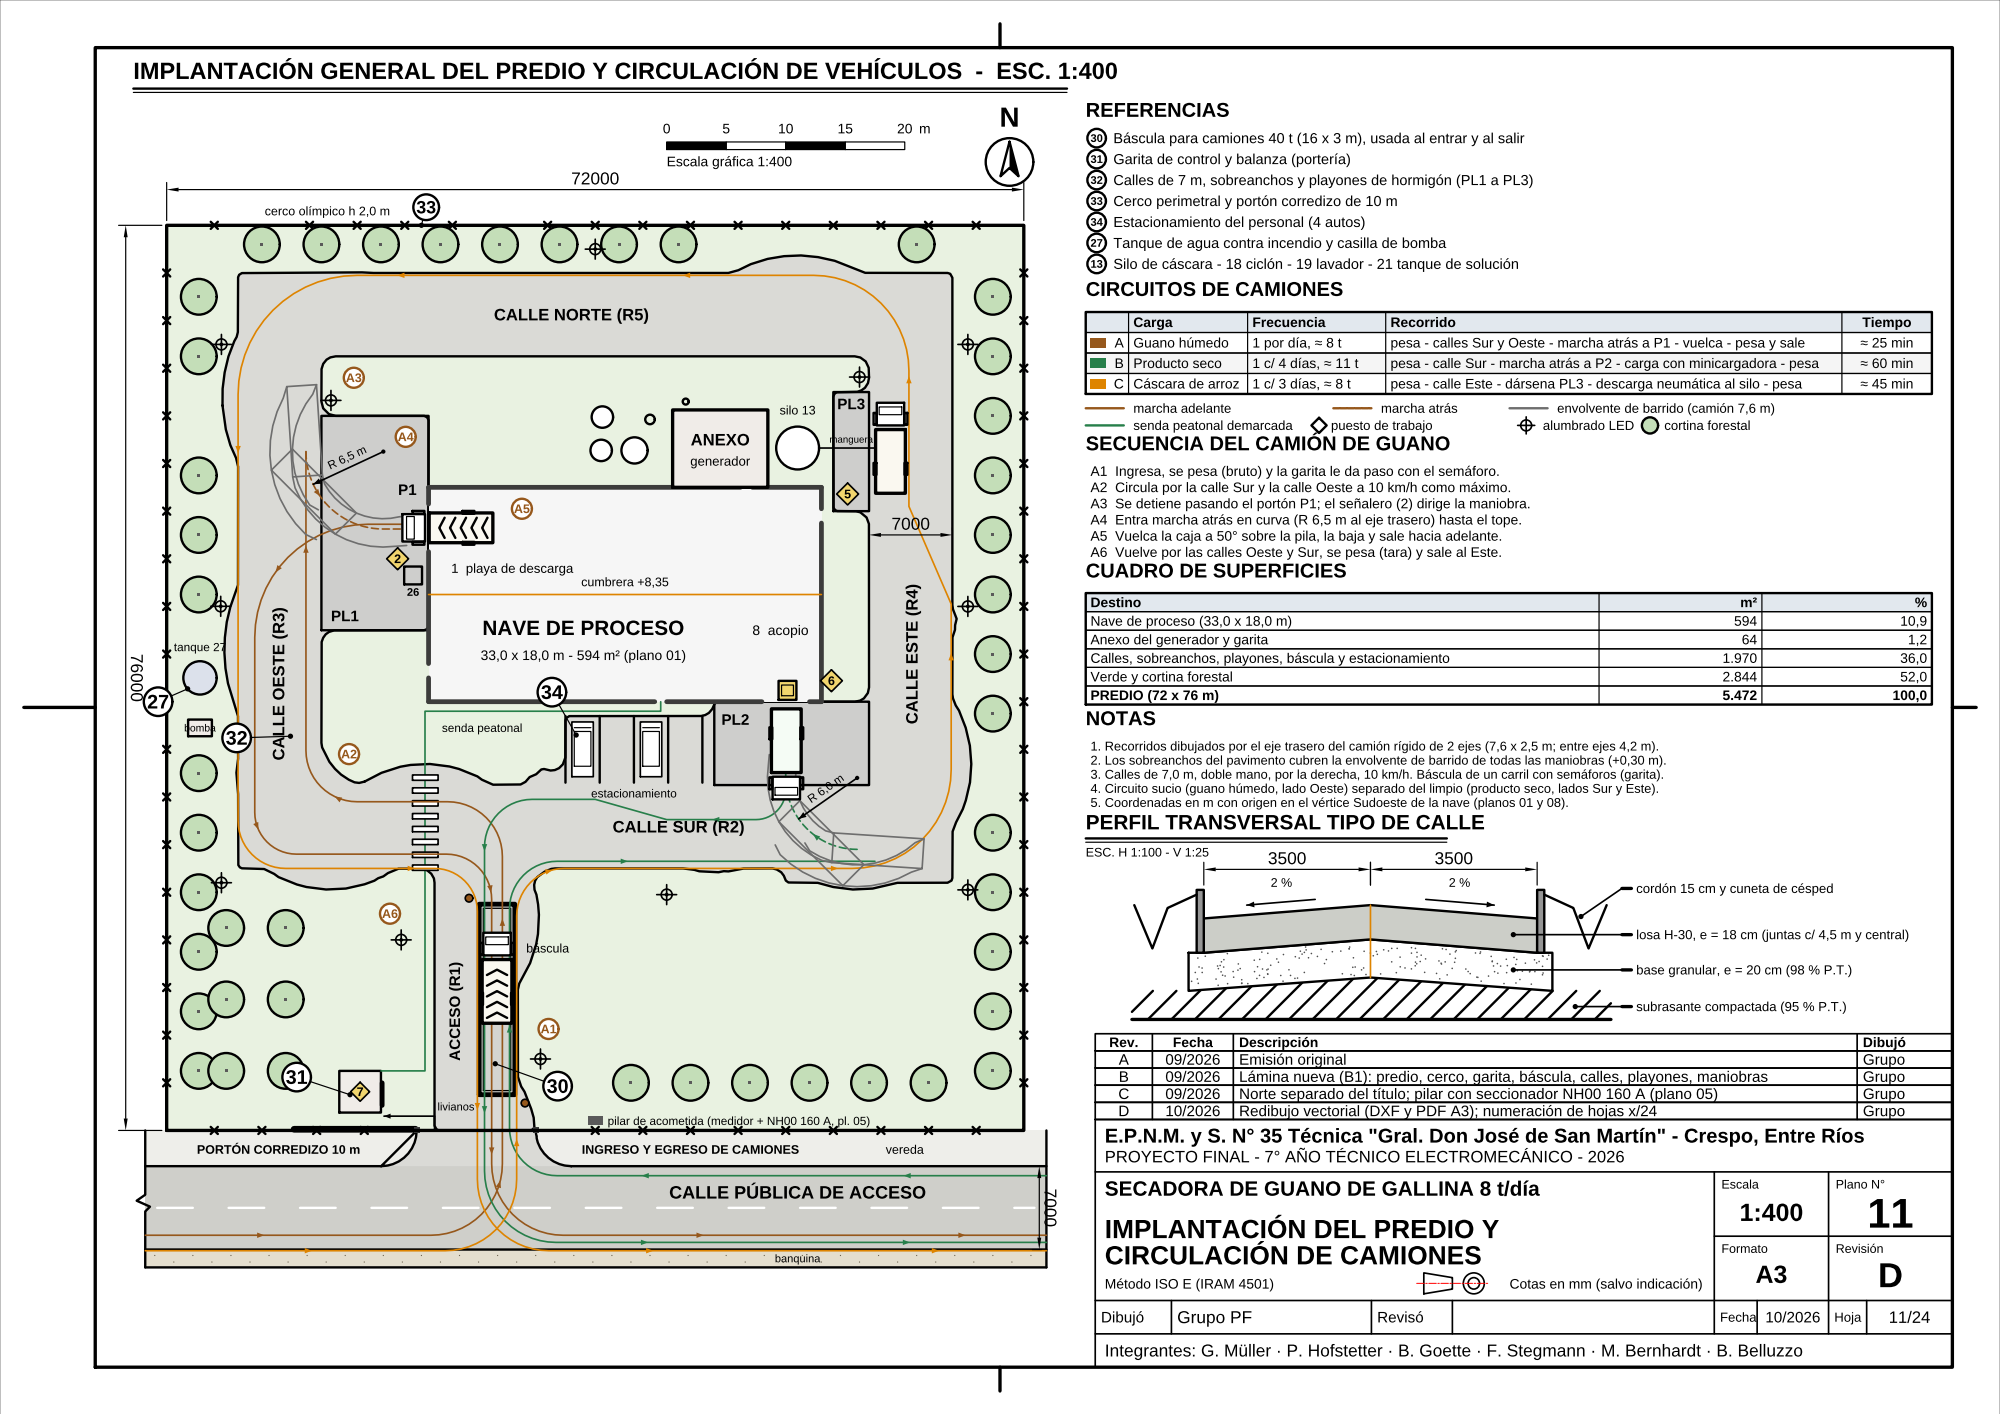
[picture p170: page 1]
