lagzgabrielmuller-dot/planta-secadora-guano/planos/pdf/P12.pdf

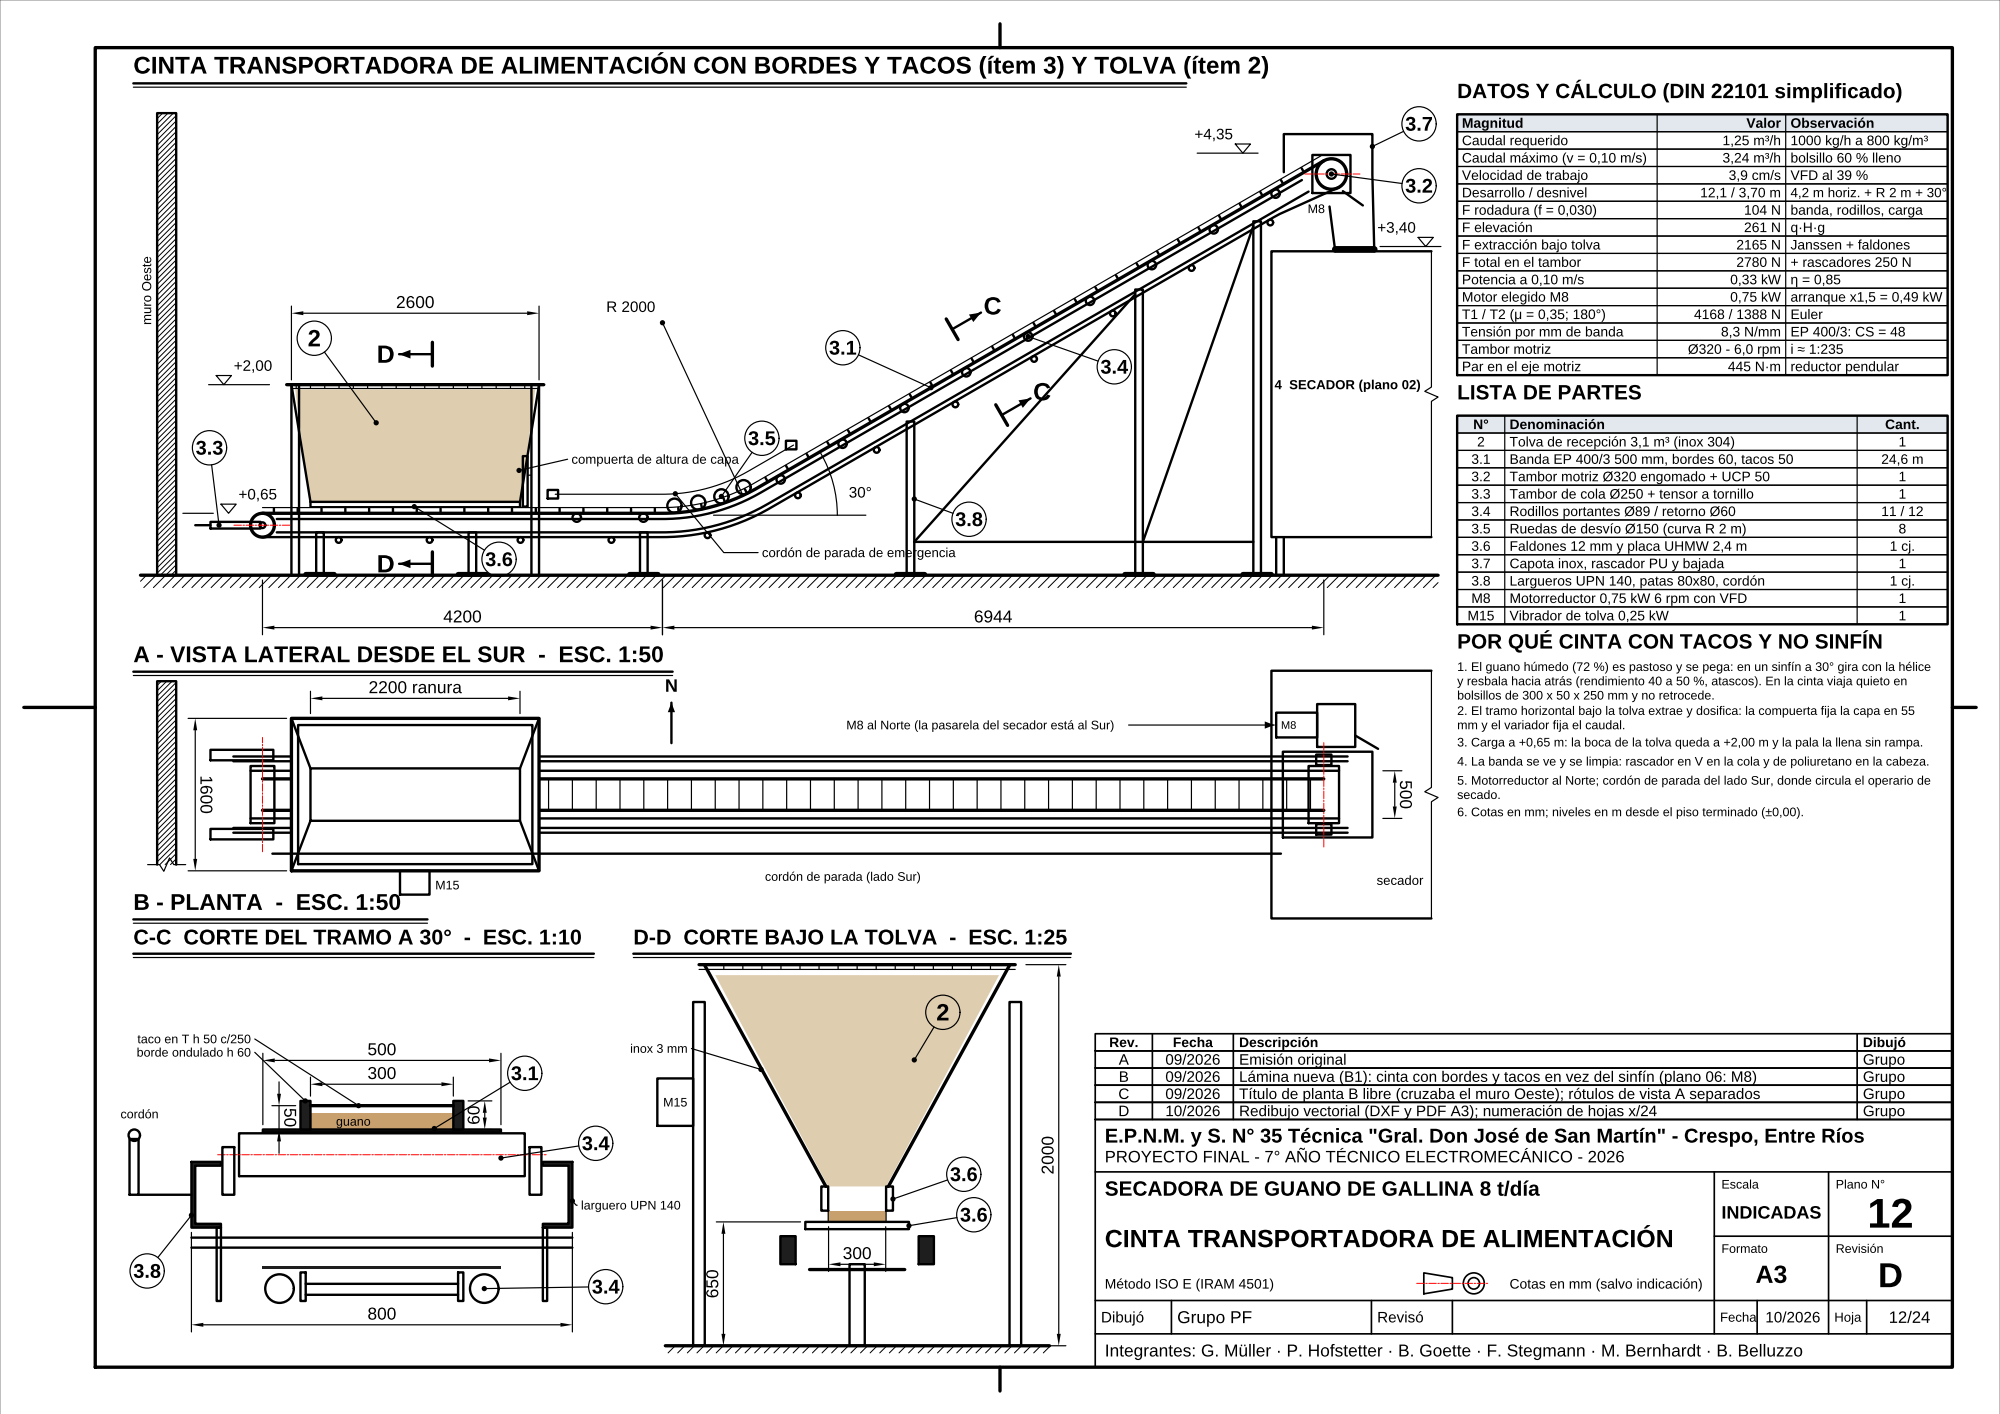
[picture p171: page 1]
