lagzgabrielmuller-dot/planta-secadora-guano/planos/pdf/P13.pdf

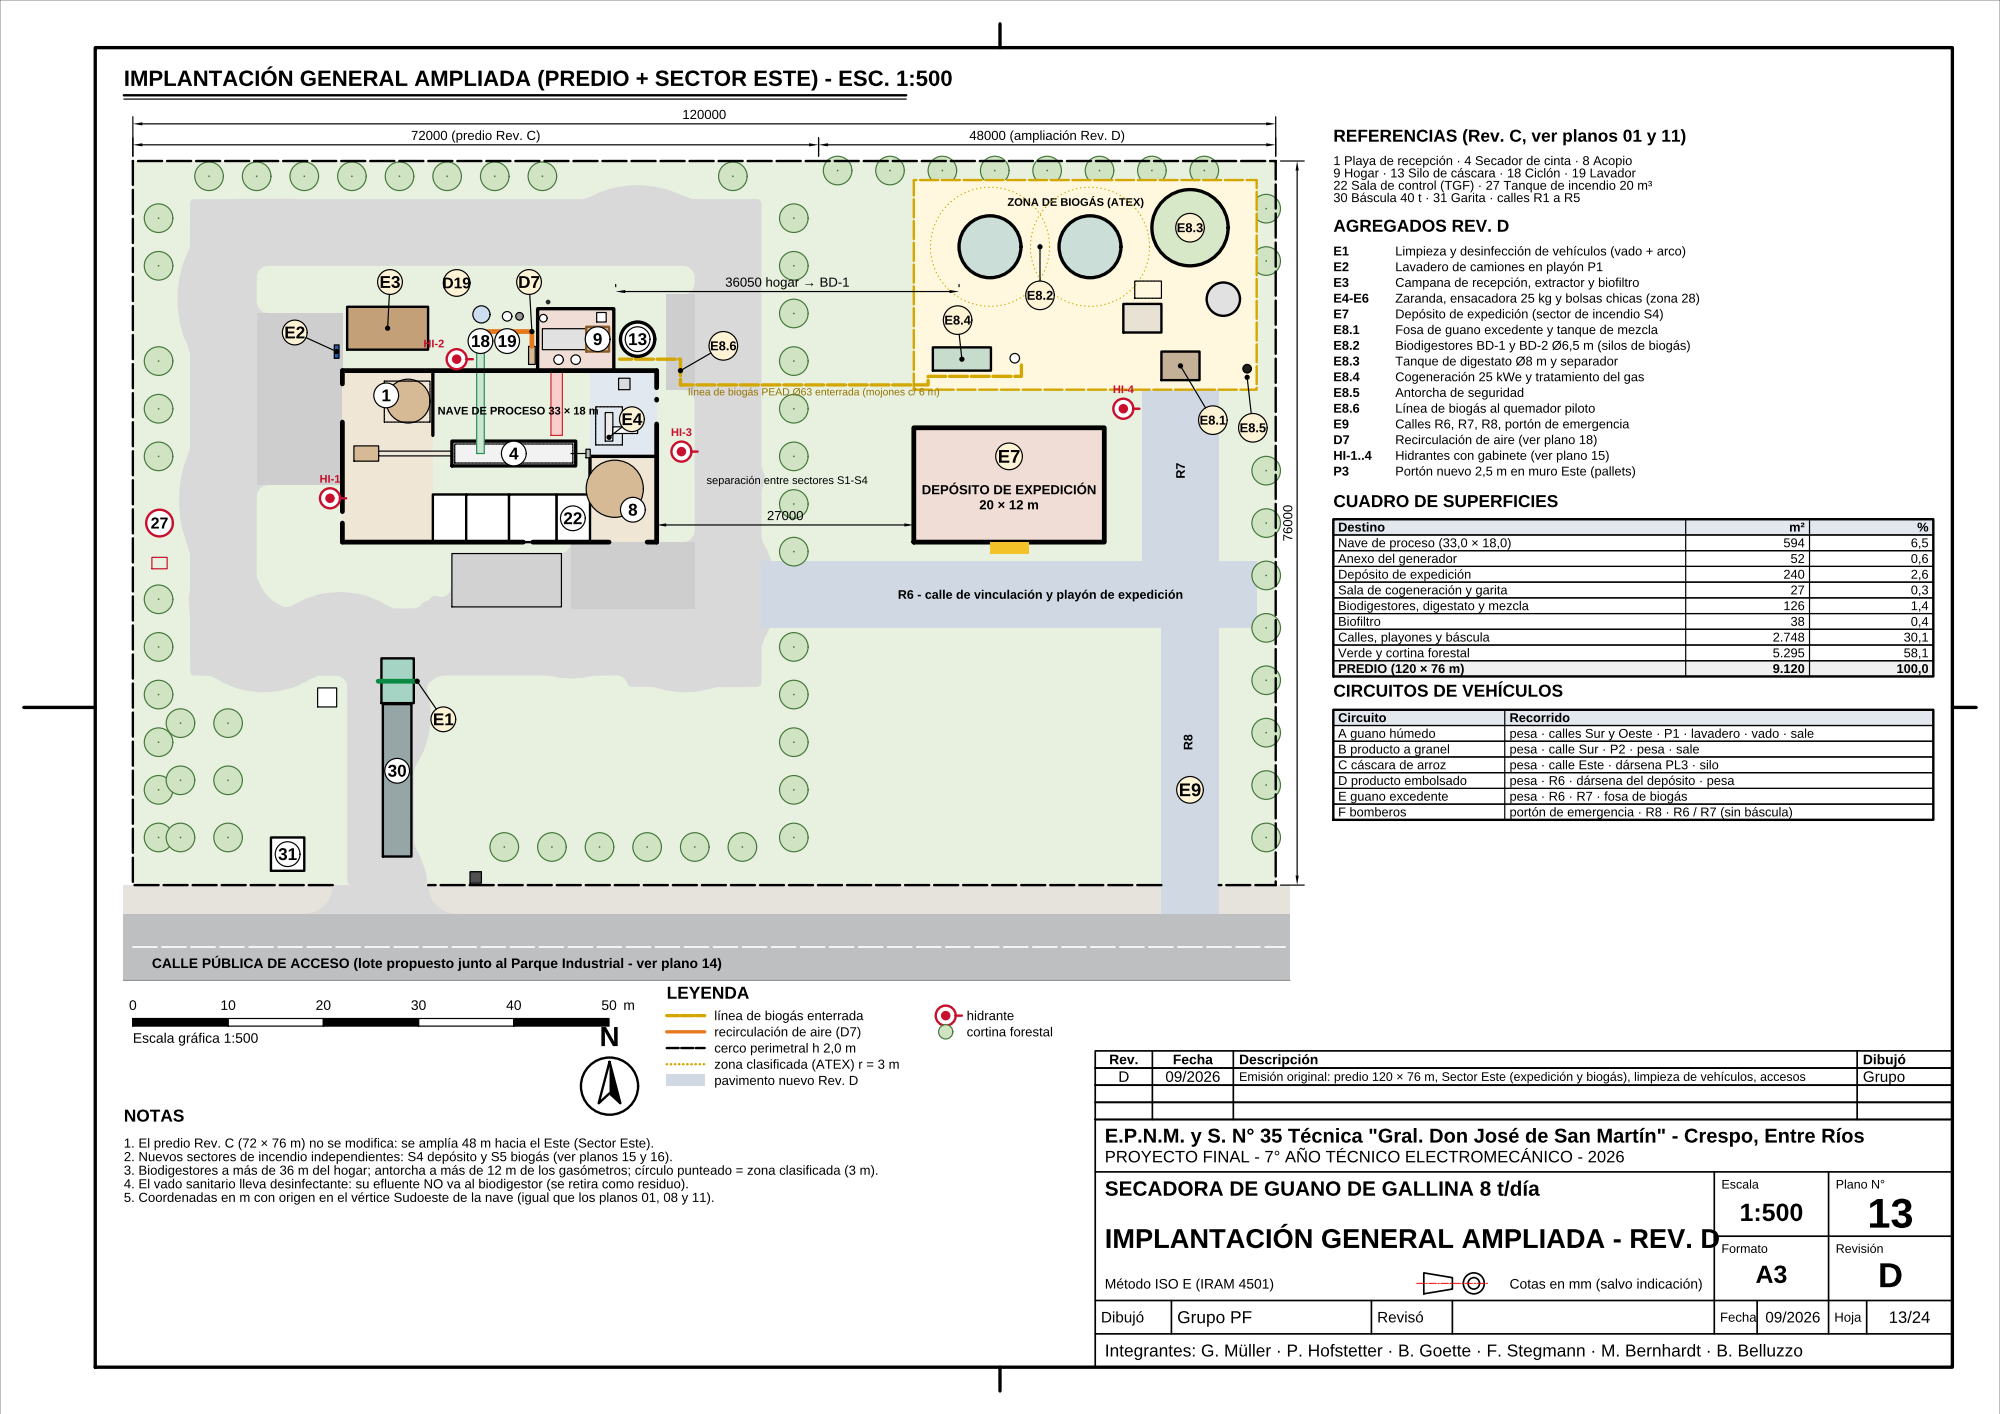
[picture p172: page 1]
