lagzgabrielmuller-dot/planta-secadora-guano/planos/pdf/P14.pdf

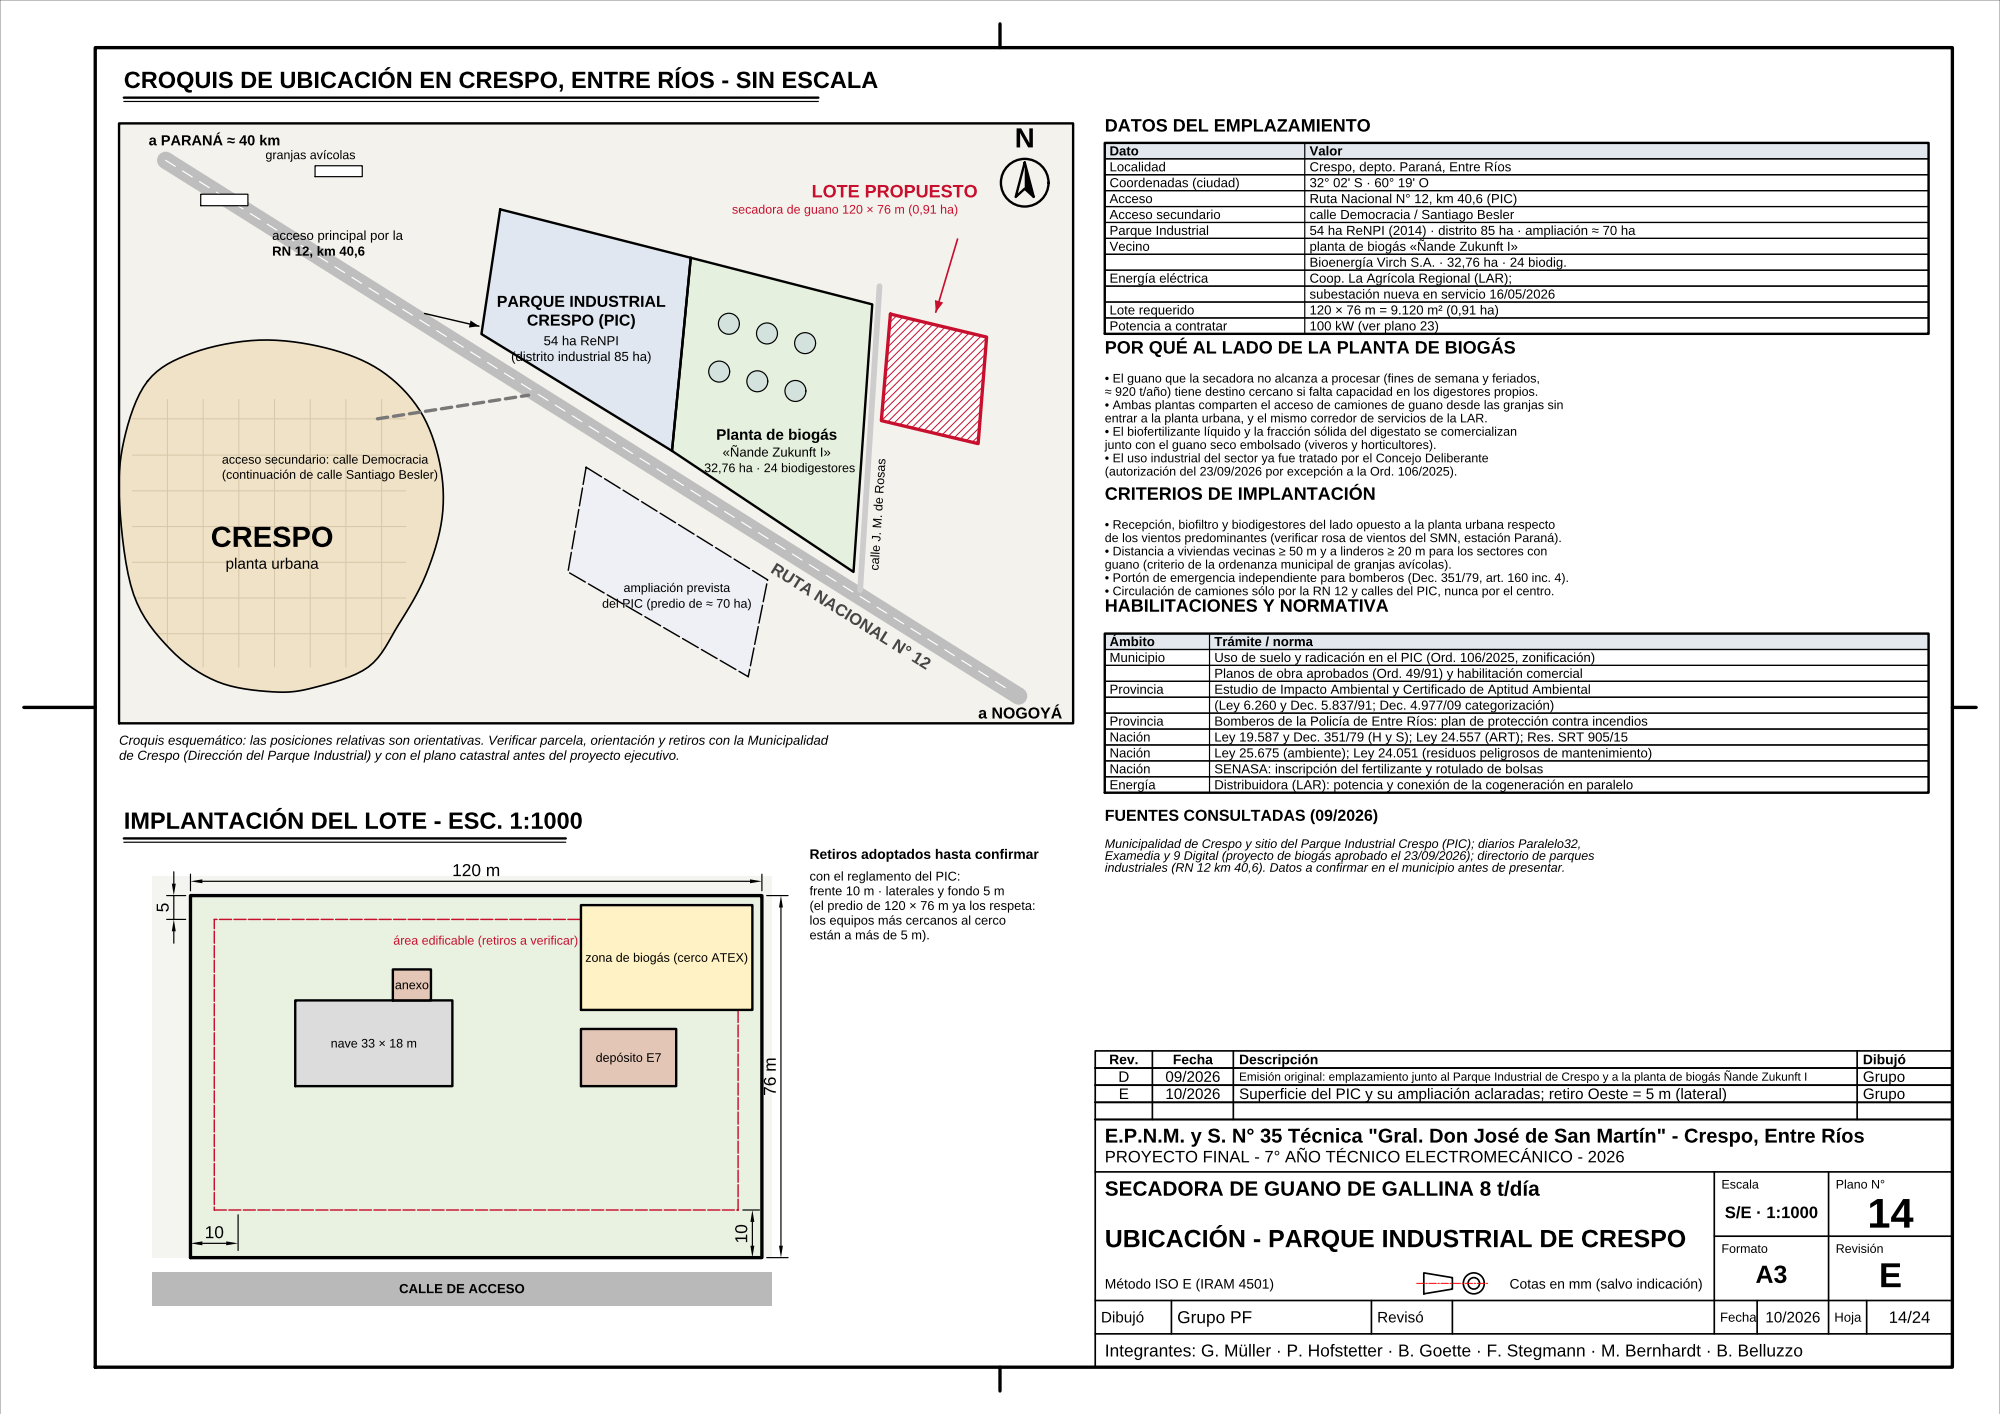
[picture p173: page 1]
