lagzgabrielmuller-dot/planta-secadora-guano/planos/pdf/P15.pdf

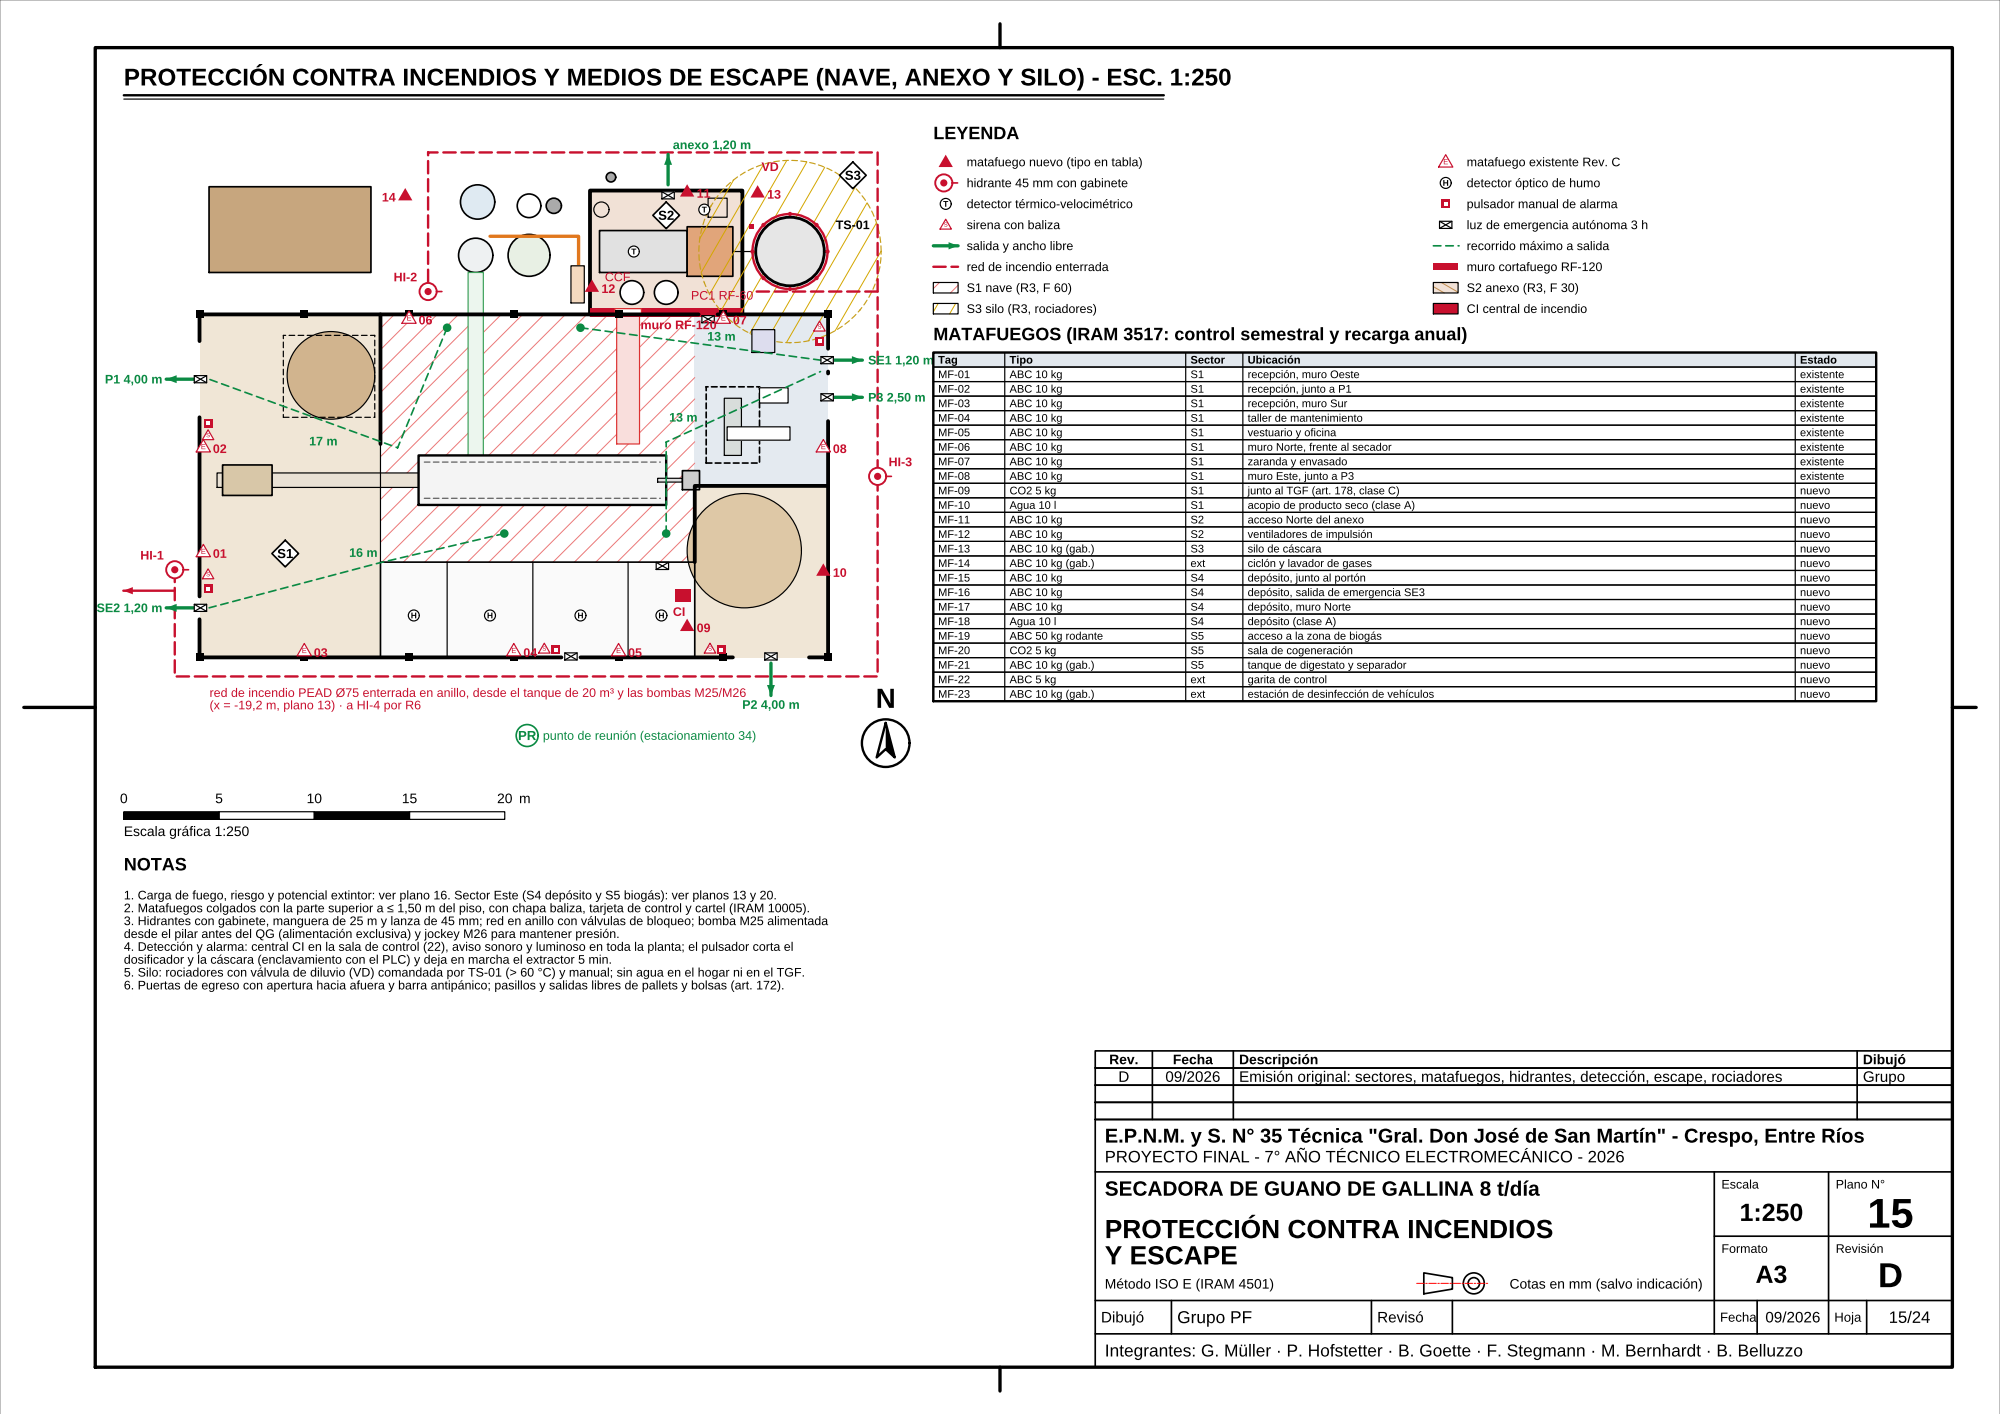
[picture p174: page 1]
