lagzgabrielmuller-dot/planta-secadora-guano/planos/pdf/P16.pdf

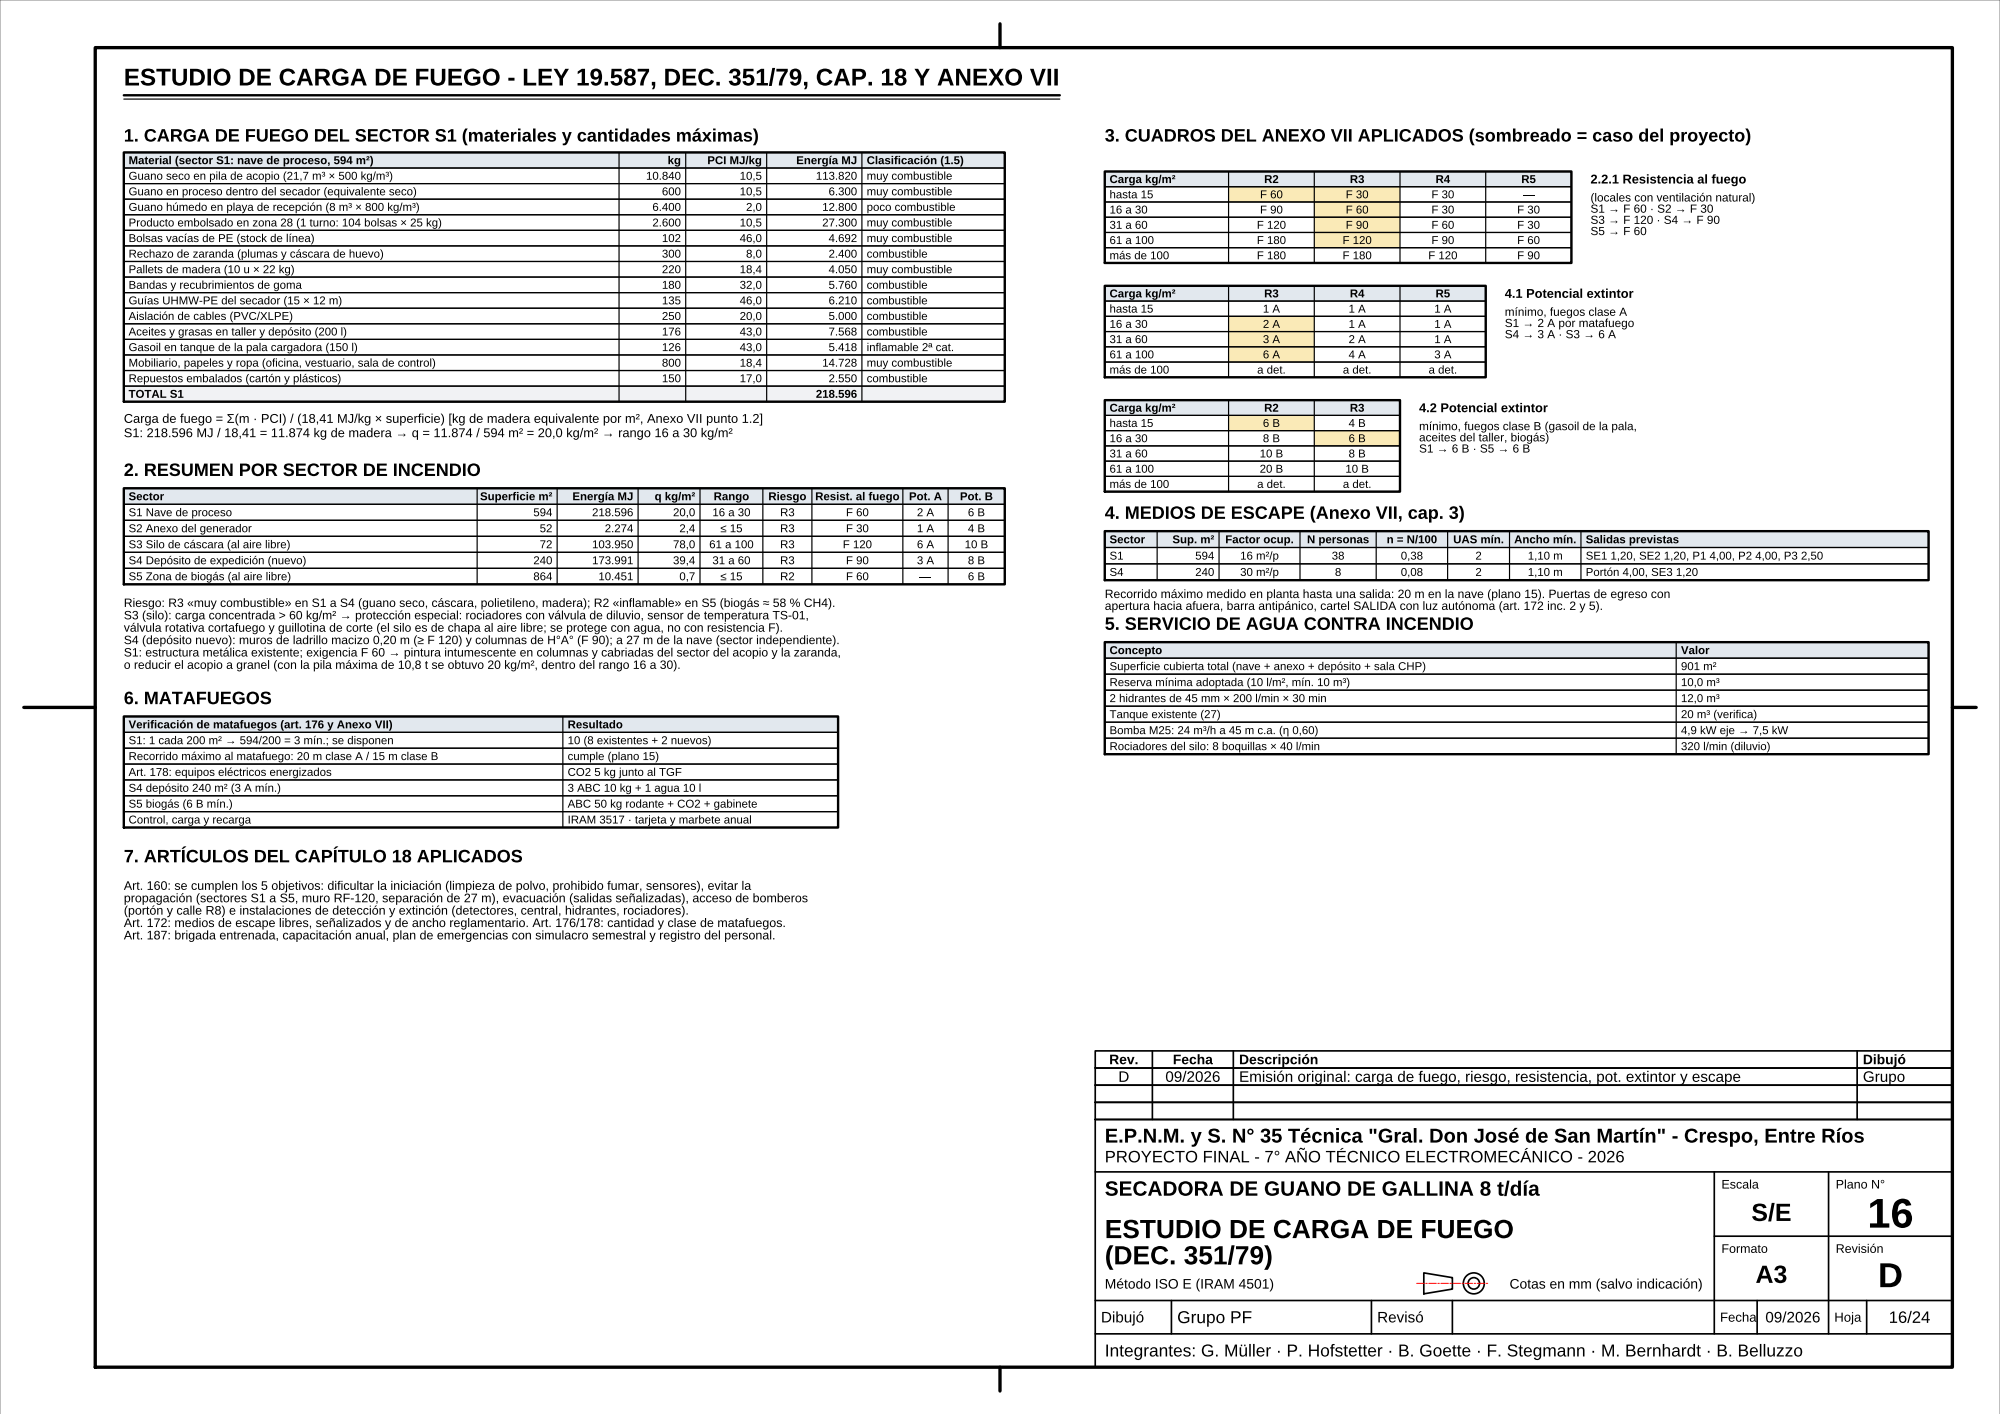
[picture p175: page 1]
