lagzgabrielmuller-dot/planta-secadora-guano/planos/pdf/P17.pdf

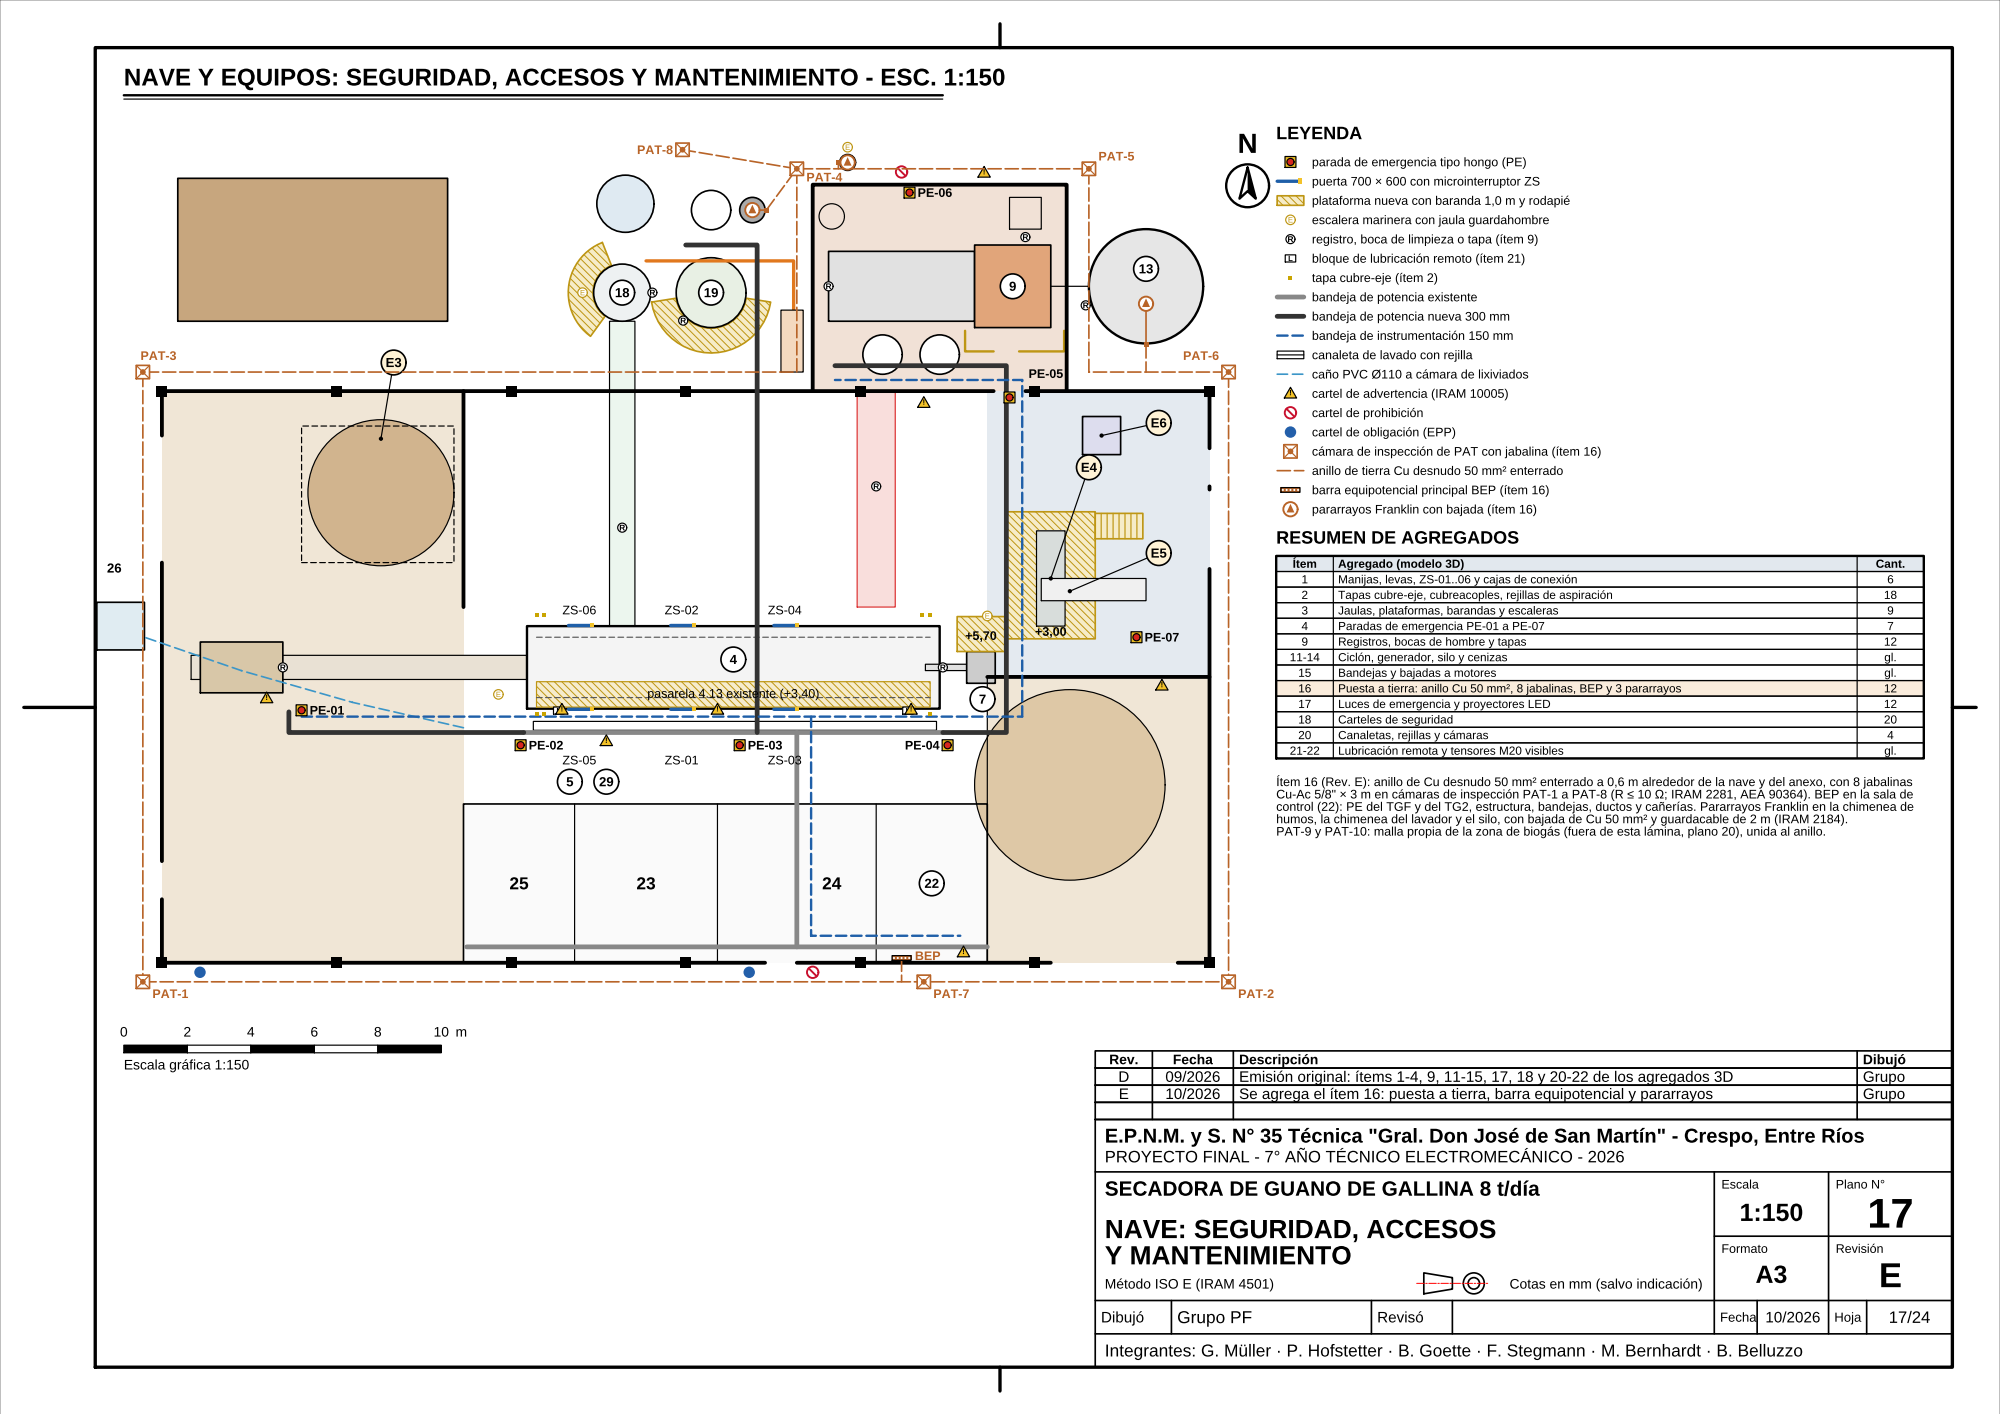
[picture p176: page 1]
