lagzgabrielmuller-dot/planta-secadora-guano/planos/pdf/P18.pdf

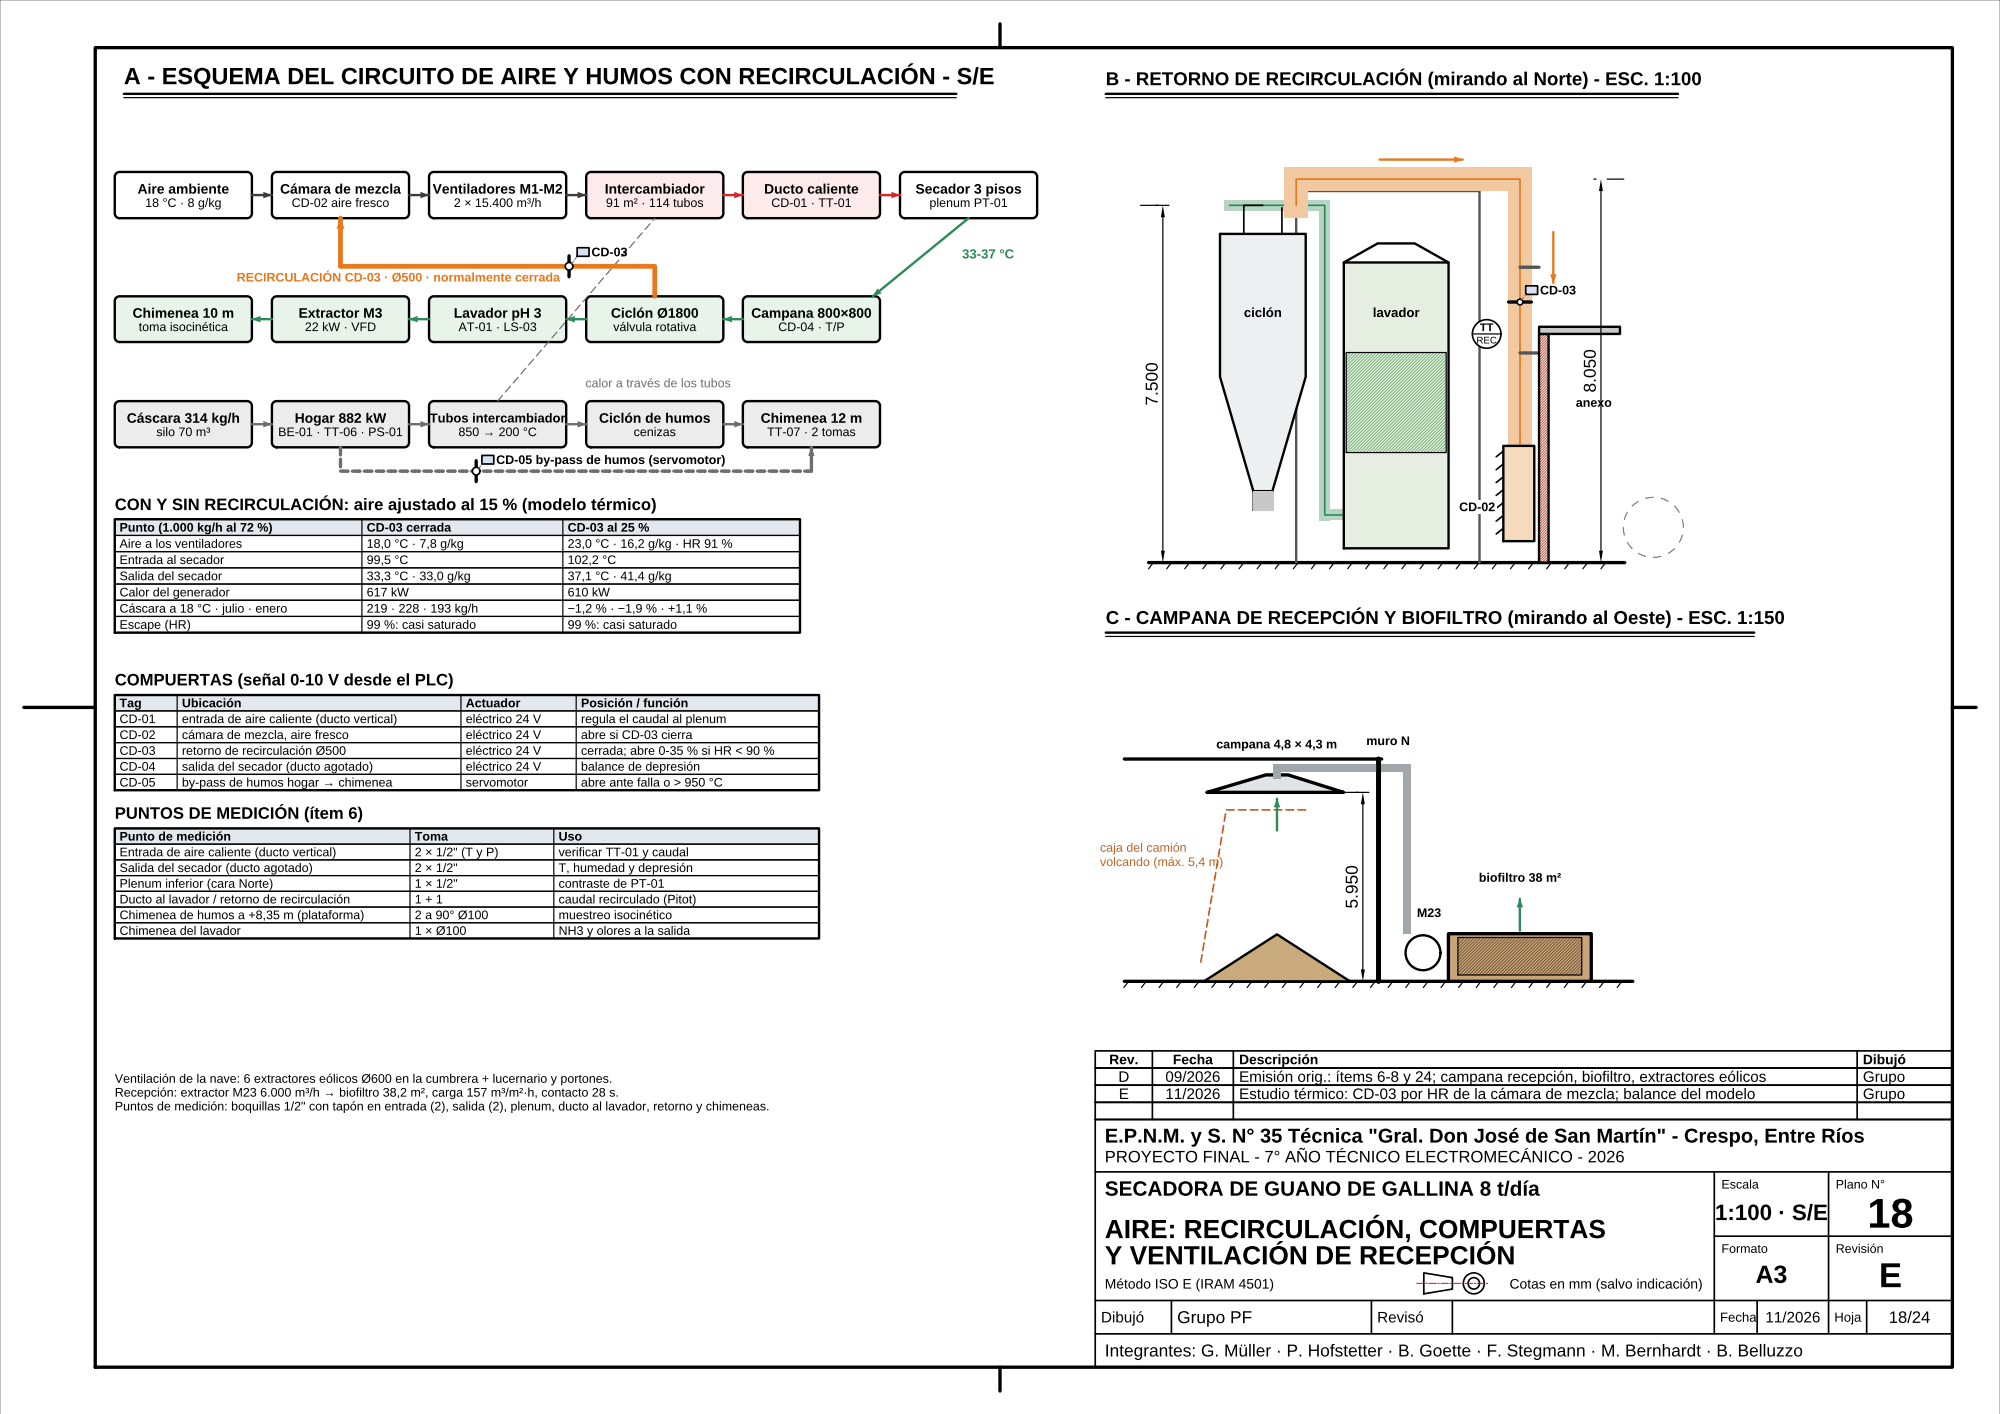
[picture p177: page 1]
