lagzgabrielmuller-dot/planta-secadora-guano/planos/pdf/P19.pdf

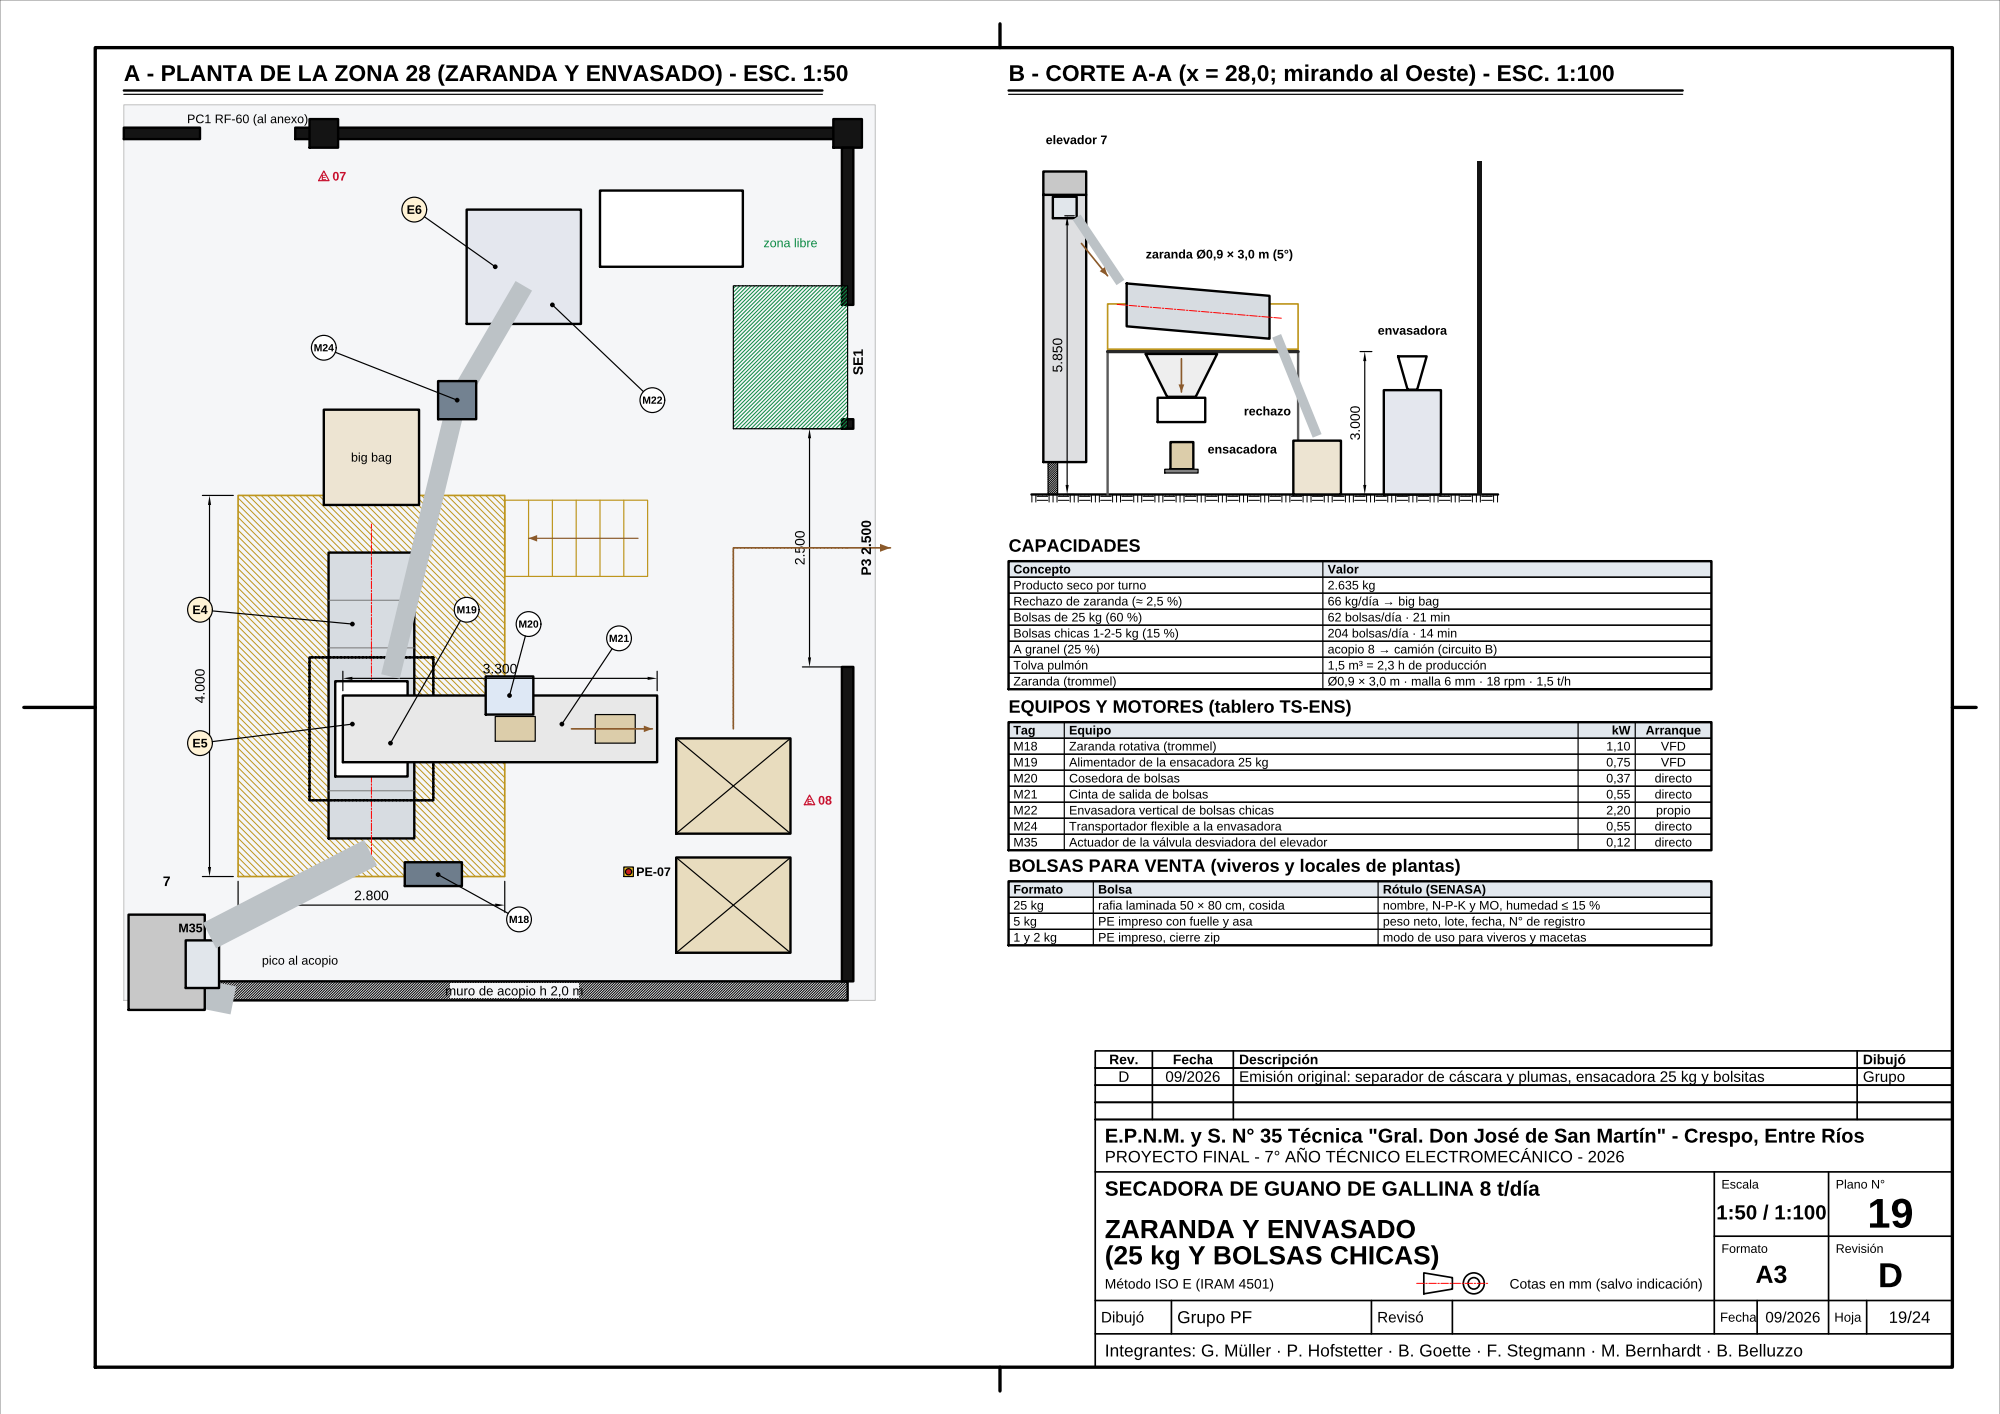
[picture p178: page 1]
