lagzgabrielmuller-dot/planta-secadora-guano/planos/pdf/P20.pdf

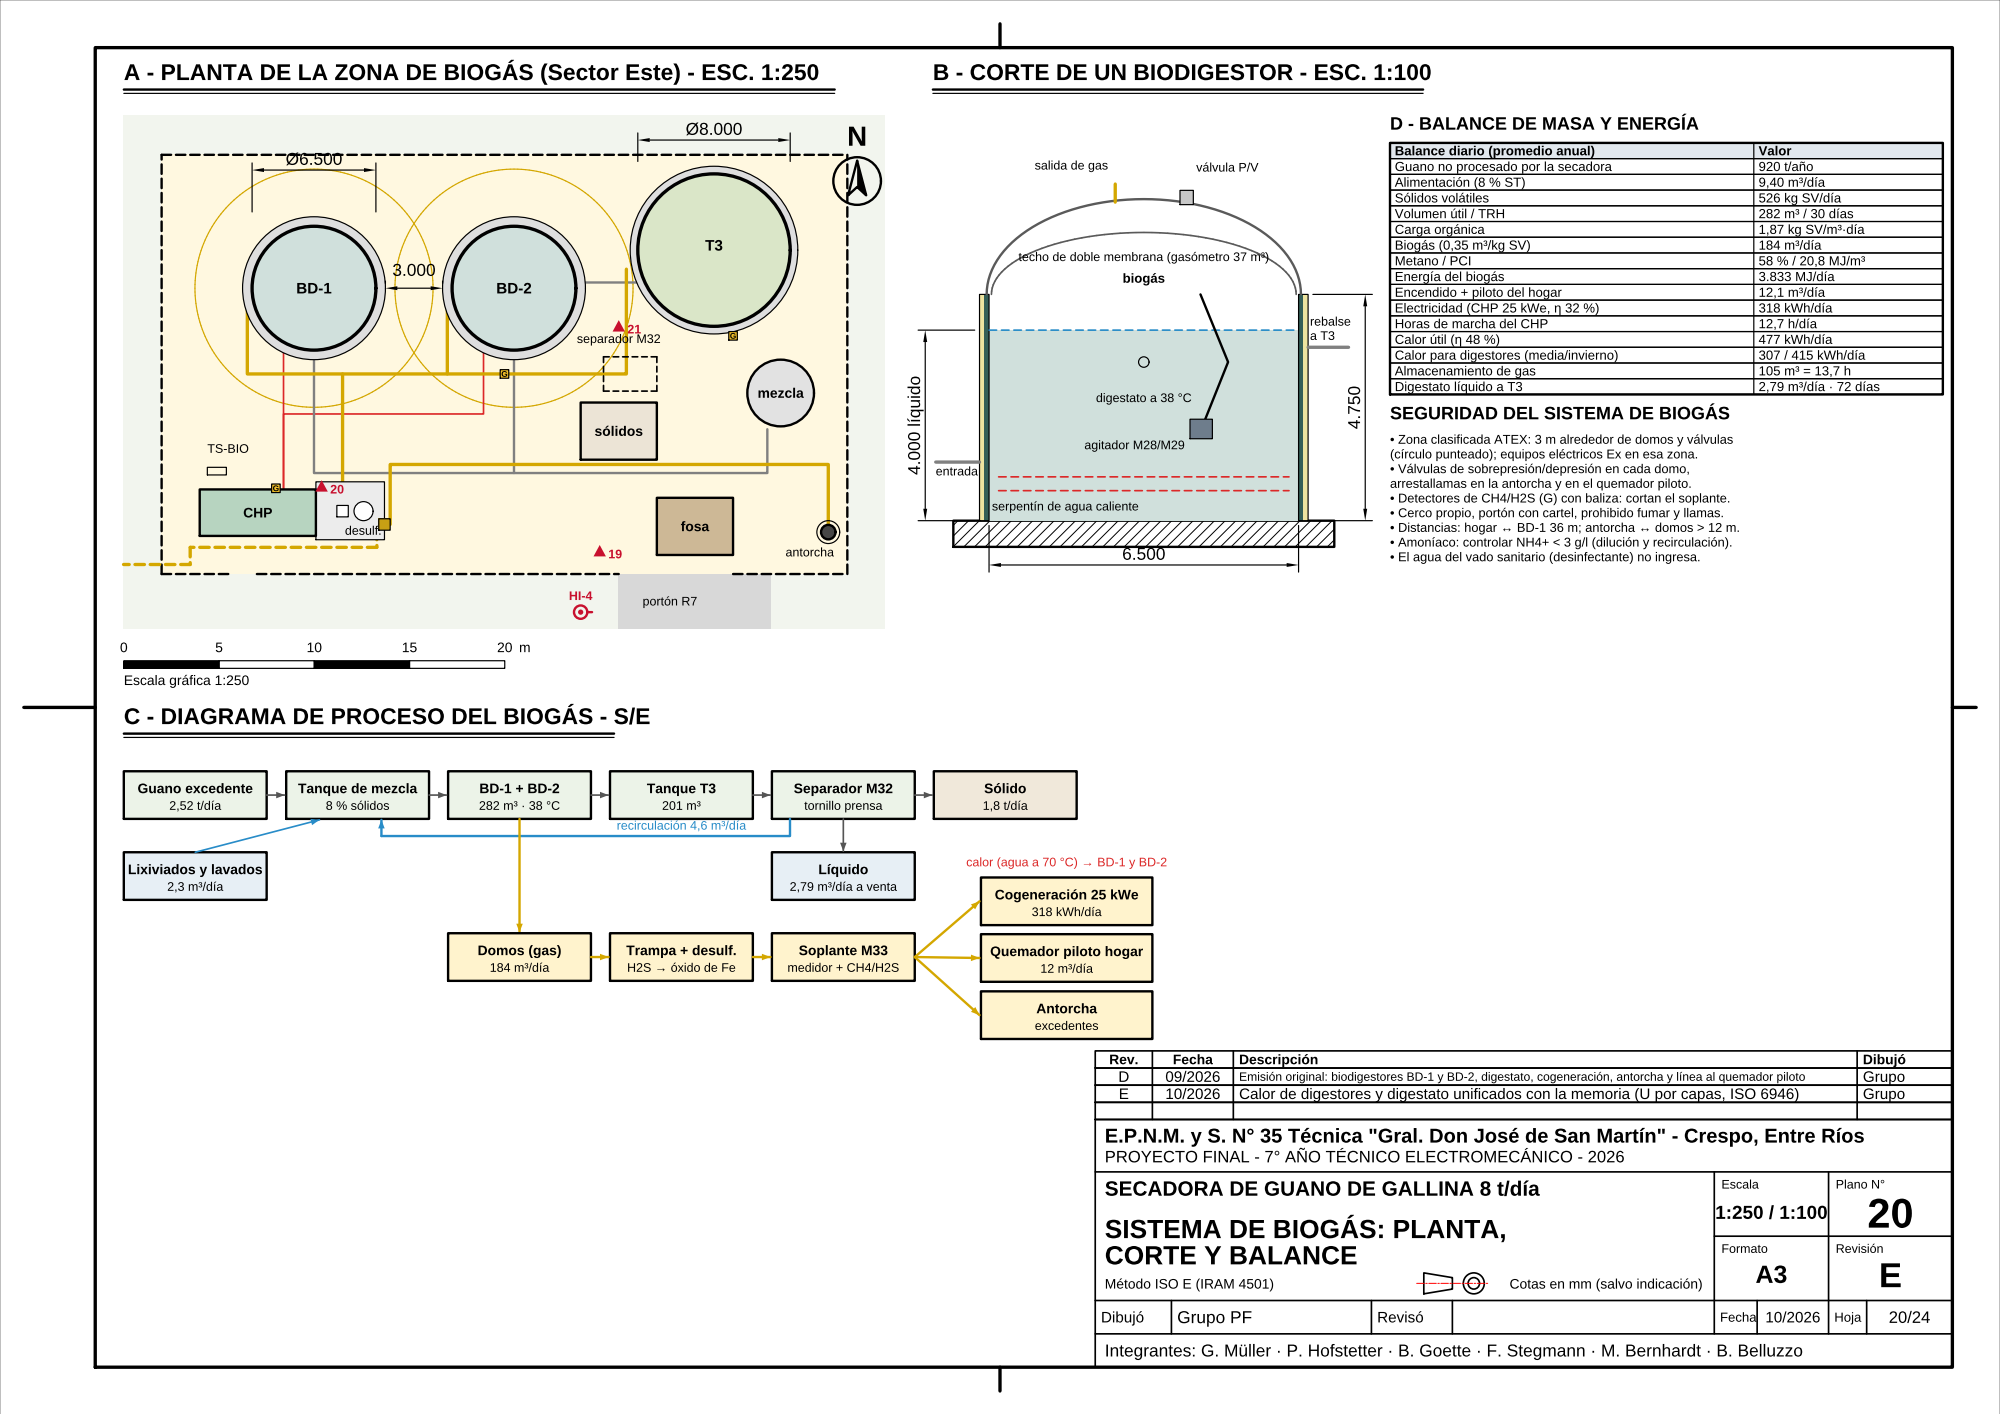
[picture p179: page 1]
