lagzgabrielmuller-dot/planta-secadora-guano/planos/pdf/P21.pdf

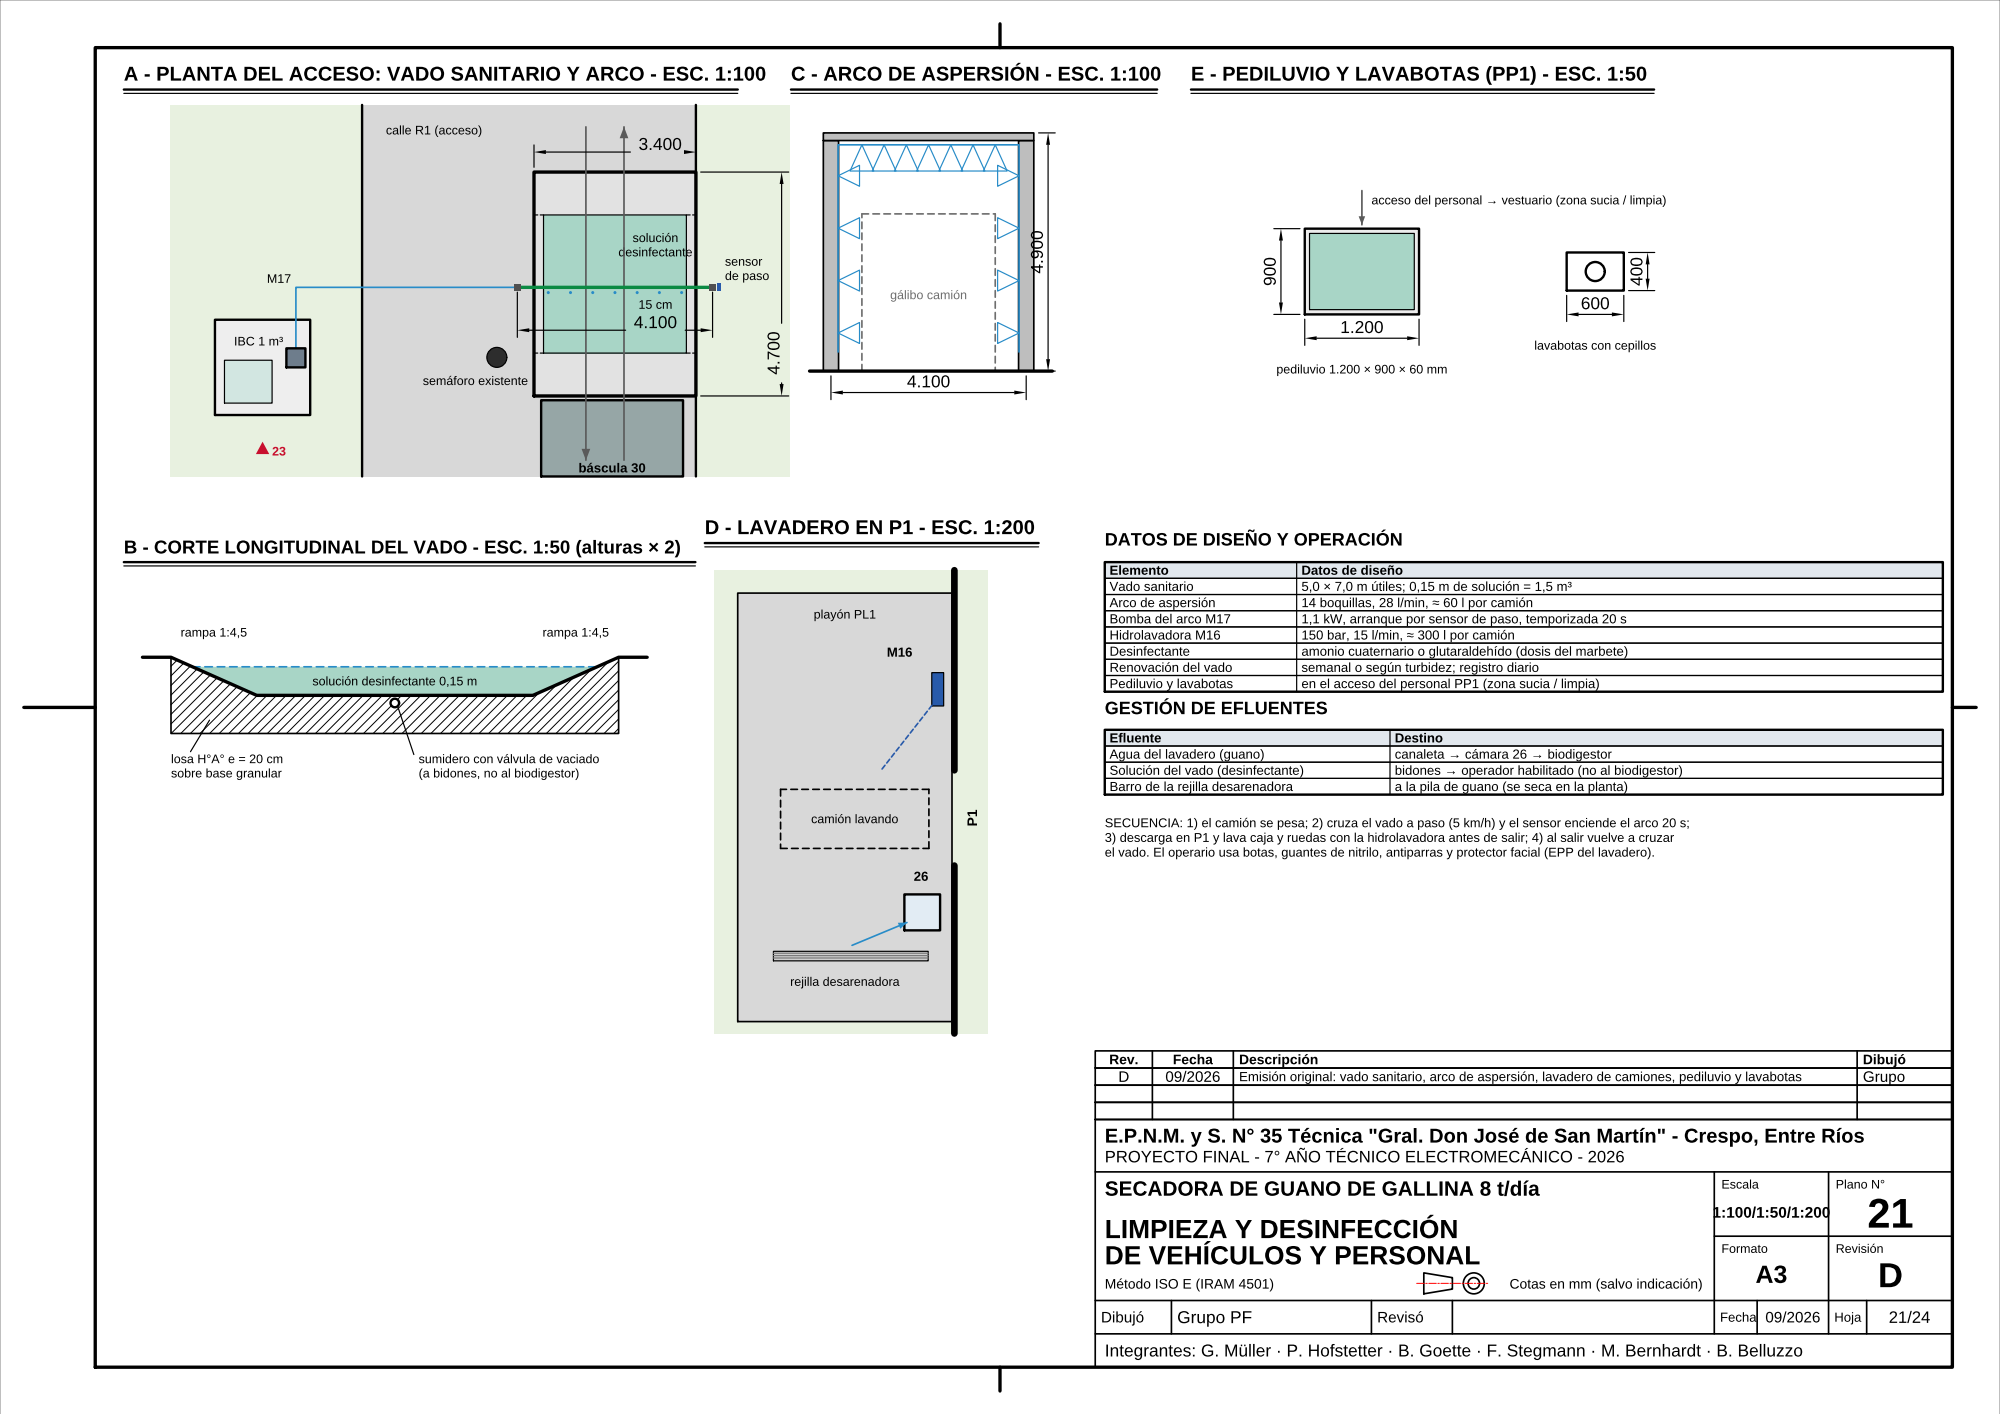
[picture p180: page 1]
