lagzgabrielmuller-dot/planta-secadora-guano/planos/pdf/P22.pdf

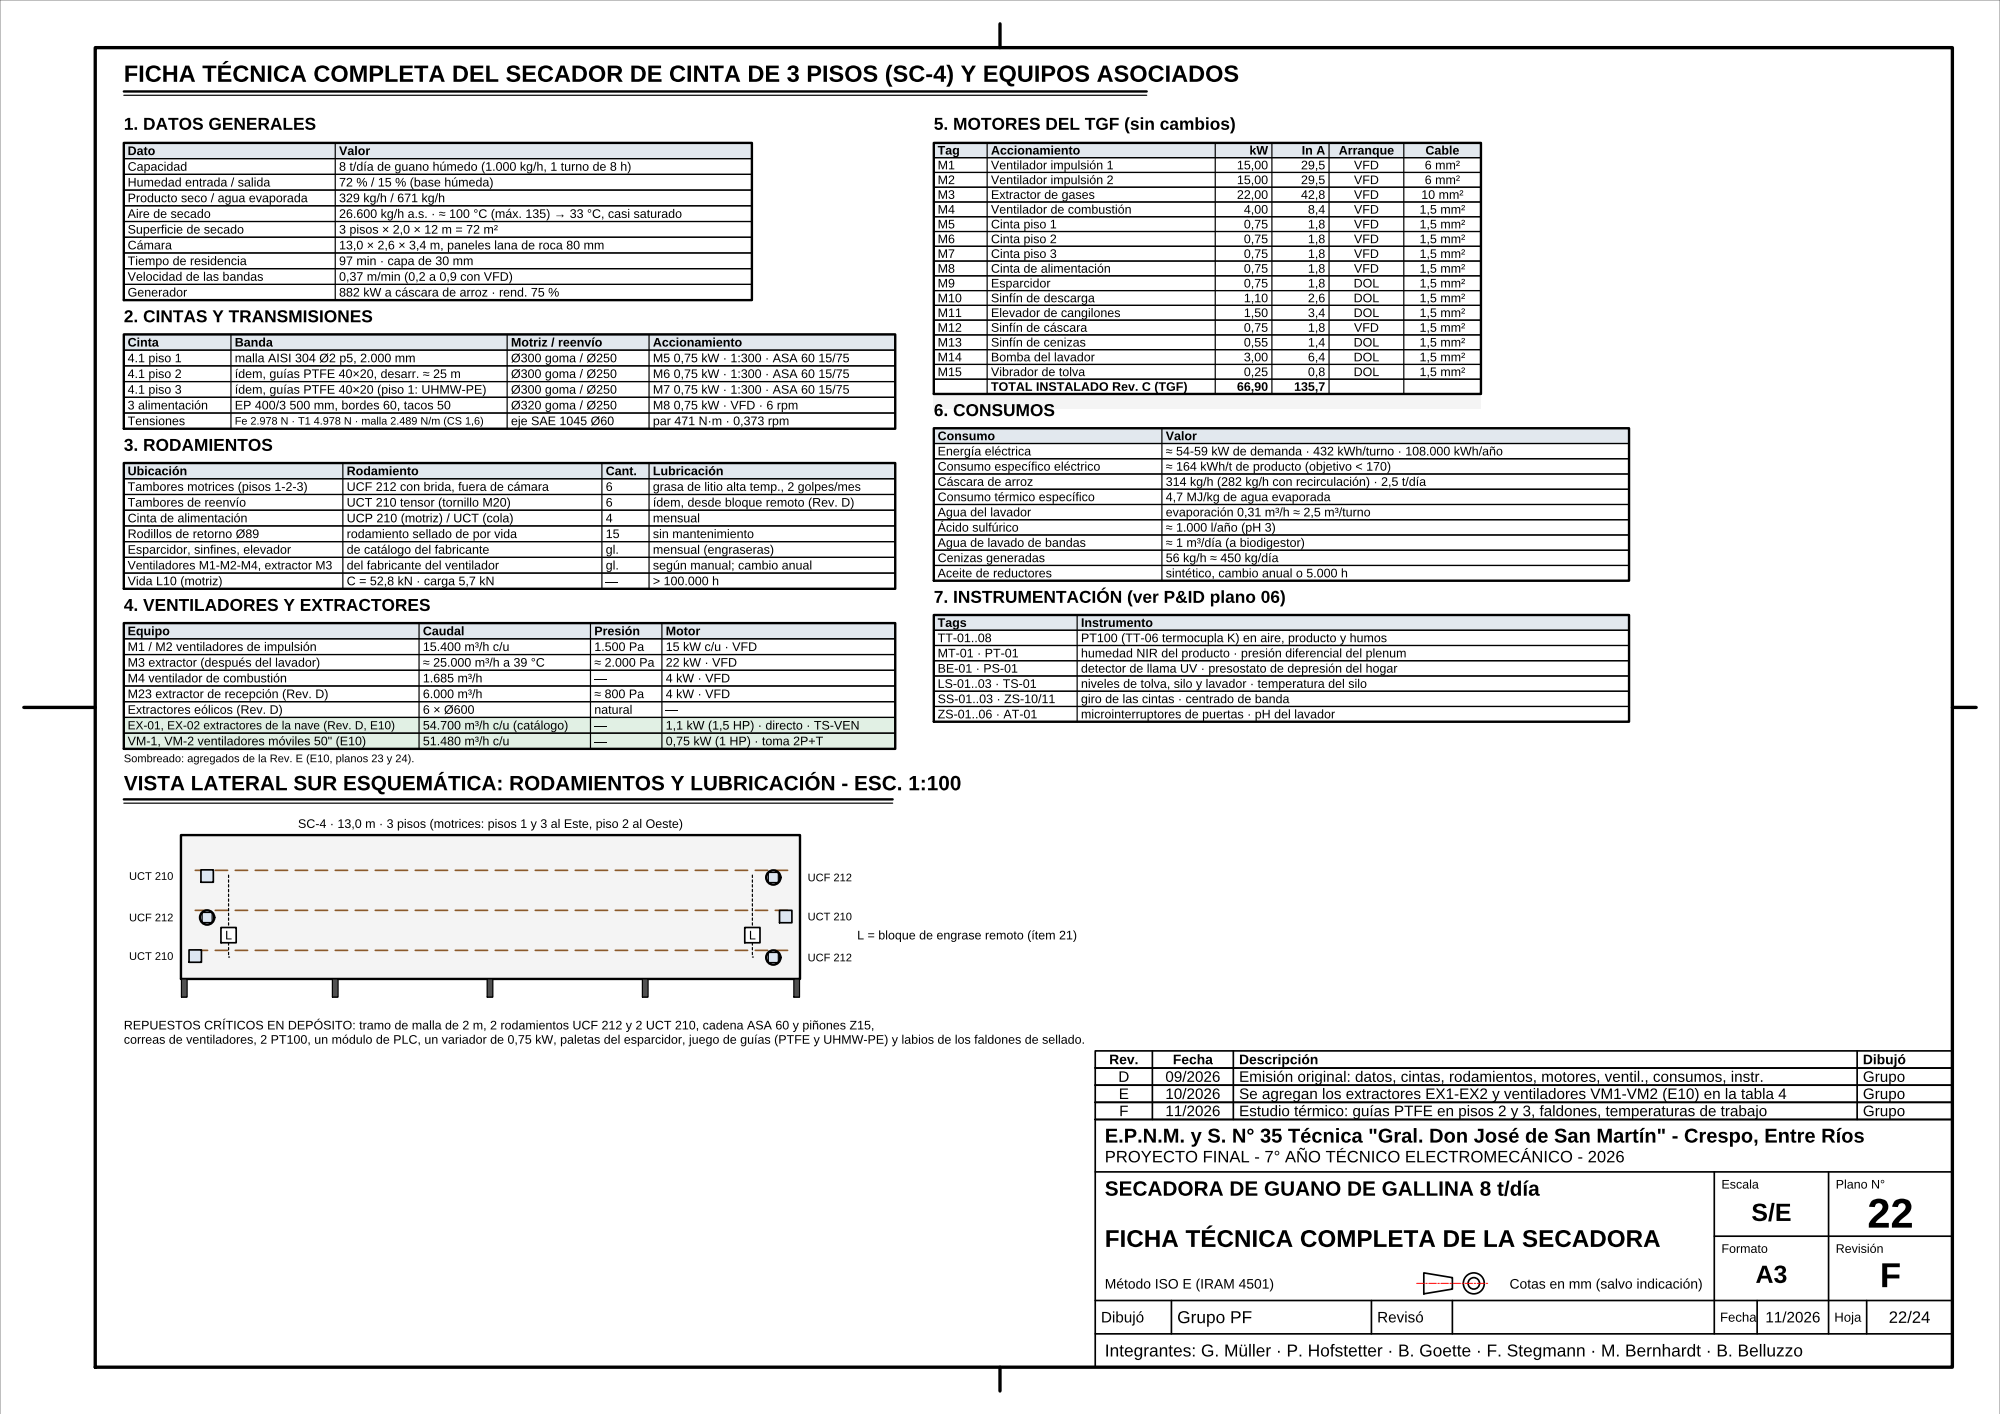
[picture p181: page 1]
