lagzgabrielmuller-dot/planta-secadora-guano/planos/pdf/P23.pdf

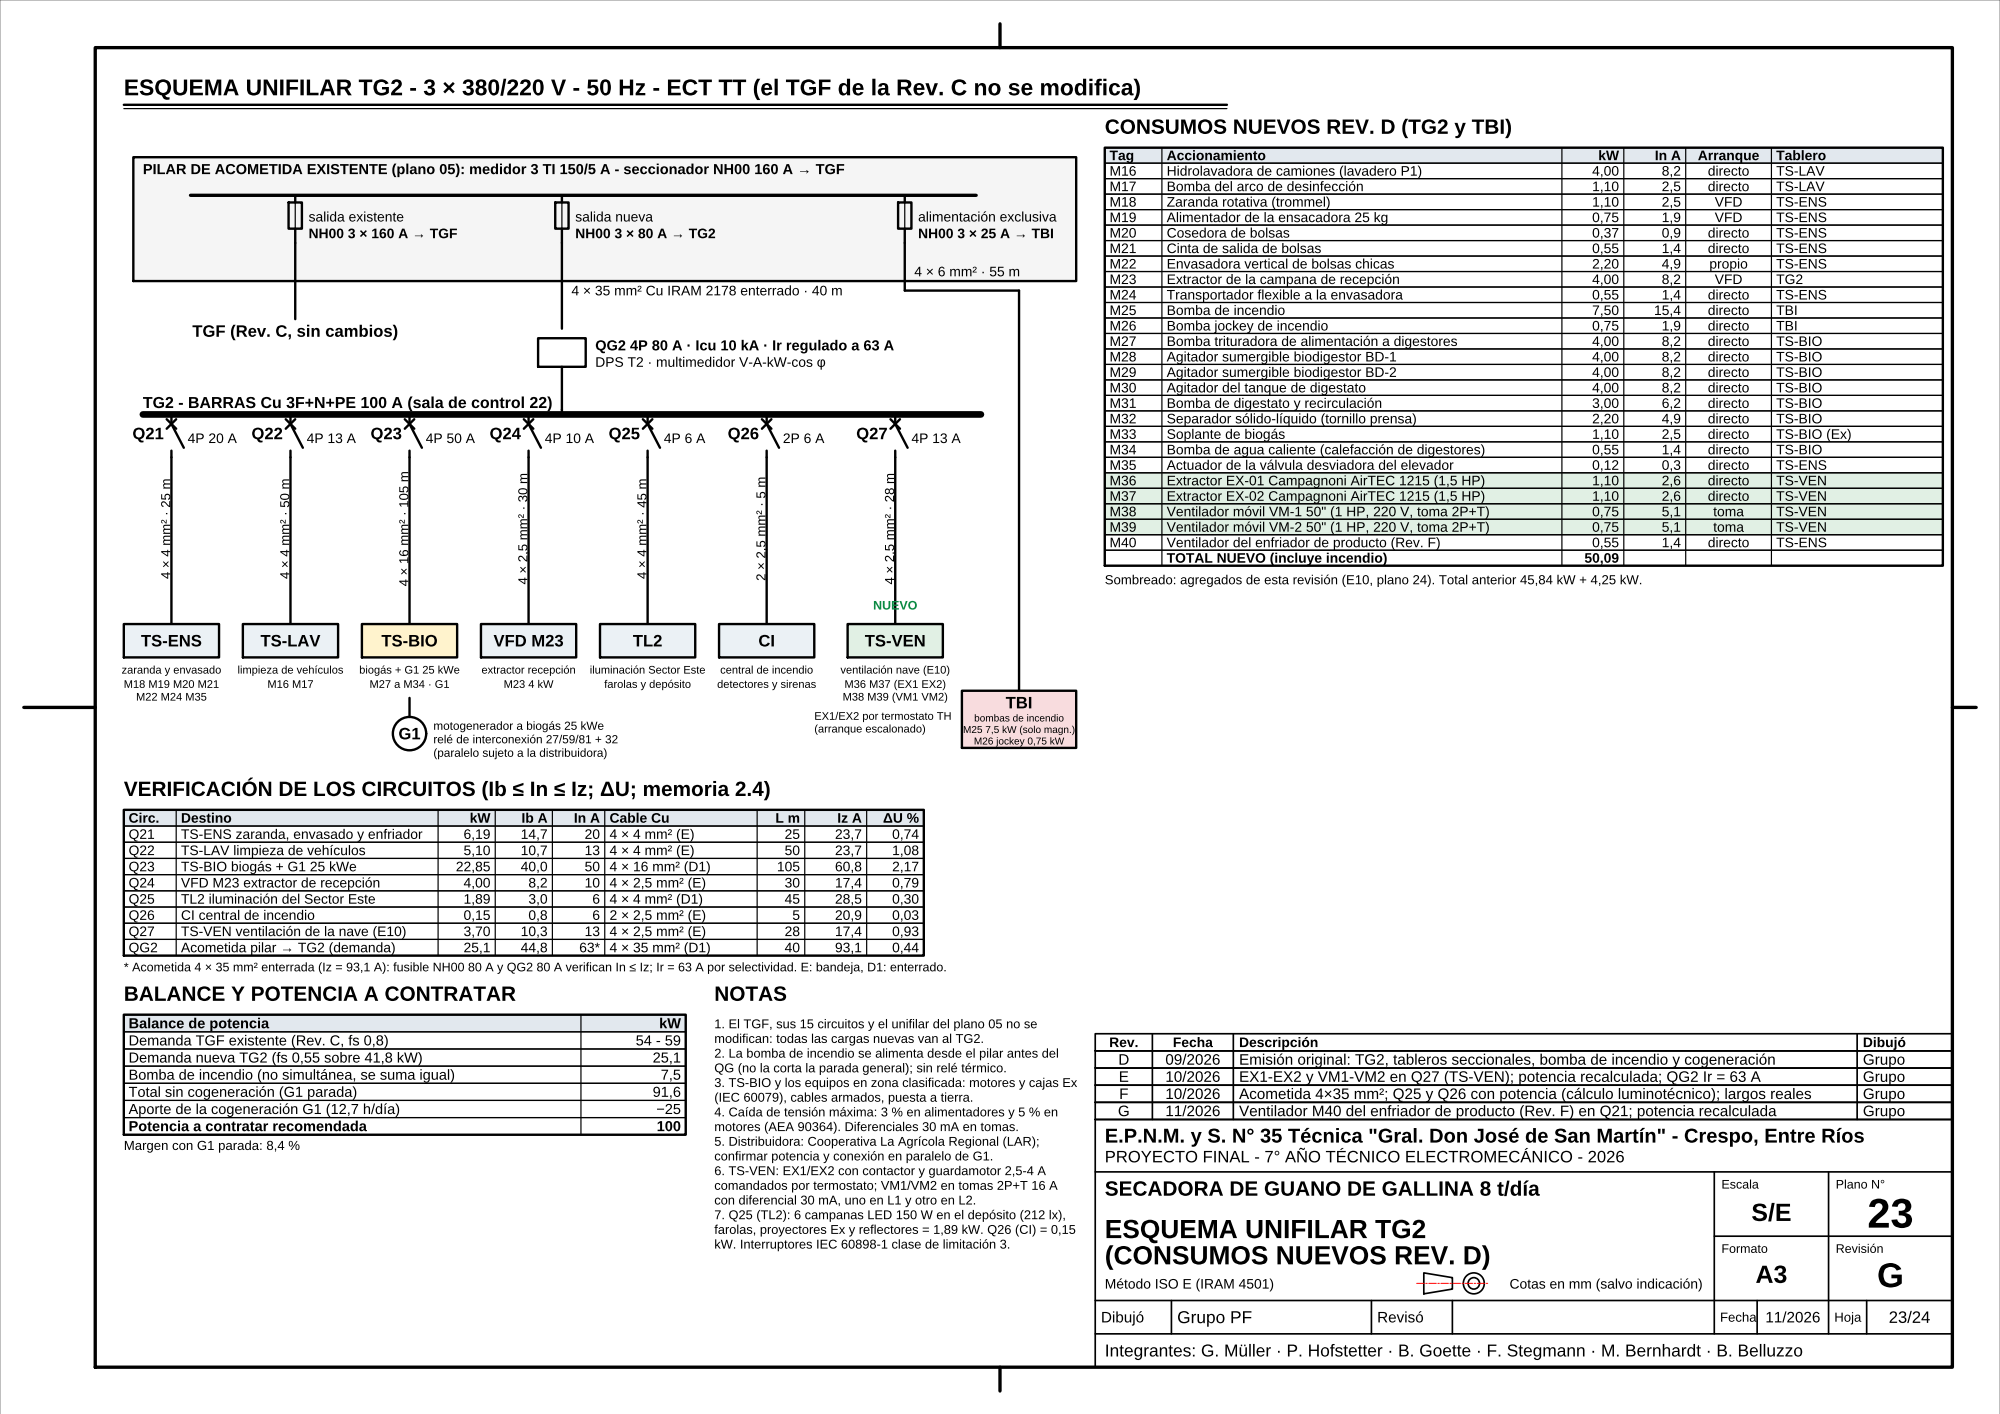
[picture p182: page 1]
