lagzgabrielmuller-dot/planta-secadora-guano/planos/pdf/P24.pdf

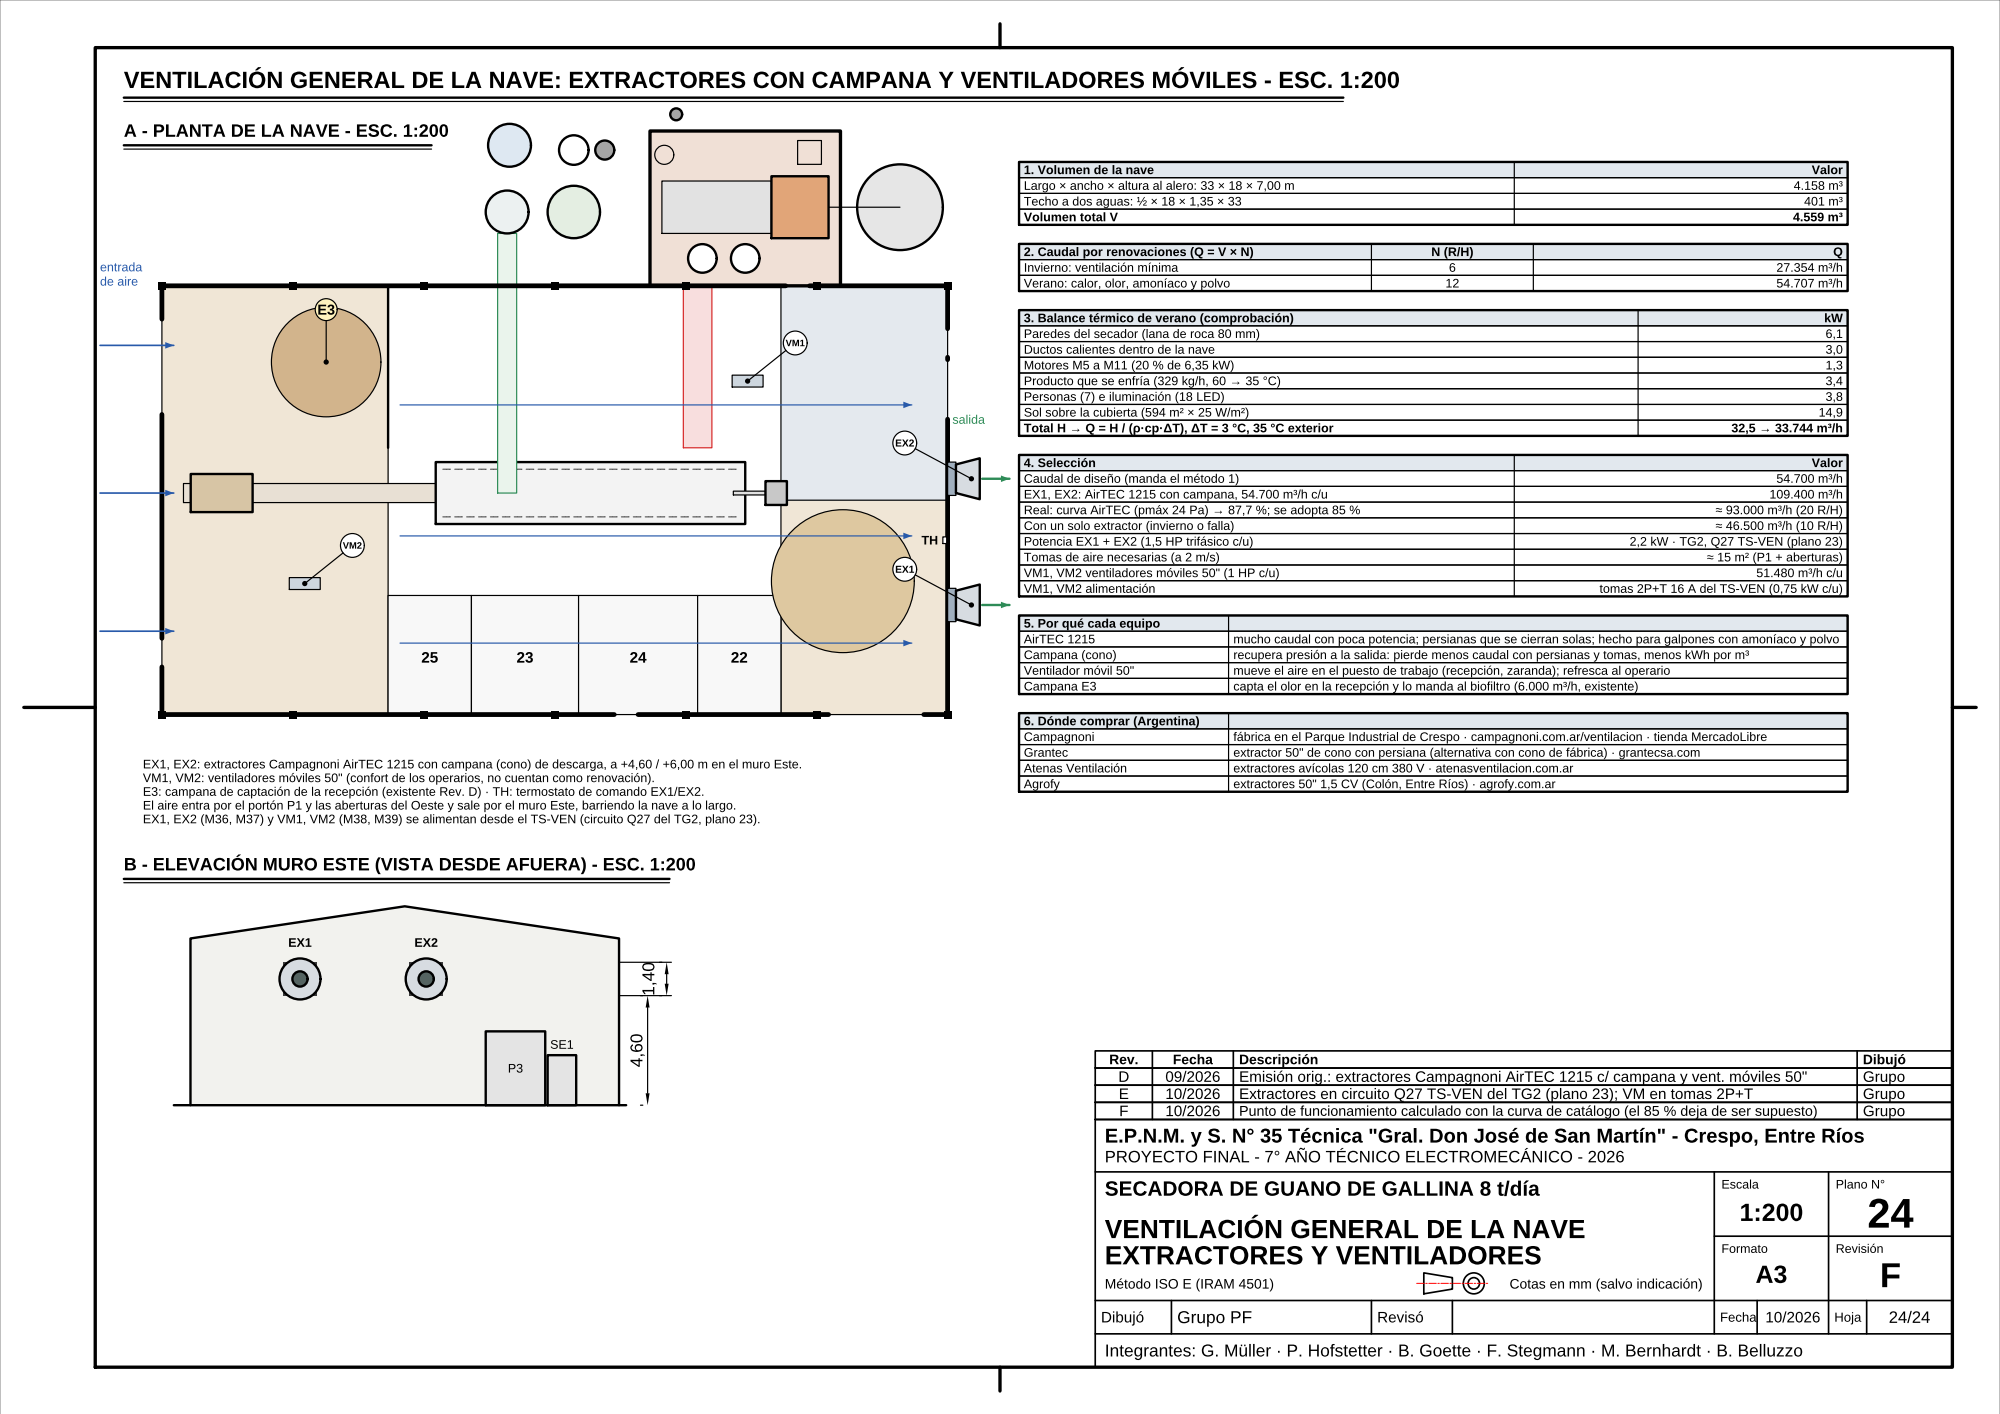
[picture p183: page 1]
