lagzgabrielmuller-dot/planta-secadora-guano/secadora/planos/pdf/Planos_Secador_SC4.pdf

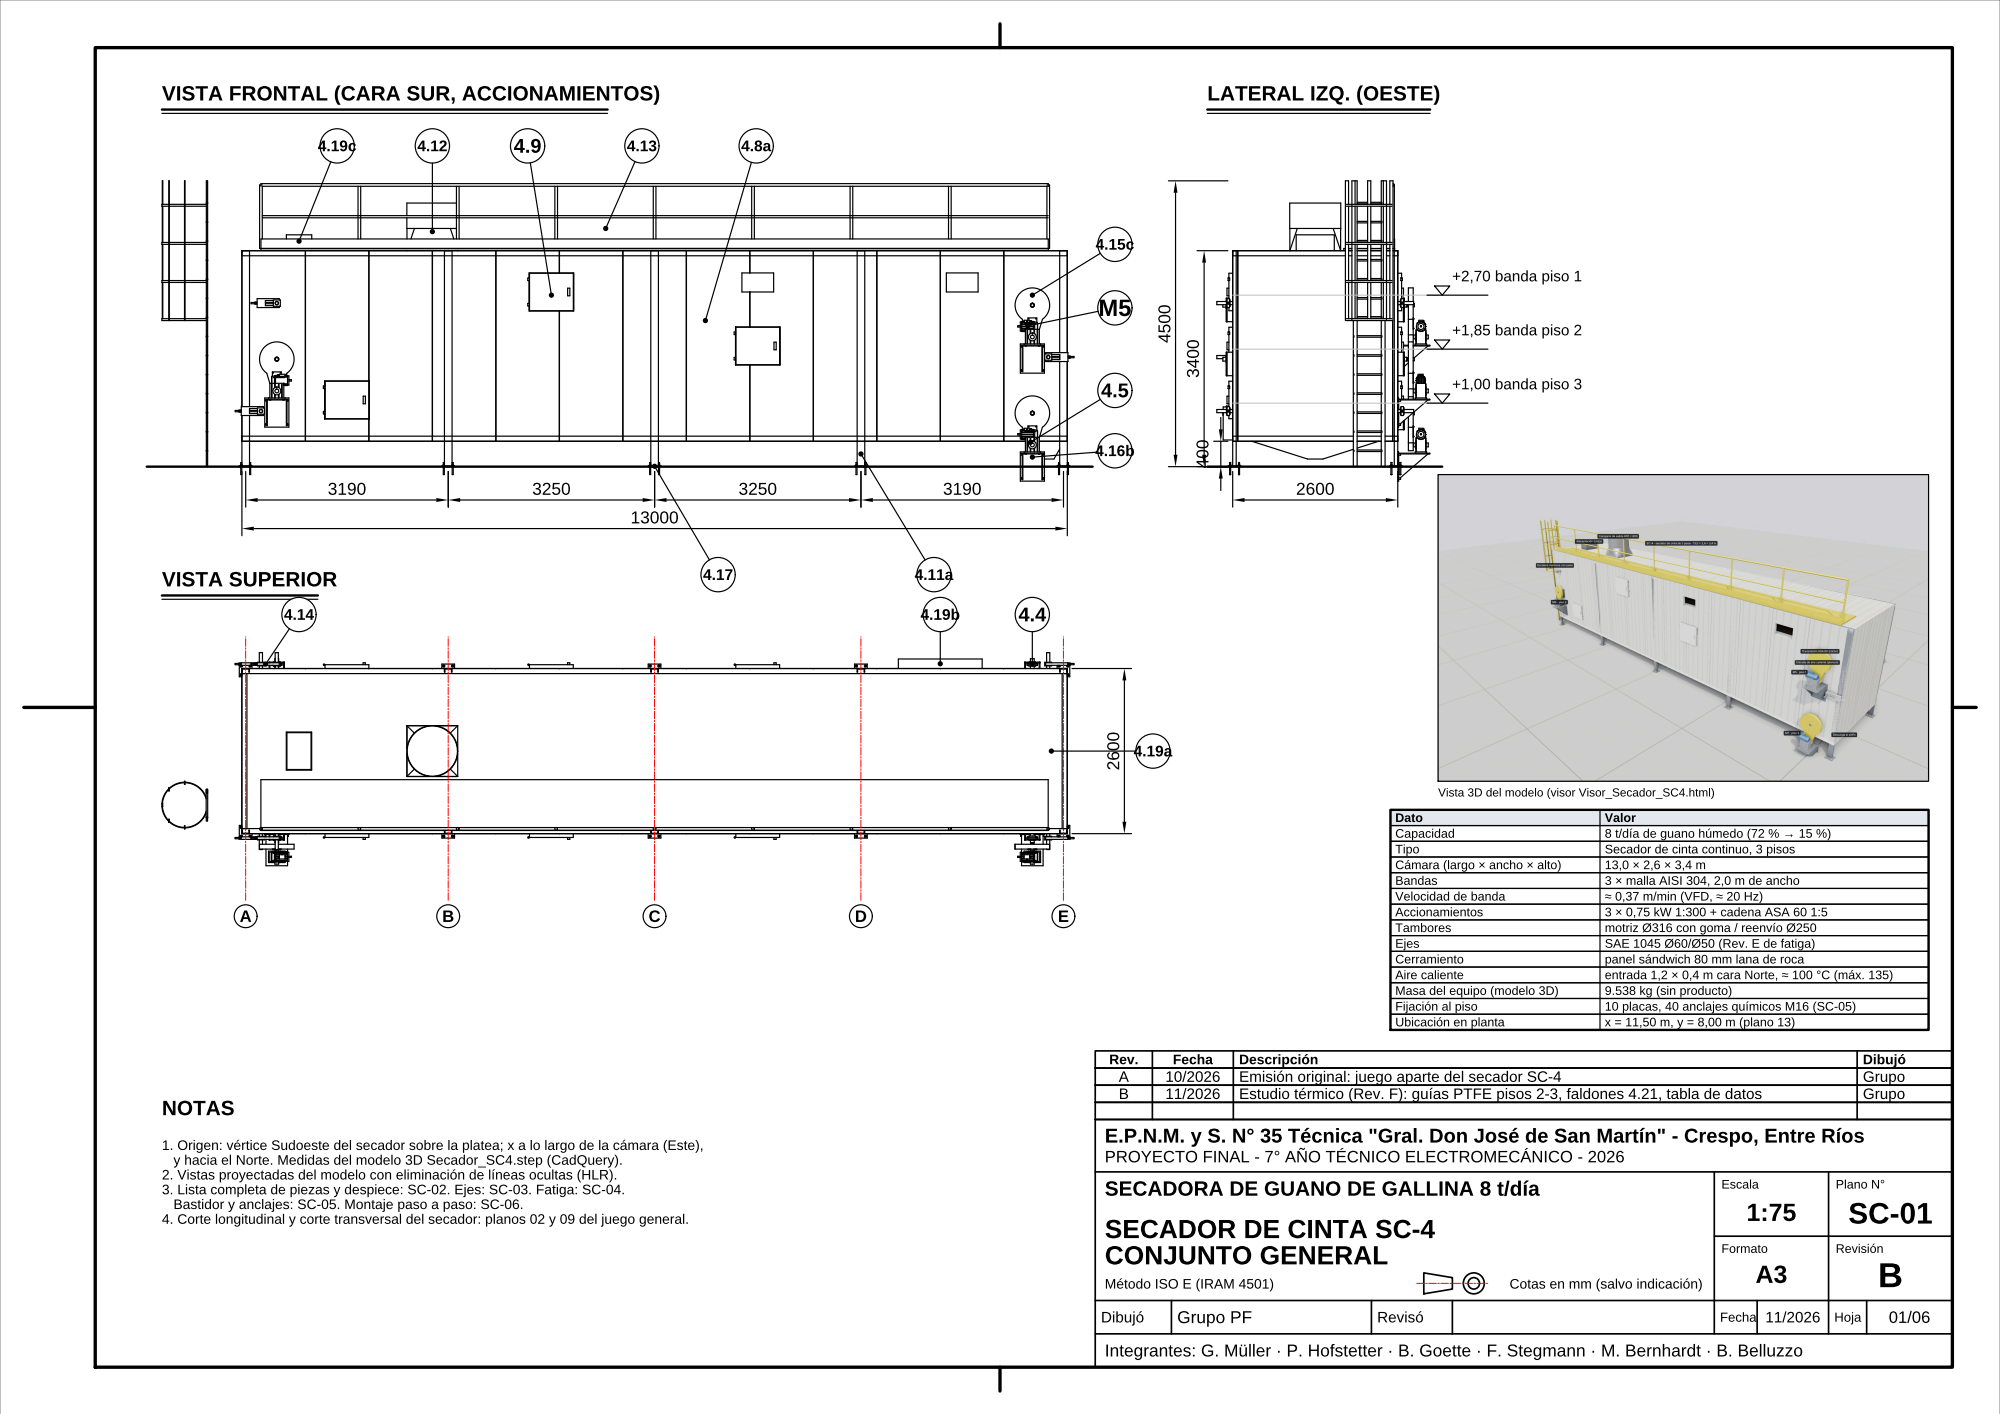
[picture p184: page 1]

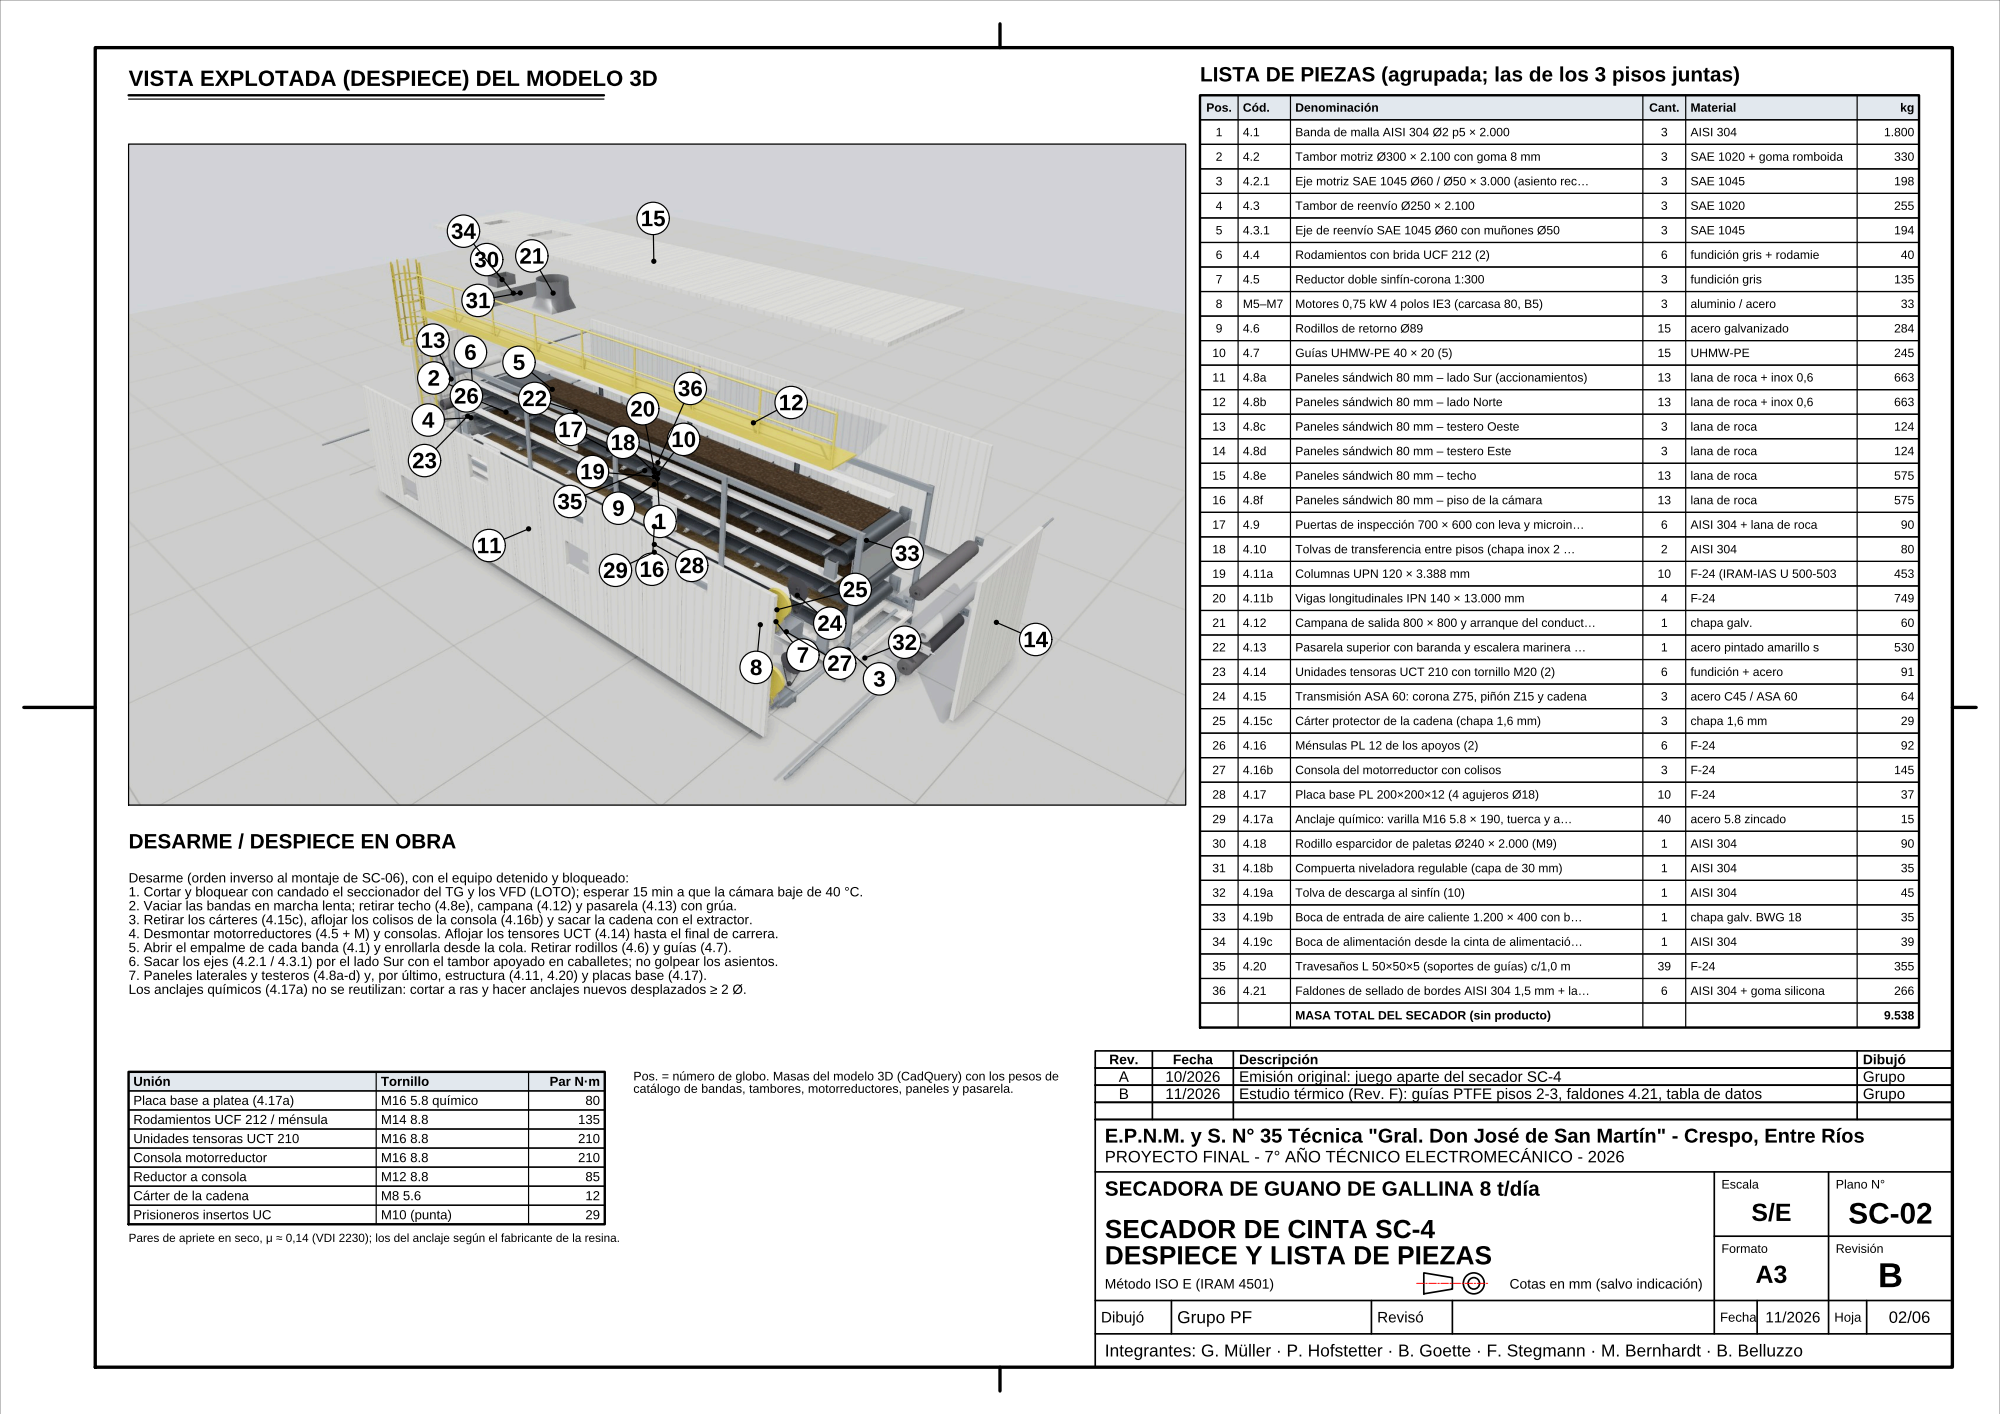
[picture p185: page 2]

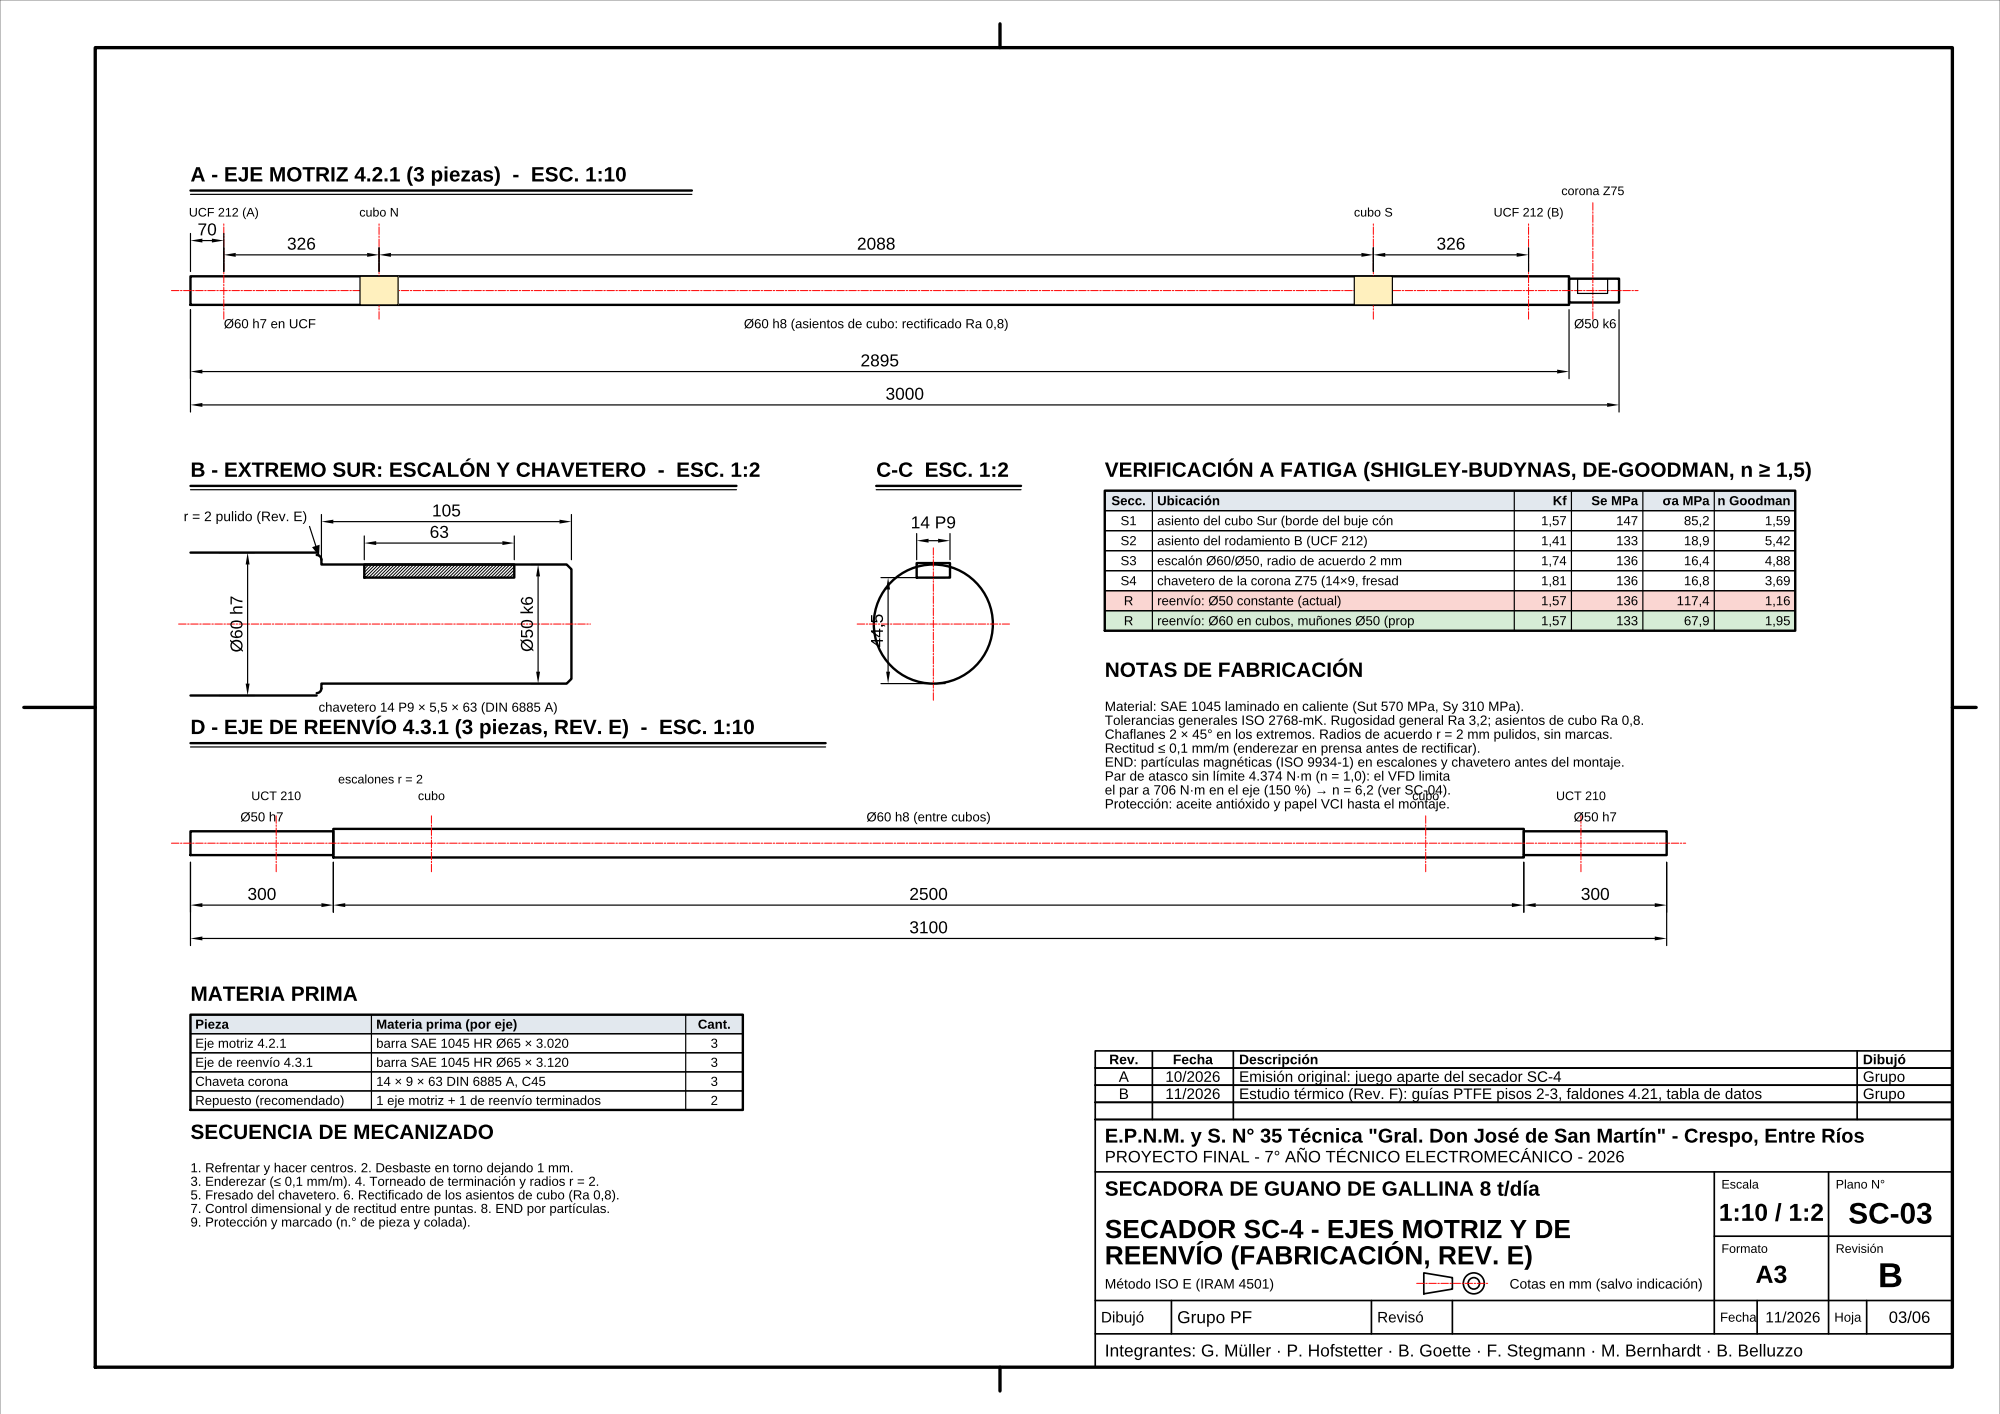
[picture p186: page 3]

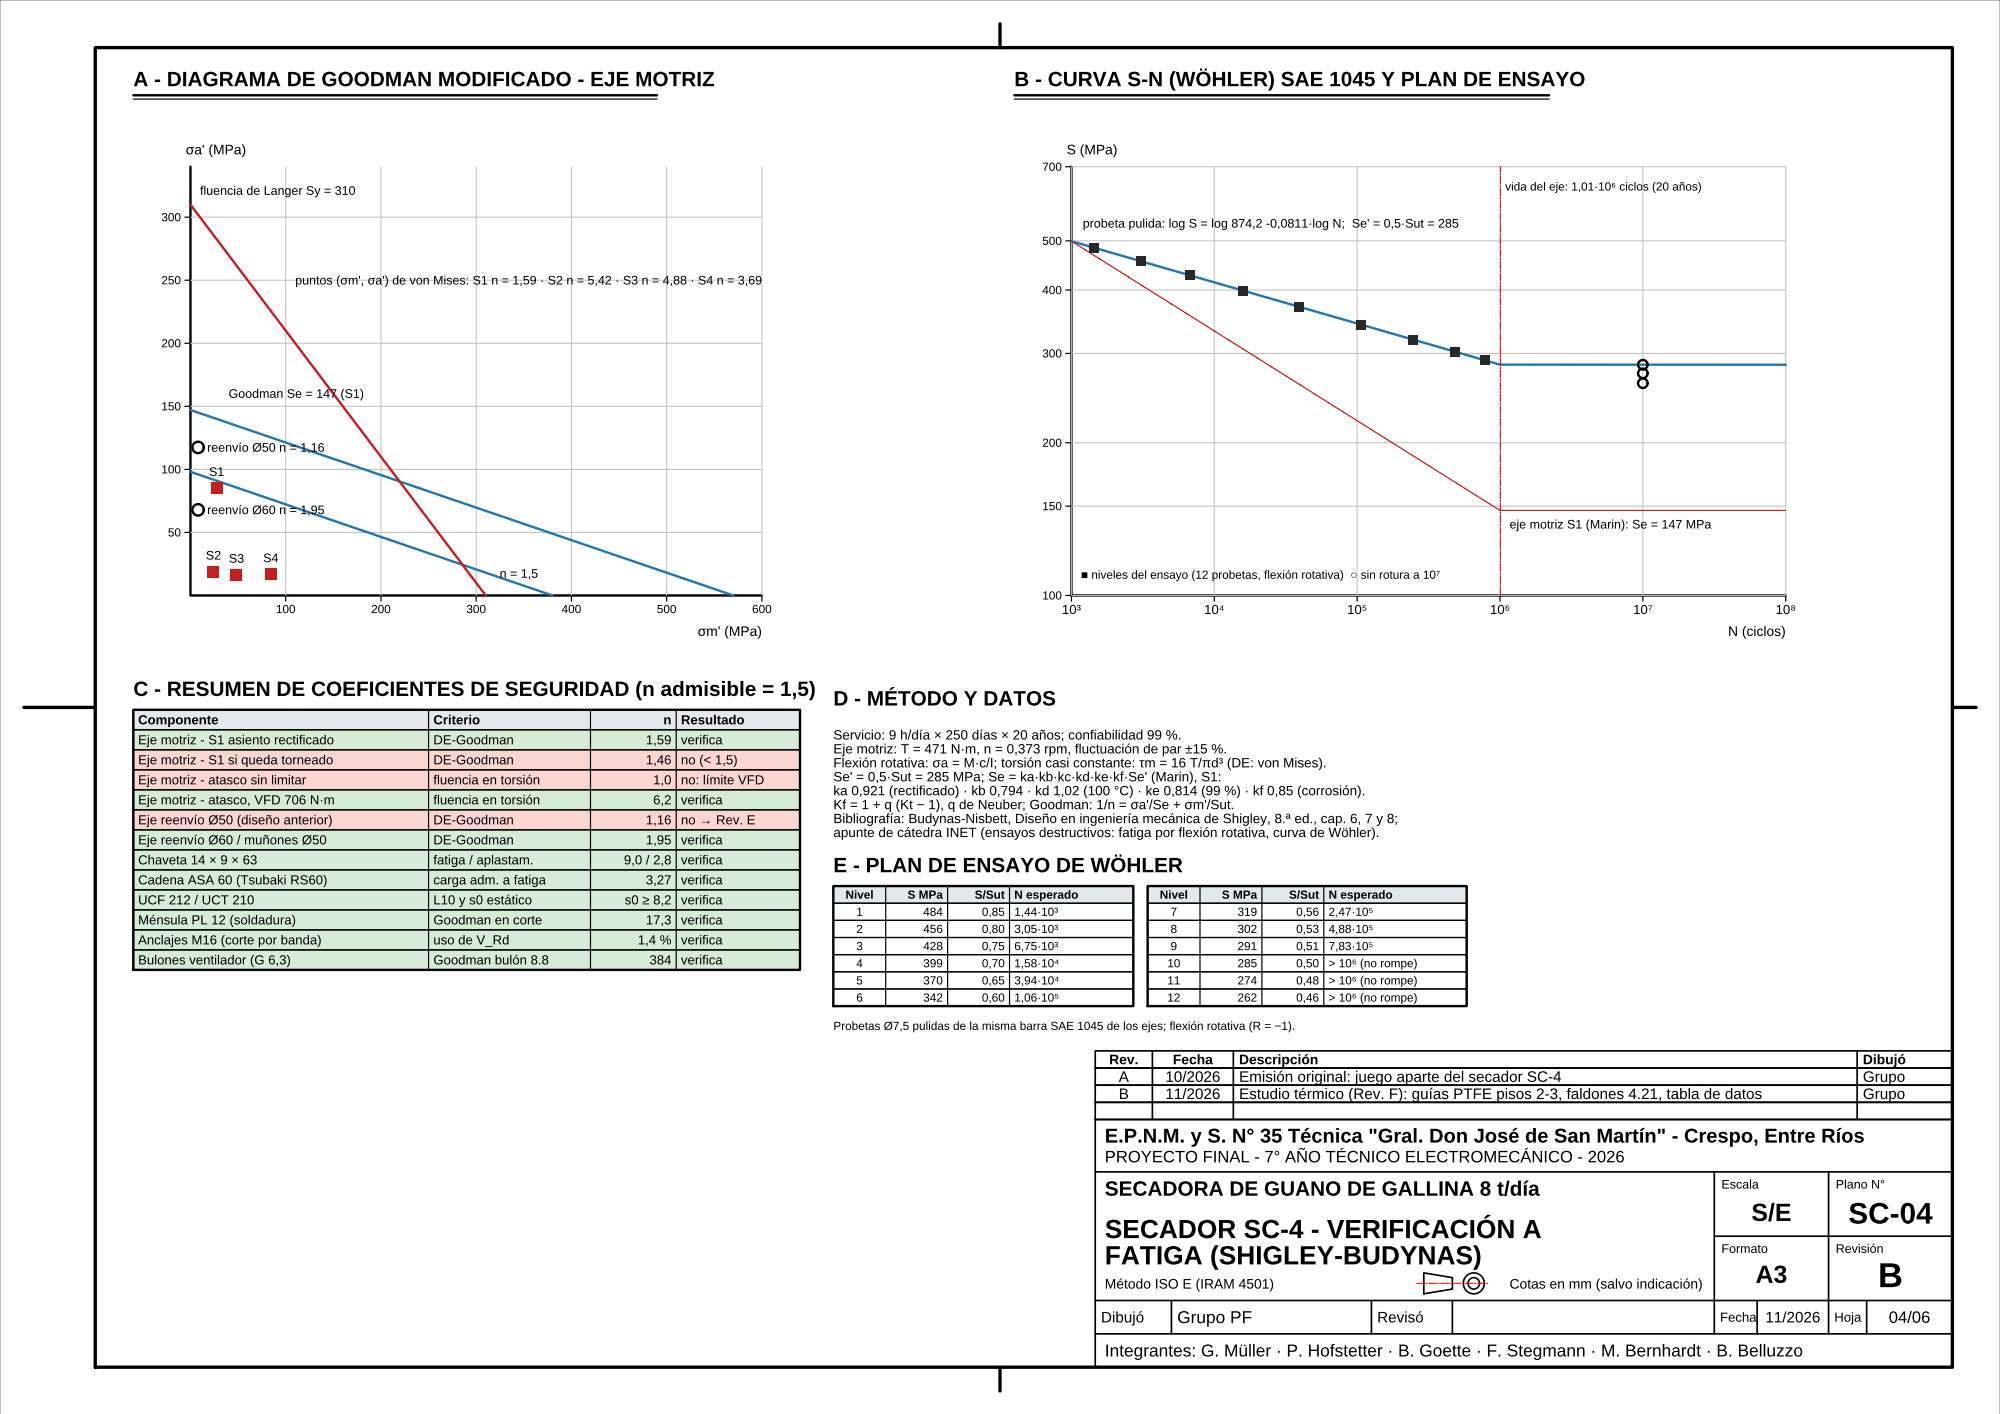
[picture p187: page 4]

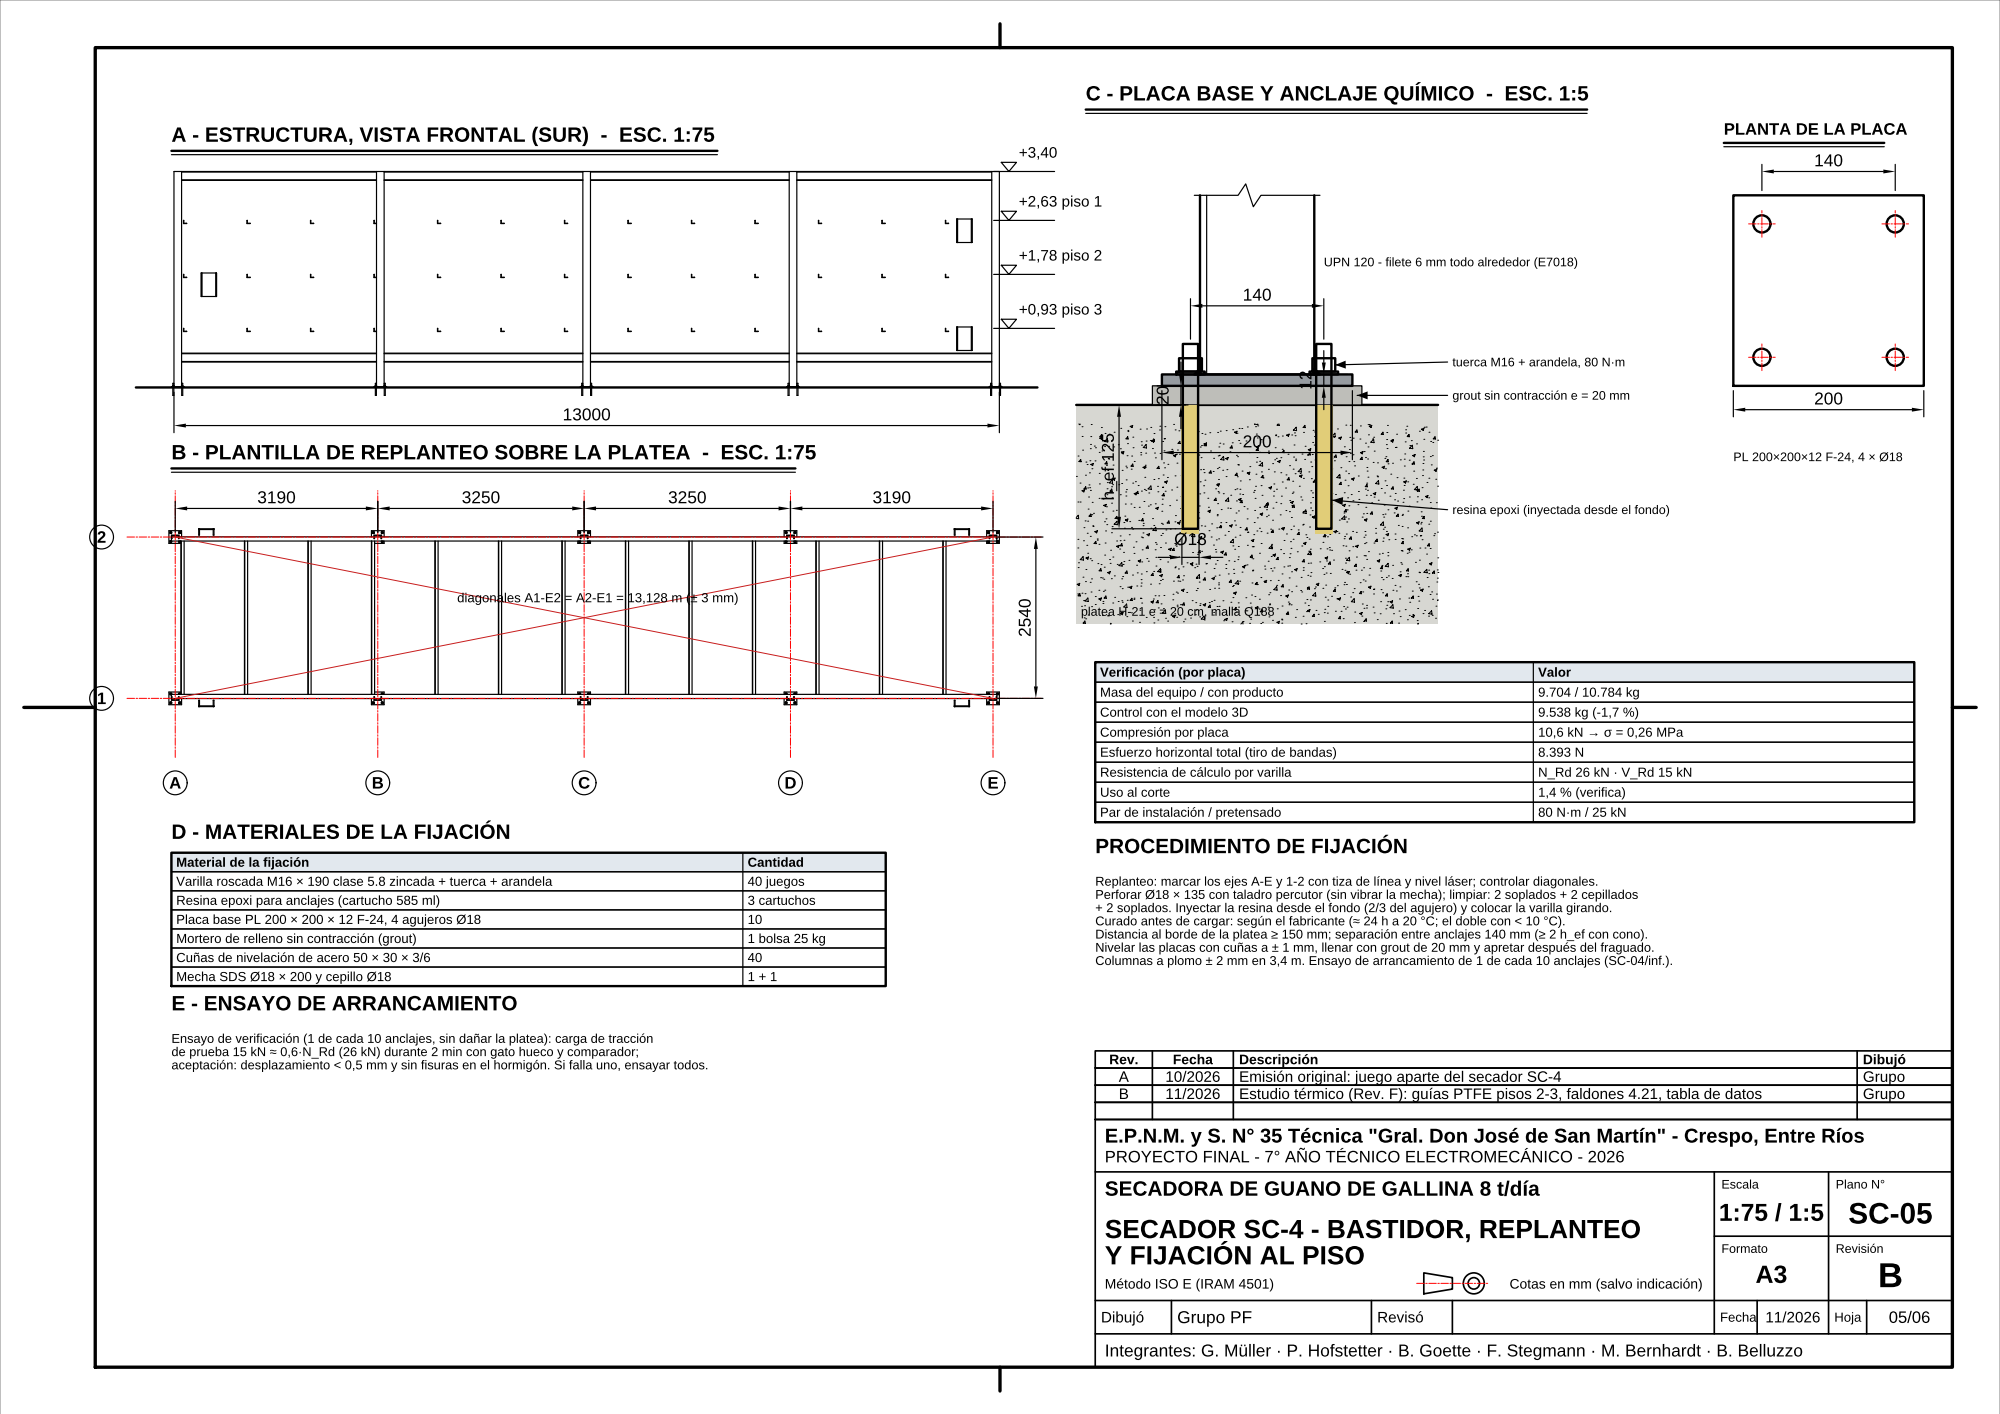
[picture p188: page 5]

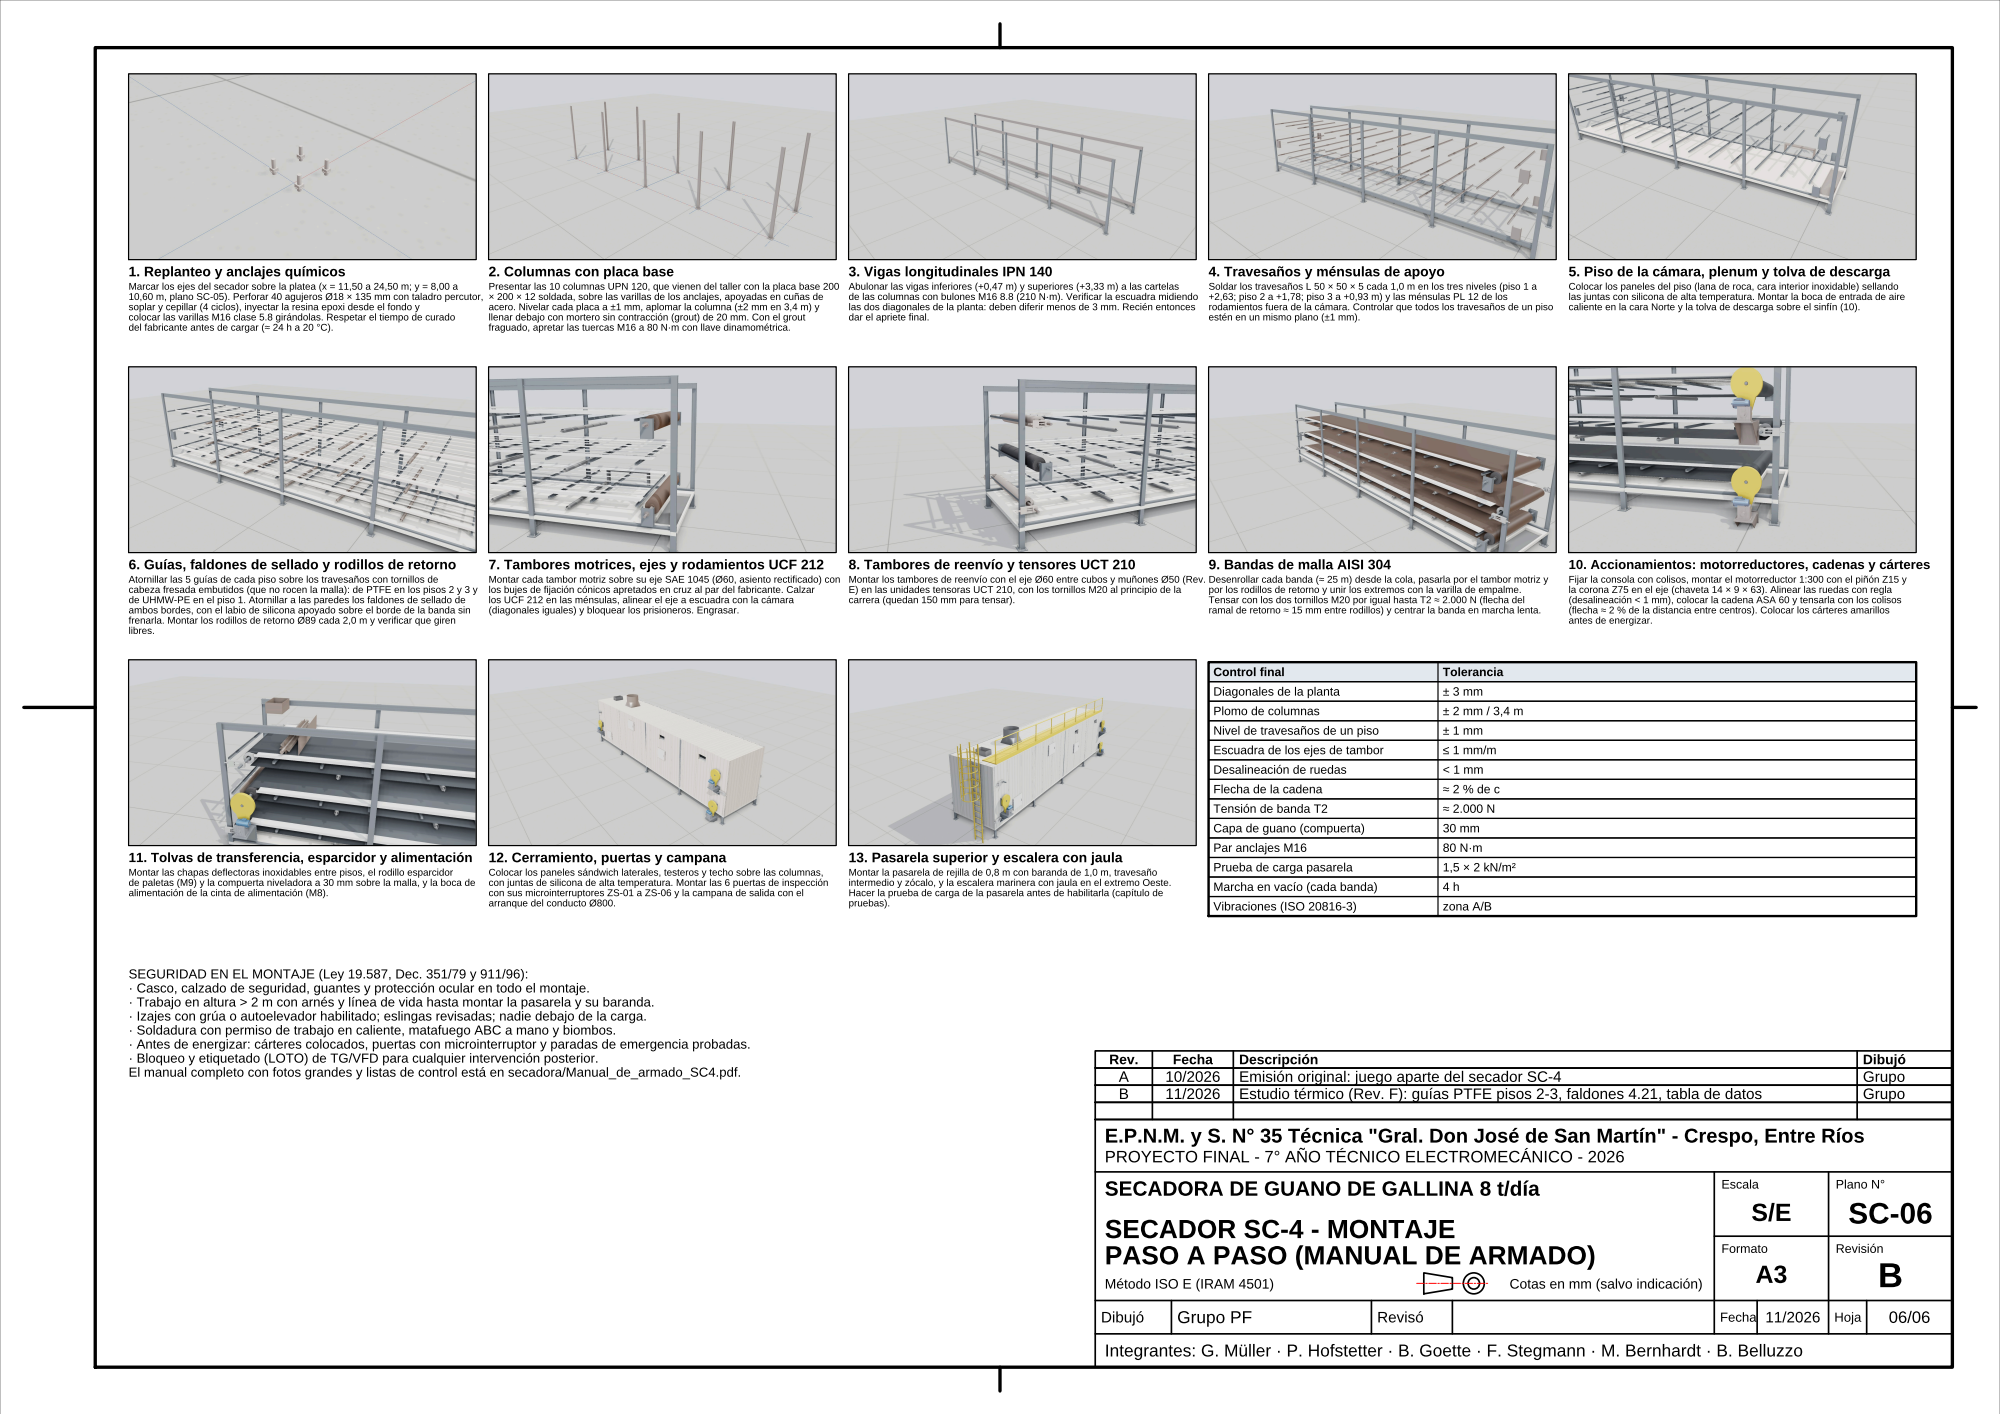
[picture p189: page 6]
