lagzgabrielmuller-dot/planta-secadora-guano/(commit log)

2026-11-11 Entrega final del proyecto con la Rev. F y auditoría integral
    Repositorio nuevo e independiente de la planta secadora de guano de gallina
    (8 t/día, Crespo): planos, informe, memoria, presupuesto, modelos 3D, visores,
    estudio térmico, portada pública y video sin música.
    - Rev. F: cambios del estudio térmico del secador SC-4 (lazo de humedad en
    cascada, guías PTFE, faldones de sellado, escape aislado, CD-03 por HR,
    tolva de retención y enfriador, capacidad 1.440 kg/h).
    - Coherencia: alimentación por cinta M8 en el informe, TGF 66,9 kW, curva de
    secado, recirculación del plano 18, biogás vecino como proyecto.
    - Apellido Hofstetter corregido en las 30 láminas y en todos los do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
    [P01.dxf, P02.dxf, P03.dxf, P04.dxf, P05.dxf, P06.dxf, P07.dxf, P08.dxf]
2026-11-11 Portada: revisión vigente de cada lámina leída de su programa
    Los epígrafes de la galería de planos toman la letra de la última fila de la
    tabla revs de cada lámina (P02 E, P06 E, P18 E, P22 F, P23 G, SC B).
    Claude-Session: https://claude.ai/code/session_01TErNk2DNrkm8BtBmb1esdg
2026-11-11 Video corregido, vistas nuevas del secador y lámina SC-01 al día
    - Video: cinco tramos dibujados de nuevo sobre el original de máxima
    calidad (créditos con Hofstetter, nave 33 × 18 m, secador 9.538 kg,
    117,0 kW). Versiones públicas sin audio; montar.py convierte a rango
    de color de TV, como el original.
    - Visor del secador: los rótulos que se pisan se separan solos. Vistas,
    despiece y 13 pasos de montaje sacados de nuevo con GTAO; láminas SC,
    informe, manual y portada regenerados.
    - SC-01: humedad de entrada 72 % y aire ≈ 100 °C (máx. 135), como el
    resto del proyecto.
    - CI: la prueba del sitio ya no depende de apt (en la primera corrida
    los espejos de Ubuntu no reso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
    [SC-01.dxf, SC-02.dxf, SC-03.dxf, SC-04.dxf, SC-05.dxf, SC-06.dxf]
2026-11-11 Auditoría: resultados de la CI y de la prueba del sitio publicado
    Las dos corridas de la prueba contra GitHub Pages (24 de 24) y la CI en verde
    en la segunda corrida. Pendiente de la Rev. F: sumar al STEP de la planta la
    tolva de retención, el enfriador y el elevador prolongado.
    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
2026-11-11 Portada: enlace al simulador térmico
    La portada no enlazaba simulacion_termica/simulador.html: estaba publicado
    pero solo se llegaba escribiendo la dirección. Ahora aparece en Descargas y
    en la página del secador. Prueba nueva: la portada tiene que enlazar los
    dos visores y el simulador (falla sin este cambio). Auditoría: problema 26.
    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
